lsk0522/microduck/cad/plates/DESIGN_BRIEF.md

# 판재(알루미늄) 부품 설계 브리프 — 트랙 A (다이나믹셀, 원본 크기)

> 설계 대화가 Fusion에서 판재 4종을 **제작 가능한 파라메트릭 부품**으로 다시 만들기 위한 기준.
> 원본 Pollen MJCF(`cad/reference/microduck/robot_allcollisions.xml`)에서 측정 (2026-10-29, 계획 대화).
> 좌표: 몸통 원점(trunk_base), X 앞 / Y 왼쪽 / Z 위, 단위 mm, 모든 관절각 0 자세.

## 0. 한 줄 요약

| 부품 | 수량 | 두께 | 외형 (mm) | 위치·방향 | 큰 구멍 Ø19가 지나는 관절 축 | 작은 구멍 |
|---|---|---|---|---|---|---|
| `upper_leg_rigidity_plate` | 2 | 1.0 | 58.1 × 45.0 | 허벅지 **바깥 옆면**, Y = ±43 (판 법선 Y) | `hip_pitch`, `knee` (축간 **42.0**) | Ø2.2 ×4 |
| `trunk_base` | 1 | 1.0 | 57.0 × 36.0 | 몸통 **바닥판**, Z ≈ −0.7 (판 법선 Z) | 좌·우 `hip_yaw` (축간 **35.0**) | Ø2.3 ×4 |
| `bearing_roll` | 2 | 1.0 | 40.0 × 23.0 | 고관절 **앞면 수직판**, X ≈ 18 (판 법선 X) | `hip_roll` | Ø2.2 ×4 |
| `neck` | 2 | 2.0 | 20.0 × 11.0 | 목 **양 옆판**, Y = ±12.5 (판 법선 Y) | 없음 | Ø2.3 ×4 (16 × 5 격자) |

- Ø19 구멍은 모두 **관절 회전축과 동심**이다 (오차 < 0.1 mm). 서보 혼·베어링 허브가 지나가는 여유 구멍으로 보인다 — XL330 혼 외경과 16×22 베어링 치수로 확인할 것.
- 원본 STL에서 `trunk_base`, `bearing_roll`은 두께 3 mm로 보이지만, 실제 판은 **1 mm + 높이 2 mm 위치결정 보스**다. 판재로는 보스를 만들 수 없으니 생략하거나 압입 핀·출력 부품 쪽 돌기로 옮긴다.
- 기존 추출 DXF: `cad/plates/dynamixel/*.dxf` (원본 메시 단면, ±0.2 mm 오차 가능). **그대로 주문하지 말고 이 브리프 기준으로 다시 그린다.**

## 1. 부품별 상세 (구멍 중심 좌표, 몸통 원점 기준)

### 1.1 `upper_leg_rigidity_plate` (허벅지 보강판) — 왼쪽 기준, 오른쪽은 Y 부호만 반대

| 구멍 | X | Z | 메모 |
|---|---|---|---|
| Ø19 | 4.0 | −17.5 | `left_hip_pitch` 축 |
| Ø19 | −31.8 | −39.5 | `left_knee` 축 → 두 축 거리 √(35.8² + 22.0²) = **42.0** = `L_thigh` |
| Ø2.2 | −39.8 | −17.0 | |
| Ø2.2 | −23.8 | −17.0 | |
| Ø2.2 | −18.5 | −25.5 | |
| Ø2.2 | −18.5 | −9.5 | |

- 판 평면 Y = +42.6 (왼쪽) / −43.4 (오른쪽). 좌우 같은 외형 → **같은 DXF 2장** (뒤집어 장착).
- 경량화 홈 3개(비원형) 있음. 최소 웹 1.99 mm (두께의 2배) — 유지 또는 키우기.

### 1.2 `trunk_base` (몸통 바닥판)

| 구멍 | X | Y | 메모 |
|---|---|---|---|
| Ø19 | 6.0 | +17.5 | `left_hip_yaw` 축 |
| Ø19 | 6.0 | −17.5 | `right_hip_yaw` 축 → 축간 35.0 = `hip_width` |
| Ø2.3 | −16.5 | ±9.5 | |
| Ø2.3 | −16.5 | ±25.5 | |
| 장공 | — | — | 가운데 세로 장공 1 (배선 통과로 추정) |

### 1.3 `bearing_roll` (고관절 롤 베어링판) — 왼쪽 기준

| 구멍 | Y | Z | 메모 |
|---|---|---|---|
| Ø19 | 17.5 | −17.5 | `left_hip_roll` 축 |
| Ø2.2 | 9.5 | −40.0 | |
| Ø2.2 | 25.5 | −40.0 | |
| Ø2.2 | 8.5 | −5.0 | |
| Ø2.2 | 26.5 | −5.0 | |

- 판 평면 X ≈ 18.2 (몸통 앞쪽). 오른쪽은 Y 부호 반대 → 구멍 배치가 좌우 비대칭이라 **좌우 미러 부품일 수 있음**. 같은 DXF를 뒤집어 맞는지 확인하고, 안 맞으면 L/R 두 종류로 만든다.
- 몸통 쪽 XL330(`trunk_base` 바디의 hip_yaw 서보)에 닿아 있다.

### 1.4 `neck` (목 옆판)

| 구멍 | X | Z |
|---|---|---|
| Ø2.3 | 18.0 | 54.9 |
| Ø2.3 | 34.0 | 54.9 |
| Ø2.3 | 18.0 | 59.9 |
| Ø2.3 | 34.0 | 59.9 |

- 판 평면 Y = ±12.5, 2 mm. `neck_pitch` 축(Z 32.4)과 `head_pitch` 축(Z 82.4) 사이(거리 50.0 = `L_neck`)에 있는 연결판.
- 최소 테두리 0.84 mm < 두께 2 mm → **가공 불량 위험. 외형을 키우거나 구멍을 안쪽으로.**

## 2. 제작 조건 (레이저·워터젯 판금)

| 항목 | 기준 |
|---|---|
| 재질 | 알루미늄 5052-H32 (가공·내식 무난) 또는 6061-T6 (강성 ↑). 1.0 mm ×5장, 2.0 mm ×2장 |
| 구멍 지름 | ≥ 두께 (1 mm 판 Ø1.0 이상, 2 mm 판 Ø2.0 이상) |
| 구멍~테두리 | **≥ 1.0 × 두께, 권장 1.5 × 두께** — 현재 neck 0.84, bearing_roll 0.89 mm로 부족 |
| 구멍~구멍 웹 | ≥ 1.0 × 두께 (현재 최소 1.99 mm, 문제 없음) |
| 안쪽 모서리 | R ≥ 0.5 mm |
| 공차 | 레이저 ±0.1 mm. M2 여유구멍 Ø2.2–2.4, 베어링·혼 통과 구멍은 상대 부품 + 0.3–0.5 mm 여유 |
| DXF | 단위 mm, 외곽 닫힌 폴리라인, 구멍은 CIRCLE, 레이어 OUTLINE / HOLES, 치수·문자 없음 |
| 대체 | 1 mm 3종은 FR4 1.0 mm PCB 외곽 가공으로 대체 가능 (저렴한 버전) |

현재 추출본 측정치 (원본 그대로일 때):

| 부품 | 최소 테두리 | 최소 웹 | 순면적 | 알루미늄 질량(1 mm 기준) |
|---|---|---|---|---|
| bearing_roll | 0.89 | 4.80 | 616 mm² | 1.6 g |
| neck | 0.84 | 2.70 | 200 mm² | 0.5 g (2 mm면 1.1 g) |
| trunk_base | 1.35 | 5.12 | 1396 mm² | 3.7 g |
| upper_leg_rigidity_plate | 1.48 | 1.99 | 747 mm² | 2.0 g |

## 3. 반드시 확인할 것 (원본 메시로는 알 수 없는 것)

1. **M2 구멍이 무엇에 체결되는지**: XL330 프레임 탭 구멍인지, 출력 부품의 인서트인지. ROBOTIS XL330 공식 도면·STEP의 구멍 패턴과 겹쳐 본다.
2. **Ø19 구멍을 지나는 것**: XL330 혼 외경, 16×22×4 베어링 위치. 여유가 부족하면 지름을 키운다.
3. **좌우 판이 같은 부품인지 미러인지** (bearing_roll).
4. 판과 맞닿는 출력 부품(`upper_leg_left/right`, `yaw2roll`, `hip_l`, `neck_pitch`)의 체결 위치가 판 구멍과 맞는지.

## 4. 산출물 (설계 대화)

```
cad/redesign/plates/
├── <part>.f3d 또는 Fusion 클라우드 링크 메모   ← 원본 설계
├── <part>.step                                ← 3D
├── <part>.dxf                                 ← 주문용 (Flat Pattern)
├── <part>.pdf                                 ← 치수 도면 (구멍 위치·지름·두께·재질·수량)
└── PLATES.md                                  ← 변경점, 재질·두께, 질량, 견적 메모
```
- 부품 이름은 위 4개 그대로 (MJCF 바디·메시 이름과 연결됨).
- 원본과 다른 점(테두리 확대, 보스 삭제 등)은 PLATES.md와 docs/build-log.md에 기록.
