lsk0522/microduck/cad/redesign/dynamixel/v1.0/PROGRESS.md

# 다이나믹셀 v1.0 진행 상황 (설계 대화)

갱신 2026-10-31. **방침 (사용자): 지금부터 다이나믹셀판만 작업. 원작과 똑같이 만들고, 추가·변경은 먼저 제안 → 승인 후 구현.**
일반 서보·MG996R판은 v1.0 그대로 둔다.

## 완료
- 어셈블리 `1_microduck_dynamixel_v1.0`, 판재 4종(파라메트릭 판금, 가공용 외곽·핀 생략만 원작과 다름), 출력 부품 26종(단면 추적 솔리드), 구매품, BOM, MJCF, 검증
- 2026-10-31: 오른쪽 leg·yaw2roll·hip_l 배치 오류 수정, 무릎 여유 홈 제거 (CHANGELOG)

## 진행 중: 출력 부품 26종을 피처 솔리드로 다시 모델링 (사용자 선택)
- 이유: 지금 솔리드는 0.1 mm 단면을 쌓은 것이라 면이 수천~2만 개 (줄무늬, 수정 불가)
- 방법: 원작 STL을 참고로 스케치·돌출·필렛·챔퍼·로프트로 새로 그림. 목표 원작 대비 ±0.2 mm, 부품마다 스크린샷 → 사용자 확인 → 다음
- 도구: `tools/feat/look.py` (원작 보기·단면 그림), `prof.py` (단면 → 선·호 맞춤, ring_segments2), `slabs.py` (평면 높이로 단 나눠 돌출), `check_csg.py` (원작 비교)
- 방법 (neck_pitch에서 확정): 원작 STL 단면 분석 → `cad/redesign/tools/feat/<부품>_csg.py`로 같은 형상을 먼저 만들어 원작과 비교(표면 거리 p95 ≤ 0.1 mm 목표) → `cad/fusion/scripts/feat_<부품>.py` (feat_lib.py)로 부품 문서를 피처로 다시 그림 → STL 다시 비교 → 저장, 어셈블리 참조 갱신(updateAllReferences), STEP·STL 내보내기
- 이미 깔끔해서 안 해도 되는 것: banana_pcb_locker, yaw_roll_motion, noenoeil
- 묶음 순서:
  1. 머리·목 브래킷: ~~neck_pitch~~ (완료 2026-10-31, 42면, p95 0.046 mm), ~~motor_support~~ (완료 2026-11-02, 106면, 원작 대비 p95 0.005 / 최대 0.01 mm, 부피 +0.02 %), ~~m12_lens_holder~~ (완료 2026-11-02, 45면, p95 0.006 / 최대 0.02 mm)
     - 방법 = **피처 사양(spec)**: `cad/fusion/scripts/specs/<부품>.py` 에 스케치 영역·돌출(구배)·회전·결합을 적고,
       VM 에서 `tools/feat/csg_vm.py <부품>` (manifold3d) 로 원작 STL 과 비교 → 맞으면 Fusion 에서 `feat_dsl.py` 가 같은 사양으로 피처 생성.
       치수는 원작 STL 을 Fusion 프리즘 변환해 얻은 면 목록(`faces_report.py` → `build/feat/<부품>_faces.json`, 측정용으로만 씀)에서 읽음
     - motor_support 구조: 플랜지(z 0.4–2.1, Ø2.7×4) / 다리·후드·-y 판 / 컵 바깥벽(윗면 z 19.2 기준 2° 구배, R9.7) / 축 터널 보스(R10.1)·링 /
       모터 포켓(48×30, 2° 구배 뒤 R8·R3 모깎기) / 오른쪽 블록 속·옆 개구부(구배) / y 아치 R11.1·R9.5·R12.7 / 터널 구멍 R8.4·R7.5 홈
     - 구배면은 2° 테이퍼 돌출, 구배 없는 면이 섞인 곳은 테이퍼 몸체 ∩ 직각 상자 (결합 교집합) 로 만듦
  2. 다리: ~~yaw2roll~~ (완료 2026-11-02, 68면, p95 0.005 / 최대 0.32 mm — 귀 앞면 곡면만 평면 근사), ~~hip_l~~ (79면, p95 0.008 mm), ~~upper_leg_left/right~~ (121면, p95 0.010 mm, 오른쪽 = 왼쪽 x 거울), ~~leg~~ (128면, p95 0.027 mm), ~~ankle_left/right~~ (75면, p95 0.012 / 최대 0.05 mm, 오른쪽 거울) — 다리 묶음 끝, 어셈블리 v12 참조 갱신
  3. 발: ~~foot_left/right~~ (완료 2026-11-02, 197면, 부피 −0.35 % · p95 0.13~0.18 mm, 최대 1.7 mm — 바닥 가장자리 곡면만 근사(R5 모깎기, sole 안쪽과 같음); 테두리·반원통 자리·갈비뼈 슬롯(0.5° 구배)·클립·나사 구멍은 피처, 오른쪽 거울) — 발 묶음 끝, 어셈블리 v13, ~~sole_left/right~~ (완료 2026-11-02, 고무, 43면, 부피 −0.02 % · p95 0.53 / 최대 1.47 mm — 바닥 기울기 평면 + 기울어진 옆벽 + 모깎기, 모서리 꼭짓점 블렌드만 다름, 오른쪽 거울)
  4. 몸통: ~~power_support~~ (완료 2026-11-02, 337면, p95 0.002 / 최대 0.2 mm, 구배 1°·클립 z 거울), ~~left_shell, right_shell~~ (완료 2026-11-02: 면 수천 개 단면 → 매끈한 피처, 원작 대비 p50 0.013 mm·p95 0.34/0.37 mm, 부피 −0.04 / +0.8 %)
     - 방법 (커버형 셸 공통으로 쓸 것): ① 바깥 = x 단면 로프트 1개(옆 커버 쪽은 단면 대신 기울어진 평면으로 자르고 R8.2 모깎기, 아래 모서리는 R6.2 원호 자르기)
       ② 안쪽 = 안쪽 단면 로프트 + 기울어진 평면, 자르개 둘레 R6 미리 모깎기 후 빼기 (Fusion '쉘'은 이 곡면에서 실패)
       ③ 보스·구멍은 피처 (뒤 위 나사 보스 z 방향 R4 + 카운터보어 R2.5 기울기, 고리 구멍 x 방향 기울어진 원뿔)
       ④ 팔·다리 끝 = '패치': 상자 안을 원작 단면 로프트로 교체 (env3.patch_spec2, 꼭짓점을 기준 단면에서 찾아 모든 단면 같은 수로 나눔)
       ⑤ 남은 판·클립·바닥판 = 잔여 돌출(residual.py: 이웃 단 같은 모양은 하나로 합침, 혼자 있는 얇고 긴 띠는 버림 → 층 안 생김)
     - right_shell = left_shell 거울 복사 + 고리 구멍만 오른쪽 치수(r0.8 → 기울어진 r1.5–2.2, 끝 카운터보어 r2.3) + 끝 탭 잔여
     - 스크립트: `cad/fusion/scripts/feat_left_shell.py`, `feat_right_shell.py`, `feat_env.py`; 사양 `tools/feat/ls_spec2.py` → `build/feat/left_shell_env2.json`
     - 남은 작은 차이(0.5 mm 안팎): 옆-앞-위 세 모서리 만나는 곳, 고리와 옆 커버 이음, 뒤 다리 끝 갈고리 x 22–28
  5. 머리: ~~face_part~~ (완료 2026-11-02, 97면, 부피 −0.04 % · p95 0.004 / 최대 0.31 mm — 판 윤곽 스플라인, 기둥 8·브래킷·구멍(입구 경사·드릴 끝 회전 자르기)), ~~jaw~~ (완료 2026-11-02, 48면, 부피 +0.36 % · p95 0.065 / 최대 1.0 mm — 팔 뒤 끝과 쟁반 바닥 이음 둥글림만 생략), ~~jaw_soft~~ (완료 2026-11-02, 고무, 35면, 부피 +0.10 % · p95 0.05 / 최대 0.09 mm), ~~soft_mouth_top~~ (완료 2026-11-02, 고무, 36면, p95 0.011 / 최대 0.06 mm), ~~bottom_head_shell~~ (완료 2026-11-03, 731면, 부피 −0.00 % · p95 0.028 / 최대 0.37 mm, 구멍 단면 54/54), ~~top_head_shell~~ (완료 2026-11-01: 21248면 → 104면, 원작 대비 p50 0.01 / p95 0.12 mm, 부피 −0.3 %)
     - 셸 방법: `tools/feat/shell_sections.py` 로 y 단면마다 바깥·안쪽 곡선(법선 방향으로 가름) → `feat_shell_loft.py run_loft_region` 으로 영역 로프트 (바깥 − 안쪽).
       한 번에 로프트하면 자체 교차 → 뒤/가운데/앞으로 나눔. 결과 주 곡면 원작 대비 중앙값 0.016 mm, 층 없음
     - 스크립트 `cad/fusion/scripts/feat_top_head_shell.py` (build + details). 남은 작은 차이: 보스–벽 이음 받침, 앞 가운데 받침, 바닥 턱(z 0–1.6) — p95 0.12 mm 안
     - 다음 커버: bottom_head_shell 분석 (2026-11-01): 바닥이 평면이 아니라 곡면(z −12.6 ~ −10.2) → 위가 열린 셸.
       ① y 단면 로프트(바깥 = 바닥 곡면 + 옆벽, 위로 닫음 / 안쪽 = 바닥 윗면 + 안벽) — shell_sections.py 에 '위가 열림' 옵션(v 뒤집기) 추가 필요
       ② 뒤쪽 y < −24 는 얇은 평판(z −1.5~0) → 돌출
       ③ 안쪽 세로 벽·보스(높이 −1, 0, 1.5, 3, 4.5, 7.5) → z 단면(원작 − 셸) 영역을 바닥에서 각 높이까지 돌출
     - 입 고무 2종 방법: 입 전체가 x 축으로 0.5054° 기울어짐 (윗면·바닥면 dz/dy 0.00882). 기울어진 평면은 x 돌출 단면으로,
       바닥 볼록 곡선은 국소 좌표에서 y 로 민 뒤 사양 op 'rot' 로 돌림. 뒤 홈은 수직 스플라인 (사양 Pth 'S' 구간 = Fusion 맞춤 스플라인).
       원작을 국소 좌표로 돌려 재기: `tools/feat/local_frame.py <부품> x -40,-6 0.5054`
     - jaw 방법: jaw_soft 아래 몸통 사양을 바깥으로 0.1 / 1.8 옮긴 두 몸체(옆 구배 3°, 바닥 R3.1 / R4.8)의 차 ∩ 옆모습 윤곽(x 돌출)
       − 홈 곡선을 뒤로 이은 스플라인 + 경첩 받침. 왼쪽·오른쪽 경첩이 다름 (오른쪽 구멍 5개, 왼쪽 축 R5 + 구멍 R1)
     - 머리 부품 모두 완료 (어셈블리 v19)
- 재질 (사용자 2026-11-01): 알루미늄은 가공품(판재 4종)만. 출력 부품 = ABS(흰색), 연질 = 고무. 새로 그린 부품은 feat_lib.set_plastic() 으로 맞춤. 렌즈도 알루미늄에서 뺌
  6. 마무리 (2026-11-02): ~~참고 메시 삭제~~ (69개 삭제, 11-03 마지막 ref_bottom_head_shell 삭제 → 메시 0), ~~원작 비교 검증~~ (`verify/feature_verify.md`, 구멍 위치·지름 포함), 어셈블리 v17 (26개 참조 모두 최신)
     - bottom_head_shell (2026-11-03 완료, 4차 = 직접 사양): `specs/bottom_head_shell.py` + 단면 자료 `tools/build/feat/bottom_head_shell_sec.json`
       (만드는 도구 `tools/feat/bhs/`, `python make_sec.py`). 1~3차(잔여 차이 자동 돌출)는 층·얇은 막 때문에 실패 → 형상별 직접 사양
       - 바깥 컵 = z 단면 로프트(앞 직선+모서리 호+스플라인, 3단면씩 나눠 로프트 후 합침) ∩ 앞벽 x 돌출 곡선 ∩ 바닥 볼록 곡면(jaw 와 같은 CR, x 축 0.5054°)
       - 안쪽 = 바깥 윤곽에서 안쪽 법선으로 재료를 지나 찾은 안쪽 면 단면 로프트 (수평 1.7 오프셋은 경사 벽에서 틀림), 바닥 바로 위 −10.2 는 4.5 까지 찾음
       - 턱 팔 지나가는 옆 턱(x > 27) = y 단면 로프트 상자, 앞 평판 = 기울어진 띠, 테두리 턱 3구간, 경첩 자리 R9.48, 클립
       - 안쪽 벽·보스·틀은 안쪽 몸체(cav)에서 빼고 마지막에 main −= cav (맞닿는 스플라인 면끼리 합치면 Fusion 결합 실패) → z 0 위 부분만 따로 붙임
       - 짓는 시간 약 21분 (부품 문서), 어셈블리 v19 에 반영, 참고 메시 삭제
       - 남은 작은 차이 (≤ 0.4 mm): 앞 평판 옆 끝 윗면(x ±44, z 0), 오른쪽 클립 옆 턱 모서리(39.5, 3.5, −1.3), 뒤 가운데 연결 갈비(0, 53.7, −8)
- ~~다 끝나면 참고 메시(ref_*, 숨김 70개) 삭제 → 어셈블리에 메시 0~~ (11-03 완료)

## 겉면 재모델링 (2026-11-03, 사용자 요청)
- 대상: left_shell, right_shell, bottom_head_shell, yaw_roll_motion (그다음 power_support, banana_pcb_locker)
- 방법: 외곽 단면 스플라인 → 로프트 1회 → 셸 → 평면 자르기·피처. 구멍·보스·홈 위치는 그대로. 기준: 겉면 원작 대비 0.3 mm, verify_all 구멍 단면 전부 일치, 면 수 크게 감소
- 한 부품씩: 만들기 → verify_all → 스크린샷 → 저장 → 커밋 (어셈블리 참조 갱신은 끝에 한 번)
- ~~left_shell~~ (11-03, 부품 v6): 1417면 → 118면, 부피 +0.08 %, p50 0.005 / p95 0.093 / 최대 0.93 mm, 구멍 44/44
  - 바깥 = 옆면과 평행한 기울어진 평면 위 닫힌 스플라인 7개 로프트 1번 (`specs/left_shell.py`, 단면 `build/feat/left_shell_env4.json` ← `tools/feat/ls/secgen.py`, `inner1.py`)
    → 셸 2.2 → 원작의 2° 기울어진 평면으로 자르기(위 날개·앞 턱·뒤 말림·바닥 열림 R1/R2 계단) → 고리 관(구배 2°)·보스(R4+띠)·U 클립·윗면 얕은 홈
    → 팔 판(구배 3°, 원판 R8.5 + 위 스플라인 + 앞 R5.14 오목) + 혼 원판·무늬 홈 → x<0 혀(안쪽 1.05 만 남김) → 구멍
  - 단면을 6개로 줄이면(u 18 뺌) Fusion 로프트가 가운데서 0.7 mm 부풀어 7개 유지
  - 최대 0.93 은 보스·고리 구멍이 둥근 바깥면을 비스듬히 뚫고 나가는 테두리 (원작 메시가 들쭉날쭉) — 나머지 겉면 0.3 mm 안
  - VM 확인: `tools/feat/ls/vm3.py <사양> <셸 STL>` (loft3 = 기울어진 평면 단면 로프트)
- ~~right_shell~~ (11-03, 부품 v5): 1504면 → 122면, 부피 +0.31 %, p50 0.005 / p95 0.093 / 최대 0.91 mm, 구멍 44/44. 피처 이력 끝의 기본 피처(clean_copy) 없앰 — 피처만
  - `specs/right_shell.py` = left_shell 사양을 x 거울 (op 마다 좌표 뒤집기) + 오른쪽만 다른 것: 고리 관 구배 1.5°(왼쪽 2°), 고리 구멍 r0.8 → 원뿔 r1.5(0.0261/mm),
    끝 x −2.1 ~ 0 은 바깥 1.0 껍질만 (왼쪽 혀 안쪽 1.05 와 0.15 틈), 관·관 모서리는 x −0.3 에서 끝
- ~~bottom_head_shell~~ (11-03, 부품 v6): 731면 → 622면, 부피 −0.11 %, p50 0.001 / p95 0.026 / 최대 0.62 mm, 구멍 54/54
  - 컵(뒤쪽 둥근 통): z 단면 로프트 18+15개(3개씩 나눠 이음 → 층 무늬) 대신 위 단면 1개를 3° 구배 프리즘 ∩ 앞벽 곡선 ∩ 바닥 곡면 → 바닥 둘레 R5 모깎기 (안쪽은 3° 프리즘 → R3.3)
  - 프리즘 앞면은 1 mm 내밀고 앞벽 곡선(x 돌출)으로 자름 — 구배가 앞면을 0.22 끌어들이던 것 고침
  - 최대 0.62 는 원작 메시의 두께 0 조각(x −39.5 안쪽 벽 아래 0.05 폭 쐐기) — 출력 안 되는 형상. 나머지 0.4 mm 안
  - ~~남은 것: 옆 턱 홈 y 단면 로프트~~ → 11-09 아래에서 피처로 바꿈
- ~~yaw_roll_motion~~ (11-08, 부품 v3): 272면 → 67면, 부피 +0.03 %, p95 0.005 / 최대 0.01 mm, 구멍 39/39
  - 22층 돌출 대신 판·띠·팔(y 돌출)·통 R9/R8·혼 원판 + 모따기 + 구멍 (`specs/yaw_roll_motion.py`)
  - 팔 아래 호는 통 R9 와 같은 원 — 접점을 계산해서 넣음 (반올림 좌표로 그렸을 때 y −13 에 두께 0 조각면이 생겨 STL 에 4.2 mm 가짜 면)
- ~~banana_pcb_locker~~ (11-08, 부품 v2): 98면 → 28면, 부피 −0.00 %, p95 0.001 / 최대 0.01 mm, 구멍 2/2 — 판 윤곽 1° 구배 + 걸쇠 2 + 구멍 2 (`specs/banana_pcb_locker.py`)
- power_support: 그대로 둠 — 이미 선·호 윤곽 피처 모델(337면은 갈비·레일·클립 수), p95 0.002 / 최대 0.07 mm, 메시 따라 그린 면 없음
- ~~top_head_shell 나사 기둥~~ (11-09, 부품 v3, 사용자 지적): 기둥 3개(앞 양 모서리·뒤 가운데) 끝이 둥근 가장자리 바깥면 밖으로 최대 3.3 mm 나와 있던 것
  → 기둥을 바깥 로프트 덩어리와 교집합한 뒤 붙임 (`feat_top_head_shell.py` bosses). p95 0.108 / 최대 2.07 mm (남은 최대는 아래 테두리 턱), 구멍 33/33
  - 예전 검증 메모의 '최대 3.29 = 세 면 만나는 모서리 이음'은 잘못 짚은 것 — 실제로는 이 기둥 끝
- ~~bottom_head_shell 옆 턱(jaw 팔 받침) 홈~~ (11-09, 부품 v8, 사용자 지적 '주황 커버 면이 나뉘어 보임'): y 단면 26개 로프트(3개씩 이음 → 줄무늬) 대신 피처
  - 홈 = 계단 곡선 S(원작 바닥 높이 지도의 −11.2 등고선) 바깥에서 컵 바닥이 2.1 mm 올라가고 모서리 R5 → R2.9. 바닥은 y > 0 에서 R18 로 벽 쪽으로 감아 오름(x 로 2.29° 기울기)
  - 몸체: (S 바깥 ∩ 상자) − c2(컵 프리즘 ∩ 앞벽 ∩ 홈 바닥 → R2.9) 를 빼고 계단 위 R1. 안쪽 공간: (S_i 바깥 ∩ 상자) − c2i(→ R1.25) 를 빼고 계단 위 R2.8
  - 622면 → 481면, p95 0.032 / 최대 0.61 mm(원작 두께 0 조각), 구멍 54/54. 홈 상자 안 p95 0.25. 설치 시간 15분 → 3분 (로프트 없어짐)
  - 남은 차이: 홈 뒤 끝(y 11~13)은 원작이 비스듬히 끝나 0.6~1.0 mm (안쪽 면). 안쪽 계단을 벽으로 돌리면 R2.8 모깎기가 계산 안 돼 상자를 y 12.9 에서 끊음
  - 도구: `tools/feat/bhs/groove_hmap.py`(바닥 높이 지도) → `groove_steps.py` → `groove_curves.py`, 시험 사양 `specs/bhs_grv_test.py`

## 구동 테스트 (2026-11-09, 사용자 요청) — `verify/drive_test_2026-11-09.md`
- 관절 14/14, 움직일 때 충돌·토크·서기 시뮬 모두 원본과 같음 (새 접촉 0건)
- 조립 맞물림에서 찾아 고침: top_head_shell 부리 서보 자리(0.64 mm), 아래 셸 립 자리(0.92 mm) → 부품 v11 / MJCF neck 판 메시 25 mm 밀림 (시뮬만)
- 같이 찾은 것: Fusion MCP 전역에 다른 대화가 남긴 `run`(dyn_50 관절 검사)이 남아 스크립트마다 실행돼 verify/joints.json 을 덮어씀 → 빈 run 으로 바꾸고 joints.json 다시 만듦

## 주의 (2026-11-02 발견)
- (2026-11-03) 원작 비교만으로는 '화면에 안 그려지는 몸체'를 못 잡음 → 설치 뒤 어셈블리에서 몸체마다 meshManager.displayMeshes.count > 0 확인. right_shell 이 0 이라 가슴이 비어 보였음 → 깨끗한 복사본으로 교체 (v3)
- 어셈블리가 연 부품 문서(참조로 열린 것)는 읽기 전용 → API save()가 True를 돌려줘도 클라우드에 안 올라감.
  10-31~11-01의 neck_pitch·top_head_shell 재모델링도 그래서 저장 안 돼 있었음 → 11-02 어셈블리를 닫고 부품 문서를 따로 열어 다시 만들고 저장 (neck_pitch v3, top_head_shell v2, left_shell v3, right_shell v2, 어셈블리 v11)
- 순서: 어셈블리 닫기 → `run_install.py` (PART) → `run_asm_update.py` (참조 최신화 + 저장). MCP 실행 사이에 전역 변수가 남으므로 스크립트 시작에서 초기화

## 사용자 확인 대기
- 위치결정 핀 생략 (판재) — 가공용으로 유지하기로 함
- 추가 제안 목록 (원작에 없는 것, 승인 전 구현 안 함): 무릎 접힘 여유 홈, yaw_roll_motion Ø4 공구 구멍, 원점 표시선, 버스 허브·IMU 자리
