lsk0522/microduck/cad/redesign/mg996r/v1.0/PROGRESS.md

# MG996R v1.0 진행 상황 (설계 대화)

갱신 2026-10-31. **v1.0 완료** — `README.md`, `CHANGELOG.md`.

## 사용자 확인 대기
- 무릎 STAND 유지 토크 정지 토크의 26 % (6 V) — 연속 권장 20 % 초과. 7.2 V 공급 또는 v1.1에서 경량화·자세 조정
- 머리 셸 고정 나사 3곳 (일반 서보판 4곳) — 부족하면 v1.1에서 셸에 보스 추가
- 몸통 셸 고정 방법 없음, 서보 치수 대표값 (일반 서보판과 같음)
