lsk0522/microduck/cad/redesign/hobby_servo/v1.0/PROGRESS.md

# 일반 서보 v1.0 진행 상황 (설계 대화)

갱신 2026-10-31. **v1.0 완료** — 결과·검증은 `README.md`, 바뀐 점은 `CHANGELOG.md`.

## 완료
- Fusion `개인/microduck_hobby_servo_v1.0/1_microduck_hobby_servo_v1.0` 저장 (몸체 15, 관절 14, 출력 18 + 셸 9 + 구매품 42 + 전장 10)
- 바탕화면 `마이크로덕_설계/2_일반서보_MG996R+MG90S_v1.0.f3d`
- 배치 간섭 0, 실제 메시 간섭 새 간섭 0 (33자세), 관절 14/14, 구매품 위치 42/42, check_model STAND 유지
- BOM, MJCF, 어셈블리 STEP(.zip)
- 관절 버그 수정: 점 기하 + 사용자 축(선)은 선을 무시하고 Z축으로 돌았음 → 선 기하 + Z축 (`hobby_10_build.py joints()`)

## 사용자 확인 대기
- 무릎 STAND 유지 토크 정지 토크의 24 % (6 V) / 21 % (7.2 V) — 연속 권장 20 % 약간 초과
- 몸통 셸 고정 방법 없음 (임시: 양면테이프/케이블타이)
- MG996R·MG90S 치수는 대표값 → 캘리퍼 실측 필요

## v1.1 후보
- 몸통 셸 나사 보스, 무릎 토크 여유(경량화·자세), 서보 실측 치수 반영
- Fusion 관절을 지우면 셸 이력 재계산으로 1시간 넘게 걸림 → 다시 만들 땐 새 문서에 처음부터
