lsk0522/microduck/plan-hobby-servo.md

# 일반 서보 버전 계획 (MG996R + MG90S)

> 다이나믹셀 버전([`plan.md`](plan.md))과 같은 오리 형태·관절 구성을, 일반 PWM 서보로 싸게 만드는 트랙.
> 전체 개요와 현재 상태는 [`README.md`](README.md). 작성일 2026-10-29.
> 예상 비용 약 **₩26만(예비 제외)–₩28만(예비 포함)** (다이나믹셀 저렴한 버전 약 ₩56만, 오리지널 약 ₩90만).

---

## 0. 결론 먼저

| | 다이나믹셀 버전 | 일반 서보 버전 |
|---|---|---|
| 서보 | XL330 ×14–15 | MG996R ×11 + MG90S ×4 |
| 크기·무게 | 25 cm, 약 0.74 kg | **약 37 cm (1.5배), 1.4–1.7 kg (추정)** |
| 위치 피드백 | 서보가 직접 보고 | **없음 → 서보 내부 가변저항 배선 개조 + ADC** |
| 제어기 | Radxa Zero 3W + UART 버스 | **Raspberry Pi Zero 2W + PCA9685 + ADS1115** |
| 원본 CAD | 그대로 참고 | 처음부터 다시 설계 (형상만 참고) |
| 원본 정책·런타임 | 사용 가능 | **사용 불가 → 새 액추에이터 모델로 재학습, 런타임 새로 작성** |
| 난이도 | 중 | **상** (sim2real이 훨씬 어려움) |
| 비용 | ₩56–90만 | 약 ₩26–28만 |

**핵심:** 서보값은 1/7로 줄지만, 다이나믹셀이 공짜로 주던 것(위치·속도·전압·온도 피드백, 정밀한
액추에이터 모델, Pollen이 검증한 정책)을 전부 직접 만들어야 한다. "싼 대신 학습·조정에 시간을 쓰는" 버전이다.

---

## 1. 왜 MG90S만으로는 안 되고, 왜 로봇이 커지나

`sim/check_model.py`로 원본 모델(0.737 kg)의 **정적** 자세 유지 토크를 서보별 정지토크와 비교:

| 서보 (전압) | 정지토크 | STAND 무릎 | SIT 고관절 롤 | 판정 |
|---|---|---|---|---|
| XL330-M288 (7.4 V) | 0.77 N·m | 7.9 % | 8 % | 여유 큼 (원본) |
| MG90S (6.0 V) | 0.22 N·m | **28 %** | **29 %** | 서 있기만 해도 연속 권장치 초과 |
| SG90 (5.0 V) | 0.18 N·m | **33 %** | — | 불가 |
| MG996R (6.0 V) | 1.08 N·m | — | — | 토크 충분, 단 55 g·40×20×43 mm |

```bash
uv run --with mujoco --with trimesh python sim/check_model.py --servo mg90s --vin 6.0
```

- 걷기·일어서기의 **동적 피크는 정적 값의 수 배**라서 MG90S 다리는 원본 크기에서도 버티지 못한다.
- MG996R은 토크는 충분하지만 XL330보다 3배 무겁고 높이가 1.65배라 원본 다리에 들어가지 않는다.
  → **전체를 약 1.5배로 키우는 설계**가 현실적이다.
- 1.5배 확대 추정: 무게 1.4–1.7 kg, 정적 무릎 토크 약 0.19 N·m → MG996R(6 V) 정지토크의 약 18 %.
  원본(7.9 %)보다 여유가 적지만 걷기는 가능한 수준. **일어서기·구르기는 실패할 수 있다.** (추정치, CAD 후 재확인)

---

## 2. 관절 배치

관절 이름·순서·가동 범위는 원본과 같게 유지한다 (`left_hip_yaw … right_ankle`, 14축 + 부리).
그래야 `microduck_rl`의 태스크·보상·관측 구조(61차원)를 그대로 재사용할 수 있다.

| 관절 | 서보 | 수량 | 이유 |
|---|---|---|---|
| hip_yaw, hip_roll, hip_pitch, knee, ankle (좌우) | MG996R | 10 | 몸무게 전체를 받는 축 |
| neck_pitch | MG996R | 1 | 머리+목 전체의 모멘트 (원본에서 머리가 전체 질량의 1/4) |
| head_pitch, head_yaw, head_roll | MG90S | 3 | 머리 자체만 움직임, 가벼움 |
| mouth (부리) | MG90S (또는 SG90) | 1 | 정책이 쓰지 않음. 생략 가능 |

- SG90은 플라스틱 기어라 넘어질 때 기어가 잘 나간다. RL 로봇은 학습·테스트 중 수백 번 넘어지므로 **금속 기어(MG90S)** 권장.
- 모든 관절에 **반대편 베어링 지지**(서보 축 반대쪽에 623ZZ 베어링 + 볼트 축)를 넣는다. 서보 축 하나로만 하중을 받으면 유격이 금방 커진다.
- MG996R 플라스틱 혼 대신 **25T 알루미늄 혼**을 쓴다.

---

## 3. 전장 구성

```
[2S LiPo 7.4V 2200mAh] ─ 퓨즈 15A ─ 스위치 ─┬─ 6V 10A UBEC ─┬─ MG996R ×11  (+2200µF 커패시터)
                                            │               └─ (5V 강압) ─ MG90S ×4
                                            └─ 5V 3A 강압 ─ Raspberry Pi Zero 2W
Pi ─ I²C ─┬─ PCA9685 (16ch PWM)  → 서보 15개 신호선
          ├─ ADS1115 ×4 (0x48–0x4B, 16ch) ← 서보 가변저항 배선 15개 (분압 저항 경유)
          └─ BNO085 (게임 회전 벡터 쿼터니언 + 자이로)
```

### 3.1 제어기: 라즈베리파이 vs 아두이노

| | Raspberry Pi Zero 2W | Arduino Uno/Nano | ESP32-S3 (PSRAM) |
|---|---|---|---|
| 정책(MLP 61→512→256→128→14, 약 20만 파라미터, float32 약 0.8 MB) | **가능** (onnxruntime, 50 Hz) | **불가** (RAM 2 KB) | 가능하나 직접 포팅 필요 |
| PWM 15채널 | PCA9685로 하드웨어 생성 | 가능 | 가능 |
| 로깅·Wi-Fi·개발 편의 | 리눅스, 파이썬 | 없음 | 제한적 |

→ **라즈베리파이 단독**(Pi + PCA9685 + ADS1115)이 가장 단순하다. 아두이노는 필요 없다.
PCA9685가 PWM을 하드웨어로 만들기 때문에 리눅스 지터 문제도 없다.
같은 구조의 선례: Open Duck Mini v2가 Pi Zero 2W에서 파이썬으로 정책을 돌린다
([Open_Duck_Mini_Runtime](https://github.com/apirrone/Open_Duck_Mini_Runtime)).

Pi Zero 2W가 품절이면 Pi 4 (1–2GB)를 쓴다. 1.5배 확대된 몸통에는 Pi 4도 들어간다.

### 3.2 위치 피드백 개조 (가장 중요)

RL 정책은 관절 각도·속도를 관측한다. 일반 서보는 이 값을 알려주지 않는다.

**방법 A — 가변저항 배선 개조 (권장):** 서보를 열어 내부 가변저항 와이퍼(가운데 단자)에 전선을 납땜해 밖으로 뺀다.
- ADS1115(16비트)로 읽는다. 4채널 × 4개 = 16채널, I²C 주소 0x48–0x4B.
- 와이퍼 전압은 서보 전원(최대 6 V)까지 올라갈 수 있으므로 **분압 저항(예: 10 kΩ/10 kΩ)**으로 ADC 입력 범위 안에 넣는다.
- 서보마다 2점 보정(두 각도에서 전압 측정)으로 전압→각도 변환표를 만든다.
- 속도는 위치 차분 + 저역통과 필터로 추정한다 (노이즈가 크므로 학습 때 관측 노이즈 DR을 넉넉히).

**방법 B — 피드백 없이:** 관측의 관절 위치 자리에 "직전 명령값"을 넣고 학습한다.
배선은 쉽지만 정책이 실제 관절 상태를 모르므로 넘어짐에 훨씬 약하다. 첫 시도로는 권장하지 않는다.

### 3.3 전원 주의

- MG996R 정지 전류 **2.5 A @6 V**. 11개가 동시에 힘을 쓰면 순간 20 A를 넘을 수 있다.
  6 V UBEC는 10 A 이상, 서보 레일에 2200 µF 이상 커패시터.
- Pi는 반드시 **별도 강압**으로 분리 (서보 전류 스파이크로 Pi가 리셋되는 것을 막음).
- MG996R은 4.8–7.2 V, MG90S는 4.8–6 V. 2S LiPo(최대 8.4 V)를 서보에 직결하지 않는다.
  대안: 2S LiFePO4(최대 7.2 V)는 MG996R에 직결 가능 (전용 충전기 필요).

---

## 4. 기구 설계

**결론: 기구는 전부 새로 설계해야 한다.** MG996R·MG90S로 만든 공개 오리(BDX 계열) 설계는 찾지 못했다(2026-10-29 조사).
대신 출발점으로 쓸 수 있는 공개 설계가 있다.

| 후보 | 서보 | 크기 | 공개 자료 | 활용법 |
|---|---|---|---|---|
| **Open Duck Mini v2** | Feetech STS3215 ×14 (45.2×24.7×35 mm, 55 g) | 약 42 cm | 편집 가능한 Onshape CAD, BOM, 출력·조립 가이드, 런타임, RL 학습 코드 | **1순위.** 서보 무게(55 g)가 MG996R과 같고 크기도 비슷해 다리 구조를 거의 그대로 쓸 수 있다. 서보 포켓만 MG996R로 바꾸고 반대편 베어링 지지 추가 |
| rubieluo BDX 클론 | Waveshare ST3215 | 미기재 | SolidWorks→URDF, MuJoCo XML | 다리 5자유도 배치 참고 |
| MG996R 알루미늄 브라켓 휴머노이드 키트 | MG996R | — | 상용 키트 | 다리 뼈대를 빨리 만들 때. 단 다리당 3자유도라 hip_yaw·hip_roll 추가 필요 |
| Pollen Microduck (`cad/reference/`) | XL330 | 25 cm | STL·MJCF | 오리 외형(머리·몸통 셸)을 1.5배로 키워 씌울 때 |

- Open Duck Mini v2: https://github.com/apirrone/Open_Duck_Mini (저장소 Apache-2.0, **CAD 파일 라이선스는 별도 명시가 없어 확인 필요**)
- rubieluo: https://github.com/rubieluo/bipedal_cad
- STS3215는 MG996R보다 토크가 약 1.5배(16.5 vs 11 kgf·cm @6 V)라, 같은 다리를 쓰면 토크 여유가 줄어든다.
  다리 링크를 10–15 % 짧게 하거나 몸통을 가볍게 해서 보정한다.

추천 조합: **Open Duck Mini v2의 다리 기구 + Microduck 외형 셸(1.5배) + MG996R/MG90S 포켓 재설계.**

### 4.1 직접 설계 순서 (Fusion + Claude)

자세한 절차와 판재 후보는 [`cad/FUSION_REDESIGN.md`](cad/FUSION_REDESIGN.md).

1. 1.5배 기준 치수는 이미 뽑아 두었다: [`cad/hobby_servo/reference_1.5x/`](cad/hobby_servo/reference_1.5x/)
   (허벅지·정강이 각 63 mm, 좌우 hip_yaw 축 간 52.5 mm, 발목 축→발바닥 29.2 mm).
2. 서보 포켓은 MG996R(40.7×19.7×42.9 mm)·MG90S(22.8×12.2×28.5 mm) 기준으로 새로 그린다.
   호환품마다 크기가 조금씩 다르므로 **실물을 사서 캘리퍼로 잰 뒤** 설계한다.
3. Open Duck Mini v2 Onshape CAD를 STEP으로 내보내 Fusion에 참고용으로 넣고 다리 구조를 따라간다.
4. HOME 자세에서 무게중심이 발목 축 위에 오게 배터리·Pi 위치를 잡는다.
5. 발바닥은 1.5배 면적의 TPU 패드.
6. 부품·조인트 이름을 원본 MJCF 바디·관절명과 같게 → Fusion 내보내기 스크립트로 MJCF 생성.
7. `sim/check_model.py --servo mg996r --vin 6.0`으로 토크 여유 확인.

라이선스: 원본 STL을 키우거나 수정해서 쓰면 그 메시는 CC BY-NC-SA 4.0. 처음부터 새로 그리면 자유.

---

## 5. 시뮬레이션·학습

### 5.1 다이나믹셀 버전과 다른 점

| 항목 | 다이나믹셀 버전 | 일반 서보 버전 |
|---|---|---|
| 로봇 모델 | Pollen MJCF 그대로 | 새 CAD → 새 MJCF |
| 액추에이터 모델 | BAM M6 XL330 (검증됨) | **직접 만든 일반 서보 모델** + 시스템 식별 |
| 공개 정책 | 사용 가능 | 사용 불가, 처음부터 학습 |
| 백래시 | ±1° | **±2–3°** (호환품은 더 클 수 있음) |
| 지연 | 3–6 tick 랜덤화 | PWM 주기(20 ms) + 서보 응답 → 넓게 |

### 5.2 일반 서보 액추에이터 모델

아날로그 서보는 "내부 P 제어 + 데드밴드 + 속도 한계 + 토크 한계"로 근사할 수 있다. `microduck_rl`을 포크해
`src/<robot>/actuator/hobby_servo.py`에 커스텀 액추에이터로 구현한다:

```
e      = q_cmd(지연 적용) − q_meas(백래시 적용)
e      = 0                       if |e| < 데드밴드     (MG996R 5 µs ≈ 0.5°)
τ_max  = τ_stall · (1 − |q̇| / ω_max)                  (직선 토크-속도 곡선)
τ      = clip(kp·e − kd·q̇, −τ_max, +τ_max)
```
- `τ_stall`: MG996R 1.08 N·m @6 V, MG90S 0.22 N·m @6 V (사양값 — 실측으로 교체)
- `ω_max`: MG996R 0.14 s/60° @6 V ≈ 7.5 rad/s, MG90S 0.08 s/60° @6 V ≈ 13 rad/s (사양값)
- `kp`, `kd`, 데드밴드, 지연은 시스템 식별로 추정
- mjlab에 이미 있는 `DelayedActuatorCfg`(지연)와 `microduck_rl`의 백래시 래퍼(`tasks/backlash.py`)를 조합하면 된다.

### 5.3 시스템 식별 (학습 전에 반드시)

1. 가변저항 개조한 MG996R 1개 + 길이·무게를 아는 팔(예: 10 cm, 100–300 g) 테스트벤치.
2. 계단·사인 명령을 주고 ADS1115로 200 Hz 이상 기록.
3. 위 모델의 파라미터를 최소제곱으로 피팅. **같은 모델이라도 개체마다 다르므로 3–4개 측정**해 편차를 DR 범위로 쓴다.
4. 가능하면 [BAM](https://github.com/Rhoban/bam)의 피팅 도구를 응용 (원래 다이나믹셀용이지만 기록·피팅 구조는 재사용 가능).

### 5.4 학습 순서

1. 새 MJCF + 일반 서보 액추에이터로 `Velocity-Flat` 태스크 복제 (`Mjlab-Velocity-Flat-HobbyDuck`).
2. DR을 다이나믹셀보다 넓게: 서보 토크 ±20 %, 영점 오차 ±3°, 백래시 ±2–3°, 지연 1–4 tick, 관측 노이즈(관절각·속도) 2배.
3. 평지 보행 → Rough → 넘어짐 복구(VelStand) 순서. 일어서기는 토크 여유를 보고 시도.
4. 명령 속도 범위를 원본보다 낮게 시작 (서보가 느림): 전진 0.15 m/s부터.
5. CPU 시뮬레이션(`scripts/infer_policy.py` 변형)으로 키보드 조종 확인 → 매단 상태 실물 → 바닥.

### 5.5 런타임 (새로 작성)

Pollen 런타임(Rust)은 다이나믹셀 버스 전용이라 쓸 수 없다. 파이썬으로 50 Hz 루프를 새로 만든다
(Open Duck Mini Runtime 구조 참고):

```
매 20 ms:
  1. ADS1115 ×4 → 관절각 15개 (보정표), 차분 → 관절 속도
  2. BNO085 → 쿼터니언, 자이로
  3. 관측 61차원 구성 (학습과 같은 순서·스케일), 명령(속도·머리 자세) 삽입
  4. onnxruntime 추론 → 목표 관절각 14개
  5. PCA9685 → 펄스폭 변환표로 출력
안전: 기울기 > 60° 또는 배터리 < 6.6 V면 토크 해제(PWM 0) 후 정지
```

---

## 6. 단계별 계획

| 단계 | 내용 | 완료 기준 | 예상 |
|---|---|---|---|
| B0 | 서보 몇 개 구매, 실측, 가변저항 개조 | ADS1115로 각도 읽힘 | 1주 |
| B1 | 시스템 식별 테스트벤치 | 모델 파라미터 확보, 개체 편차 확인 | 1–2주 |
| B2 | 1.5배 CAD 설계 | MJCF 생성, `check_model.py` 통과 | 3–4주 |
| B3 | 시뮬레이션 학습 | 시뮬레이션에서 평지 보행 | 1–2주 |
| B4 | 출력·조립·배선 | 15채널 PWM·피드백 동작 | 2주 |
| B5 | 파이썬 런타임 | 50 Hz 루프, 안전 정지 | 1–2주 |
| B6 | 실물 보행 | 매단 상태 → 바닥 보행 | 2주+ |

---

## 7. 위험 요소

| 위험 | 대응 |
|---|---|
| 호환 MG996R 품질 편차(지터, 영점 흔들림, 데드밴드) | 여러 개 사서 측정 후 좋은 것만 다리에 사용, 예비 2개 |
| sim2real 실패 (가장 큰 위험) | 시스템 식별을 먼저, DR 넓게, 속도 명령 낮게 시작 |
| 피드백 노이즈 | ADS1115 평균, 분압·RC 필터, 관측 노이즈 DR |
| 서보 과열 | 서 있을 때 무릎을 덜 굽힌 HOME 자세, 휴식 시 PWM 해제 |
| 전류 스파이크로 Pi 리셋 | 전원 분리, 커패시터, UBEC 여유 |
| 무게 증가로 토크 부족 | CAD 후 `check_model.py`로 재확인, 필요 시 다리 링크 짧게 |

### 중간 대안

다이나믹셀보다 싸고 위치 피드백이 있는 **Feetech STS3215** 같은 시리얼 버스 서보도 있다.
LeRobot SO-100 팔과 Open Duck Mini v2가 쓰는 서보로, 피드백 개조 없이 RL 파이프라인(BAM 식별 포함) 선례가 있다.
일반 서보로 sim2real이 막히면 이쪽이 다음 선택지다.
