lsk0522/microduck/cad/fusion/README.md

# Fusion 작업 폴더

- `scripts/` — Claude가 작성한 Fusion API 파이썬 스크립트 (Fusion: Utilities → Scripts and Add-Ins에서 실행)
- `params/` — Fusion 사용자 매개변수 CSV (`fusion_params_1x.csv` 트랙 A, `fusion_params_1.5x.csv` 트랙 B)

작업 방법은 [`../FUSION_REDESIGN.md`](../FUSION_REDESIGN.md).
