lsk0522/microduck/cad/redesign/tools/build/feat/ls_spec2.png

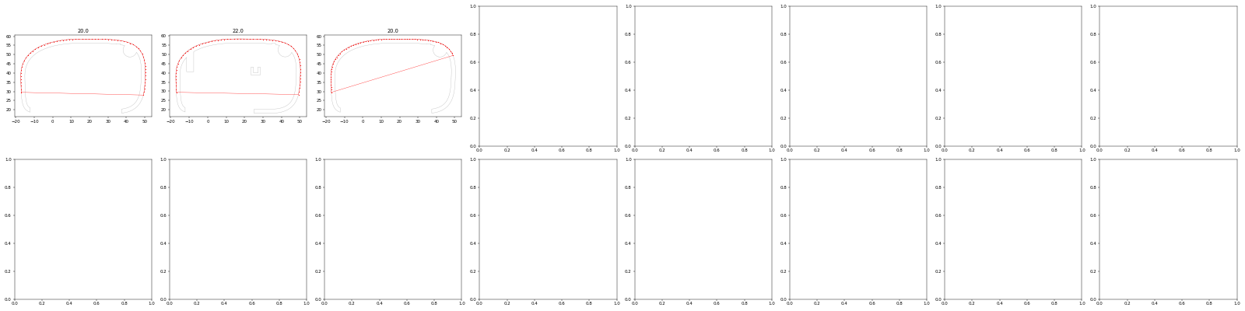
cad/redesign/tools/build/feat/ls_spec2.png
