lsk0522/microduck/docs/images/microduck_front.png

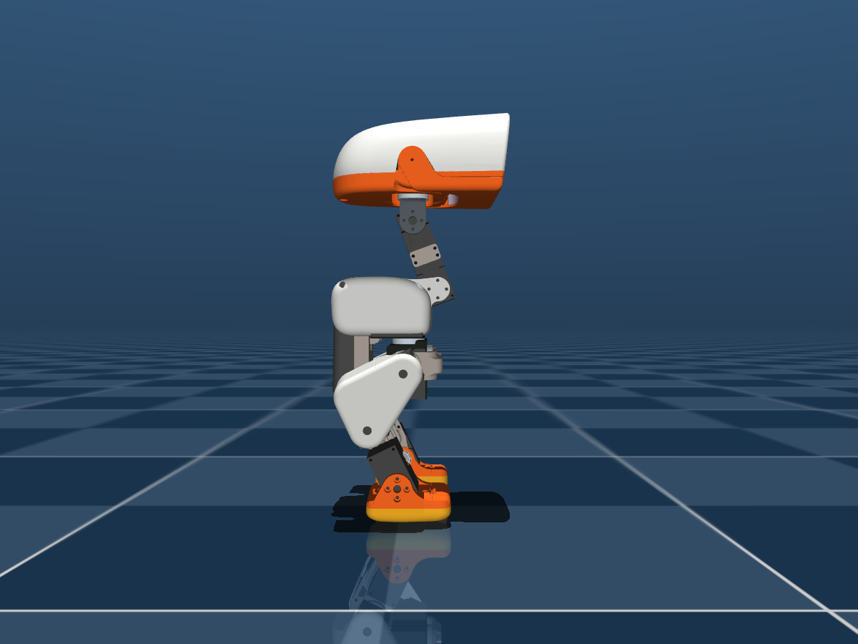
docs/images/microduck_front.png
