lsk0522/microduck/docs/images/microduck_side.png

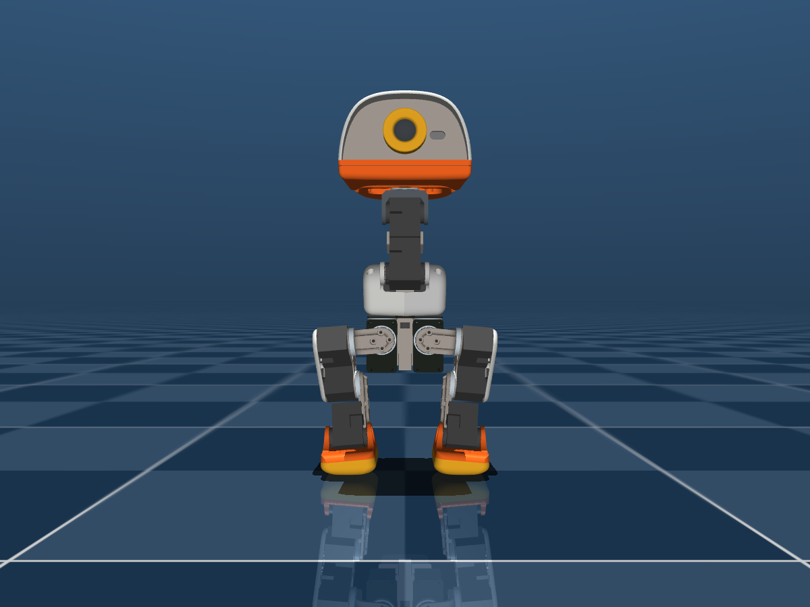
docs/images/microduck_side.png
