lsk0522/microduck/bom/BOM.csv

분류 | 품목 | 규격/모델 | 오리지널_수량 | 오리지널_예비 | 저렴_수량 | 단가 | 통화 | 가격근거 | 구매처 | 구매링크 | 링크유형 | 대안 | 메모
구동 | 다이나믹셀 서보 | ROBOTIS XL330-M288-T | 15 | 1 | 14 | 26400 | KRW | 확인 | 로보티즈 공식몰 | https://www.robotis.com/shop/item.php?it_id=902-0163-000 | 상품 | 로보몰(동일가, 품절): https://robomall.co.kr/product/%EB%8B%A4%EC%9D%B4%EB%82%98%EB%AF%B9%EC%85%80-xl330-m288-t/21150/ | 준비기간 40일(2026-11-09 배송지연 표시) → 가장 먼저 주문. 동봉: X3P 180 mm 1가닥, M2×6 탭볼트 6, M2×8 탭볼트 10. 5만원 이상 무료배송. 저렴한 버전은 부리(ID 34) 생략 → 14개
구동 | 서보 설정 인터페이스 | ROBOTIS U2D2 | 1 | 0 | 0 | 36300 | KRW | 확인 | 로보티즈 공식몰 | https://www.robotis.com/shop/item.php?it_id=902-0132-000 | 상품 |  | 정품 USB 인터페이스. 준비기간 10일 (2026-11-09 배송지연 표시)
구동 | U2D2 전원 허브 | U2D2 PHB Set | 1 | 0 | 0 | 21780 | KRW | 확인 | 로보티즈 공식몰 | https://www.robotis.com/shop/item.php?it_id=902-0145-001 | 상품 |  | 벤치에서 서보 전원 주입·분배 (3.5–24 V, 10 A, 입력은 한 곳만). U2D2 별도. 세트에 X3P·X4P 100 mm 케이블 동봉. 준비기간 1일
구동 | USB-TTL 변환기 (U2D2 대용) | CP2102 모듈 3.3V | 0 | 0 | 1 | 2500 | KRW | 추정 | 네이버쇼핑 최저가 | https://search.shopping.naver.com/search/all?query=CP2102+USB+TTL+%EB%AA%A8%EB%93%88&sort=price_asc | 검색 |  | SN74LVC2G241 반이중 회로와 함께 서보 ID 설정·벤치 테스트
구동 | 서보 케이블 추가 | 로봇 케이블-X3P 180mm 10개 | 1 | 0 | 0 | 18150 | KRW | 확인 | 로보티즈 공식몰 | https://www.robotis.com/shop/item.php?it_id=903-0249-000 | 상품 | 자작: https://search.shopping.naver.com/search/all?sort=price_asc | 필요 17가닥(머리·목 6, IMU 1, 다리 10) vs 서보 동봉 15가닥 → 2가닥 부족: 180 mm 1가닥(이 묶음) + 30→허브 250 mm 1가닥(아래). 나머지는 예비 (docs/assembly/OPERATION.md 3절)
구동 | 버스 케이블 250 mm | JST EH 2.5 mm 3핀 양끝 케이블 250 mm (1:1 결선) | 1 | 0 | 1 | 1500 | KRW | 추정 | 네이버쇼핑 최저가 | https://search.shopping.naver.com/search/all?sort=price_asc | 검색 | 알리: https://www.aliexpress.com/w/wholesale-JST-EH-2.5mm-3pin-cable-250mm-double-end.html?SortType=price_asc | 30(목 피치) → 몸통 허브 한 가닥. 목을 끝까지 숙이면 경로 156 mm라 180 mm는 여유 24 mm뿐. 로보티즈 X3P는 180 mm만 판매. 핀 1-1·2-2·3-3 같은 방향인지 확인
구동 | 버스 케이블 자작 | JST EH 3핀 케이블 180 mm 1가닥 | 0 | 0 | 1 | 1000 | KRW | 추정 | 네이버쇼핑 최저가 | https://search.shopping.naver.com/search/all?sort=price_asc | 검색 |  | 저렴한 버전: 필요 16가닥(부리 서보 없음) vs 동봉 14가닥 → 180 mm 1가닥 + 250 mm 1가닥(위)
컴퓨팅 | 메인 SBC | Radxa Zero 3W (1GB/8GB eMMC 또는 2GB/16GB) | 1 | 0 | 1 | 20.0 | USD | 확인 | ARACE (Radxa 공식 파트너) | https://arace.tech/products/radxa-zero-3w | 상품 | 알리: https://www.aliexpress.com/w/wholesale-Radxa-Zero-3W.html?SortType=price_asc / allnetchina: https://shop.allnetchina.cn/products/copy-of-radxa-zero-3w | ⚠ 2026-10-29 확인 시 ARACE·ameridroid·allnetchina 전 모델 품절, 2026-11-09 ARACE 다시 확인해도 전 모델 품절. 재입고 알림 신청. 대안: Orange Pi Zero 2W / Pi Zero 2W (같은 65×30, 런타임 포팅 필요)
컴퓨팅 | 방열판 | Radxa ZERO 3W/3E 전용 히트싱크 | 1 | 0 | 1 | 3000 | KRW | 추정 | 알리익스프레스 | https://www.aliexpress.us/item/3256806829446736.html | 상품 |  | 원본 문서에 95 °C 스로틀링 사례
컴퓨팅 | microSD | 32GB A1 (eMMC 없는 보드일 때만) | 0 | 0 | 1 | 6000 | KRW | 추정 | 네이버쇼핑 최저가 | https://search.shopping.naver.com/search/all?query=microSD+32GB+A1&sort=price_asc | 검색 |  | eMMC 없는 저가 보드 선택 시. 보유 중이면 0원
센서 | 몸통 IMU | SparkFun 6DoF LSM6DSV16X (Qwiic) SEN-21325 | 1 | 1 | 1 | 24.54 | USD | 확인 | SparkFun | https://www.sparkfun.com/sparkfun-6dof-imu-breakout-lsm6dsv16x-qwiic.html | 상품 | 알리 저가 모듈: https://www.aliexpress.com/w/wholesale-LSM6DSV16X-module.html?SortType=price_asc | 원본과 같은 칩. 알리 저가 모듈을 찾으면 저렴한 버전은 그쪽으로
센서 | IMU 브리지 MCU | ESP32-C3 SuperMini | 1 | 1 | 1 | 3000 | KRW | 추정 | 네이버쇼핑 최저가 | https://search.shopping.naver.com/search/all?query=ESP32-C3+SuperMini&sort=price_asc | 검색 | 알리: https://www.aliexpress.com/w/wholesale-ESP32-C3-SuperMini.html?SortType=price_asc | 버스 ID 200 슬레이브 펌웨어 (firmware/imu_to_dxl)
센서 | ToF 8×8 깊이센서 | Pololu VL53L8CX Carrier #3419 | 1 | 0 | 0 | 24.95 | USD | 확인 | DigiKey 코리아 | https://www.digikey.kr/en/products/detail/pololu/3419/22310072 | 상품 | Pololu 직구: https://www.pololu.com/product/3419 | 원본 머리 깊이센서 (VL53L8CX)
센서 | 카메라 | IMX219 모듈 + M12 광각렌즈 | 1 | 0 | 0 | 15000 | KRW | 추정 | 알리익스프레스 | https://www.aliexpress.com/w/wholesale-IMX219-M12-camera-module.html?SortType=price_asc | 검색 | 네이버: https://search.shopping.naver.com/search/all?sort=price_asc | Radxa Zero 3W는 22핀 CSI
센서 | CSI 케이블 | 22핀↔15핀 FPC 100 mm | 1 | 0 | 0 | 2000 | KRW | 추정 | 알리익스프레스 | https://www.aliexpress.com/w/wholesale-22pin-to-15pin-CSI-cable.html?SortType=price_asc | 검색 |  | 15핀 카메라 모듈일 때
오디오 | 오디오 코덱 | TLV320AIC3104IRHBR (HAT 실장) | 1 | 0 | 0 | 2.5 | USD | 추정 | LCSC | https://www.lcsc.com/search?q=TLV320AIC3104 | 검색 |  | 원본 런타임이 전제하는 코덱. HAT에 실장 (QFN 납땜 또는 JLCPCB 조립)
오디오 | 스피커 | 35×25×7 mm 8Ω 1W | 1 | 0 | 0 | 1500 | KRW | 추정 | 네이버쇼핑 최저가 | https://search.shopping.naver.com/search/all?sort=price_asc | 검색 |  | 원본 메시 치수
오디오 | 마이크 | MEMS 마이크 모듈 | 1 | 0 | 0 | 2000 | KRW | 추정 | 네이버쇼핑 최저가 | https://search.shopping.naver.com/search/all?sort=price_asc | 검색
전원 | 배터리+충전기 | NP-F550 호환 2S 7.2V 배터리 + USB 충전기 세트 | 1 | 1 | 1 | 25000 | KRW | 추정 | 네이버쇼핑 최저가 | https://search.shopping.naver.com/search/all?sort=price_asc | 검색 | NEEWER 4개+충전기 ₩163,000(확인): https://kr.neewer.com/products/neewer-4-packs-7-4v-2600mah-np-f550-replacement-batteries-66601510 | 서보에 직결(6.6–8.2 V). 약 1시간 동작. 오리지널 예비 = 배터리 세트 1개 추가
전원 | 배터리 플레이트 | NP-F 배터리 홀더 (리드선) | 1 | 0 | 1 | 4000 | KRW | 추정 | 알리익스프레스 | https://www.aliexpress.com/w/wholesale-NP-F-battery-plate-holder.html?SortType=price_asc | 검색 | 네이버: https://search.shopping.naver.com/search/all?sort=price_asc | 출력물 power_support에 고정
전원 | 5V 강압 모듈 | MP1584EN 3A | 1 | 1 | 1 | 1500 | KRW | 추정 | 네이버쇼핑 최저가 | https://search.shopping.naver.com/search/all?sort=price_asc | 검색 |  | SBC·센서용. 출력 5.1V로 조정 후 연결
전원 | 전원 스위치 | 슬라이드/로커 스위치 5 A 이상 | 1 | 0 | 1 | 1000 | KRW | 추정 | 네이버쇼핑 최저가 | https://search.shopping.naver.com/search/all?sort=price_asc | 검색
전원 | 퓨즈 | 미니 블레이드 퓨즈 5A + 홀더 | 1 | 0 | 1 | 1500 | KRW | 추정 | 네이버쇼핑 최저가 | https://search.shopping.naver.com/search/all?sort=price_asc | 검색 |  | 서보 버스 단락 보호
전원 | 버스 허브 (자작) | JST EH 3핀 기판 커넥터 ×4 + 만능기판 (목·다리 L/R·IMU 병렬, 전원은 XT30 입력) | 1 | 0 | 1 | 2000 | KRW | 추정 | 네이버쇼핑 최저가 | https://search.shopping.naver.com/search/all?sort=price_asc | 검색 |  | 몸통 전원부 위에 둔다 (권장 위치 X −24, Z +15 mm). 3핀 여분 1개를 달면 U2D2 점검용 (선택). docs/assembly/OPERATION.md 3절
전원 | 전원 배선 | 실리콘 전선 20AWG 빨강·검정 각 1 m + 수축튜브 | 1 | 0 | 1 | 3000 | KRW | 추정 | 네이버쇼핑 최저가 | https://search.shopping.naver.com/search/all?sort=price_asc | 검색 |  | 배터리 플레이트 → 퓨즈 → 스위치 → XT30 → 허브. 보유 시 0원
전원 | 커넥터 | XT30 수/암 세트 | 2 | 0 | 0 | 500 | KRW | 추정 | 알리익스프레스 | https://www.aliexpress.com/w/wholesale-XT30-connector.html?SortType=price_asc | 검색 |  | 저렴한 버전은 배터리 플레이트 리드선 직결
버스·PCB | 반이중 버퍼 IC | SN74LVC2G241DCUR | 1 | 2 | 1 | 0.15 | USD | 추정 | LCSC | https://www.lcsc.com/search?q=SN74LVC2G241 | 검색 |  | ROBOTIS 레퍼런스 반이중 회로. 1단계는 변환기판에 납땜
버스·PCB | 자작 HAT PCB | 65×30 mm 2층 PCB 5장 (배송 포함) | 1 | 0 | 1 | 10.0 | USD | 추정 | JLCPCB | https://jlcpcb.com/ | 사이트 |  | LCSC 부품과 함께 주문하면 배송 합산. 저렴한 버전은 만능기판으로 대체 가능
버스·PCB | 다이나믹셀 커넥터 | JST EH 3핀 헤더 (B3B-EH-A) | 6 | 0 | 6 | 100 | KRW | 추정 | 알리익스프레스 | https://www.aliexpress.com/w/wholesale-JST-EH-2.5mm-3pin-header.html?SortType=price_asc | 검색 |  | 허브 4 (+여분 1) + HAT 1. 보통 수십 개 묶음
기구 | 볼베어링 (대) | 16×22×4 mm (SMR2216ZZ) | 11 | 2 | 11 | 1200 | KRW | 추정 | 알리익스프레스 | https://www.aliexpress.com/w/wholesale-16x22x4-bearing.html?SortType=price_asc | 검색 | 네이버: https://search.shopping.naver.com/search/all?query=16x22x4+%EB%B2%A0%EC%96%B4%EB%A7%81&sort=price_asc | MJCF 실측. 10개 묶음 2개
기구 | 볼베어링 (소) | 10×15×3 mm | 3 | 1 | 3 | 1000 | KRW | 추정 | 알리익스프레스 | https://www.aliexpress.com/w/wholesale-10x15x3-bearing.html?SortType=price_asc | 검색 | 네이버: https://search.shopping.naver.com/search/all?query=10x15x3+%EB%B2%A0%EC%96%B4%EB%A7%81&sort=price_asc | MJCF 실측
기구 | 볼트 키트 | M2/M2.5/M3 볼트·너트 키트 | 1 | 0 | 1 | 6000 | KRW | 추정 | 알리익스프레스 | https://www.aliexpress.com/w/wholesale-M2-M2.5-M3-screw-kit.html?SortType=price_asc | 검색 |  | 보유 시 0원. 가이드 계산(126개) 중 별도 구매는 M2×4 ×4, M2.5×6 ×11 (+20 % 여유) — 나머지는 서보 동봉 탭볼트
기구 | 보드 스페이서 | M2.5 황동 스페이서 + 볼트 세트 | 1 | 0 | 1 | 3000 | KRW | 추정 | 네이버쇼핑 최저가 | https://search.shopping.naver.com/search/all?sort=price_asc | 검색 |  | SBC ↔ HAT 4곳 (HAT 구멍 Ø2.7). 높이는 헤더 높이에 맞춰 실물 확인
기구 | 인서트 너트 (선택) | M2/M2.5 열압착 인서트 | 0 | 0 | 0 | 4000 | KRW | 추정 | 알리익스프레스 | https://www.aliexpress.com/w/wholesale-M2-heat-set-insert.html?SortType=price_asc | 검색 |  | 원본 체결은 인서트 없이 서보 본체·출력물 탭 구멍 (조립 가이드 계산). 탭이 뭉개질 때만
기구 | 판재 4종 (알루미늄) | 레이저 가공: 1 mm ×5장(보강판2·몸통판1·롤판2) + 2 mm ×2장(목판) | 1 | 0 | 0 | 40000 | KRW | 추정 | 레이저 가공 업체 | https://search.shopping.naver.com/search/all?sort=price_asc | 검색 | JLCCNC 판금: https://jlccnc.com/ / PCBWay: https://www.pcbway.com/ | DXF: cad/plates/dynamixel. 소량 최소주문·배송비 때문에 견적 편차 큼 — 견적 받아 수정
기구 | 판재 3종 (FR4 대체) | PCB 업체 FR4 1.0 mm 외곽 가공 (보강판·몸통판·롤판), 목판은 출력 | 0 | 0 | 1 | 8.0 | USD | 추정 | JLCPCB | https://jlcpcb.com/ | 사이트 |  | HAT PCB와 같이 주문하면 배송비 합산. 알루미늄보다 강성 낮지만 출력물보다 훨씬 단단
출력소재 | 경질 필라멘트 | PETG 1 kg | 1 | 0 | 1 | 15000 | KRW | 추정 | 네이버쇼핑 최저가 | https://search.shopping.naver.com/search/all?sort=price_asc | 검색 |  | 보유 재고 있으면 0원. 실부피 약 207 cm³
출력소재 | 연질 필라멘트 | TPU 95A 0.5–1 kg | 1 | 0 | 1 | 18000 | KRW | 추정 | 네이버쇼핑 최저가 | https://search.shopping.naver.com/search/all?sort=price_asc | 검색 |  | 발바닥·부리 연질부 약 34 cm³
기타 | 게임패드 | Xbox 무선 컨트롤러 | 1 | 0 | 0 | 55000 | KRW | 추정 | 네이버쇼핑 최저가 | https://search.shopping.naver.com/search/all?sort=price_asc | 검색 |  | 원본 기본 조종기. 저렴한 버전은 노트북 UDP 패드(런타임 지원)
