lsk0522/microduck/bom/BOM.xlsx

Sheet: 비교
Microduck 클론 — 다이나믹셀(오리지널·저렴) vs 일반 서보
범례: 노란 칸·파란 글씨 = 입력값. 각 버전 시트의 수량·단가(파란 글씨)도 수정 가능.
환율 (원/USD) |  | 1400
예비 포함 (1=포함, 0=제외) |  | 1
분류 | 오리지널 | 저렴한 버전 | 일반 서보 버전
구동
컴퓨팅
센서
오디오
전원
버스·PCB
기구
출력소재
기타
제어·배선
합계
주력 서보 비용 (첫 행)
항목 | 오리지널 | 저렴한 버전 | 일반 서보 버전
서보 | XL330 15개 + 예비 1 | XL330 14개 (부리 고정) | MG996R 11 + MG90S 4 (+예비)
크기·무게 | 25 cm, 약 0.74 kg | 25 cm, 약 0.74 kg | 약 37 cm, 1.4–1.7 kg (추정)
위치 피드백 | 서보 내장 | 서보 내장 | 가변저항 배선 개조 + ADS1115
제어기 | Radxa Zero 3W + UART 버스 | Radxa Zero 3W + UART 버스 | Pi Zero 2W + PCA9685 (I²C)
센서 | IMU + ToF + 카메라 | IMU만 | BNO085 IMU만
오디오·조종 | 코덱·스피커·마이크, Xbox 패드 | 없음, UDP 패드 | 없음, UDP 패드
CAD | Pollen 형상 그대로 | Pollen 형상 그대로 | 1.5배 새로 설계
정책·런타임 | Pollen 것 그대로 | 부리 제외 패치 | 새 액추에이터 모델로 재학습, 파이썬 런타임 새로 작성
난이도 | 중 | 중 | 상 (sim2real 어려움)
⚠ 2026-10-29 기준 Radxa Zero 3W(다이나믹셀 버전)·Pi Zero 2W(일반 서보 버전) 모두 일부 판매처 품절.
가격근거 '확인' = 판매 페이지 정가 확인, '추정' = 시세 추정. 배송비 별도.

Sheet: 오리지널
Microduck 클론 BOM — 오리지널
다이나믹셀 · Pollen Microduck 하드웨어 그대로: 15축(부리 포함), ToF·카메라·오디오, U2D2, 게임패드, 예비 부품.
환율·예비 포함 여부는 '비교' 시트의 노란 칸에서 바꾼다. 쿠폰 할인·배송비 미반영.
분류 | 품목 | 규격/모델 | 수량 | 예비 | 총수량 | 단가 | 통화 | 단가(원) | 합계(원) | 가격근거 | 구매처 | 구매 링크 | 링크유형 | 대안 구매처 | 메모
구동 | 다이나믹셀 서보 | ROBOTIS XL330-M288-T | 15 | 1 |  | 26400 | KRW |  |  | 확인 | 로보티즈 공식몰 | https://www.robotis.com/shop/item.php?it_id=902-0163-000 | 상품 | 로보몰(동일가, 품절): https://robomall.co.kr/product/%EB%8B%A4%EC%9D%B4%EB%82%98%EB%AF%B9%EC%85%80-xl330-m288-t/21150/ | 준비기간 40일(2026-11-09 배송지연 표시) → 가장 먼저 주문. 동봉: X3P 180 mm 1가닥, M2×6 탭볼트 6, M2×8 탭볼트 10. 5만원 이상 무료배송. 저렴한 버전은 부리(ID 34) 생략 → 14개
구동 | 서보 설정 인터페이스 | ROBOTIS U2D2 | 1 | 0 |  | 36300 | KRW |  |  | 확인 | 로보티즈 공식몰 | https://www.robotis.com/shop/item.php?it_id=902-0132-000 | 상품 |  | 정품 USB 인터페이스. 준비기간 10일 (2026-11-09 배송지연 표시)
구동 | U2D2 전원 허브 | U2D2 PHB Set | 1 | 0 |  | 21780 | KRW |  |  | 확인 | 로보티즈 공식몰 | https://www.robotis.com/shop/item.php?it_id=902-0145-001 | 상품 |  | 벤치에서 서보 전원 주입·분배 (3.5–24 V, 10 A, 입력은 한 곳만). U2D2 별도. 세트에 X3P·X4P 100 mm 케이블 동봉. 준비기간 1일
구동 | 서보 케이블 추가 | 로봇 케이블-X3P 180mm 10개 | 1 | 0 |  | 18150 | KRW |  |  | 확인 | 로보티즈 공식몰 | https://www.robotis.com/shop/item.php?it_id=903-0249-000 | 상품 | 자작: https://search.shopping.naver.com/search/all?sort=price_asc | 필요 17가닥(머리·목 6, IMU 1, 다리 10) vs 서보 동봉 15가닥 → 2가닥 부족: 180 mm 1가닥(이 묶음) + 30→허브 250 mm 1가닥(아래). 나머지는 예비 (docs/assembly/OPERATION.md 3절)
구동 | 버스 케이블 250 mm | JST EH 2.5 mm 3핀 양끝 케이블 250 mm (1:1 결선) | 1 | 0 |  | 1500 | KRW |  |  | 추정 | 네이버쇼핑 최저가 | https://search.shopping.naver.com/search/all?sort=price_asc | 검색 | 알리: https://www.aliexpress.com/w/wholesale-JST-EH-2.5mm-3pin-cable-250mm-double-end.html?SortType=price_asc | 30(목 피치) → 몸통 허브 한 가닥. 목을 끝까지 숙이면 경로 156 mm라 180 mm는 여유 24 mm뿐. 로보티즈 X3P는 180 mm만 판매. 핀 1-1·2-2·3-3 같은 방향인지 확인
컴퓨팅 | 메인 SBC | Radxa Zero 3W (1GB/8GB eMMC 또는 2GB/16GB) | 1 | 0 |  | 20.00 | USD |  |  | 확인 | ARACE (Radxa 공식 파트너) | https://arace.tech/products/radxa-zero-3w | 상품 | 알리: https://www.aliexpress.com/w/wholesale-Radxa-Zero-3W.html?SortType=price_asc / allnetchina: https://shop.allnetchina.cn/products/copy-of-radxa-zero-3w | ⚠ 2026-10-29 확인 시 ARACE·ameridroid·allnetchina 전 모델 품절, 2026-11-09 ARACE 다시 확인해도 전 모델 품절. 재입고 알림 신청. 대안: Orange Pi Zero 2W / Pi Zero 2W (같은 65×30, 런타임 포팅 필요)
컴퓨팅 | 방열판 | Radxa ZERO 3W/3E 전용 히트싱크 | 1 | 0 |  | 3000 | KRW |  |  | 추정 | 알리익스프레스 | https://www.aliexpress.us/item/3256806829446736.html | 상품 |  | 원본 문서에 95 °C 스로틀링 사례
센서 | 몸통 IMU | SparkFun 6DoF LSM6DSV16X (Qwiic) SEN-21325 | 1 | 1 |  | 24.54 | USD |  |  | 확인 | SparkFun | https://www.sparkfun.com/sparkfun-6dof-imu-breakout-lsm6dsv16x-qwiic.html | 상품 | 알리 저가 모듈: https://www.aliexpress.com/w/wholesale-LSM6DSV16X-module.html?SortType=price_asc | 원본과 같은 칩. 알리 저가 모듈을 찾으면 저렴한 버전은 그쪽으로
센서 | IMU 브리지 MCU | ESP32-C3 SuperMini | 1 | 1 |  | 3000 | KRW |  |  | 추정 | 네이버쇼핑 최저가 | https://search.shopping.naver.com/search/all?query=ESP32-C3+SuperMini&sort=price_asc | 검색 | 알리: https://www.aliexpress.com/w/wholesale-ESP32-C3-SuperMini.html?SortType=price_asc | 버스 ID 200 슬레이브 펌웨어 (firmware/imu_to_dxl)
센서 | ToF 8×8 깊이센서 | Pololu VL53L8CX Carrier #3419 | 1 | 0 |  | 24.95 | USD |  |  | 확인 | DigiKey 코리아 | https://www.digikey.kr/en/products/detail/pololu/3419/22310072 | 상품 | Pololu 직구: https://www.pololu.com/product/3419 | 원본 머리 깊이센서 (VL53L8CX)
센서 | 카메라 | IMX219 모듈 + M12 광각렌즈 | 1 | 0 |  | 15000 | KRW |  |  | 추정 | 알리익스프레스 | https://www.aliexpress.com/w/wholesale-IMX219-M12-camera-module.html?SortType=price_asc | 검색 | 네이버: https://search.shopping.naver.com/search/all?sort=price_asc | Radxa Zero 3W는 22핀 CSI
센서 | CSI 케이블 | 22핀↔15핀 FPC 100 mm | 1 | 0 |  | 2000 | KRW |  |  | 추정 | 알리익스프레스 | https://www.aliexpress.com/w/wholesale-22pin-to-15pin-CSI-cable.html?SortType=price_asc | 검색 |  | 15핀 카메라 모듈일 때
오디오 | 오디오 코덱 | TLV320AIC3104IRHBR (HAT 실장) | 1 | 0 |  | 2.50 | USD |  |  | 추정 | LCSC | https://www.lcsc.com/search?q=TLV320AIC3104 | 검색 |  | 원본 런타임이 전제하는 코덱. HAT에 실장 (QFN 납땜 또는 JLCPCB 조립)
오디오 | 스피커 | 35×25×7 mm 8Ω 1W | 1 | 0 |  | 1500 | KRW |  |  | 추정 | 네이버쇼핑 최저가 | https://search.shopping.naver.com/search/all?sort=price_asc | 검색 |  | 원본 메시 치수
오디오 | 마이크 | MEMS 마이크 모듈 | 1 | 0 |  | 2000 | KRW |  |  | 추정 | 네이버쇼핑 최저가 | https://search.shopping.naver.com/search/all?sort=price_asc | 검색
전원 | 배터리+충전기 | NP-F550 호환 2S 7.2V 배터리 + USB 충전기 세트 | 1 | 1 |  | 25000 | KRW |  |  | 추정 | 네이버쇼핑 최저가 | https://search.shopping.naver.com/search/all?sort=price_asc | 검색 | NEEWER 4개+충전기 ₩163,000(확인): https://kr.neewer.com/products/neewer-4-packs-7-4v-2600mah-np-f550-replacement-batteries-66601510 | 서보에 직결(6.6–8.2 V). 약 1시간 동작. 오리지널 예비 = 배터리 세트 1개 추가
전원 | 배터리 플레이트 | NP-F 배터리 홀더 (리드선) | 1 | 0 |  | 4000 | KRW |  |  | 추정 | 알리익스프레스 | https://www.aliexpress.com/w/wholesale-NP-F-battery-plate-holder.html?SortType=price_asc | 검색 | 네이버: https://search.shopping.naver.com/search/all?sort=price_asc | 출력물 power_support에 고정
전원 | 5V 강압 모듈 | MP1584EN 3A | 1 | 1 |  | 1500 | KRW |  |  | 추정 | 네이버쇼핑 최저가 | https://search.shopping.naver.com/search/all?sort=price_asc | 검색 |  | SBC·센서용. 출력 5.1V로 조정 후 연결
전원 | 전원 스위치 | 슬라이드/로커 스위치 5 A 이상 | 1 | 0 |  | 1000 | KRW |  |  | 추정 | 네이버쇼핑 최저가 | https://search.shopping.naver.com/search/all?sort=price_asc | 검색
전원 | 퓨즈 | 미니 블레이드 퓨즈 5A + 홀더 | 1 | 0 |  | 1500 | KRW |  |  | 추정 | 네이버쇼핑 최저가 | https://search.shopping.naver.com/search/all?sort=price_asc | 검색 |  | 서보 버스 단락 보호
전원 | 버스 허브 (자작) | JST EH 3핀 기판 커넥터 ×4 + 만능기판 (목·다리 L/R·IMU 병렬, 전원은 XT30 입력) | 1 | 0 |  | 2000 | KRW |  |  | 추정 | 네이버쇼핑 최저가 | https://search.shopping.naver.com/search/all?sort=price_asc | 검색 |  | 몸통 전원부 위에 둔다 (권장 위치 X −24, Z +15 mm). 3핀 여분 1개를 달면 U2D2 점검용 (선택). docs/assembly/OPERATION.md 3절
전원 | 전원 배선 | 실리콘 전선 20AWG 빨강·검정 각 1 m + 수축튜브 | 1 | 0 |  | 3000 | KRW |  |  | 추정 | 네이버쇼핑 최저가 | https://search.shopping.naver.com/search/all?sort=price_asc | 검색 |  | 배터리 플레이트 → 퓨즈 → 스위치 → XT30 → 허브. 보유 시 0원
전원 | 커넥터 | XT30 수/암 세트 | 2 | 0 |  | 500 | KRW |  |  | 추정 | 알리익스프레스 | https://www.aliexpress.com/w/wholesale-XT30-connector.html?SortType=price_asc | 검색 |  | 저렴한 버전은 배터리 플레이트 리드선 직결
버스·PCB | 반이중 버퍼 IC | SN74LVC2G241DCUR | 1 | 2 |  | 0.15 | USD |  |  | 추정 | LCSC | https://www.lcsc.com/search?q=SN74LVC2G241 | 검색 |  | ROBOTIS 레퍼런스 반이중 회로. 1단계는 변환기판에 납땜
버스·PCB | 자작 HAT PCB | 65×30 mm 2층 PCB 5장 (배송 포함) | 1 | 0 |  | 10.00 | USD |  |  | 추정 | JLCPCB | https://jlcpcb.com/ | 사이트 |  | LCSC 부품과 함께 주문하면 배송 합산. 저렴한 버전은 만능기판으로 대체 가능
버스·PCB | 다이나믹셀 커넥터 | JST EH 3핀 헤더 (B3B-EH-A) | 6 | 0 |  | 100 | KRW |  |  | 추정 | 알리익스프레스 | https://www.aliexpress.com/w/wholesale-JST-EH-2.5mm-3pin-header.html?SortType=price_asc | 검색 |  | 허브 4 (+여분 1) + HAT 1. 보통 수십 개 묶음
기구 | 볼베어링 (대) | 16×22×4 mm (SMR2216ZZ) | 11 | 2 |  | 1200 | KRW |  |  | 추정 | 알리익스프레스 | https://www.aliexpress.com/w/wholesale-16x22x4-bearing.html?SortType=price_asc | 검색 | 네이버: https://search.shopping.naver.com/search/all?query=16x22x4+%EB%B2%A0%EC%96%B4%EB%A7%81&sort=price_asc | MJCF 실측. 10개 묶음 2개
기구 | 볼베어링 (소) | 10×15×3 mm | 3 | 1 |  | 1000 | KRW |  |  | 추정 | 알리익스프레스 | https://www.aliexpress.com/w/wholesale-10x15x3-bearing.html?SortType=price_asc | 검색 | 네이버: https://search.shopping.naver.com/search/all?query=10x15x3+%EB%B2%A0%EC%96%B4%EB%A7%81&sort=price_asc | MJCF 실측
기구 | 볼트 키트 | M2/M2.5/M3 볼트·너트 키트 | 1 | 0 |  | 6000 | KRW |  |  | 추정 | 알리익스프레스 | https://www.aliexpress.com/w/wholesale-M2-M2.5-M3-screw-kit.html?SortType=price_asc | 검색 |  | 보유 시 0원. 가이드 계산(126개) 중 별도 구매는 M2×4 ×4, M2.5×6 ×11 (+20 % 여유) — 나머지는 서보 동봉 탭볼트
기구 | 보드 스페이서 | M2.5 황동 스페이서 + 볼트 세트 | 1 | 0 |  | 3000 | KRW |  |  | 추정 | 네이버쇼핑 최저가 | https://search.shopping.naver.com/search/all?sort=price_asc | 검색 |  | SBC ↔ HAT 4곳 (HAT 구멍 Ø2.7). 높이는 헤더 높이에 맞춰 실물 확인
기구 | 판재 4종 (알루미늄) | 레이저 가공: 1 mm ×5장(보강판2·몸통판1·롤판2) + 2 mm ×2장(목판) | 1 | 0 |  | 40000 | KRW |  |  | 추정 | 레이저 가공 업체 | https://search.shopping.naver.com/search/all?sort=price_asc | 검색 | JLCCNC 판금: https://jlccnc.com/ / PCBWay: https://www.pcbway.com/ | DXF: cad/plates/dynamixel. 소량 최소주문·배송비 때문에 견적 편차 큼 — 견적 받아 수정
출력소재 | 경질 필라멘트 | PETG 1 kg | 1 | 0 |  | 15000 | KRW |  |  | 추정 | 네이버쇼핑 최저가 | https://search.shopping.naver.com/search/all?sort=price_asc | 검색 |  | 보유 재고 있으면 0원. 실부피 약 207 cm³
출력소재 | 연질 필라멘트 | TPU 95A 0.5–1 kg | 1 | 0 |  | 18000 | KRW |  |  | 추정 | 네이버쇼핑 최저가 | https://search.shopping.naver.com/search/all?sort=price_asc | 검색 |  | 발바닥·부리 연질부 약 34 cm³
기타 | 게임패드 | Xbox 무선 컨트롤러 | 1 | 0 |  | 55000 | KRW |  |  | 추정 | 네이버쇼핑 최저가 | https://search.shopping.naver.com/search/all?sort=price_asc | 검색 |  | 원본 기본 조종기. 저렴한 버전은 노트북 UDP 패드(런타임 지원)
 |  |  |  |  |  |  |  | 합계
 |  |  |  |  |  |  |  | 서보 비중

Sheet: 저렴한 버전
Microduck 클론 BOM — 저렴한 버전
다이나믹셀 · 걷기에 필요한 것만: 14축(부리 고정), 센서·오디오·게임패드 제외, CP2102로 U2D2 대체, 예비 없음.
환율·예비 포함 여부는 '비교' 시트의 노란 칸에서 바꾼다. 쿠폰 할인·배송비 미반영.
분류 | 품목 | 규격/모델 | 수량 | 예비 | 총수량 | 단가 | 통화 | 단가(원) | 합계(원) | 가격근거 | 구매처 | 구매 링크 | 링크유형 | 대안 구매처 | 메모
구동 | 다이나믹셀 서보 | ROBOTIS XL330-M288-T | 14 | 0 |  | 26400 | KRW |  |  | 확인 | 로보티즈 공식몰 | https://www.robotis.com/shop/item.php?it_id=902-0163-000 | 상품 | 로보몰(동일가, 품절): https://robomall.co.kr/product/%EB%8B%A4%EC%9D%B4%EB%82%98%EB%AF%B9%EC%85%80-xl330-m288-t/21150/ | 준비기간 40일(2026-11-09 배송지연 표시) → 가장 먼저 주문. 동봉: X3P 180 mm 1가닥, M2×6 탭볼트 6, M2×8 탭볼트 10. 5만원 이상 무료배송. 저렴한 버전은 부리(ID 34) 생략 → 14개
구동 | USB-TTL 변환기 (U2D2 대용) | CP2102 모듈 3.3V | 1 | 0 |  | 2500 | KRW |  |  | 추정 | 네이버쇼핑 최저가 | https://search.shopping.naver.com/search/all?query=CP2102+USB+TTL+%EB%AA%A8%EB%93%88&sort=price_asc | 검색 |  | SN74LVC2G241 반이중 회로와 함께 서보 ID 설정·벤치 테스트
구동 | 버스 케이블 250 mm | JST EH 2.5 mm 3핀 양끝 케이블 250 mm (1:1 결선) | 1 | 0 |  | 1500 | KRW |  |  | 추정 | 네이버쇼핑 최저가 | https://search.shopping.naver.com/search/all?sort=price_asc | 검색 | 알리: https://www.aliexpress.com/w/wholesale-JST-EH-2.5mm-3pin-cable-250mm-double-end.html?SortType=price_asc | 30(목 피치) → 몸통 허브 한 가닥. 목을 끝까지 숙이면 경로 156 mm라 180 mm는 여유 24 mm뿐. 로보티즈 X3P는 180 mm만 판매. 핀 1-1·2-2·3-3 같은 방향인지 확인
구동 | 버스 케이블 자작 | JST EH 3핀 케이블 180 mm 1가닥 | 1 | 0 |  | 1000 | KRW |  |  | 추정 | 네이버쇼핑 최저가 | https://search.shopping.naver.com/search/all?sort=price_asc | 검색 |  | 저렴한 버전: 필요 16가닥(부리 서보 없음) vs 동봉 14가닥 → 180 mm 1가닥 + 250 mm 1가닥(위)
컴퓨팅 | 메인 SBC | Radxa Zero 3W (1GB/8GB eMMC 또는 2GB/16GB) | 1 | 0 |  | 20.00 | USD |  |  | 확인 | ARACE (Radxa 공식 파트너) | https://arace.tech/products/radxa-zero-3w | 상품 | 알리: https://www.aliexpress.com/w/wholesale-Radxa-Zero-3W.html?SortType=price_asc / allnetchina: https://shop.allnetchina.cn/products/copy-of-radxa-zero-3w | ⚠ 2026-10-29 확인 시 ARACE·ameridroid·allnetchina 전 모델 품절, 2026-11-09 ARACE 다시 확인해도 전 모델 품절. 재입고 알림 신청. 대안: Orange Pi Zero 2W / Pi Zero 2W (같은 65×30, 런타임 포팅 필요)
컴퓨팅 | 방열판 | Radxa ZERO 3W/3E 전용 히트싱크 | 1 | 0 |  | 3000 | KRW |  |  | 추정 | 알리익스프레스 | https://www.aliexpress.us/item/3256806829446736.html | 상품 |  | 원본 문서에 95 °C 스로틀링 사례
컴퓨팅 | microSD | 32GB A1 (eMMC 없는 보드일 때만) | 1 | 0 |  | 6000 | KRW |  |  | 추정 | 네이버쇼핑 최저가 | https://search.shopping.naver.com/search/all?query=microSD+32GB+A1&sort=price_asc | 검색 |  | eMMC 없는 저가 보드 선택 시. 보유 중이면 0원
센서 | 몸통 IMU | SparkFun 6DoF LSM6DSV16X (Qwiic) SEN-21325 | 1 | 0 |  | 24.54 | USD |  |  | 확인 | SparkFun | https://www.sparkfun.com/sparkfun-6dof-imu-breakout-lsm6dsv16x-qwiic.html | 상품 | 알리 저가 모듈: https://www.aliexpress.com/w/wholesale-LSM6DSV16X-module.html?SortType=price_asc | 원본과 같은 칩. 알리 저가 모듈을 찾으면 저렴한 버전은 그쪽으로
센서 | IMU 브리지 MCU | ESP32-C3 SuperMini | 1 | 0 |  | 3000 | KRW |  |  | 추정 | 네이버쇼핑 최저가 | https://search.shopping.naver.com/search/all?query=ESP32-C3+SuperMini&sort=price_asc | 검색 | 알리: https://www.aliexpress.com/w/wholesale-ESP32-C3-SuperMini.html?SortType=price_asc | 버스 ID 200 슬레이브 펌웨어 (firmware/imu_to_dxl)
전원 | 배터리+충전기 | NP-F550 호환 2S 7.2V 배터리 + USB 충전기 세트 | 1 | 0 |  | 25000 | KRW |  |  | 추정 | 네이버쇼핑 최저가 | https://search.shopping.naver.com/search/all?sort=price_asc | 검색 | NEEWER 4개+충전기 ₩163,000(확인): https://kr.neewer.com/products/neewer-4-packs-7-4v-2600mah-np-f550-replacement-batteries-66601510 | 서보에 직결(6.6–8.2 V). 약 1시간 동작. 오리지널 예비 = 배터리 세트 1개 추가
전원 | 배터리 플레이트 | NP-F 배터리 홀더 (리드선) | 1 | 0 |  | 4000 | KRW |  |  | 추정 | 알리익스프레스 | https://www.aliexpress.com/w/wholesale-NP-F-battery-plate-holder.html?SortType=price_asc | 검색 | 네이버: https://search.shopping.naver.com/search/all?sort=price_asc | 출력물 power_support에 고정
전원 | 5V 강압 모듈 | MP1584EN 3A | 1 | 0 |  | 1500 | KRW |  |  | 추정 | 네이버쇼핑 최저가 | https://search.shopping.naver.com/search/all?sort=price_asc | 검색 |  | SBC·센서용. 출력 5.1V로 조정 후 연결
전원 | 전원 스위치 | 슬라이드/로커 스위치 5 A 이상 | 1 | 0 |  | 1000 | KRW |  |  | 추정 | 네이버쇼핑 최저가 | https://search.shopping.naver.com/search/all?sort=price_asc | 검색
전원 | 퓨즈 | 미니 블레이드 퓨즈 5A + 홀더 | 1 | 0 |  | 1500 | KRW |  |  | 추정 | 네이버쇼핑 최저가 | https://search.shopping.naver.com/search/all?sort=price_asc | 검색 |  | 서보 버스 단락 보호
전원 | 버스 허브 (자작) | JST EH 3핀 기판 커넥터 ×4 + 만능기판 (목·다리 L/R·IMU 병렬, 전원은 XT30 입력) | 1 | 0 |  | 2000 | KRW |  |  | 추정 | 네이버쇼핑 최저가 | https://search.shopping.naver.com/search/all?sort=price_asc | 검색 |  | 몸통 전원부 위에 둔다 (권장 위치 X −24, Z +15 mm). 3핀 여분 1개를 달면 U2D2 점검용 (선택). docs/assembly/OPERATION.md 3절
전원 | 전원 배선 | 실리콘 전선 20AWG 빨강·검정 각 1 m + 수축튜브 | 1 | 0 |  | 3000 | KRW |  |  | 추정 | 네이버쇼핑 최저가 | https://search.shopping.naver.com/search/all?sort=price_asc | 검색 |  | 배터리 플레이트 → 퓨즈 → 스위치 → XT30 → 허브. 보유 시 0원
버스·PCB | 반이중 버퍼 IC | SN74LVC2G241DCUR | 1 | 0 |  | 0.15 | USD |  |  | 추정 | LCSC | https://www.lcsc.com/search?q=SN74LVC2G241 | 검색 |  | ROBOTIS 레퍼런스 반이중 회로. 1단계는 변환기판에 납땜
버스·PCB | 자작 HAT PCB | 65×30 mm 2층 PCB 5장 (배송 포함) | 1 | 0 |  | 10.00 | USD |  |  | 추정 | JLCPCB | https://jlcpcb.com/ | 사이트 |  | LCSC 부품과 함께 주문하면 배송 합산. 저렴한 버전은 만능기판으로 대체 가능
버스·PCB | 다이나믹셀 커넥터 | JST EH 3핀 헤더 (B3B-EH-A) | 6 | 0 |  | 100 | KRW |  |  | 추정 | 알리익스프레스 | https://www.aliexpress.com/w/wholesale-JST-EH-2.5mm-3pin-header.html?SortType=price_asc | 검색 |  | 허브 4 (+여분 1) + HAT 1. 보통 수십 개 묶음
기구 | 볼베어링 (대) | 16×22×4 mm (SMR2216ZZ) | 11 | 0 |  | 1200 | KRW |  |  | 추정 | 알리익스프레스 | https://www.aliexpress.com/w/wholesale-16x22x4-bearing.html?SortType=price_asc | 검색 | 네이버: https://search.shopping.naver.com/search/all?query=16x22x4+%EB%B2%A0%EC%96%B4%EB%A7%81&sort=price_asc | MJCF 실측. 10개 묶음 2개
기구 | 볼베어링 (소) | 10×15×3 mm | 3 | 0 |  | 1000 | KRW |  |  | 추정 | 알리익스프레스 | https://www.aliexpress.com/w/wholesale-10x15x3-bearing.html?SortType=price_asc | 검색 | 네이버: https://search.shopping.naver.com/search/all?query=10x15x3+%EB%B2%A0%EC%96%B4%EB%A7%81&sort=price_asc | MJCF 실측
기구 | 볼트 키트 | M2/M2.5/M3 볼트·너트 키트 | 1 | 0 |  | 6000 | KRW |  |  | 추정 | 알리익스프레스 | https://www.aliexpress.com/w/wholesale-M2-M2.5-M3-screw-kit.html?SortType=price_asc | 검색 |  | 보유 시 0원. 가이드 계산(126개) 중 별도 구매는 M2×4 ×4, M2.5×6 ×11 (+20 % 여유) — 나머지는 서보 동봉 탭볼트
기구 | 보드 스페이서 | M2.5 황동 스페이서 + 볼트 세트 | 1 | 0 |  | 3000 | KRW |  |  | 추정 | 네이버쇼핑 최저가 | https://search.shopping.naver.com/search/all?sort=price_asc | 검색 |  | SBC ↔ HAT 4곳 (HAT 구멍 Ø2.7). 높이는 헤더 높이에 맞춰 실물 확인
기구 | 판재 3종 (FR4 대체) | PCB 업체 FR4 1.0 mm 외곽 가공 (보강판·몸통판·롤판), 목판은 출력 | 1 | 0 |  | 8.00 | USD |  |  | 추정 | JLCPCB | https://jlcpcb.com/ | 사이트 |  | HAT PCB와 같이 주문하면 배송비 합산. 알루미늄보다 강성 낮지만 출력물보다 훨씬 단단
출력소재 | 경질 필라멘트 | PETG 1 kg | 1 | 0 |  | 15000 | KRW |  |  | 추정 | 네이버쇼핑 최저가 | https://search.shopping.naver.com/search/all?sort=price_asc | 검색 |  | 보유 재고 있으면 0원. 실부피 약 207 cm³
출력소재 | 연질 필라멘트 | TPU 95A 0.5–1 kg | 1 | 0 |  | 18000 | KRW |  |  | 추정 | 네이버쇼핑 최저가 | https://search.shopping.naver.com/search/all?sort=price_asc | 검색 |  | 발바닥·부리 연질부 약 34 cm³
 |  |  |  |  |  |  |  | 합계
 |  |  |  |  |  |  |  | 서보 비중

Sheet: 일반 서보 버전
Microduck 클론 BOM — 일반 서보 버전
MG996R ×11 + MG90S ×4, 1.5배 확대, Raspberry Pi + PCA9685 + ADS1115 위치 피드백 개조. plan-hobby-servo.md 참고.
환율·예비 포함 여부는 '비교' 시트의 노란 칸에서 바꾼다. 쿠폰 할인·배송비 미반영.
분류 | 품목 | 규격/모델 | 수량 | 예비 | 총수량 | 단가 | 통화 | 단가(원) | 합계(원) | 가격근거 | 구매처 | 구매 링크 | 링크유형 | 대안 구매처 | 메모
구동 | 다리·목 서보 | MG996R 메탈기어 (TowerPro 호환) | 11 | 2 |  | 5000 | KRW |  |  | 추정 | 디바이스마트 | https://www.devicemart.co.kr/goods/view?no=1313388 | 상품 | 네이버: https://search.shopping.naver.com/search/all?query=MG996R+%EC%84%9C%EB%B3%B4%EB%AA%A8%ED%84%B0&sort=price_asc / 알리: https://www.aliexpress.com/w/wholesale-MG996R-servo.html?SortType=price_asc | 다리 10 + neck_pitch 1. 9.4 kgf·cm@4.8V, 11 kgf·cm@6V, 55 g. 호환품 편차 커서 예비 2개
구동 | 머리·부리 서보 | MG90S 메탈기어 | 4 | 1 |  | 3000 | KRW |  |  | 추정 | 네이버쇼핑 최저가 | https://search.shopping.naver.com/search/all?query=MG90S+%EC%84%9C%EB%B3%B4%EB%AA%A8%ED%84%B0&sort=price_asc | 검색 | 알리: https://www.aliexpress.com/w/wholesale-MG90S-servo.html?SortType=price_asc | head_pitch·yaw·roll + 부리. 2.2 kgf·cm@6V, 13.4 g. SG90(플라스틱 기어)은 낙하에 약함
구동 | 알루미늄 서보 혼 | 25T 알루미늄 원형 혼 (MG996R용) | 11 | 0 |  | 1500 | KRW |  |  | 추정 | 알리익스프레스 | https://www.aliexpress.com/w/wholesale-25T-aluminum-servo-horn.html?SortType=price_asc | 검색 |  | 동봉 플라스틱 혼은 하중에 약함
구동 | 서보 연장선 | 서보 연장 케이블 15–30 cm | 15 | 0 |  | 300 | KRW |  |  | 추정 | 알리익스프레스 | https://www.aliexpress.com/w/wholesale-servo-extension-cable-30cm.html?SortType=price_asc | 검색 |  | 다리 끝 서보용
컴퓨팅 | 메인 컴퓨터 | Raspberry Pi Zero 2 W (헤더 포함) | 1 | 0 |  | 30300 | KRW |  |  | 확인 | 에듀이노 | https://eduino.kr/product/라즈베리파이-제로-2-w-raspberry-pi-zero-2-w/2949/{$url} | 상품 | 네이버: https://search.shopping.naver.com/search/all?sort=price_asc | ⚠ 2026-10-29 에듀이노 품절. 대안 Pi 4 1–2GB (1.5배 몸통에 들어감)
컴퓨팅 | microSD | 32GB A1 | 1 | 0 |  | 6000 | KRW |  |  | 추정 | 네이버쇼핑 최저가 | https://search.shopping.naver.com/search/all?query=microSD+32GB+A1&sort=price_asc | 검색
센서 | IMU | BNO085 모듈 (게임 회전 벡터) | 1 | 0 |  | 12000 | KRW |  |  | 추정 | 알리익스프레스 | https://www.aliexpress.com/w/wholesale-BNO085-module.html?SortType=price_asc | 검색 | BNO055(Open Duck 사용): https://www.aliexpress.com/w/wholesale-BNO055-module.html?SortType=price_asc | 쿼터니언+자이로를 칩이 계산
센서 | 위치 피드백 ADC | ADS1115 16비트 4채널 모듈 | 4 | 1 |  | 3000 | KRW |  |  | 추정 | 네이버쇼핑 최저가 | https://search.shopping.naver.com/search/all?query=ADS1115+%EB%AA%A8%EB%93%88&sort=price_asc | 검색 | 알리: https://www.aliexpress.com/w/wholesale-ADS1115-module.html?SortType=price_asc | 4개 × 4ch = 16ch, 주소 0x48–0x4B
센서 | 피드백 배선 | AWG30 랩핑 와이어 + 분압 저항 10kΩ 키트 | 1 | 0 |  | 5000 | KRW |  |  | 추정 | 네이버쇼핑 최저가 | https://search.shopping.naver.com/search/all?sort=price_asc | 검색 |  | 서보 가변저항 와이퍼 배선 개조용
제어·배선 | PWM 드라이버 | PCA9685 16채널 서보 드라이버 | 1 | 0 |  | 4000 | KRW |  |  | 추정 | 네이버쇼핑 최저가 | https://search.shopping.naver.com/search/all?sort=price_asc | 검색 | 알리: https://www.aliexpress.com/w/wholesale-PCA9685-servo-driver.html?SortType=price_asc | I²C, 하드웨어 PWM
제어·배선 | 만능기판·헤더 | 만능기판 + 핀헤더 + 전선 | 1 | 0 |  | 5000 | KRW |  |  | 추정 | 네이버쇼핑 최저가 | https://search.shopping.naver.com/search/all?sort=price_asc | 검색 |  | 전원 분배·ADC 배선판
전원 | 배터리 | 2S LiPo 7.4V 2200mAh (XT60) | 1 | 0 |  | 20000 | KRW |  |  | 추정 | 네이버쇼핑 최저가 | https://search.shopping.naver.com/search/all?query=2S+%EB%A6%AC%ED%8F%AC+2200mAh&sort=price_asc | 검색 |  | 대안: 2S LiFePO4(최대 7.2V)는 MG996R 직결 가능
전원 | 충전기 | 2S/3S 밸런스 충전기 | 1 | 0 |  | 10000 | KRW |  |  | 추정 | 네이버쇼핑 최저가 | https://search.shopping.naver.com/search/all?sort=price_asc | 검색 |  | 보유 시 0원
전원 | 서보 전원 | 6V 10A 이상 UBEC | 1 | 0 |  | 12000 | KRW |  |  | 추정 | 네이버쇼핑 최저가 | https://search.shopping.naver.com/search/all?query=UBEC+6V+10A&sort=price_asc | 검색 |  | MG996R 정지전류 2.5A@6V × 11 → 여유 필요
전원 | 머리 서보·Pi 전원 | MP1584EN 3A 강압 모듈 | 2 | 0 |  | 1500 | KRW |  |  | 추정 | 네이버쇼핑 최저가 | https://search.shopping.naver.com/search/all?sort=price_asc | 검색 |  | Pi 5.1V 1개, MG90S 5–6V 1개 (서보 레일과 분리)
전원 | 전해 커패시터 | 2200µF 16V | 2 | 0 |  | 500 | KRW |  |  | 추정 | 네이버쇼핑 최저가 | https://search.shopping.naver.com/search/all?query=2200uF+16V+%EC%BD%98%EB%8D%B4%EC%84%9C&sort=price_asc | 검색 |  | 서보 레일 전압 강하 완화
전원 | 스위치·퓨즈·커넥터 | 로커스위치 10A, 블레이드 퓨즈 15A+홀더, XT60 | 1 | 0 |  | 4000 | KRW |  |  | 추정 | 네이버쇼핑 최저가 | https://search.shopping.naver.com/search/all?sort=price_asc | 검색
기구 | 관절 지지 베어링 | 623ZZ 3×10×4 mm | 16 | 4 |  | 300 | KRW |  |  | 추정 | 알리익스프레스 | https://www.aliexpress.com/w/wholesale-623ZZ-bearing.html?SortType=price_asc | 검색 | 네이버: https://search.shopping.naver.com/search/all?query=623ZZ+%EB%B2%A0%EC%96%B4%EB%A7%81&sort=price_asc | 서보 반대편 축 지지
기구 | 볼트 키트 | M2/M3 볼트·너트·인서트 키트 | 1 | 0 |  | 8000 | KRW |  |  | 추정 | 알리익스프레스 | https://www.aliexpress.com/w/wholesale-M3-screw-kit-heat-insert.html?SortType=price_asc | 검색 |  | 보유 시 0원
출력소재 | 경질 필라멘트 | PETG 1 kg | 1 | 0 |  | 15000 | KRW |  |  | 추정 | 네이버쇼핑 최저가 | https://search.shopping.naver.com/search/all?sort=price_asc | 검색 |  | 1.5배 확대로 부피 약 3배 → 1 kg 거의 다 사용
출력소재 | 연질 필라멘트 | TPU 95A 0.5 kg | 1 | 0 |  | 18000 | KRW |  |  | 추정 | 네이버쇼핑 최저가 | https://search.shopping.naver.com/search/all?sort=price_asc | 검색 |  | 발바닥
 |  |  |  |  |  |  |  | 합계
 |  |  |  |  |  |  |  | 서보 비중

Sheet: 출력·부품 치수
part | 분류 | 수량 | X_mm | Y_mm | Z_mm | 부피_cm3 | 권장재질/품목 | 메모 | 파일
ankle_l_v1 | 출력(경질) | 1 | 39.5 | 46.5 | 25.4 | 6.69 | PETG 또는 PLA+ | 롤러 장착용 발목 변형 롤러 옵션 | assets/ankle_l_v1.stl
ankle_left | 출력(경질) | 1 | 39.5 | 36.5 | 25.5 | 7.88 | PETG 또는 PLA+ |  | assets/ankle_left.stl
ankle_r_v1 | 출력(경질) | 1 | 39.5 | 46.5 | 25.4 | 6.69 | PETG 또는 PLA+ | 롤러 장착용 발목 변형 롤러 옵션 | assets/ankle_r_v1.stl
ankle_right | 출력(경질) | 1 | 39.5 | 36.5 | 25.5 | 7.88 | PETG 또는 PLA+ |  | assets/ankle_right.stl
banana_pcb_locker | 출력(경질) | 1 | 54.1 | 3.8 | 6.7 | 0.46 | PETG 또는 PLA+ |  | assets/banana_pcb_locker.stl
bearing_roll | 판재 | 2 | 23 | 3 | 40 | 0.63 | 알루미늄 1 mm | 고관절 롤 베어링판 (+보스 2개 생략) — DXF: cad/plates/dynamixel | assets/bearing_roll.stl
bottom_head_shell | 출력(경질) | 1 | 91.8 | 116.7 | 20.1 | 23.8 | PETG 또는 PLA+ |  | assets/bottom_head_shell.stl
elec_rpi_robot_hat_pcb | 자작 PCB | 1 | 65 | 30 | 0.8 | 1.57 | 65×30 HAT | 반이중 버스·전원·오디오 등 (직접 설계) | assets/elec_rpi_robot_hat_pcb.stl
face_part | 출력(경질) | 1 | 87.7 | 12.5 | 44.6 | 5.82 | PETG 또는 PLA+ |  | assets/face_part.stl
foot_left | 출력(경질) | 1 | 40.1 | 54 | 16.9 | 12.18 | PETG 또는 PLA+ |  | assets/foot_left.stl
foot_right | 출력(경질) | 1 | 40.1 | 54 | 16.9 | 12.18 | PETG 또는 PLA+ |  | assets/foot_right.stl
hip_l | 출력(경질) | 2 | 32.5 | 34.5 | 19 | 4.52 | PETG 또는 PLA+ |  | assets/hip_l.stl
jaw | 출력(경질) | 1 | 91.4 | 68.7 | 29.4 | 9.36 | PETG 또는 PLA+ |  | assets/jaw.stl
jaw_soft | 출력(연질) | 1 | 87.7 | 32.2 | 8.4 | 18.6 | TPU 95A | 부리 아래 연질부 | assets/jaw_soft.stl
left_shell | 출력(경질) | 1 | 33.7 | 80.9 | 41.7 | 11.39 | PETG 또는 PLA+ |  | assets/left_shell.stl
leg | 출력(경질) | 2 | 8 | 20 | 58 | 3.41 | PETG 또는 PLA+ |  | assets/leg.stl
lens | 구매품 | 1 | 16.9 | 18.9 | 16.9 | 2.8 | M12 광각 렌즈 | IMX219 카메라용 | assets/lens.stl
m12_lens_holder | 출력(경질) | 1 | 24 | 14.8 | 16 | 1.1 | PETG 또는 PLA+ |  | assets/m12_lens_holder.stl
motor_support | 출력(경질) | 1 | 73.5 | 54.2 | 18.8 | 7.52 | PETG 또는 PLA+ |  | assets/motor_support.stl
neck | 판재 | 2 | 2 | 20 | 11 | 0.4 | 알루미늄 2 mm | 목 연결판 — DXF: cad/plates/dynamixel | assets/neck.stl
neck_pitch | 출력(경질) | 1 | 35 | 18 | 27.7 | 4.11 | PETG 또는 PLA+ |  | assets/neck_pitch.stl
noenoeil | 출력(경질) | 1 | 30 | 9.5 | 30 | 4.25 | PETG 또는 PLA+ |  | assets/noenoeil.stl
np_f970 | 구매품 | 1 | 38.6 | 20.6 | 70.8 | 51.56 | Sony NP-F 계열 배터리 외형 | 모델은 NP-F970 크기, 실물은 NP-F550 | assets/np_f970.stl
pcb__raspberry_pi_zero_2_w | 구매품 | 1 | 65 | 1.6 | 30 | 3.02 | Radxa Zero 3W (동일 65×30 폼팩터) | 모델은 Pi Zero 2W 자리표시자 | assets/pcb__raspberry_pi_zero_2_w.stl
power_support | 출력(경질) | 1 | 54.5 | 17 | 83.5 | 10.49 | PETG 또는 PLA+ |  | assets/power_support.stl
right_shell | 출력(경질) | 1 | 31.8 | 80.9 | 41.7 | 11.22 | PETG 또는 PLA+ |  | assets/right_shell.stl
rim | 출력(경질) | 4 | 7.6 | 20.2 | 20.2 | 1.03 | PETG 또는 PLA+ | 롤러 옵션 | assets/rim.stl
roller_blade | 출력(경질) | 2 | 40.5 | 73 | 30.4 | 11.81 | PETG 또는 PLA+ | 롤러 옵션 | assets/roller_blade.stl
seeed_bearing__configuration__22x16x4 | 구매품 | 11 | 22 | 22 | 4 | 0.49 | 볼베어링 16×22×4 | 관절 지지 베어링 | assets/seeed_bearing__configuration__22x16x4.stl
seeed_bearing__configuration_default | 구매품 | 3 | 15 | 15 | 3 | 0.19 | 볼베어링 10×15×3 | 소형 베어링 | assets/seeed_bearing__configuration_default.stl
soft_mouth_top | 출력(연질) | 1 | 87.8 | 32.6 | 3.3 | 2.7 | TPU 95A | 부리 위 연질부 | assets/soft_mouth_top.stl
sole_left | 출력(연질) | 1 | 41.1 | 54 | 12.9 | 6.25 | TPU 95A | 발바닥 | assets/sole_left.stl
sole_right | 출력(연질) | 1 | 41.1 | 54 | 12.9 | 6.25 | TPU 95A | 발바닥 | assets/sole_right.stl
speaker | 구매품 | 1 | 35 | 25 | 7 | 6.13 | 35×25×7 mm 소형 스피커 |  | assets/speaker.stl
tire | 출력(연질) | 4 | 7.6 | 30 | 30 | 2.81 | TPU 95A | 롤러 타이어 (선택) 롤러 옵션 | assets/tire.stl
top_head_shell | 출력(경질) | 1 | 91.8 | 122.7 | 46.3 | 29.87 | PETG 또는 PLA+ |  | assets/top_head_shell.stl
trunk_base | 판재 | 1 | 57 | 36 | 3 | 1.42 | 알루미늄 1 mm | 몸통 바닥판 (+높이 2 mm 보스 4개는 생략) — DXF: cad/plates/dynamixel | assets/trunk_base.stl
upper_leg_left | 출력(경질) | 1 | 28 | 47.7 | 61 | 4.15 | PETG 또는 PLA+ |  | assets/upper_leg_left.stl
upper_leg_right | 출력(경질) | 1 | 28 | 47.7 | 61 | 4.15 | PETG 또는 PLA+ |  | assets/upper_leg_right.stl
upper_leg_rigidity_plate | 판재 | 2 | 1 | 45 | 58.1 | 0.75 | 알루미늄 1 mm | 허벅지 보강판 — DXF: cad/plates/dynamixel | assets/upper_leg_rigidity_plate.stl
xl330 | 구매품 | 15 | 29 | 20 | 34 | 15.68 | ROBOTIS XL330-M288-T | 서보 외형 (20×34×26 mm) | assets/xl330.stl
yaw2roll | 출력(경질) | 2 | 23 | 25.8 | 20.5 | 2.82 | PETG 또는 PLA+ |  | assets/yaw2roll.stl
yaw_roll_motion | 출력(경질) | 1 | 34 | 35.9 | 22.5 | 4.56 | PETG 또는 PLA+ |  | assets/yaw_roll_motion.stl
출처: Pollen Robotics microduck_rl MJCF/STL 실측 (CC BY-NC-SA 4.0). 재질·분류는 추정값. 저렴한 버전은 부리 서보 자리를 고정 부품으로 대체.
