lsk0522/microduck/cad/plates/dynamixel/plates.csv

part | qty | thickness_mm | size_mm | holes | memo
upper_leg_rigidity_plate | 2 | 1.0 | 58.1 × 45.0 | Ø2.2, Ø19.0, 비원형, 비원형, Ø2.2, Ø2.2, Ø2.2, 비원형, Ø19.0 | 허벅지 보강판
trunk_base | 1 | 1.0 | 57.0 × 36.0 | Ø2.3, Ø19.0, Ø2.3, 비원형, Ø2.3, Ø19.0, Ø2.3 | 몸통 바닥판 (원본에 높이 2 mm 보스 4개 — 판재에선 생략, 위치는 구멍으로 표시 안 됨)
bearing_roll | 2 | 1.0 | 40.0 × 23.0 | Ø2.2, Ø2.2, Ø19.0, Ø2.2, Ø2.2 | 고관절 롤 베어링판 (원본에 높이 2 mm 보스 2개)
neck | 2 | 2.0 | 11.0 × 20.0 | Ø2.3, Ø2.3, Ø2.3, Ø2.3 | 목 연결판
