lsk0522/microduck/cad/plates/dynamixel/trunk_base.dxf

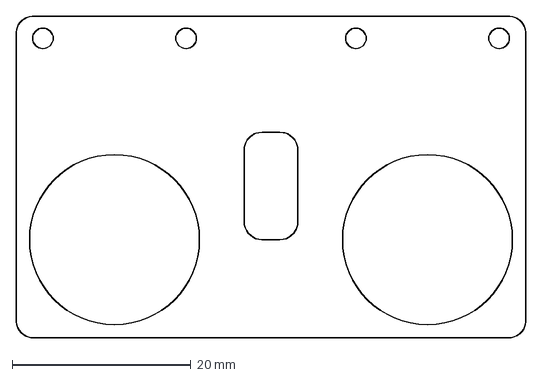
[picture p9: CAD file, 2026-10-29]
cad/plates/dynamixel/trunk_base.dxf
57.0 x 36.0 mm
