lsk0522/microduck/cad/redesign/dynamixel/v1.0/mjcf/assets/neck.stl

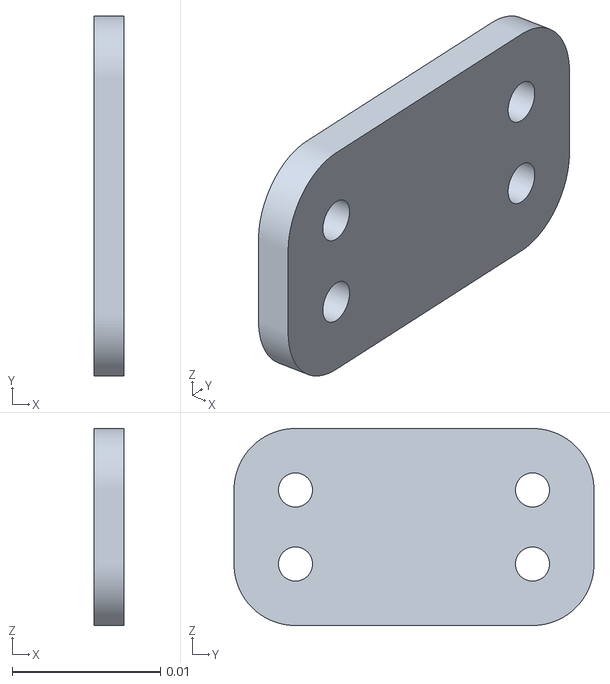
[picture p10: CAD file, 2026-11-09]
cad/redesign/dynamixel/v1.0/mjcf/assets/neck.stl
0.002 x 0.0243 x 0.0133
