lsk0522/microduck/cad/redesign/dynamixel/v1.0/parts/ankle_left/ankle_left.step

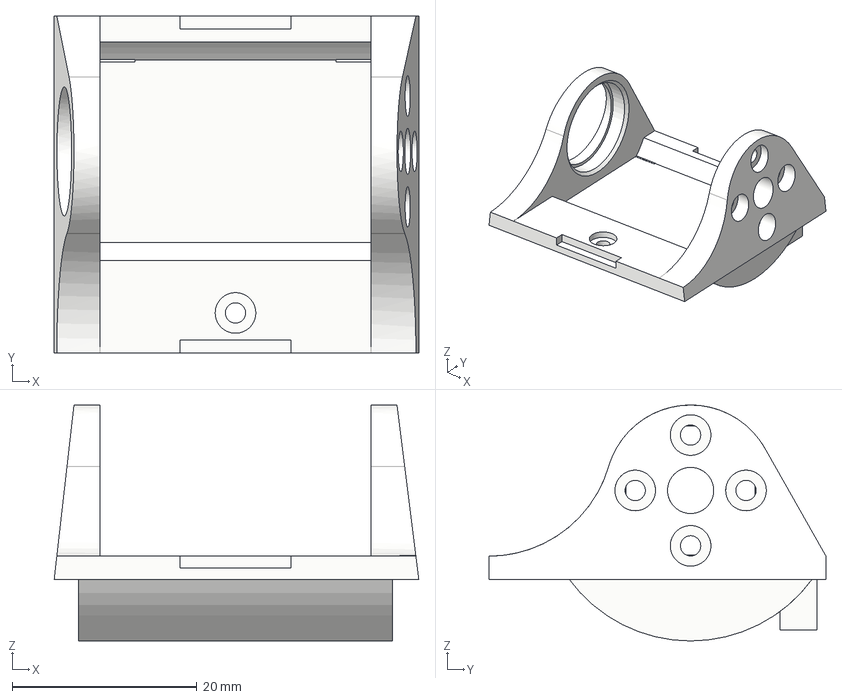
[picture p11: CAD file, 2026-11-02]
cad/redesign/dynamixel/v1.0/parts/ankle_left/ankle_left.step
39.5 x 36.5 x 25.6 mm
