lsk0522/microduck/cad/redesign/dynamixel/v1.0/parts/banana_pcb_locker/banana_pcb_locker.step

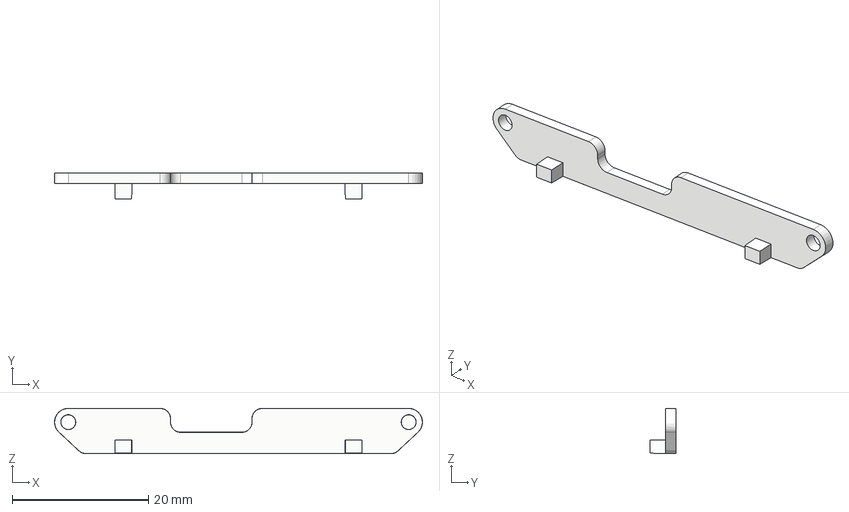
[picture p12: CAD file, 2026-11-08]
cad/redesign/dynamixel/v1.0/parts/banana_pcb_locker/banana_pcb_locker.step
54.1 x 3.80 x 6.65 mm
