lsk0522/microduck/cad/redesign/dynamixel/v1.0/parts/bearing_10x15x3/bearing_10x15x3.step

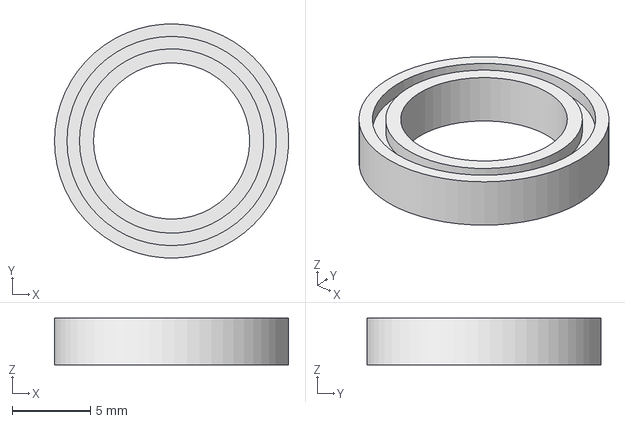
[picture p13: CAD file, 2026-10-30]
cad/redesign/dynamixel/v1.0/parts/bearing_10x15x3/bearing_10x15x3.step
15.0 x 15.0 x 3.00 mm
