lsk0522/microduck/cad/redesign/dynamixel/v1.0/parts/bearing_16x22x4/bearing_16x22x4.step

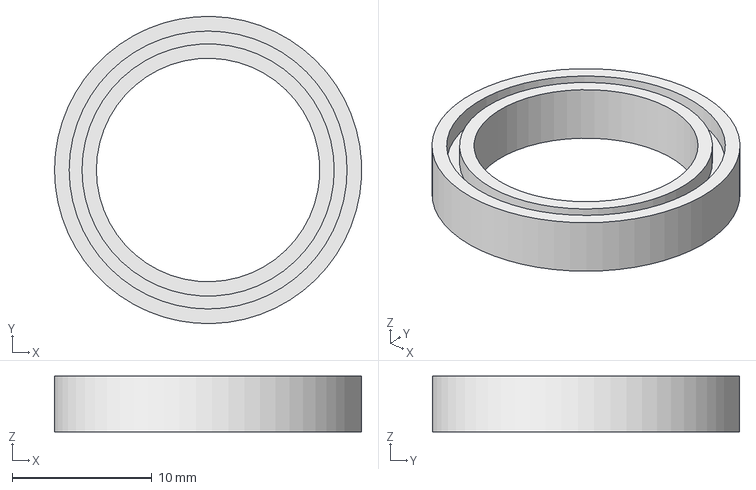
[picture p14: CAD file, 2026-10-30]
cad/redesign/dynamixel/v1.0/parts/bearing_16x22x4/bearing_16x22x4.step
22.0 x 22.0 x 4.00 mm
