lsk0522/microduck/cad/redesign/dynamixel/v1.0/parts/bearing_roll/bearing_roll.step

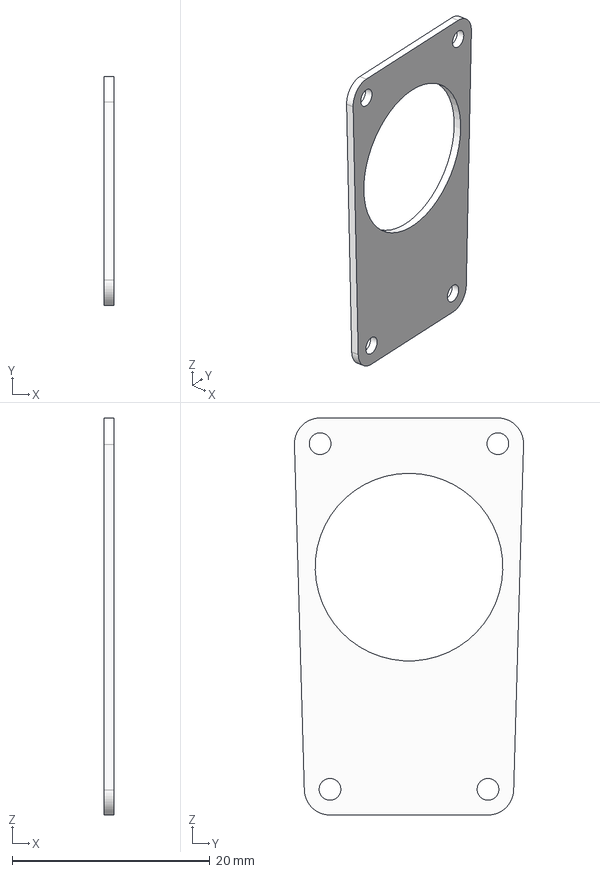
[picture p15: CAD file, 2026-10-30]
cad/redesign/dynamixel/v1.0/parts/bearing_roll/bearing_roll.step
1.00 x 23.2 x 40.2 mm
