lsk0522/microduck/cad/redesign/dynamixel/v1.0/parts/bottom_head_shell/bottom_head_shell.step

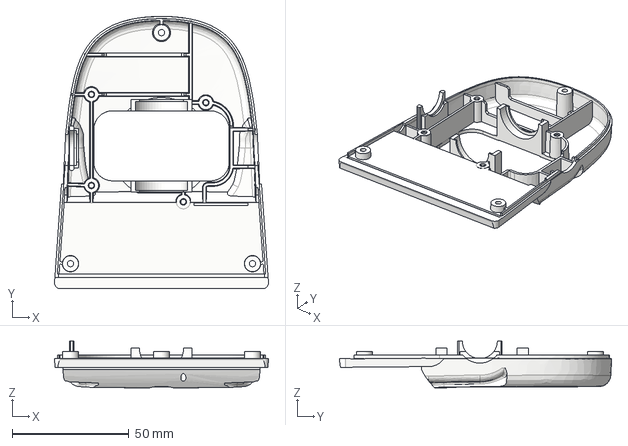
[picture p16: CAD file, 2026-11-09]
cad/redesign/dynamixel/v1.0/parts/bottom_head_shell/bottom_head_shell.step
91.7 x 116.7 x 20.1 mm
