lsk0522/microduck/cad/redesign/dynamixel/v1.0/parts/elec_rpi_robot_hat_pcb/elec_rpi_robot_hat_pcb.step

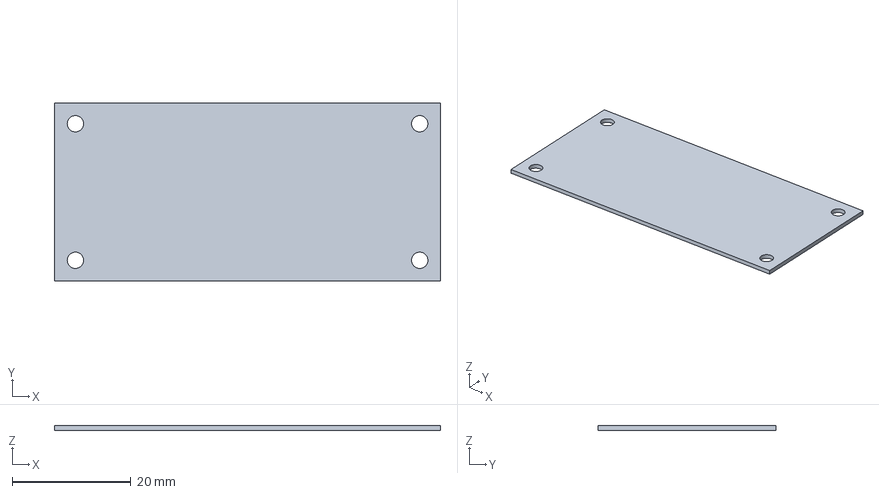
[picture p17: CAD file, 2026-10-30]
cad/redesign/dynamixel/v1.0/parts/elec_rpi_robot_hat_pcb/elec_rpi_robot_hat_pcb.step
65.0 x 30.0 x 0.84 mm
