lsk0522/microduck/cad/redesign/dynamixel/v1.0/parts/face_part/face_part.step

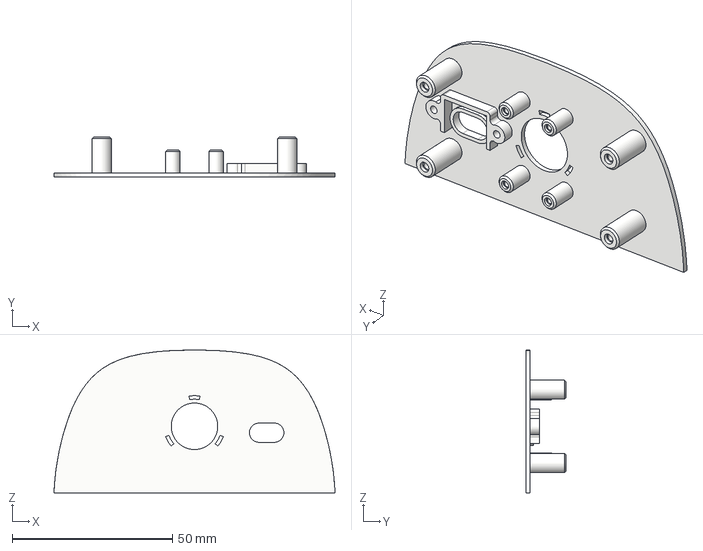
[picture p18: CAD file, 2026-11-02]
cad/redesign/dynamixel/v1.0/parts/face_part/face_part.step
87.6 x 12.5 x 44.6 mm
