lsk0522/microduck/cad/redesign/dynamixel/v1.0/parts/foot_left/foot_left.step

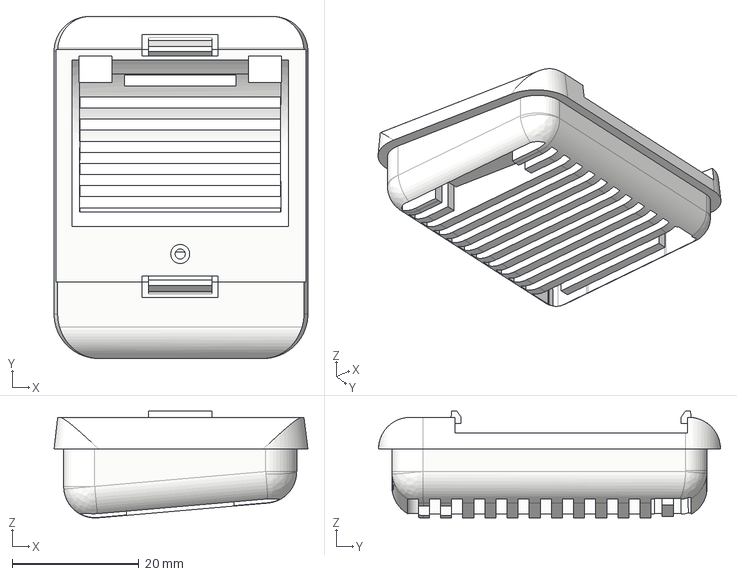
[picture p19: CAD file, 2026-11-02]
cad/redesign/dynamixel/v1.0/parts/foot_left/foot_left.step
40.1 x 54.0 x 16.9 mm
