lsk0522/microduck/cad/redesign/dynamixel/v1.0/parts/hip_l/hip_l.step

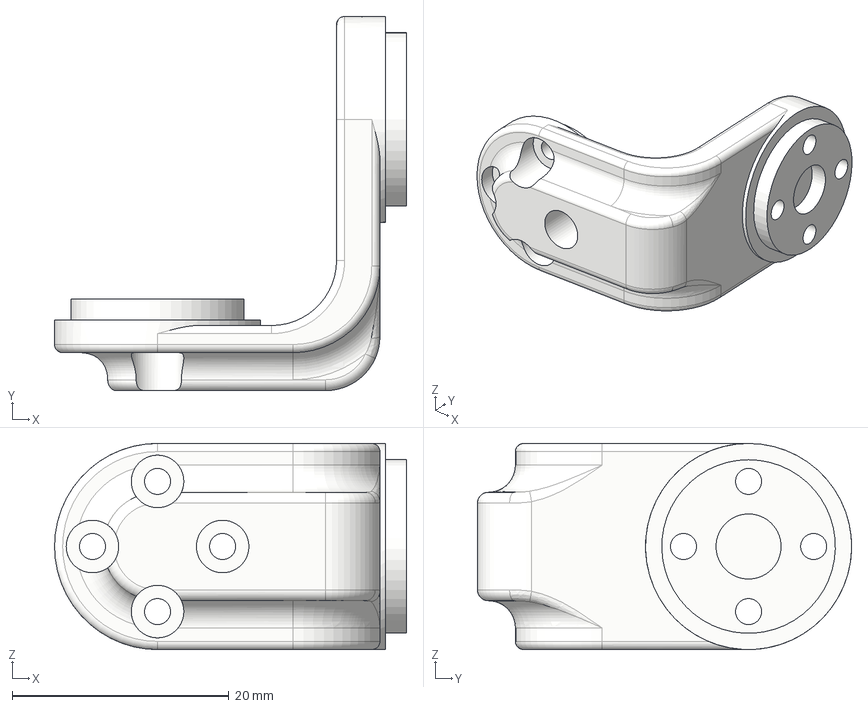
[picture p20: CAD file, 2026-11-02]
cad/redesign/dynamixel/v1.0/parts/hip_l/hip_l.step
32.5 x 34.5 x 19.0 mm
