lsk0522/microduck/cad/redesign/dynamixel/v1.0/parts/jaw/jaw.step

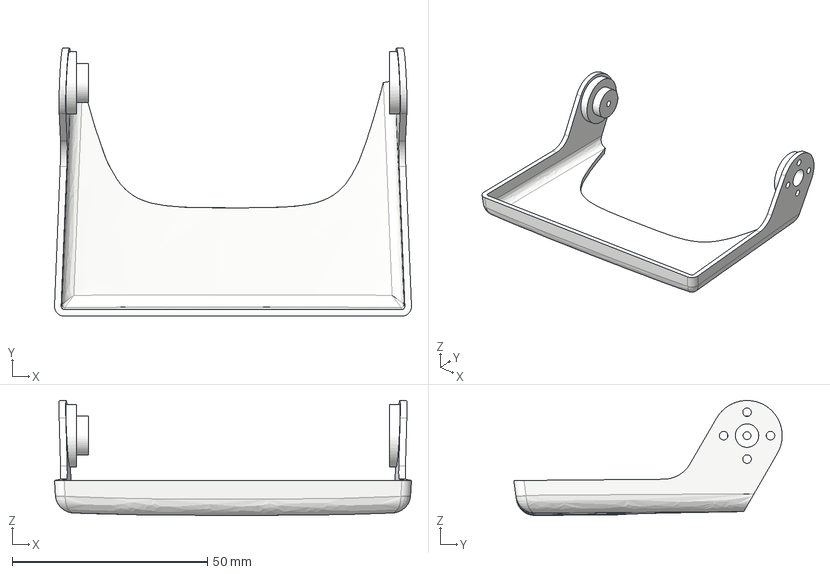
[picture p21: CAD file, 2026-11-02]
cad/redesign/dynamixel/v1.0/parts/jaw/jaw.step
91.4 x 68.7 x 29.4 mm
