lsk0522/microduck/cad/redesign/dynamixel/v1.0/parts/jaw_soft/jaw_soft.step

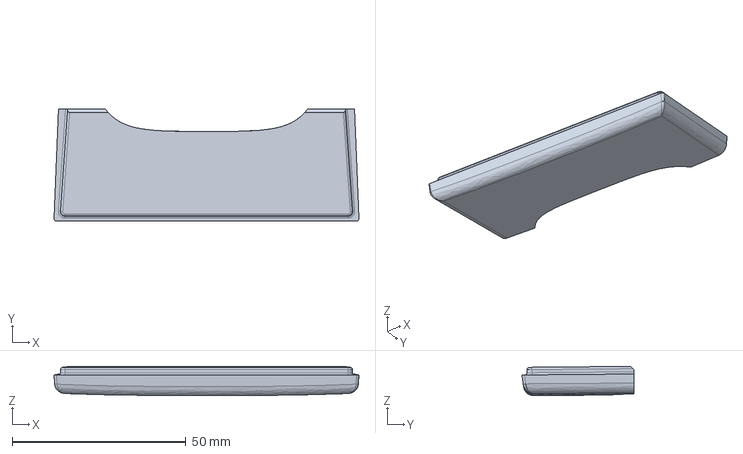
[picture p22: CAD file, 2026-11-02]
cad/redesign/dynamixel/v1.0/parts/jaw_soft/jaw_soft.step
87.7 x 32.2 x 8.40 mm
