lsk0522/microduck/cad/redesign/dynamixel/v1.0/parts/left_shell/left_shell.step

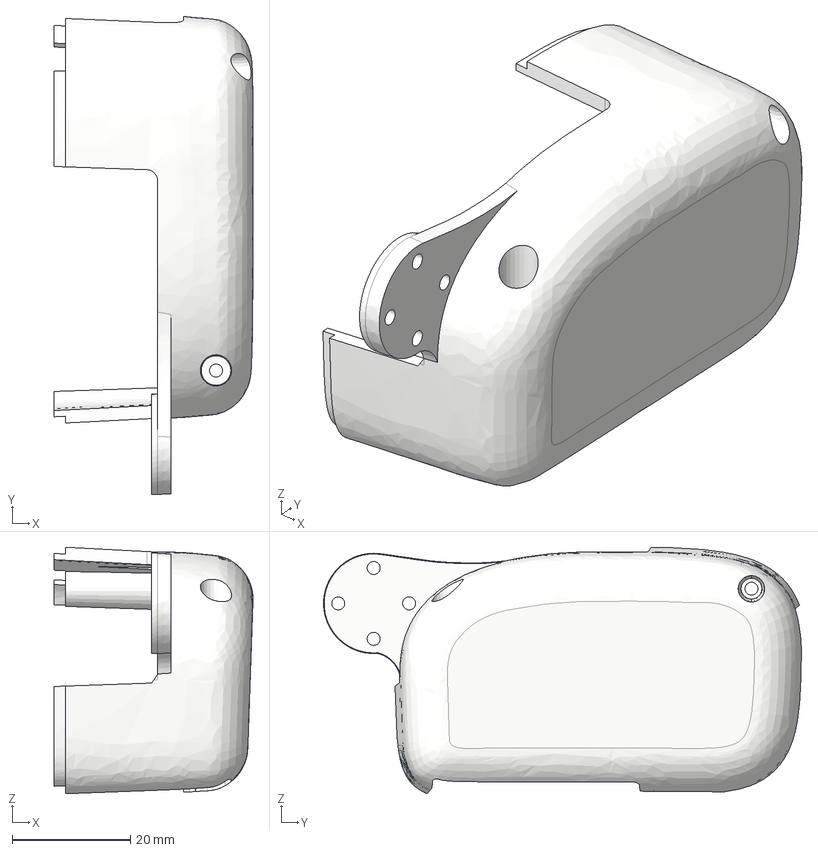
[picture p23: CAD file, 2026-11-03]
cad/redesign/dynamixel/v1.0/parts/left_shell/left_shell.step
33.7 x 81.0 x 41.8 mm
