lsk0522/microduck/cad/redesign/dynamixel/v1.0/parts/leg/leg.step

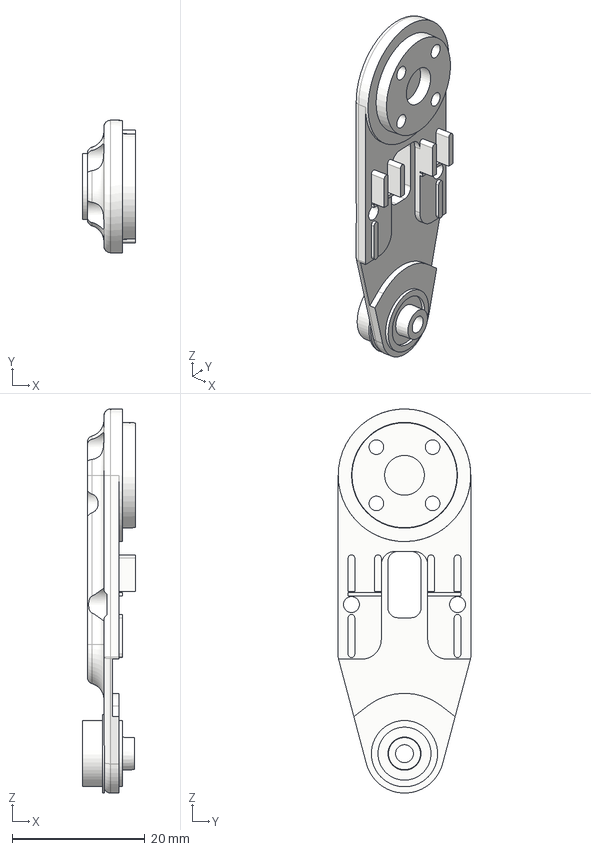
[picture p24: CAD file, 2026-11-02]
cad/redesign/dynamixel/v1.0/parts/leg/leg.step
7.95 x 20.0 x 57.9 mm
