lsk0522/microduck/cad/redesign/dynamixel/v1.0/parts/lens/lens.step

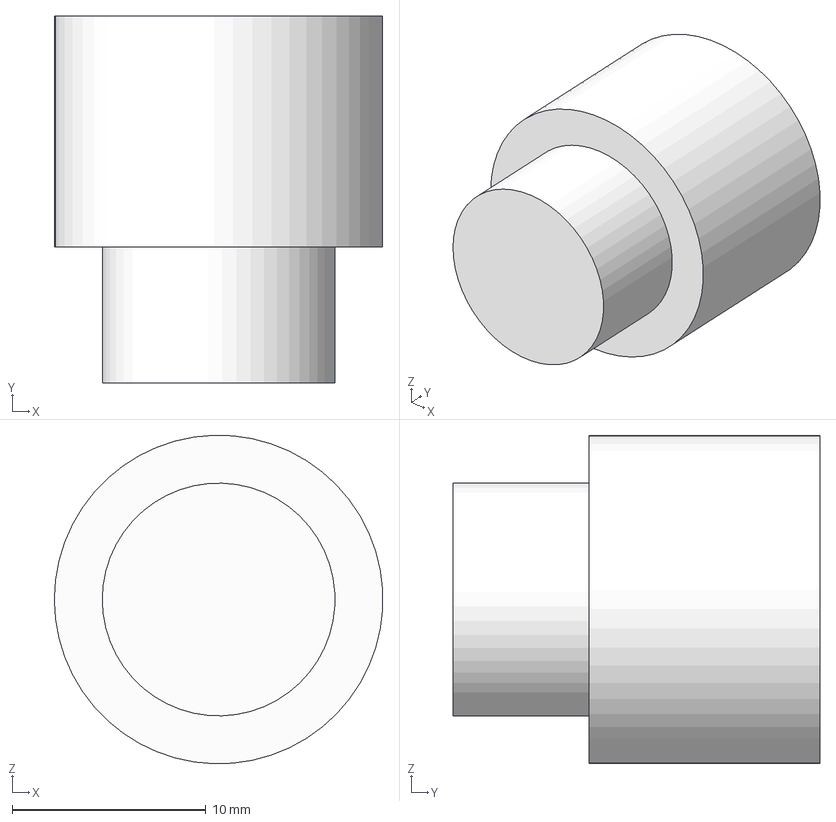
[picture p25: CAD file, 2026-10-30]
cad/redesign/dynamixel/v1.0/parts/lens/lens.step
16.9 x 18.9 x 16.9 mm
