lsk0522/microduck/cad/redesign/dynamixel/v1.0/parts/m12_lens_holder/m12_lens_holder.step

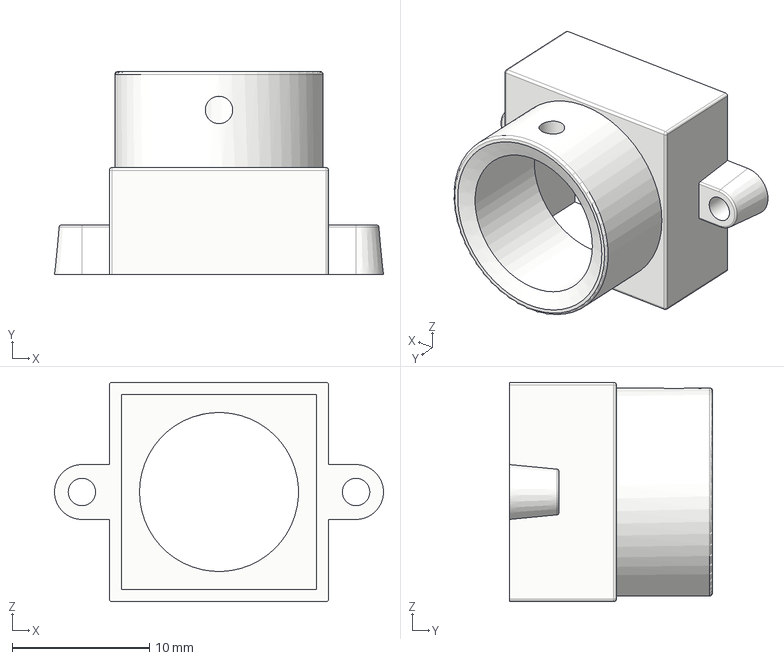
[picture p26: CAD file, 2026-11-02]
cad/redesign/dynamixel/v1.0/parts/m12_lens_holder/m12_lens_holder.step
24.0 x 14.8 x 16.0 mm
