lsk0522/microduck/cad/redesign/dynamixel/v1.0/parts/motor_support/motor_support.step

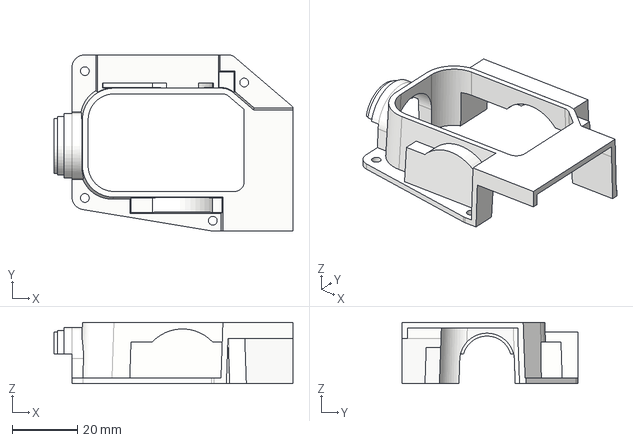
[picture p27: CAD file, 2026-11-02]
cad/redesign/dynamixel/v1.0/parts/motor_support/motor_support.step
73.5 x 54.2 x 18.8 mm
