lsk0522/microduck/cad/redesign/dynamixel/v1.0/parts/neck/neck.step

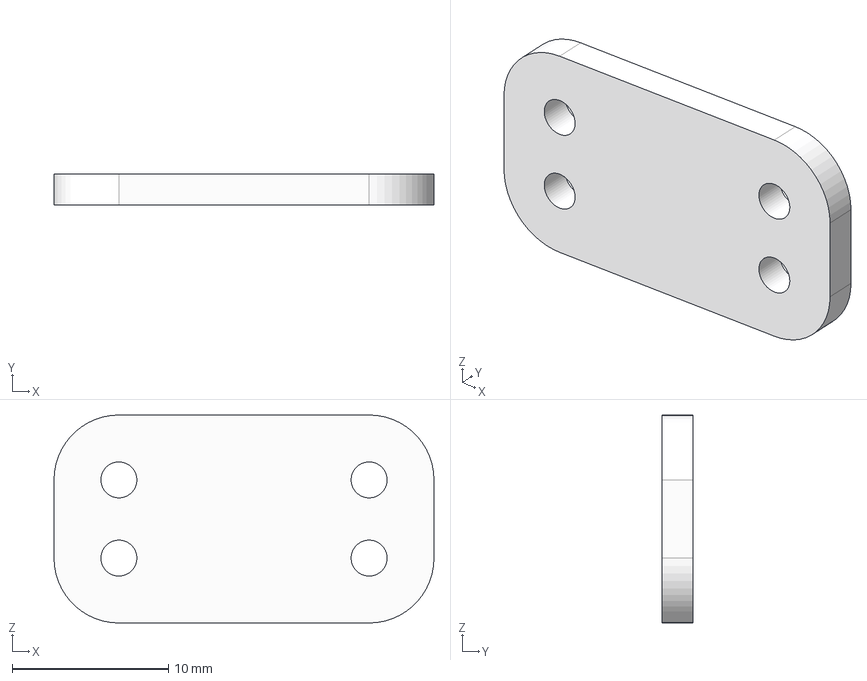
[picture p28: CAD file, 2026-10-30]
cad/redesign/dynamixel/v1.0/parts/neck/neck.step
24.3 x 2.00 x 13.3 mm
