lsk0522/microduck/cad/redesign/dynamixel/v1.0/parts/neck_pitch/neck_pitch.step

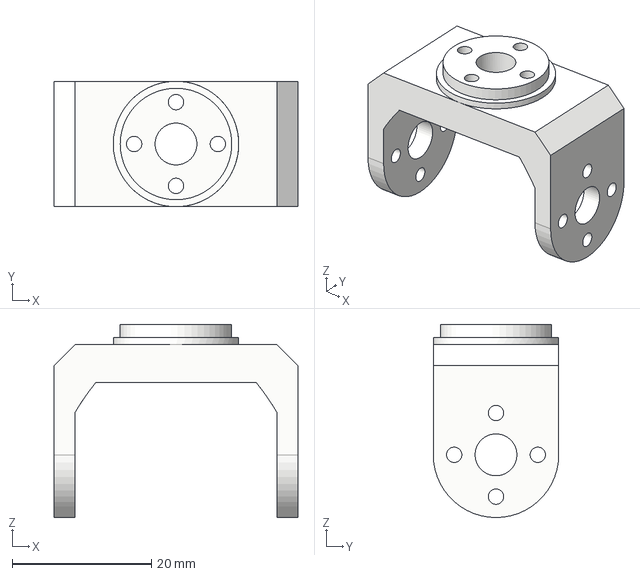
[picture p29: CAD file, 2026-11-01]
cad/redesign/dynamixel/v1.0/parts/neck_pitch/neck_pitch.step
35.0 x 18.0 x 27.7 mm
