lsk0522/microduck/cad/redesign/dynamixel/v1.0/parts/noenoeil/noenoeil.step

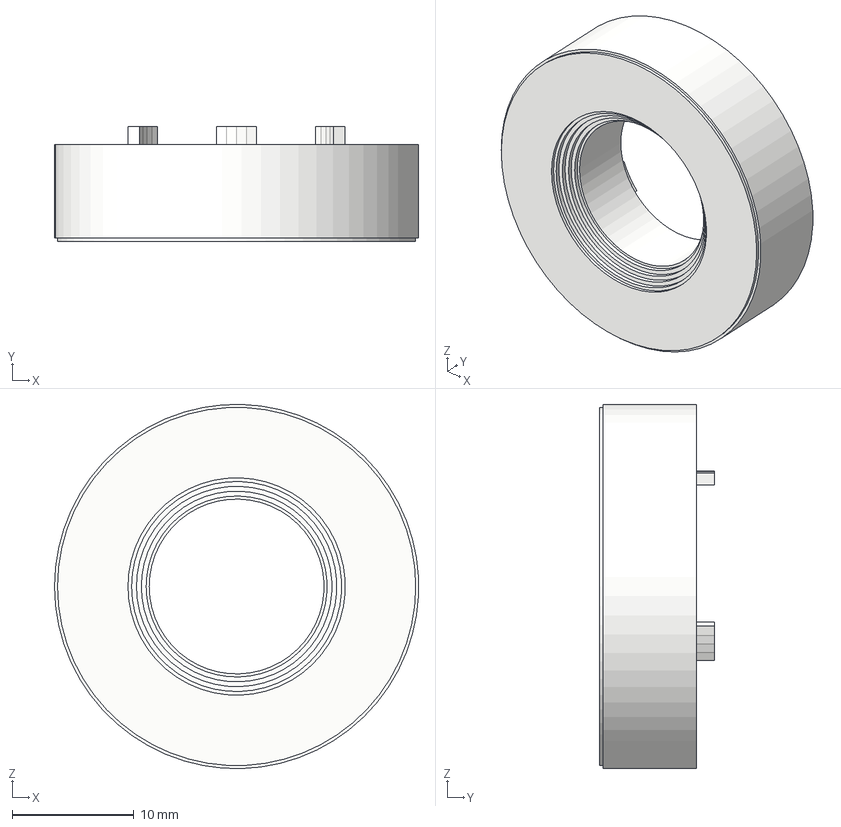
[picture p30: CAD file, 2026-10-30]
cad/redesign/dynamixel/v1.0/parts/noenoeil/noenoeil.step
30.0 x 9.50 x 30.0 mm
