lsk0522/microduck/cad/redesign/dynamixel/v1.0/parts/np_f970/np_f970.step

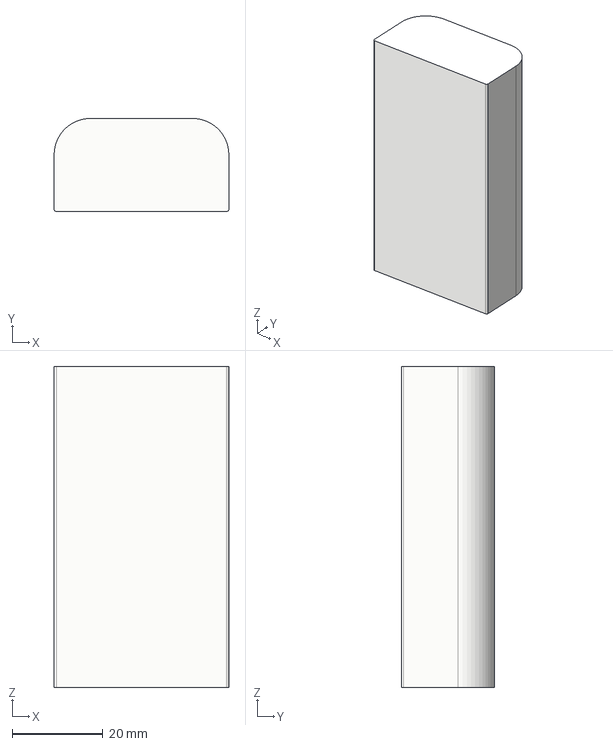
[picture p31: CAD file, 2026-10-30]
cad/redesign/dynamixel/v1.0/parts/np_f970/np_f970.step
38.5 x 20.5 x 70.7 mm
