lsk0522/microduck/cad/redesign/dynamixel/v1.0/parts/pcb__raspberry_pi_zero_2_w/pcb__raspberry_pi_zero_2_w.step

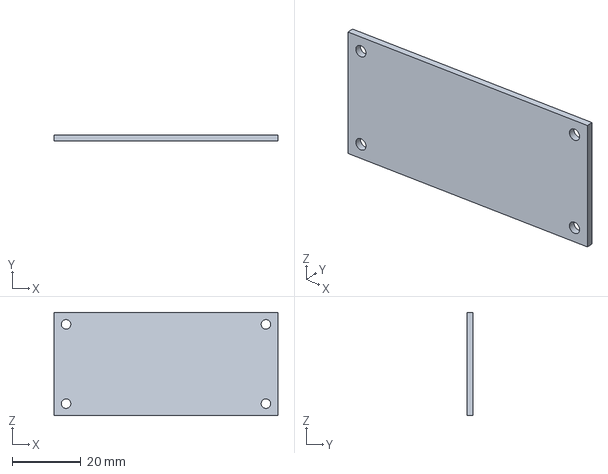
[picture p32: CAD file, 2026-10-30]
cad/redesign/dynamixel/v1.0/parts/pcb__raspberry_pi_zero_2_w/pcb__raspberry_pi_zero_2_w.step
65.0 x 1.60 x 30.0 mm
