lsk0522/microduck/cad/redesign/dynamixel/v1.0/parts/power_support/power_support.step

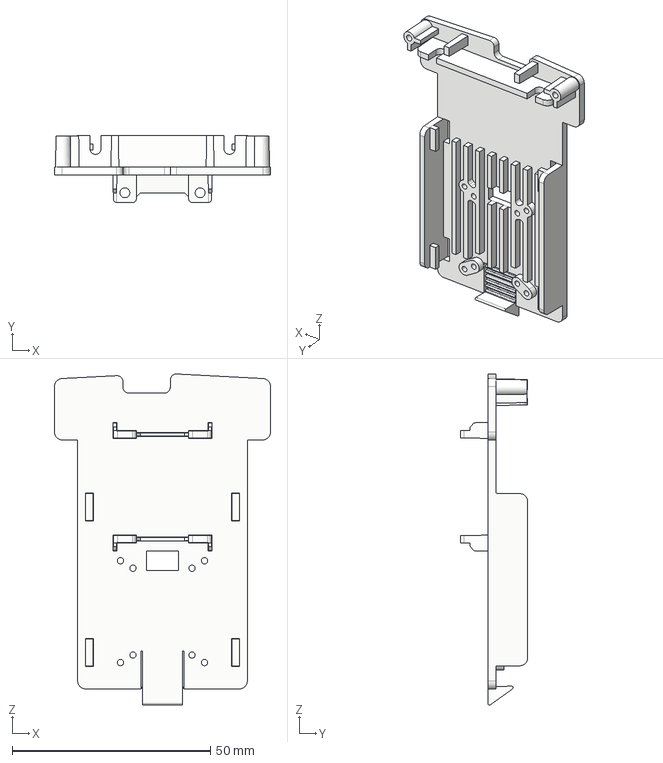
[picture p33: CAD file, 2026-11-02]
cad/redesign/dynamixel/v1.0/parts/power_support/power_support.step
54.5 x 17.0 x 83.5 mm
