lsk0522/microduck/cad/redesign/dynamixel/v1.0/parts/right_shell/right_shell.step

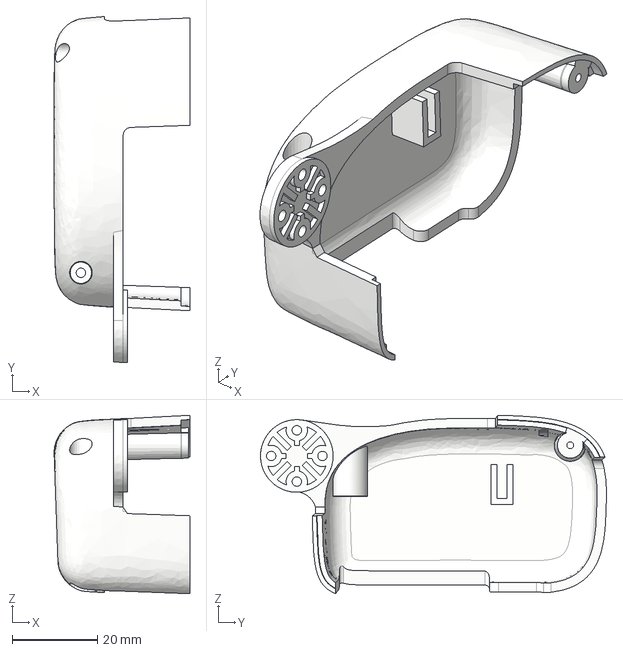
[picture p34: CAD file, 2026-11-03]
cad/redesign/dynamixel/v1.0/parts/right_shell/right_shell.step
31.8 x 81.0 x 41.8 mm
