lsk0522/microduck/cad/redesign/dynamixel/v1.0/parts/soft_mouth_top/soft_mouth_top.step

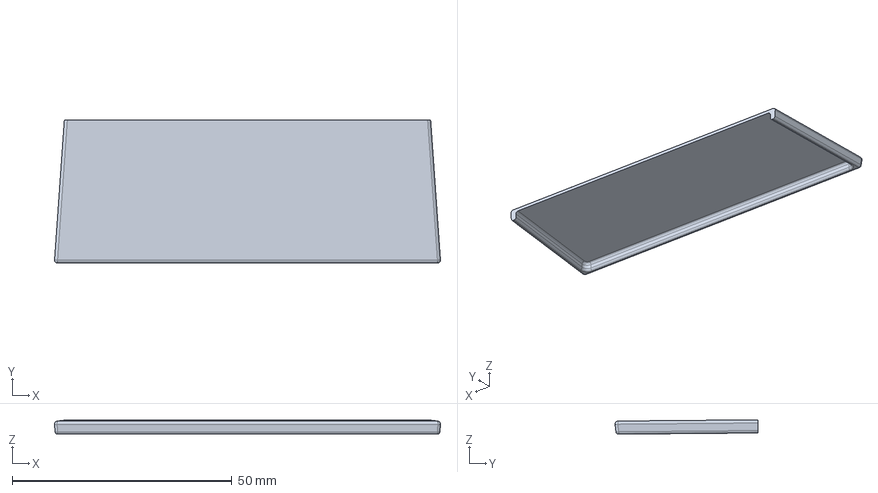
[picture p35: CAD file, 2026-11-02]
cad/redesign/dynamixel/v1.0/parts/soft_mouth_top/soft_mouth_top.step
87.8 x 32.6 x 3.28 mm
