lsk0522/microduck/cad/redesign/dynamixel/v1.0/parts/sole_left/sole_left.step

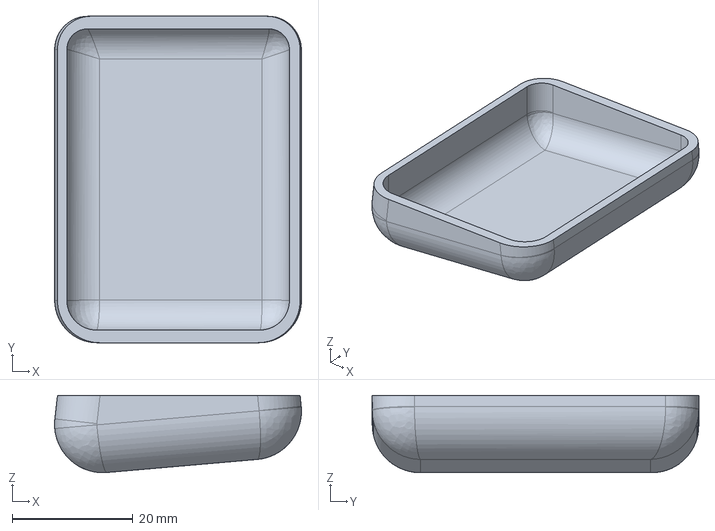
[picture p36: CAD file, 2026-11-02]
cad/redesign/dynamixel/v1.0/parts/sole_left/sole_left.step
40.8 x 54.0 x 12.8 mm
