lsk0522/microduck/cad/redesign/dynamixel/v1.0/parts/speaker/speaker.step

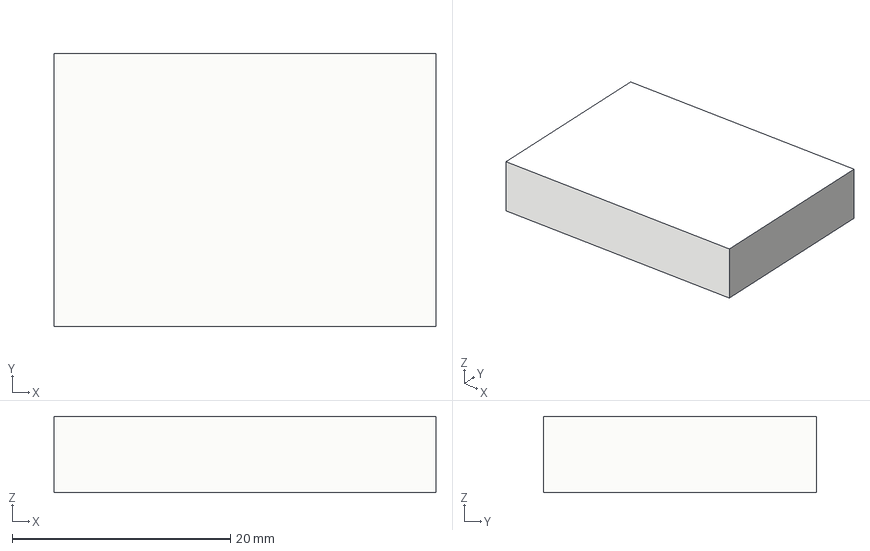
[picture p37: CAD file, 2026-10-30]
cad/redesign/dynamixel/v1.0/parts/speaker/speaker.step
35.0 x 25.0 x 7.00 mm
