lsk0522/microduck/cad/redesign/dynamixel/v1.0/parts/top_head_shell/top_head_shell.step

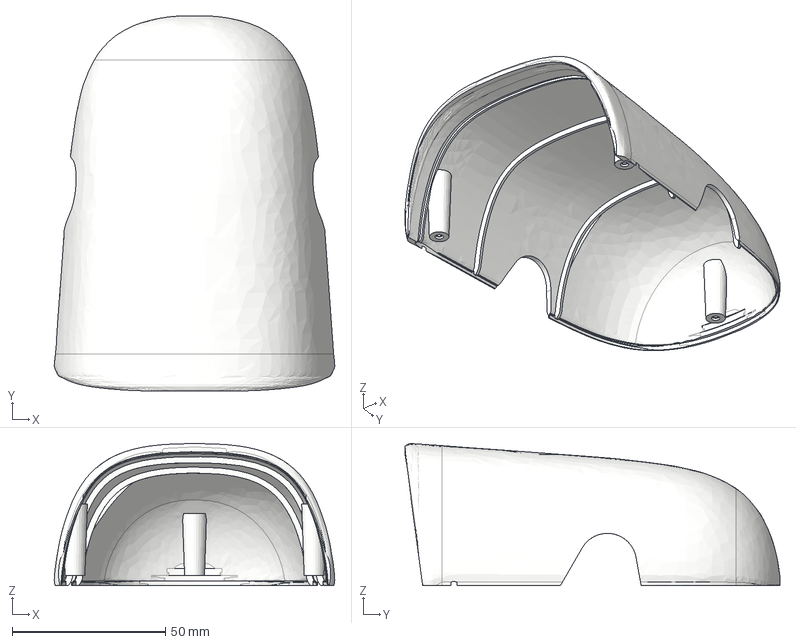
[picture p38: CAD file, 2026-11-09]
cad/redesign/dynamixel/v1.0/parts/top_head_shell/top_head_shell.step
91.5 x 122.3 x 46.3 mm
