lsk0522/microduck/cad/redesign/dynamixel/v1.0/parts/trunk_base/trunk_base.step

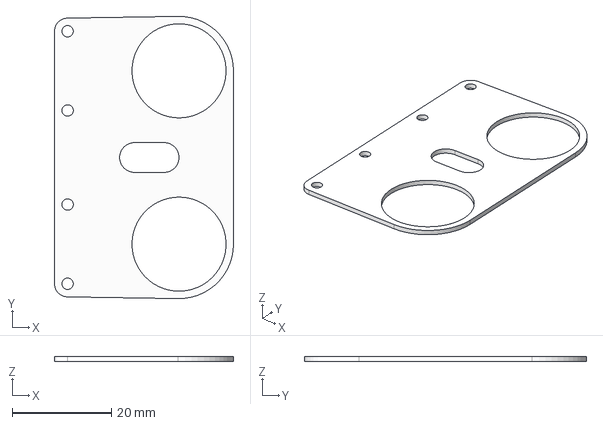
[picture p39: CAD file, 2026-10-30]
cad/redesign/dynamixel/v1.0/parts/trunk_base/trunk_base.step
36.1 x 57.0 x 1.00 mm
