lsk0522/microduck/cad/redesign/dynamixel/v1.0/parts/upper_leg_left/upper_leg_left.step

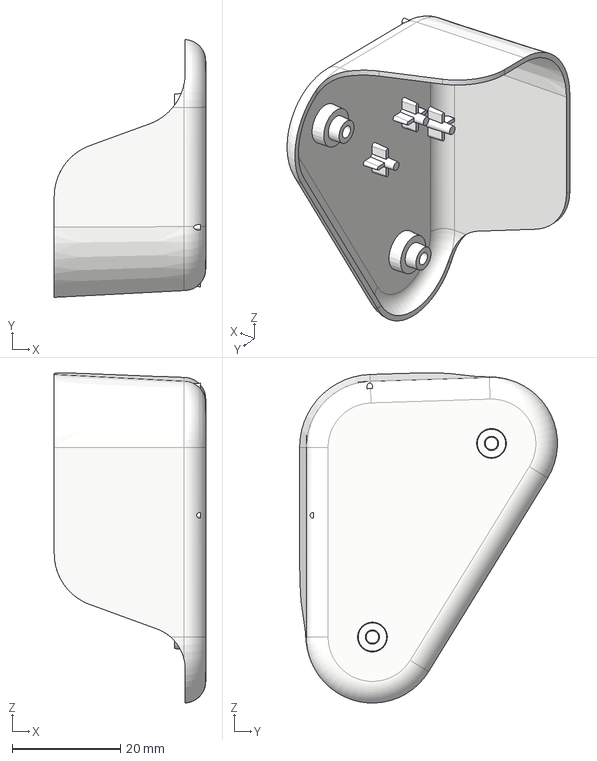
[picture p40: CAD file, 2026-11-02]
cad/redesign/dynamixel/v1.0/parts/upper_leg_left/upper_leg_left.step
28.0 x 47.6 x 61.0 mm
