lsk0522/microduck/cad/redesign/dynamixel/v1.0/parts/upper_leg_rigidity_plate/upper_leg_rigidity_plate.step

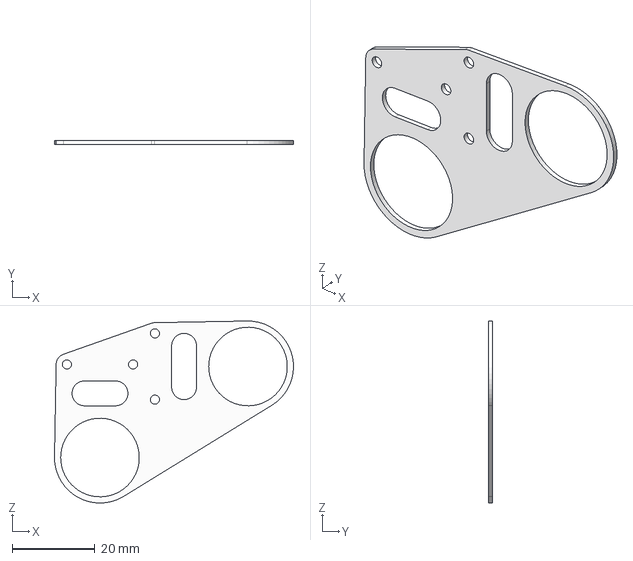
[picture p41: CAD file, 2026-10-31]
cad/redesign/dynamixel/v1.0/parts/upper_leg_rigidity_plate/upper_leg_rigidity_plate.step
57.8 x 1.00 x 44.0 mm
