lsk0522/microduck/cad/redesign/dynamixel/v1.0/parts/xl330/xl330.step

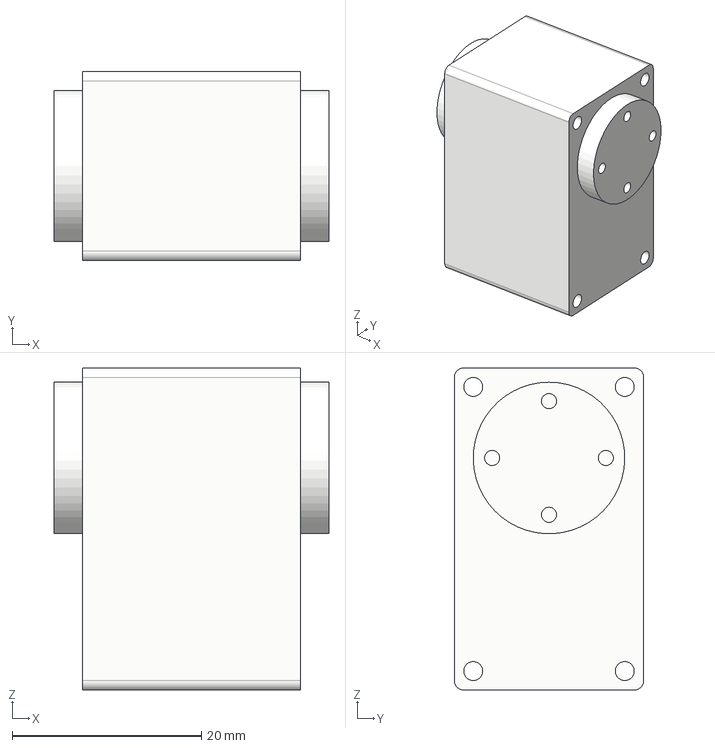
[picture p42: CAD file, 2026-10-30]
cad/redesign/dynamixel/v1.0/parts/xl330/xl330.step
29.0 x 20.0 x 34.0 mm
