lsk0522/microduck/cad/redesign/dynamixel/v1.0/parts/yaw2roll/yaw2roll.step

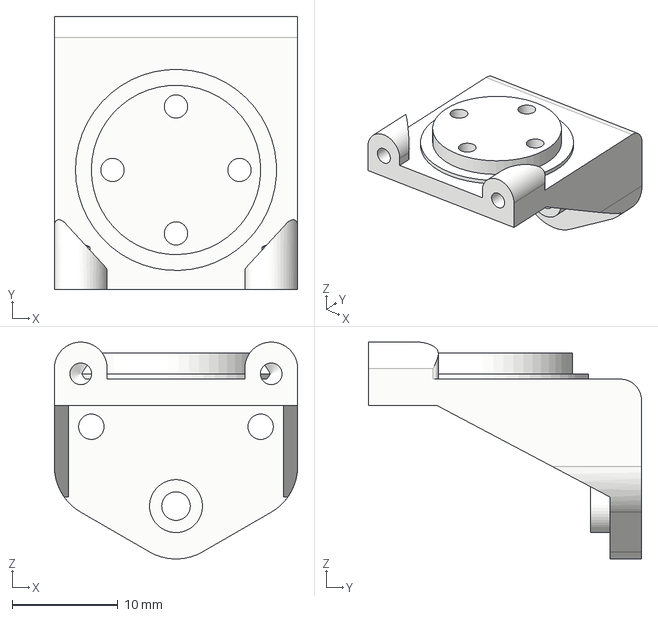
[picture p43: CAD file, 2026-11-02]
cad/redesign/dynamixel/v1.0/parts/yaw2roll/yaw2roll.step
23.0 x 25.8 x 20.5 mm
