lsk0522/microduck/cad/redesign/dynamixel/v1.0/parts/yaw_roll_motion/yaw_roll_motion.step

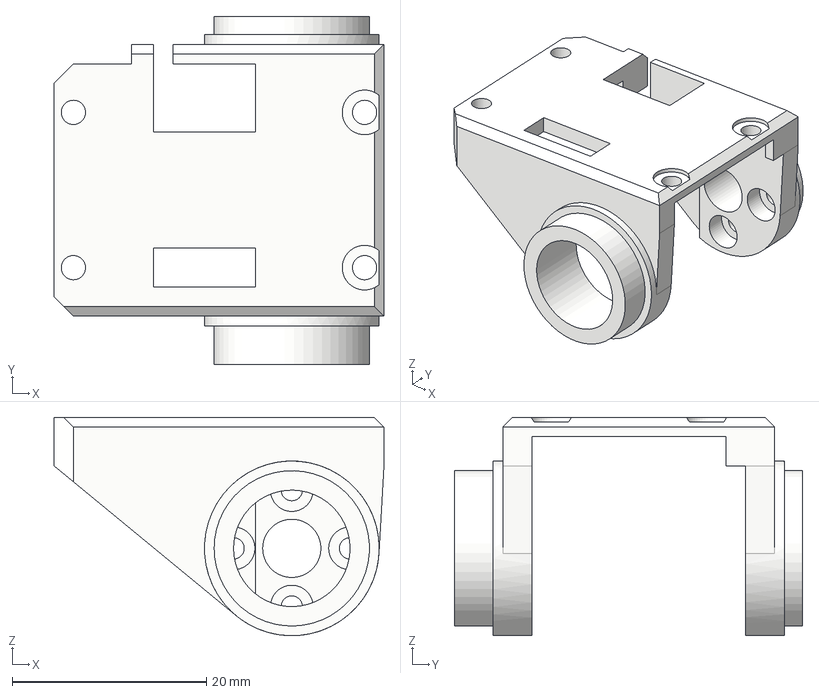
[picture p44: CAD file, 2026-11-08]
cad/redesign/dynamixel/v1.0/parts/yaw_roll_motion/yaw_roll_motion.step
34.0 x 35.9 x 22.5 mm
