lsk0522/microduck/cad/redesign/hobby_servo/v1.0/mjcf/assets/bearing_6704_head_yaw.stl

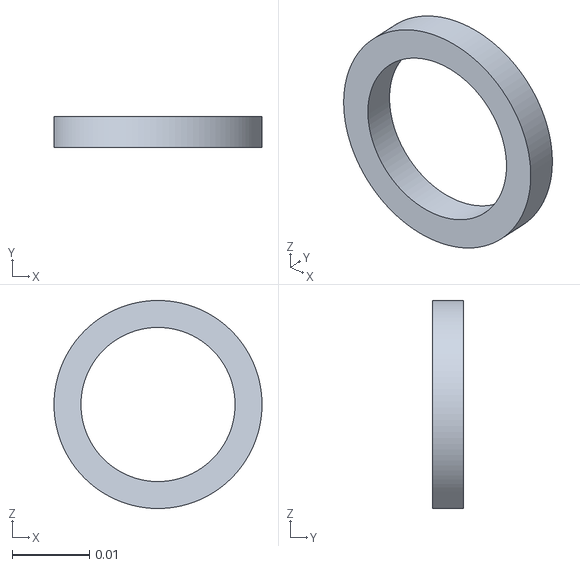
[picture p45: CAD file, 2026-10-31]
cad/redesign/hobby_servo/v1.0/mjcf/assets/bearing_6704_head_yaw.stl
0.027 x 0.004 x 0.027
