lsk0522/microduck/cad/redesign/hobby_servo/v1.0/parts/6704ZZ/6704ZZ.step

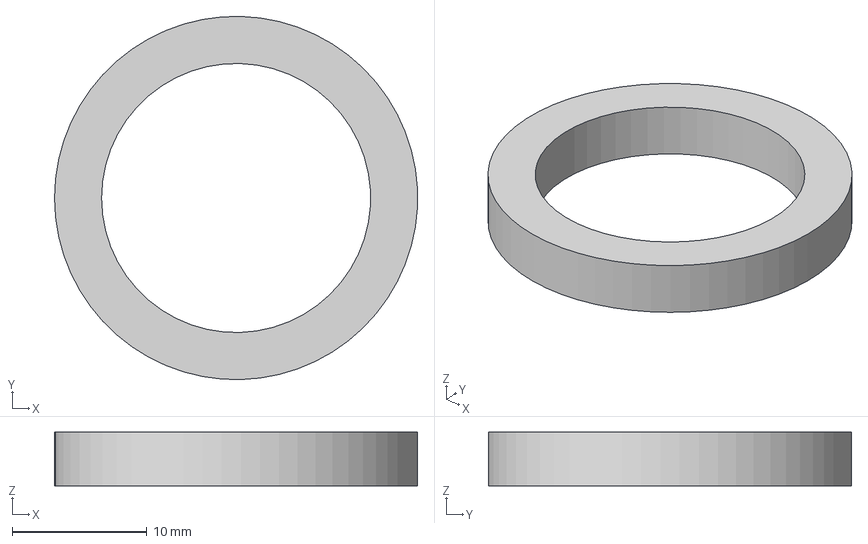
[picture p46: CAD file, 2026-10-31]
cad/redesign/hobby_servo/v1.0/parts/6704ZZ/6704ZZ.step
27.0 x 27.0 x 4.00 mm
