lsk0522/microduck/cad/redesign/hobby_servo/v1.0/parts/ankle_left/ankle_left.step

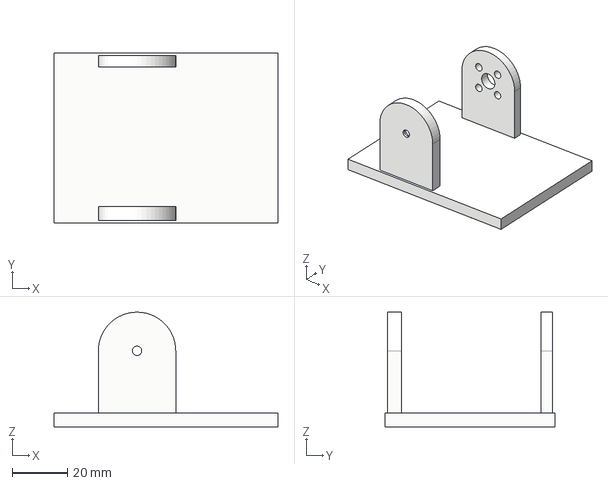
[picture p47: CAD file, 2026-10-31]
cad/redesign/hobby_servo/v1.0/parts/ankle_left/ankle_left.step
81.0 x 61.6 x 41.5 mm
