lsk0522/microduck/cad/redesign/hobby_servo/v1.0/parts/battery_tray/battery_tray.step

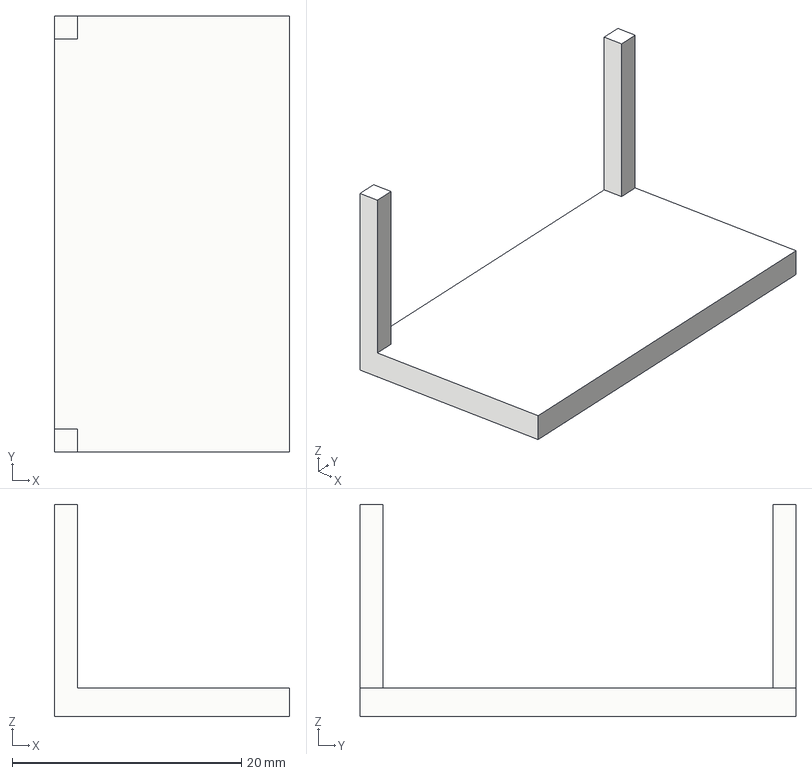
[picture p48: CAD file, 2026-10-31]
cad/redesign/hobby_servo/v1.0/parts/battery_tray/battery_tray.step
20.5 x 38.0 x 18.5 mm
