lsk0522/microduck/cad/redesign/hobby_servo/v1.0/parts/horn_20T_metal/horn_20T_metal.step

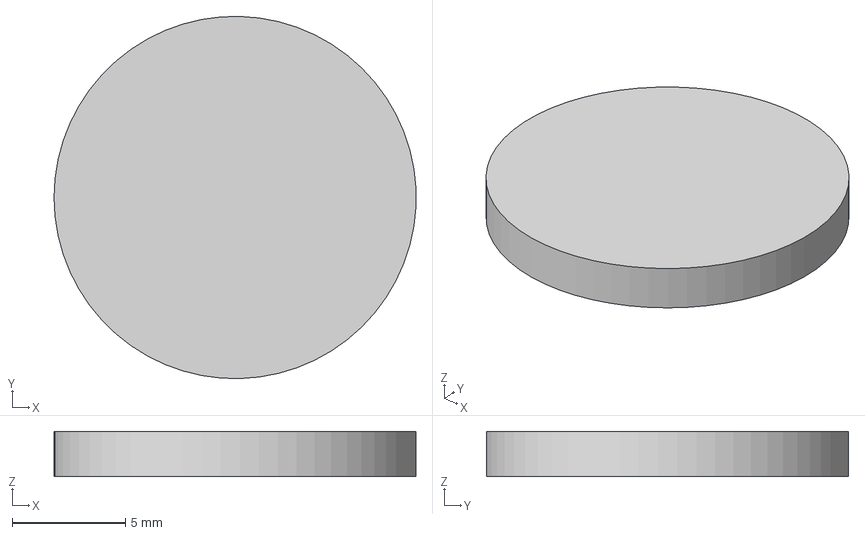
[picture p49: CAD file, 2026-10-31]
cad/redesign/hobby_servo/v1.0/parts/horn_20T_metal/horn_20T_metal.step
16.0 x 16.0 x 2.00 mm
