lsk0522/microduck/cad/redesign/hobby_servo/v1.0/parts/leg_left/leg_left.step

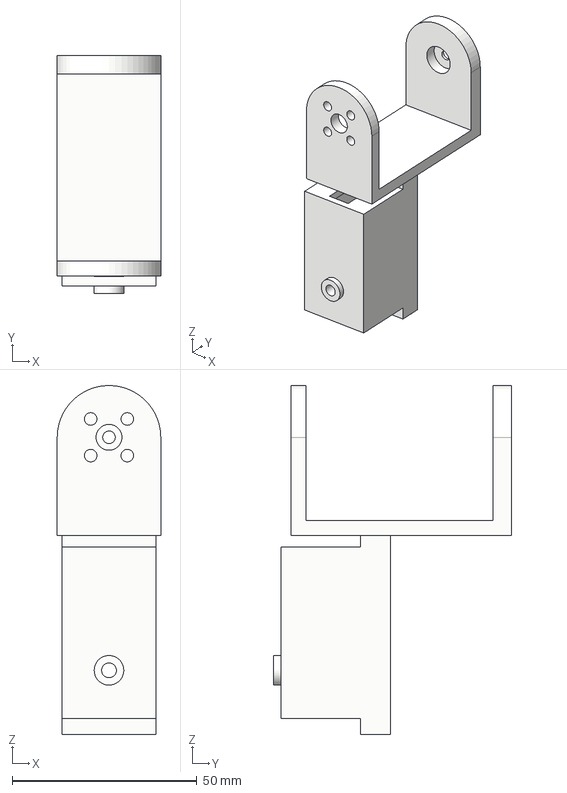
[picture p50: CAD file, 2026-10-31]
cad/redesign/hobby_servo/v1.0/parts/leg_left/leg_left.step
28.0 x 64.2 x 94.4 mm
