lsk0522/microduck/cad/redesign/hobby_servo/v1.0/parts/MG90S/MG90S.step

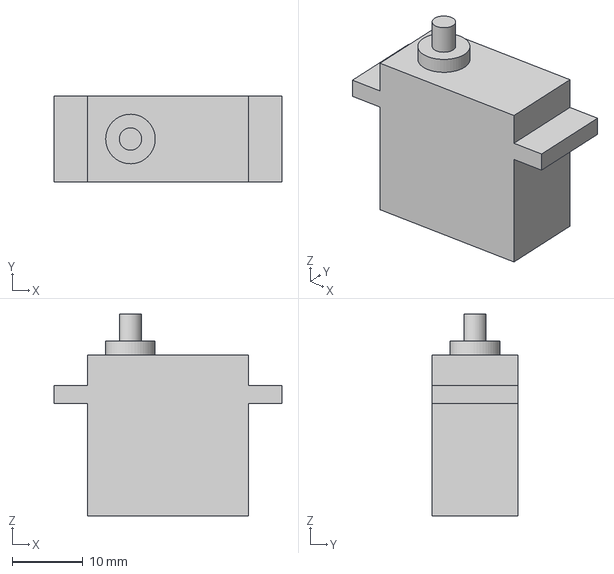
[picture p51: CAD file, 2026-10-31]
cad/redesign/hobby_servo/v1.0/parts/MG90S/MG90S.step
32.2 x 12.2 x 28.5 mm
