lsk0522/microduck/cad/redesign/hobby_servo/v1.0/parts/sole_right/sole_right.step

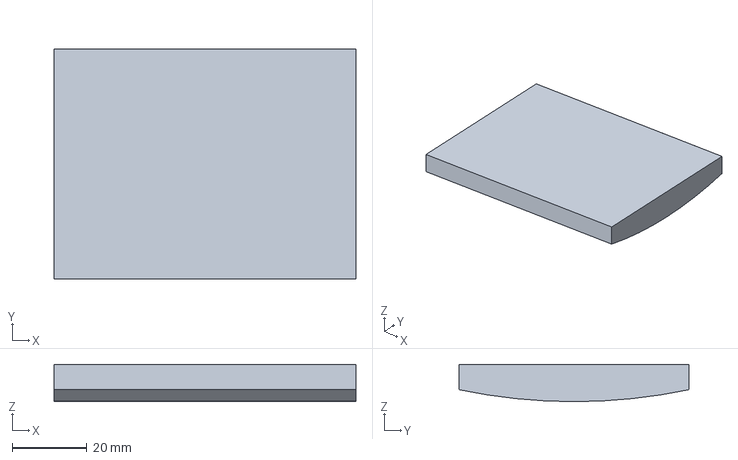
[picture p52: CAD file, 2026-10-31]
cad/redesign/hobby_servo/v1.0/parts/sole_right/sole_right.step
81.0 x 61.6 x 10.0 mm
