lsk0522/microduck/cad/redesign/hobby_servo/v1.0/parts/upper_leg_left/upper_leg_left.step

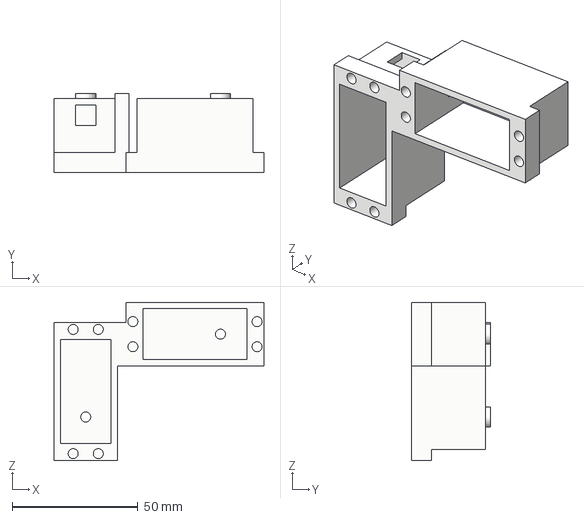
[picture p53: CAD file, 2026-10-31]
cad/redesign/hobby_servo/v1.0/parts/upper_leg_left/upper_leg_left.step
83.7 x 31.5 x 63.0 mm
