lsk0522/microduck/cad/redesign/mg996r/v1.0/mjcf/assets/mg996r_head_yaw.stl

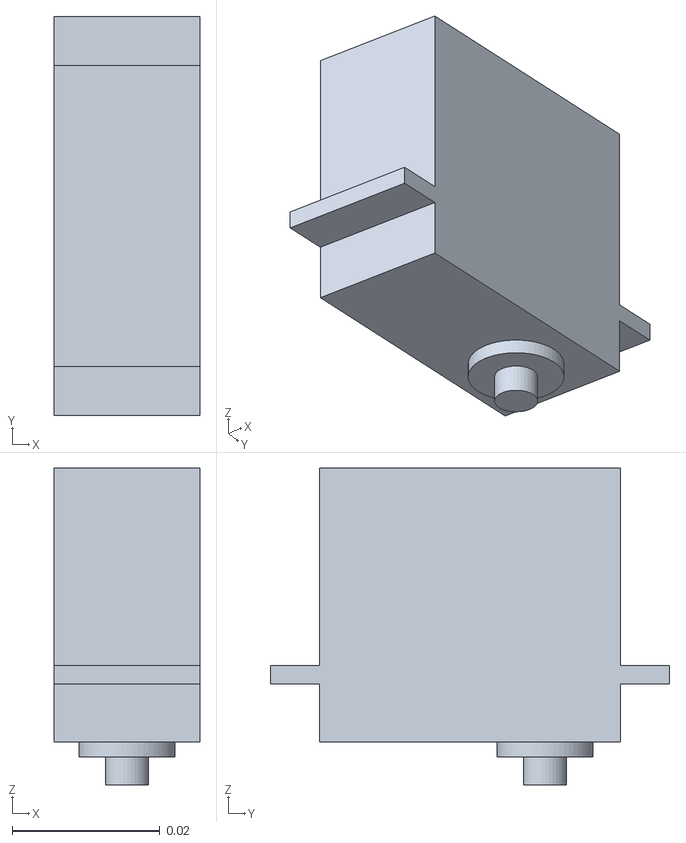
[picture p54: CAD file, 2026-10-31]
cad/redesign/mg996r/v1.0/mjcf/assets/mg996r_head_yaw.stl
0.0197 x 0.054 x 0.0429
