lsk0522/microduck/cad/redesign/mg996r/v1.0/parts/623ZZ/623ZZ.step

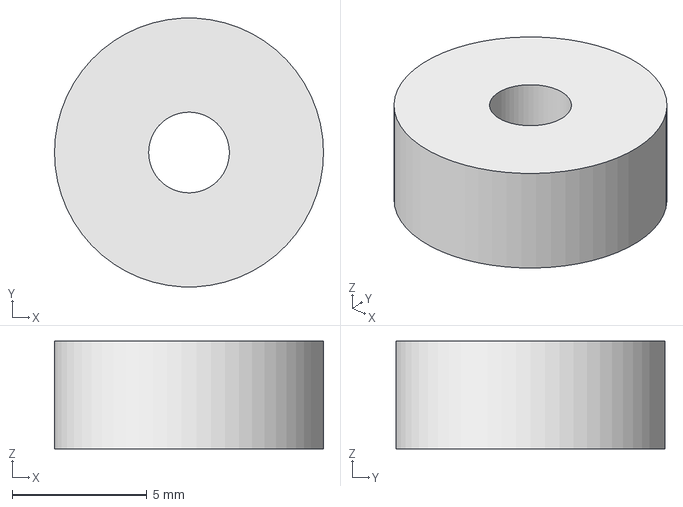
[picture p55: CAD file, 2026-10-31]
cad/redesign/mg996r/v1.0/parts/623ZZ/623ZZ.step
10.0 x 9.99 x 4.00 mm
