lsk0522/microduck/cad/redesign/mg996r/v1.0/parts/6706ZZ/6706ZZ.step

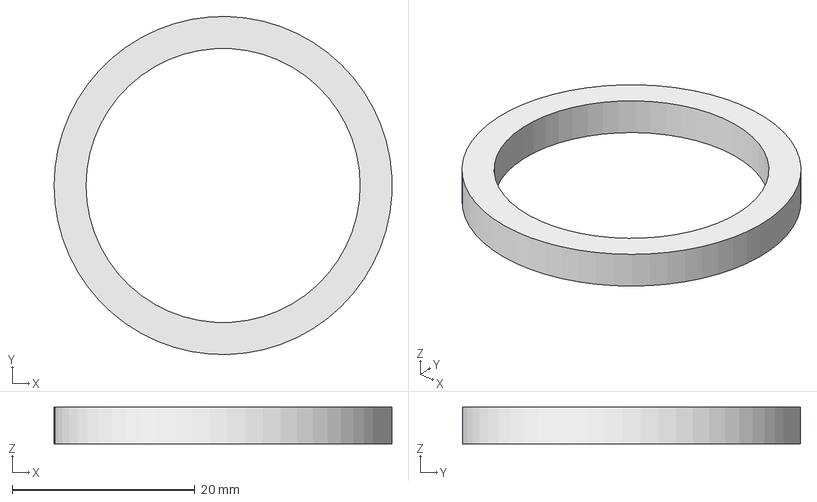
[picture p56: CAD file, 2026-10-31]
cad/redesign/mg996r/v1.0/parts/6706ZZ/6706ZZ.step
37.0 x 37.0 x 4.00 mm
