lsk0522/microduck/cad/redesign/mg996r/v1.0/parts/bottom_head_shell/bottom_head_shell.step

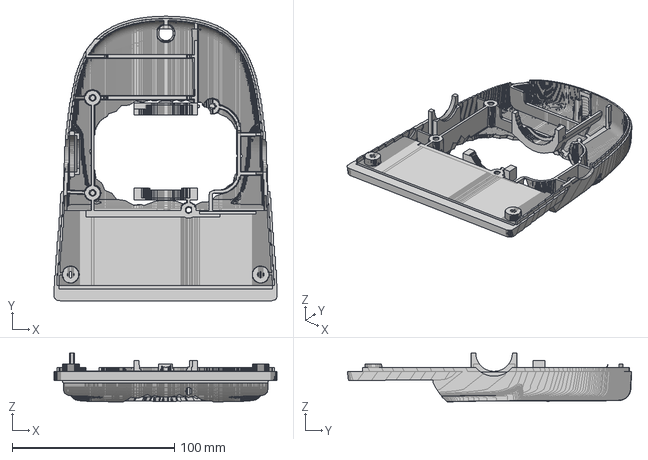
[picture p57: CAD file, 2026-10-31]
cad/redesign/mg996r/v1.0/parts/bottom_head_shell/bottom_head_shell.step
137.2 x 175.1 x 30.1 mm
