lsk0522/microduck/cad/redesign/mg996r/v1.0/parts/face_part/face_part.step

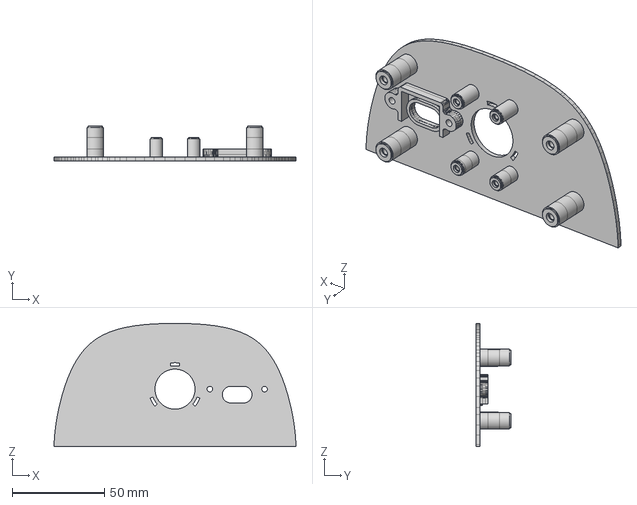
[picture p58: CAD file, 2026-10-31]
cad/redesign/mg996r/v1.0/parts/face_part/face_part.step
131.3 x 18.8 x 66.9 mm
