lsk0522/microduck/cad/redesign/mg996r/v1.0/parts/head_frame/head_frame.step

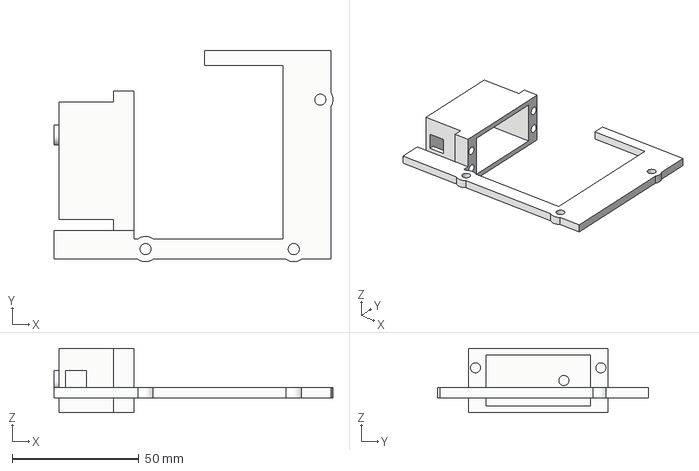
[picture p59: CAD file, 2026-10-31]
cad/redesign/mg996r/v1.0/parts/head_frame/head_frame.step
110.1 x 83.5 x 25.3 mm
