lsk0522/microduck/cad/redesign/mg996r/v1.0/parts/hip_l_left/hip_l_left.step

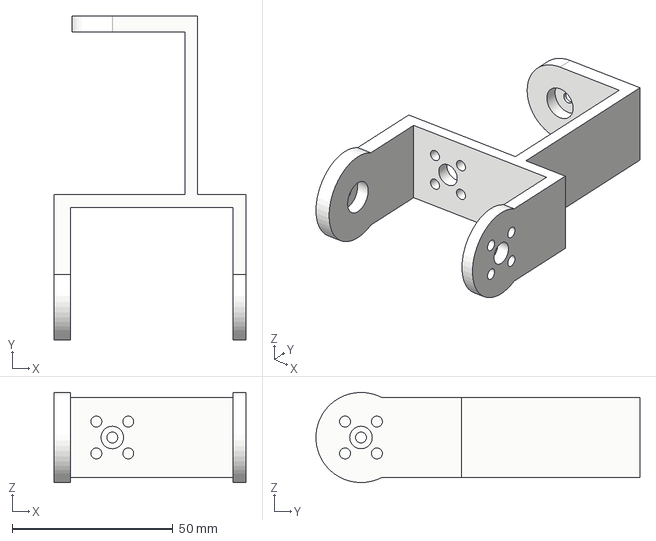
[picture p60: CAD file, 2026-10-31]
cad/redesign/mg996r/v1.0/parts/hip_l_left/hip_l_left.step
59.5 x 100.6 x 28.0 mm
