lsk0522/microduck/cad/redesign/mg996r/v1.0/parts/horn_25T_alu/horn_25T_alu.step

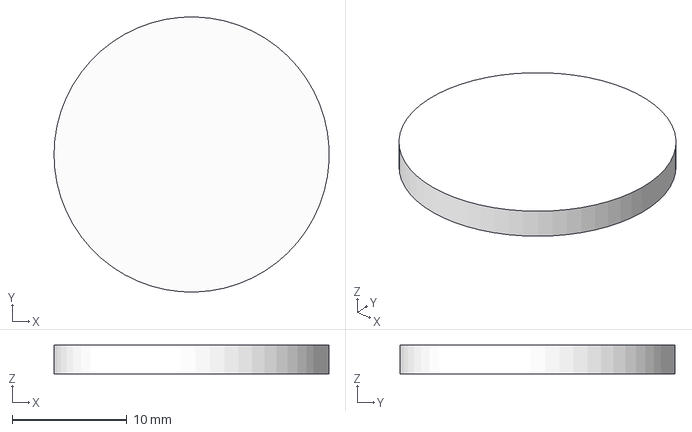
[picture p61: CAD file, 2026-10-31]
cad/redesign/mg996r/v1.0/parts/horn_25T_alu/horn_25T_alu.step
24.0 x 24.0 x 2.50 mm
