lsk0522/microduck/cad/redesign/mg996r/v1.0/parts/jaw/jaw.step

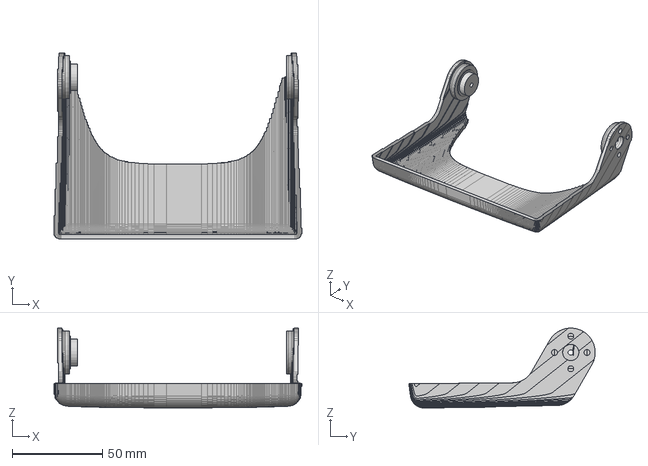
[picture p62: CAD file, 2026-10-31]
cad/redesign/mg996r/v1.0/parts/jaw/jaw.step
137.1 x 103.1 x 44.2 mm
