lsk0522/microduck/cad/redesign/mg996r/v1.0/parts/jaw_soft/jaw_soft.step

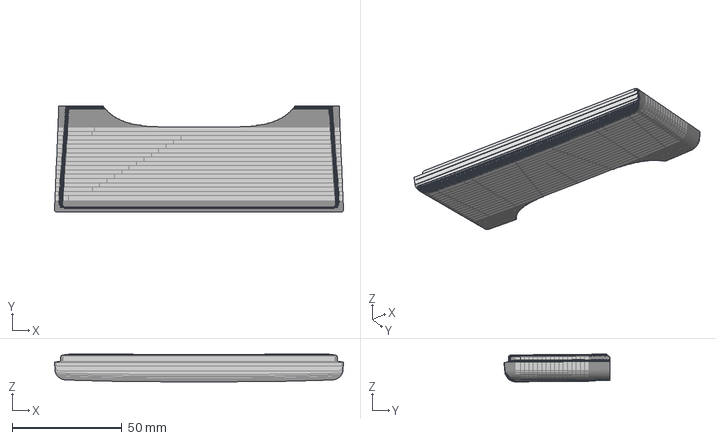
[picture p63: CAD file, 2026-10-31]
cad/redesign/mg996r/v1.0/parts/jaw_soft/jaw_soft.step
131.5 x 48.4 x 12.6 mm
