lsk0522/microduck/cad/redesign/mg996r/v1.0/parts/left_shell/left_shell.step

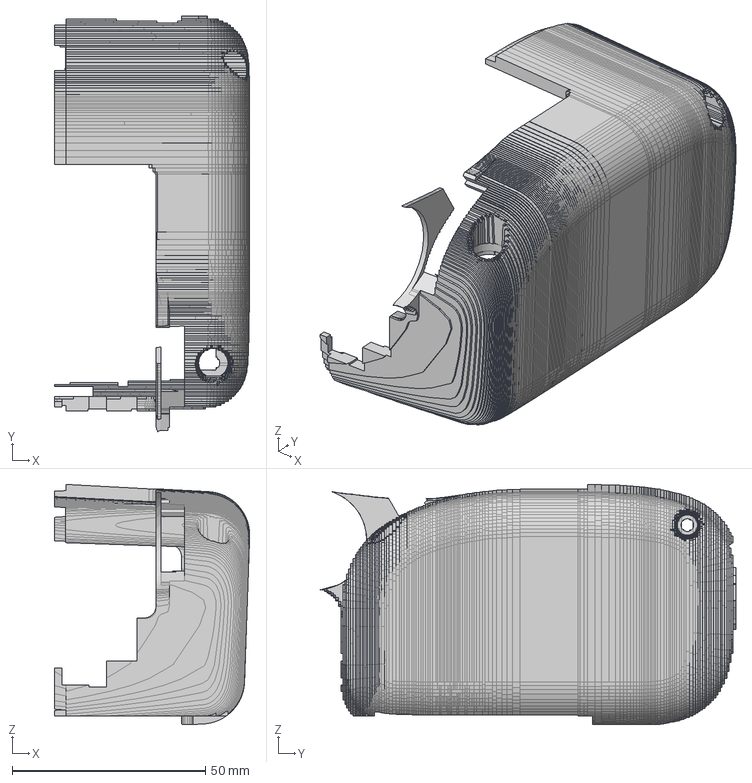
[picture p64: CAD file, 2026-10-31]
cad/redesign/mg996r/v1.0/parts/left_shell/left_shell.step
50.6 x 107.7 x 62.2 mm
