lsk0522/microduck/cad/redesign/mg996r/v1.0/parts/MG996R/MG996R.step

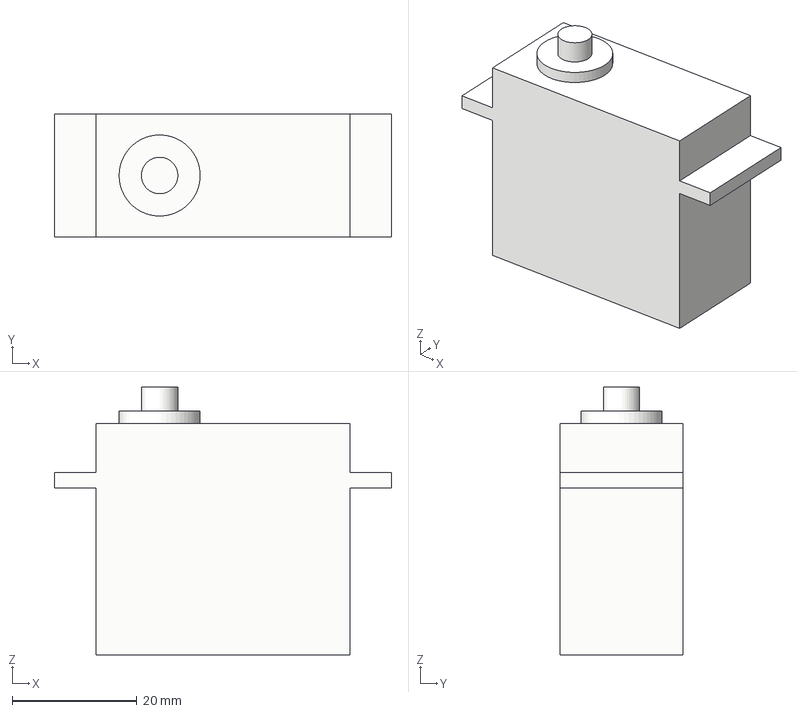
[picture p65: CAD file, 2026-10-31]
cad/redesign/mg996r/v1.0/parts/MG996R/MG996R.step
54.0 x 19.7 x 42.9 mm
