lsk0522/microduck/cad/redesign/mg996r/v1.0/parts/neck_frame/neck_frame.step

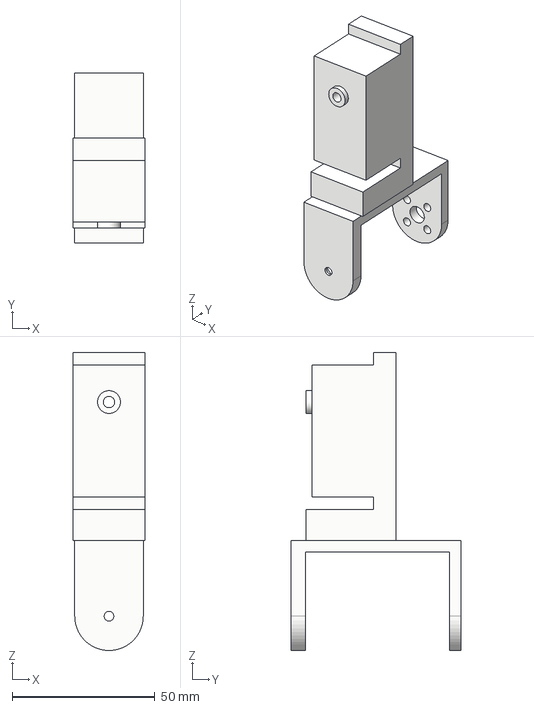
[picture p66: CAD file, 2026-10-31]
cad/redesign/mg996r/v1.0/parts/neck_frame/neck_frame.step
25.3 x 59.5 x 104.4 mm
