lsk0522/microduck/cad/redesign/mg996r/v1.0/parts/neck_pitch_frame/neck_pitch_frame.step

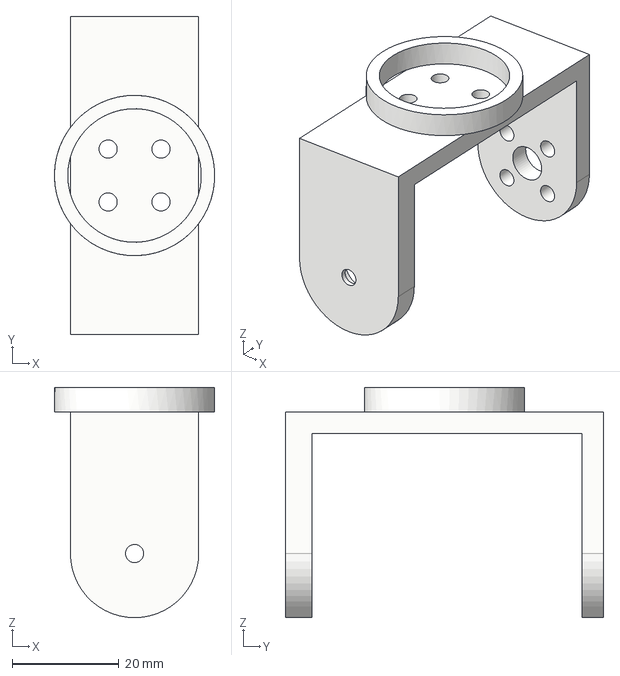
[picture p67: CAD file, 2026-10-31]
cad/redesign/mg996r/v1.0/parts/neck_pitch_frame/neck_pitch_frame.step
30.0 x 59.5 x 43.1 mm
