lsk0522/microduck/cad/redesign/mg996r/v1.0/parts/noenoeil/noenoeil.step

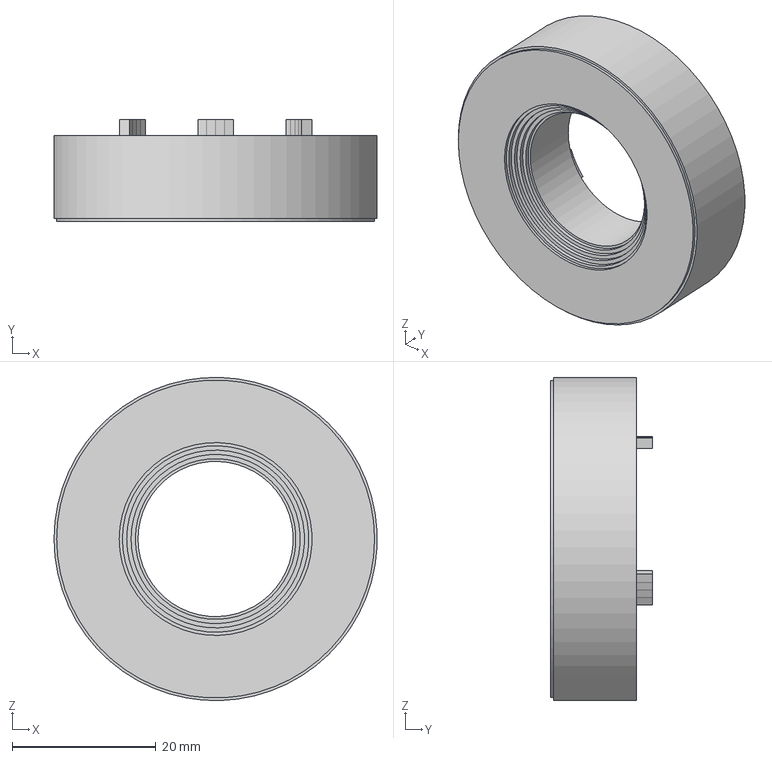
[picture p68: CAD file, 2026-10-31]
cad/redesign/mg996r/v1.0/parts/noenoeil/noenoeil.step
44.9 x 14.2 x 45.0 mm
