lsk0522/microduck/cad/redesign/mg996r/v1.0/parts/right_shell/right_shell.step

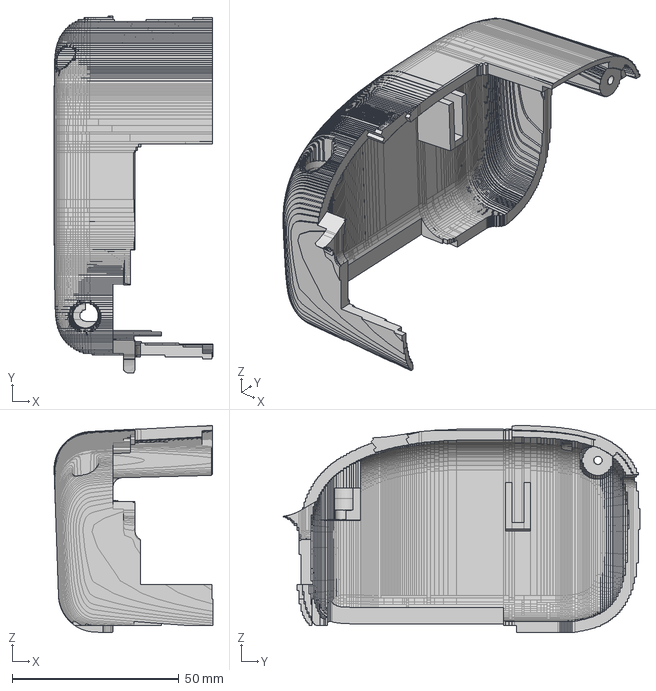
[picture p69: CAD file, 2026-10-31]
cad/redesign/mg996r/v1.0/parts/right_shell/right_shell.step
47.6 x 107.1 x 62.2 mm
