lsk0522/microduck/cad/redesign/mg996r/v1.0/parts/soft_mouth_top/soft_mouth_top.step

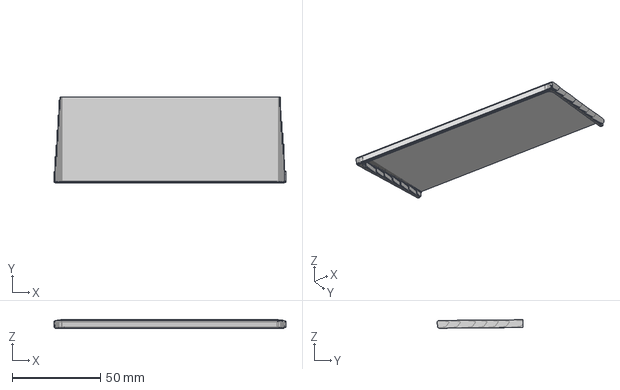
[picture p70: CAD file, 2026-10-31]
cad/redesign/mg996r/v1.0/parts/soft_mouth_top/soft_mouth_top.step
131.7 x 48.8 x 4.91 mm
