lsk0522/microduck/cad/redesign/mg996r/v1.0/parts/top_head_shell/top_head_shell.step

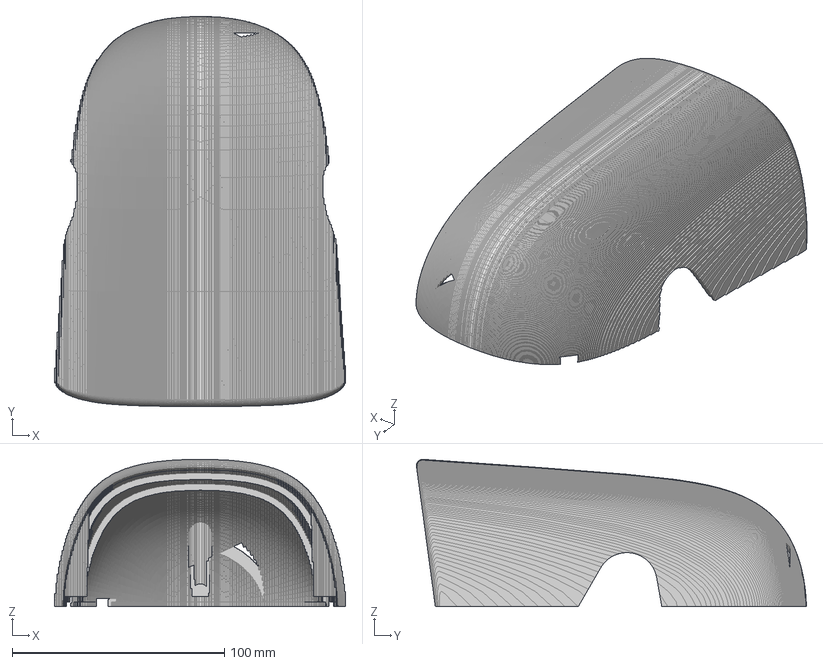
[picture p71: CAD file, 2026-10-31]
cad/redesign/mg996r/v1.0/parts/top_head_shell/top_head_shell.step
137.2 x 184.0 x 69.5 mm
