lsk0522/microduck/cad/redesign/mg996r/v1.0/parts/trunk_frame/trunk_frame.step

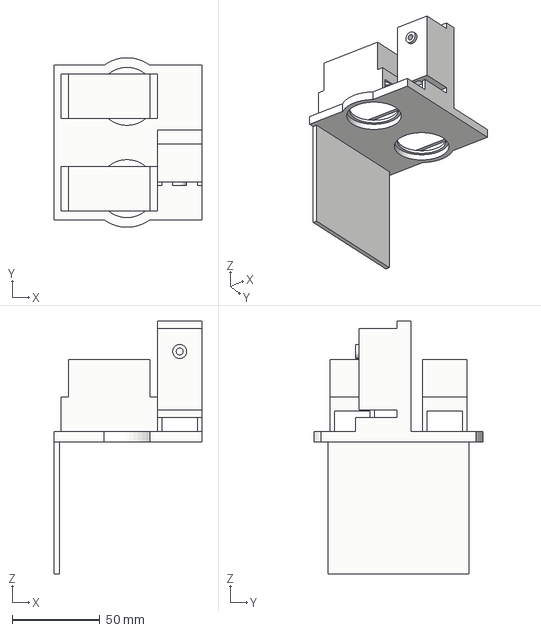
[picture p72: CAD file, 2026-10-31]
cad/redesign/mg996r/v1.0/parts/trunk_frame/trunk_frame.step
84.2 x 96.4 x 144.0 mm
