lsk0522/microduck/cad/redesign/mg996r/v1.0/parts/yaw2roll_left/yaw2roll_left.step

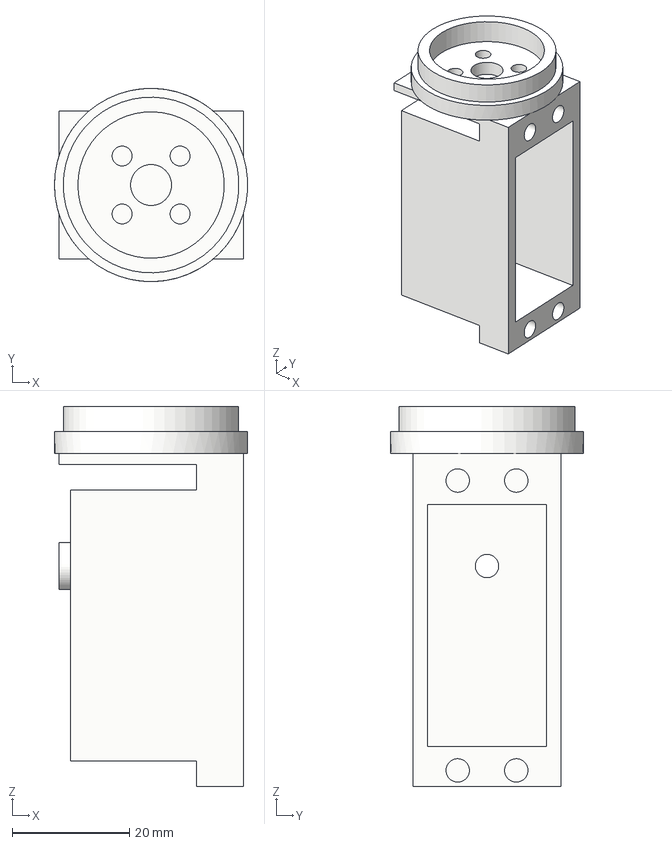
[picture p73: CAD file, 2026-10-31]
cad/redesign/mg996r/v1.0/parts/yaw2roll_left/yaw2roll_left.step
33.0 x 33.0 x 64.9 mm
