lsk0522/microduck/cad/redesign/mg996r/v1.0/parts/yaw_roll_frame/yaw_roll_frame.step

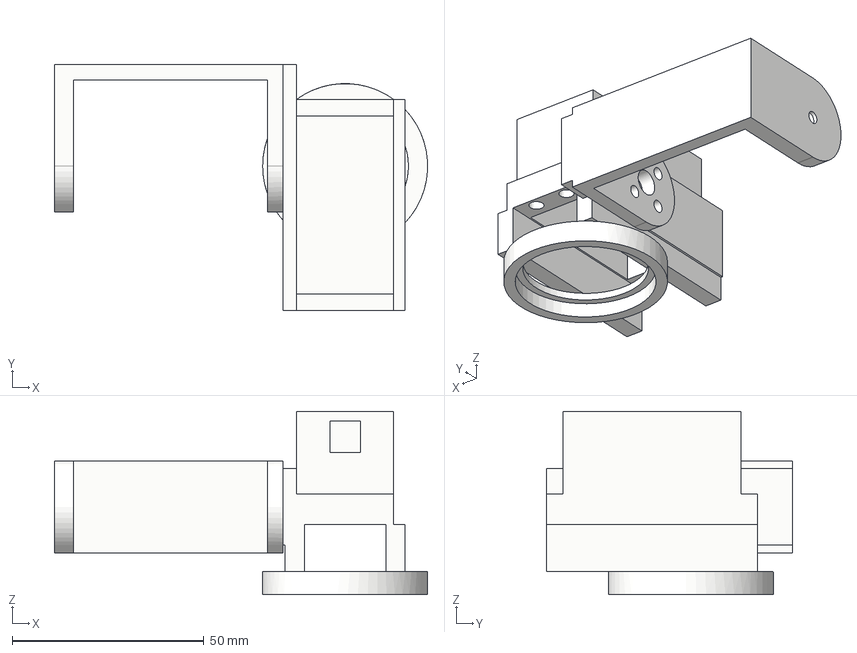
[picture p74: CAD file, 2026-10-31]
cad/redesign/mg996r/v1.0/parts/yaw_roll_frame/yaw_roll_frame.step
97.2 x 64.2 x 47.8 mm
