lsk0522/microduck/cad/redesign/tools/feat/ths_loft_test.stl

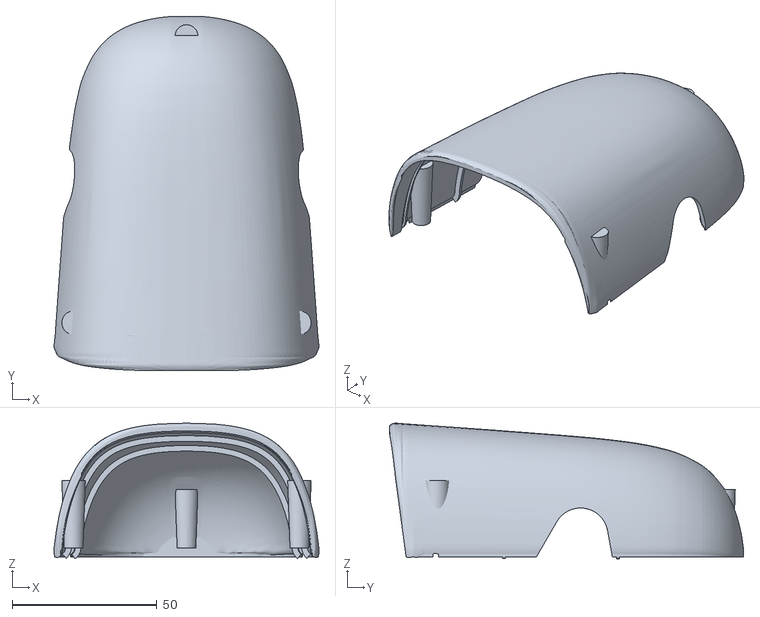
[picture p75: CAD file, 2026-11-01]
cad/redesign/tools/feat/ths_loft_test.stl
91.5 x 122.3 x 46.9
