lsk0522/microduck/cad/reference/microduck/assets/m12_lens_holder.stl

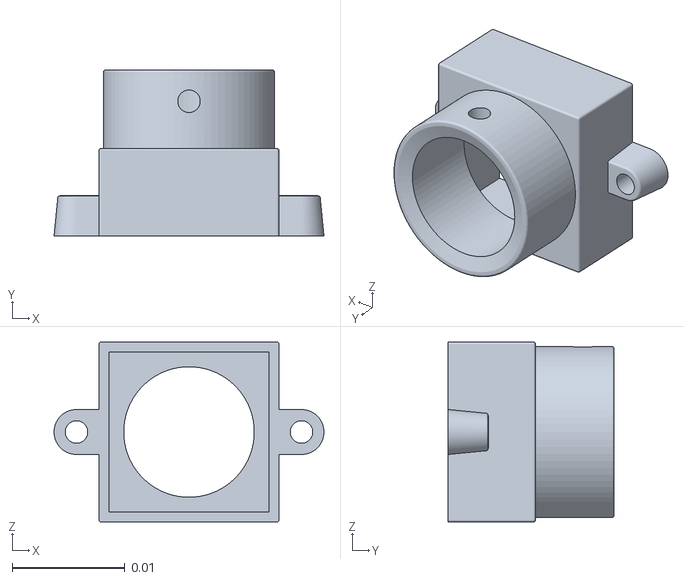
[picture p76: CAD file, 2026-10-29]
cad/reference/microduck/assets/m12_lens_holder.stl
0.024 x 0.0148 x 0.016
