lsk0522/microduck/cad/reference/xl330_test_bench/assets/xl330.stl

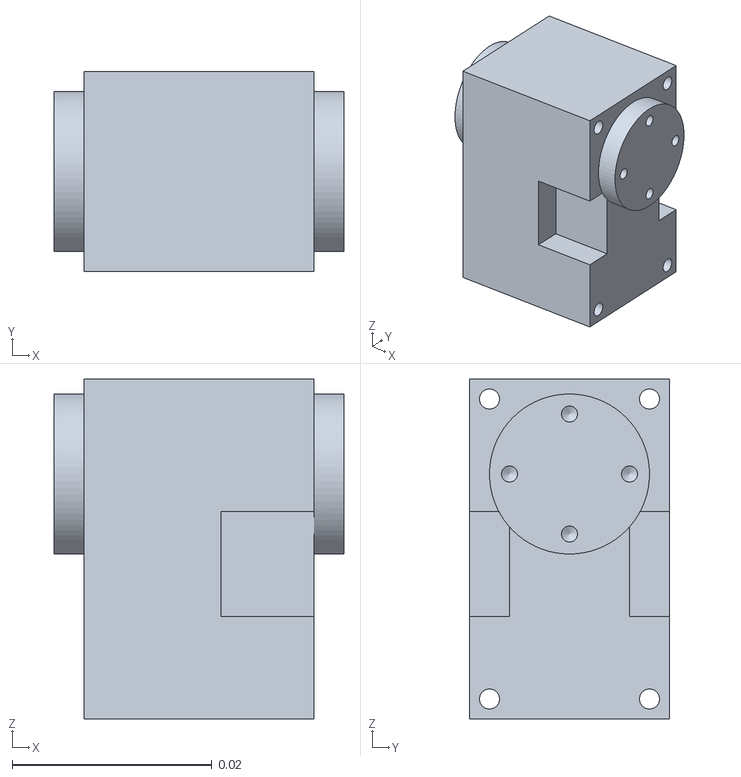
[picture p77: CAD file, 2026-10-29]
cad/reference/xl330_test_bench/assets/xl330.stl
0.029 x 0.02 x 0.034
