lsk0522/microduck/cad/plates/dynamixel/neck.dxf

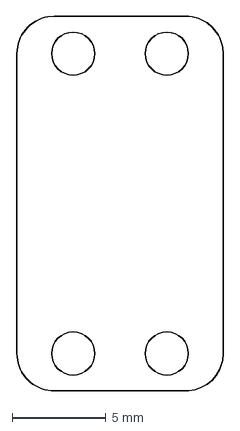
[picture p78: CAD file, 2026-10-29]
cad/plates/dynamixel/neck.dxf
11.0 x 20.0 mm
