lsk0522/microduck/cad/redesign/dynamixel/v1.0/mjcf/assets/left_shell.stl

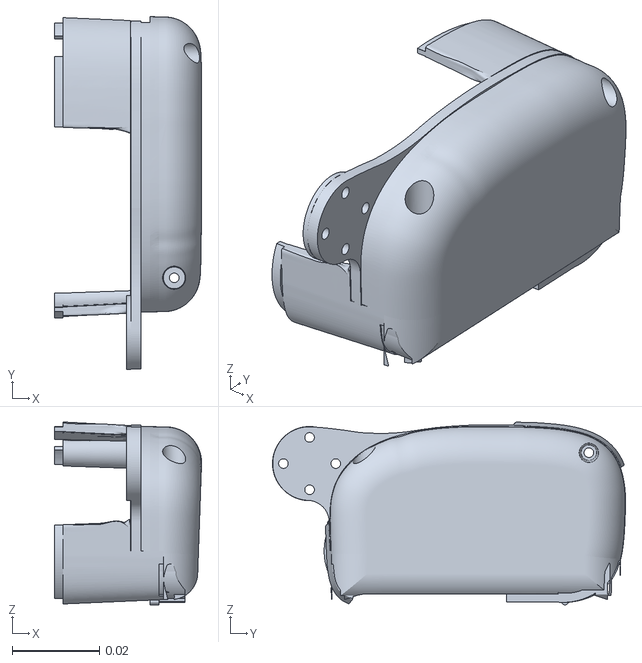
[picture p79: CAD file, 2026-11-03]
cad/redesign/dynamixel/v1.0/mjcf/assets/left_shell.stl
0.0337 x 0.0809 x 0.0419
