lsk0522/microduck/cad/redesign/hobby_servo/v1.0/mjcf/assets/horn_mg90s_head_yaw.stl

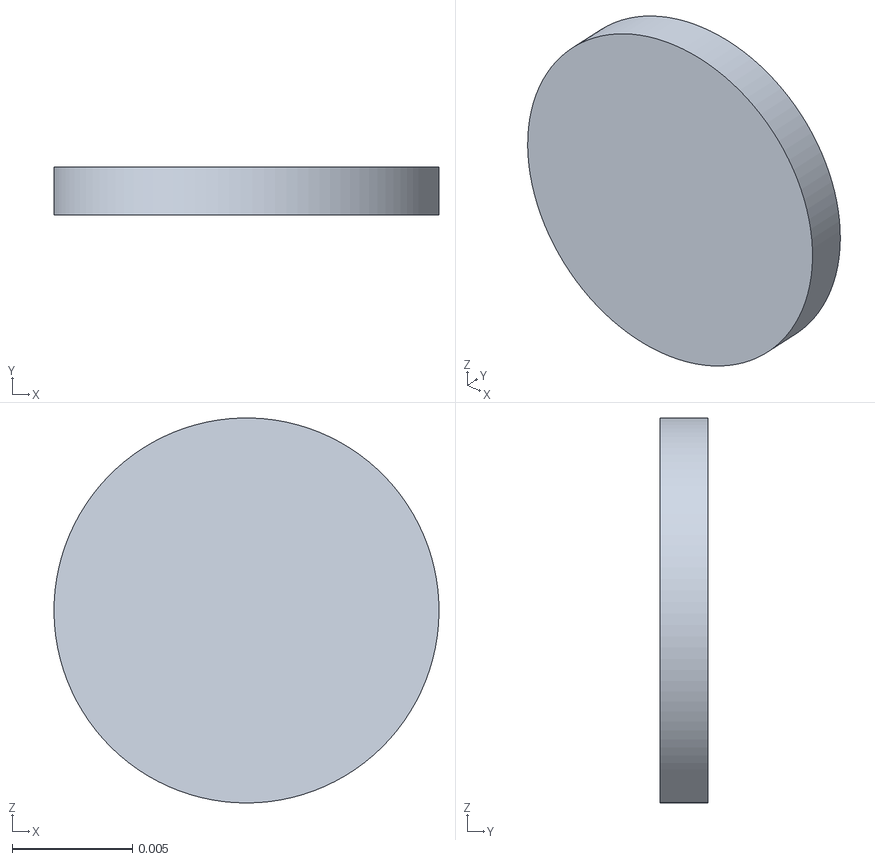
[picture p80: CAD file, 2026-10-31]
cad/redesign/hobby_servo/v1.0/mjcf/assets/horn_mg90s_head_yaw.stl
0.016 x 0.002 x 0.016
