lsk0522/microduck/cad/reference/microduck/assets/np_f970.stl

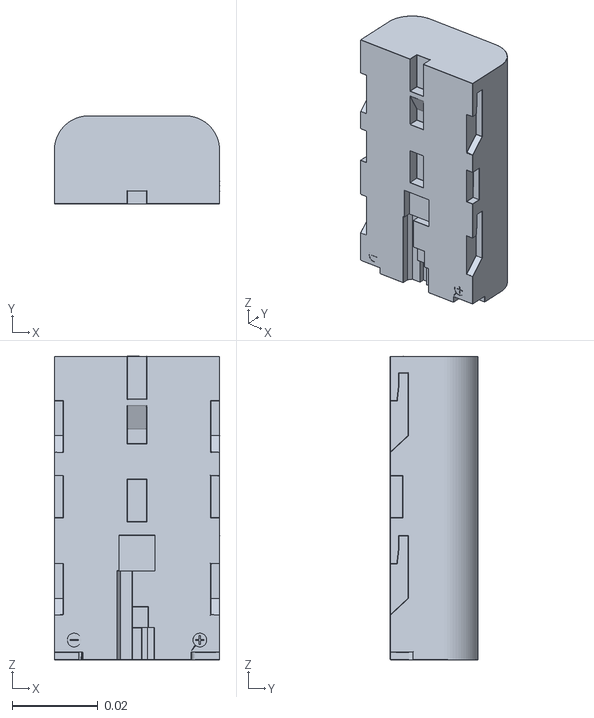
[picture p81: CAD file, 2026-10-29]
cad/reference/microduck/assets/np_f970.stl
0.0386 x 0.0206 x 0.0708
