lsk0522/microduck/cad/reference/xl330_test_bench/assets/part_3.stl

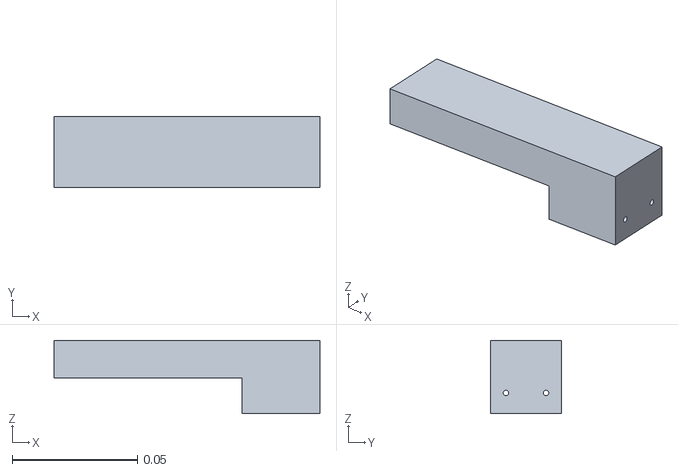
[picture p82: CAD file, 2026-10-29]
cad/reference/xl330_test_bench/assets/part_3.stl
0.106 x 0.0282 x 0.0292
