lsk0522/microduck/cad/plates/dynamixel/upper_leg_rigidity_plate.dxf

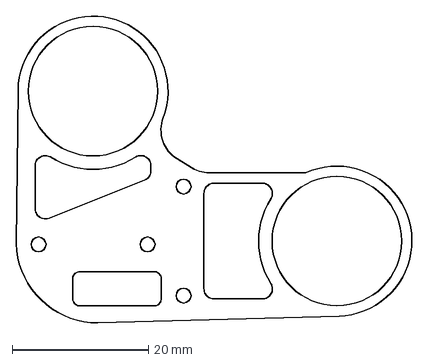
[picture p83: CAD file, 2026-10-29]
cad/plates/dynamixel/upper_leg_rigidity_plate.dxf
58.1 x 45.0 mm
