lsk0522/microduck/cad/redesign/hobby_servo/v1.0/mjcf/assets/mg90s_head_roll.stl

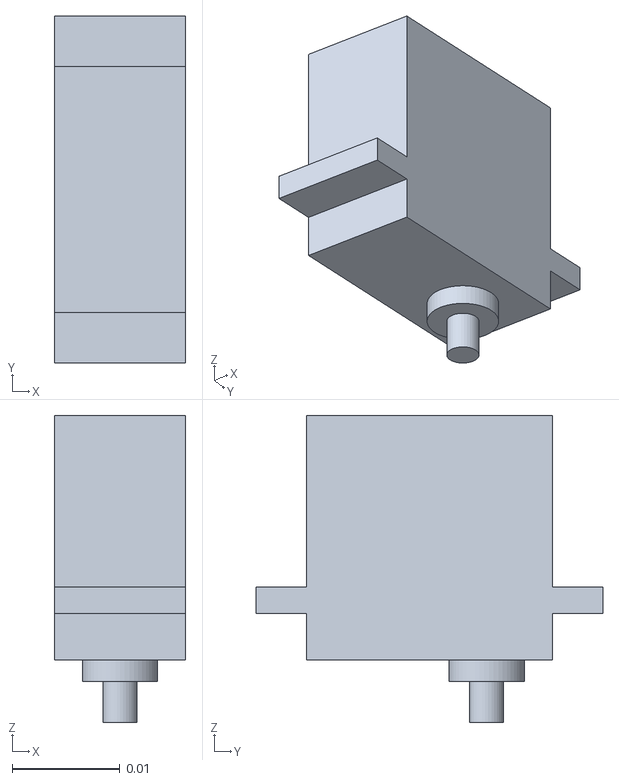
[picture p84: CAD file, 2026-10-31]
cad/redesign/hobby_servo/v1.0/mjcf/assets/mg90s_head_roll.stl
0.0122 x 0.0322 x 0.0285
