lsk0522/microduck/cad/redesign/mg996r/v1.0/mjcf/assets/horn_mg996r_head_roll.stl

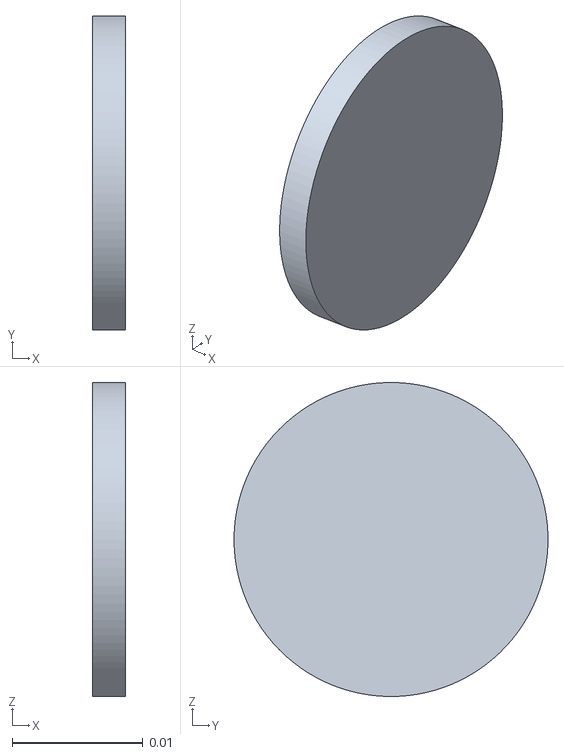
[picture p85: CAD file, 2026-10-31]
cad/redesign/mg996r/v1.0/mjcf/assets/horn_mg996r_head_roll.stl
0.0025 x 0.024 x 0.024
