lsk0522/microduck/cad/reference/microduck/assets/face_part.stl

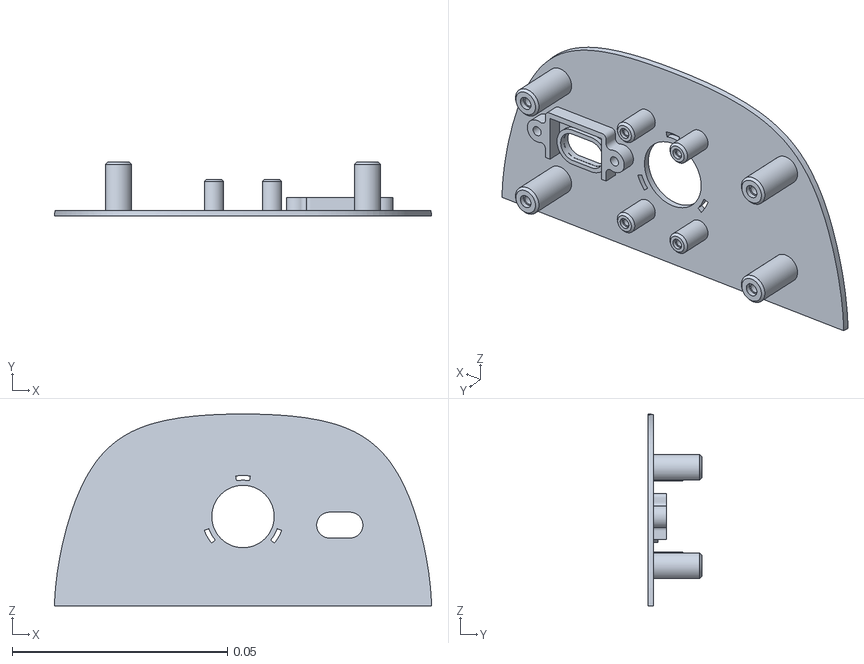
[picture p86: CAD file, 2026-10-29]
cad/reference/microduck/assets/face_part.stl
0.0877 x 0.0125 x 0.0446
