lsk0522/microduck/cad/reference/xl330_test_bench/assets/spacer.stl

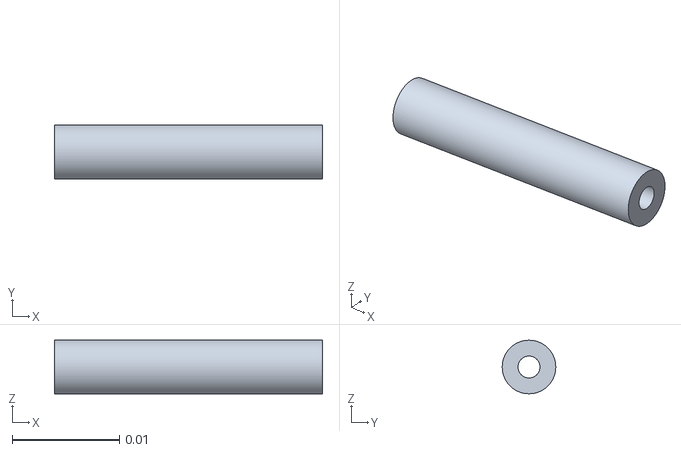
[picture p87: CAD file, 2026-10-29]
cad/reference/xl330_test_bench/assets/spacer.stl
0.025 x 0.005 x 0.005
