lsk0522/microduck/cad/plates/dynamixel/bearing_roll.dxf

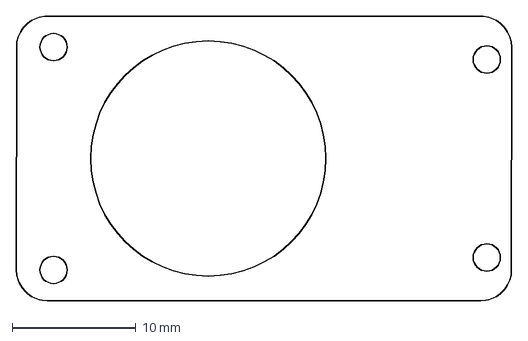
[picture p88: CAD file, 2026-10-29]
cad/plates/dynamixel/bearing_roll.dxf
40.0 x 23.0 mm
