lsk0522/microduck/cad/redesign/dynamixel/v1.0/mjcf/assets/power_support.stl

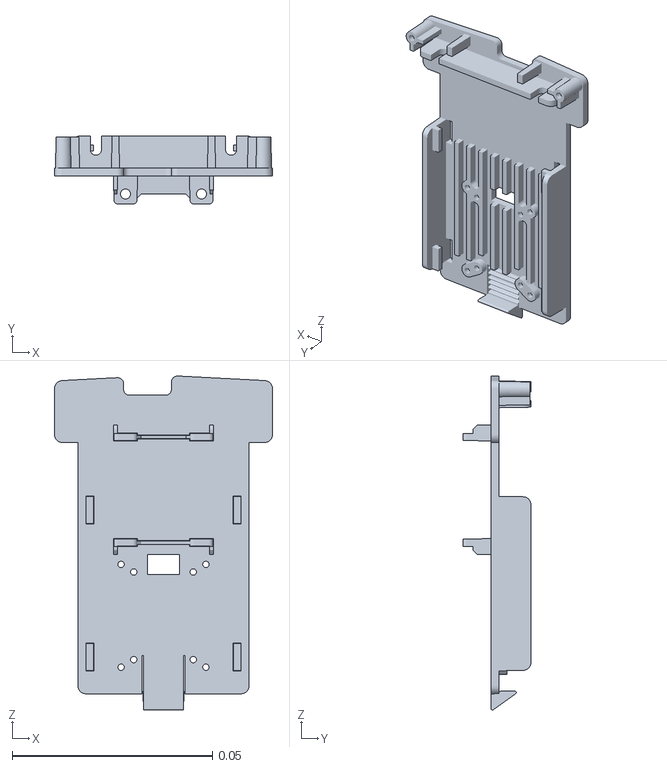
[picture p89: CAD file, 2026-11-03]
cad/redesign/dynamixel/v1.0/mjcf/assets/power_support.stl
0.0545 x 0.017 x 0.0835
