lsk0522/microduck/cad/redesign/mg996r/v1.0/mjcf/assets/bearing_623_head_roll.stl

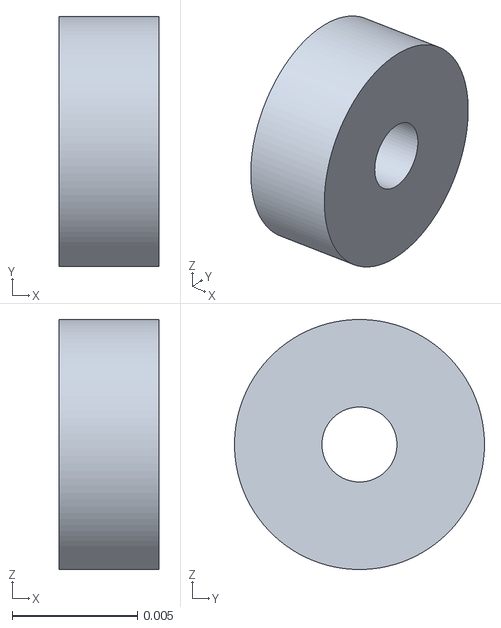
[picture p90: CAD file, 2026-10-31]
cad/redesign/mg996r/v1.0/mjcf/assets/bearing_623_head_roll.stl
0.004 x 0.01 x 0.01
