lsk0522/microduck/cad/reference/microduck/assets/right_shell.stl

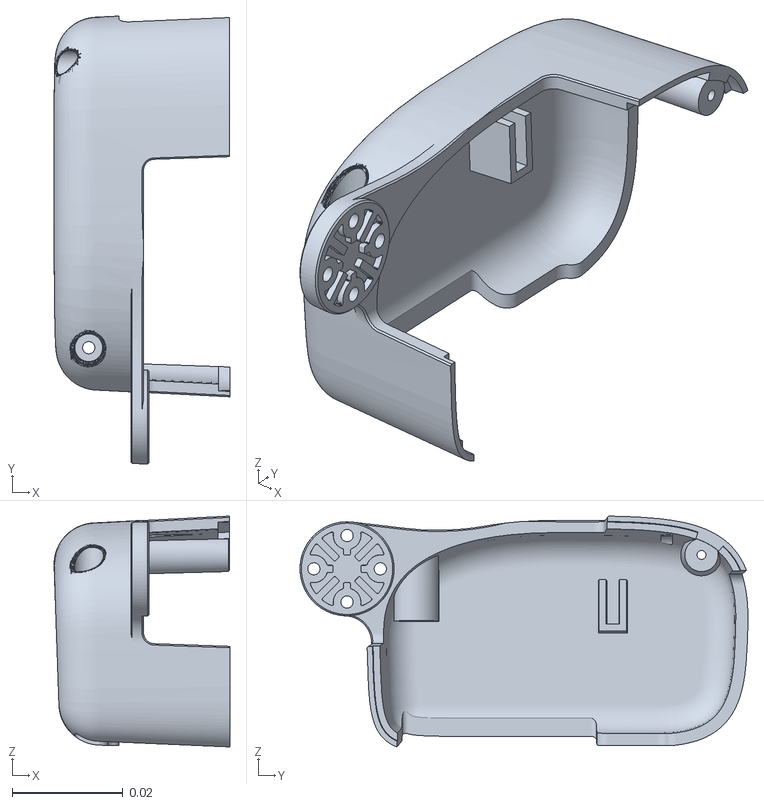
[picture p91: CAD file, 2026-10-29]
cad/reference/microduck/assets/right_shell.stl
0.0318 x 0.0809 x 0.0417
