lsk0522/microduck/cad/reference/xl330_test_bench/assets/part_4.stl

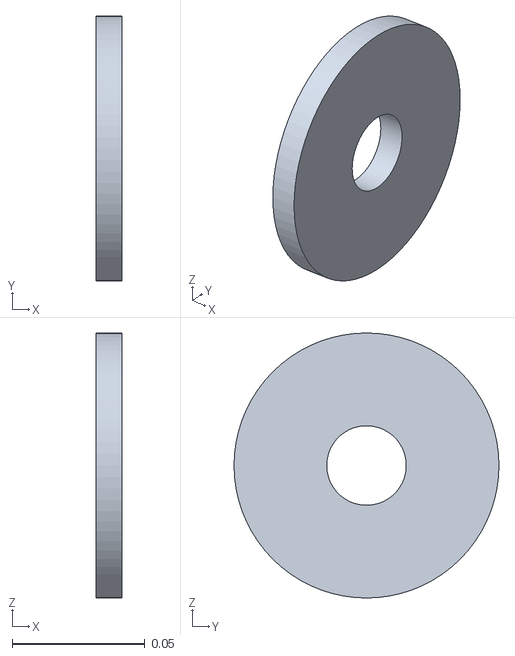
[picture p92: CAD file, 2026-10-29]
cad/reference/xl330_test_bench/assets/part_4.stl
0.01 x 0.1 x 0.1
