lsk0522/microduck/cad/redesign/dynamixel/v1.0/mjcf/assets/upper_leg_left.stl

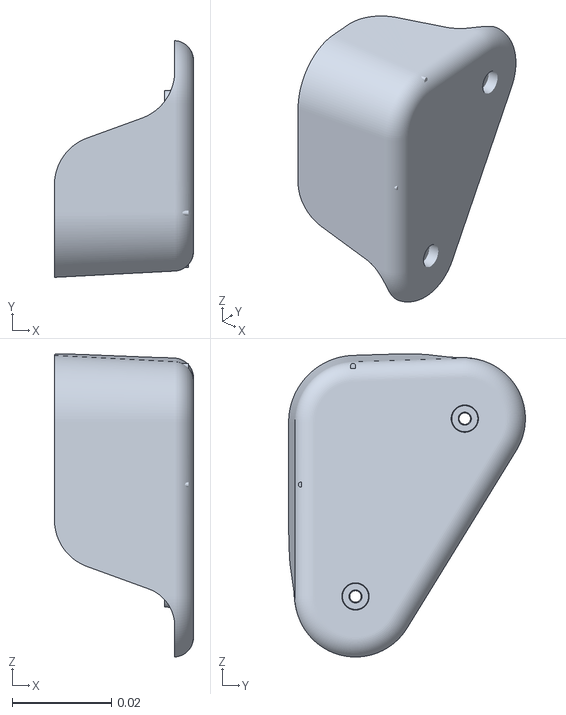
[picture p93: CAD file, 2026-11-03]
cad/redesign/dynamixel/v1.0/mjcf/assets/upper_leg_left.stl
0.028 x 0.0477 x 0.061
