lsk0522/microduck/cad/redesign/mg996r/v1.0/mjcf/assets/face_part.stl

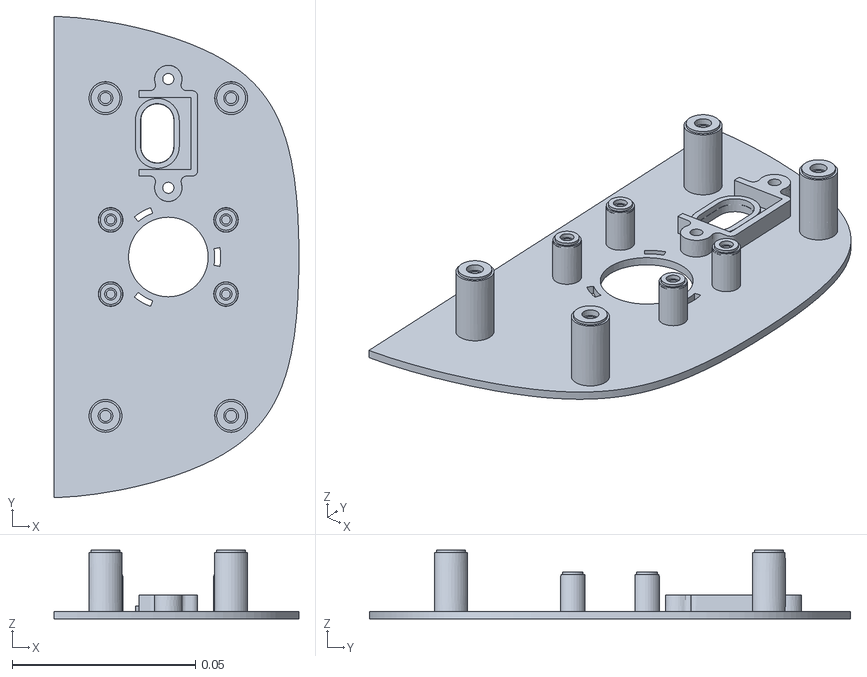
[picture p94: CAD file, 2026-10-31]
cad/redesign/mg996r/v1.0/mjcf/assets/face_part.stl
0.0669 x 0.131 x 0.0187
