lsk0522/microduck/cad/reference/microduck/assets/ankle_right.stl

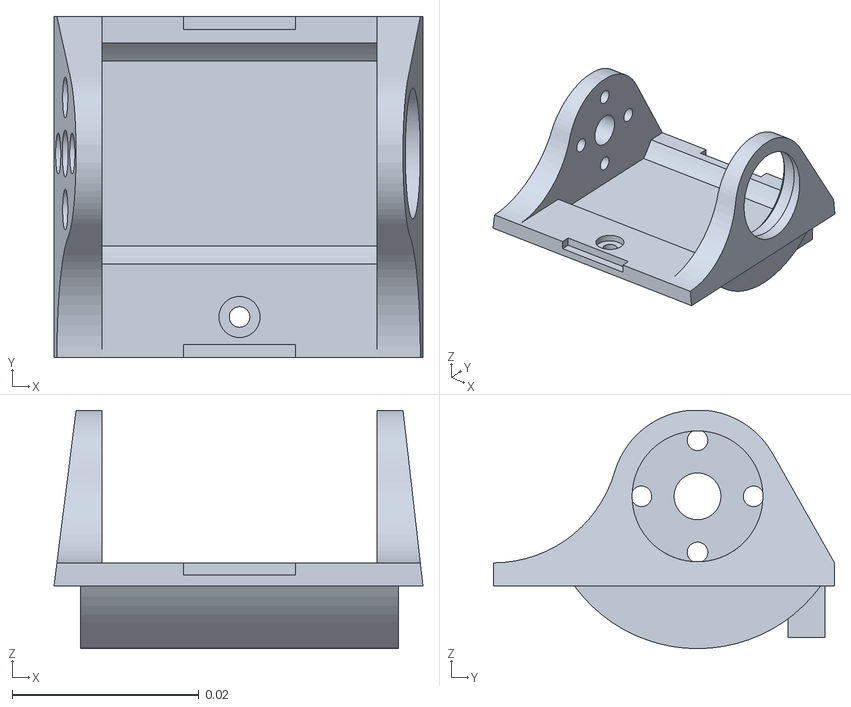
[picture p95: CAD file, 2026-10-29]
cad/reference/microduck/assets/ankle_right.stl
0.0395 x 0.0365 x 0.0255
