lsk0522/microduck/cad/redesign/dynamixel/v1.0/mjcf/assets/sole_left.stl

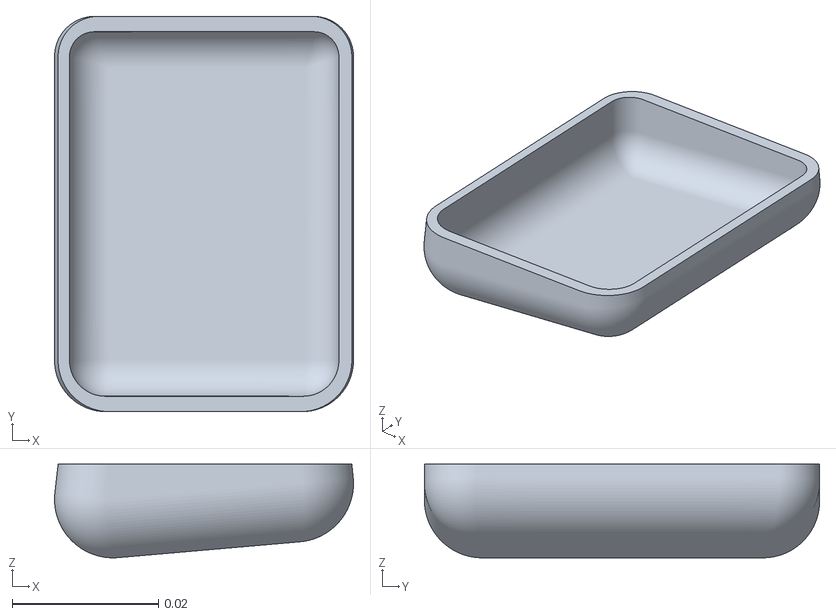
[picture p96: CAD file, 2026-11-03]
cad/redesign/dynamixel/v1.0/mjcf/assets/sole_left.stl
0.0408 x 0.054 x 0.0128
