lsk0522/microduck/cad/reference/microduck/assets/yaw_roll_motion.stl

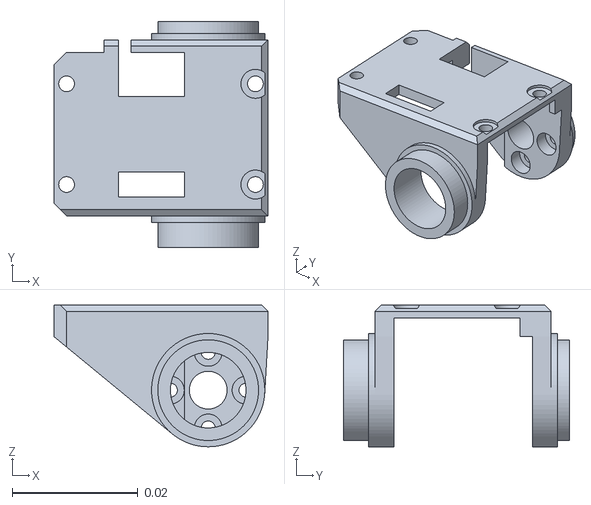
[picture p97: CAD file, 2026-10-29]
cad/reference/microduck/assets/yaw_roll_motion.stl
0.034 x 0.0359 x 0.0225
