lsk0522/microduck/cad/redesign/dynamixel/v1.0/mjcf/assets/foot_right.stl

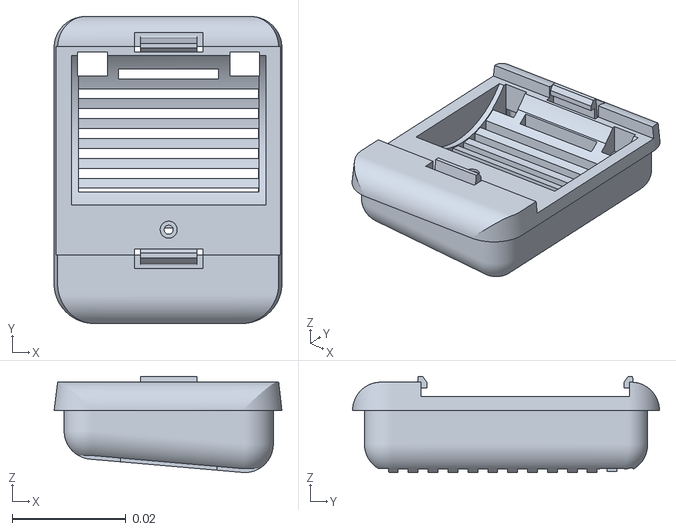
[picture p98: CAD file, 2026-11-03]
cad/redesign/dynamixel/v1.0/mjcf/assets/foot_right.stl
0.0401 x 0.054 x 0.0169
