lsk0522/microduck/cad/redesign/mg996r/v1.0/mjcf/assets/bearing_6706_head_yaw.stl

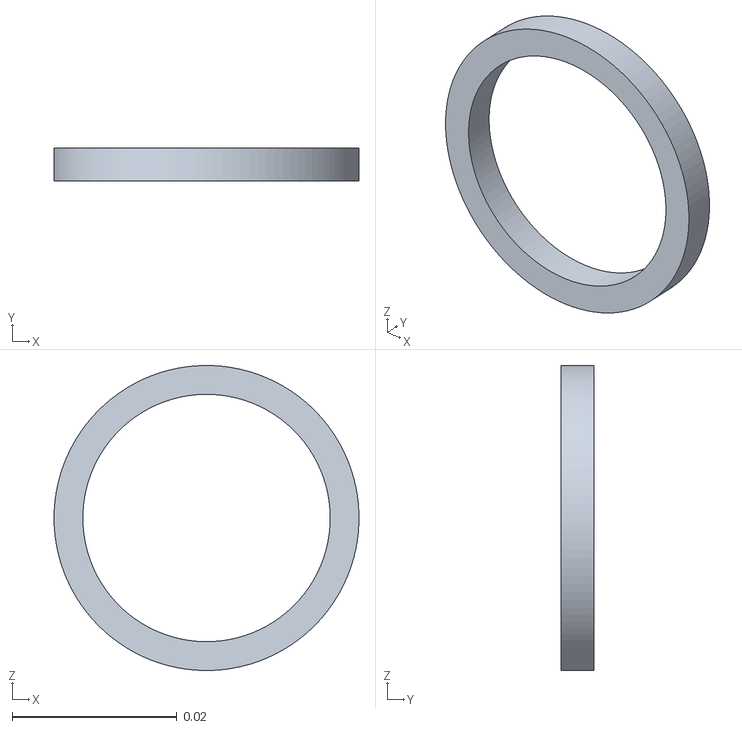
[picture p99: CAD file, 2026-10-31]
cad/redesign/mg996r/v1.0/mjcf/assets/bearing_6706_head_yaw.stl
0.037 x 0.004 x 0.037
