lsk0522/microduck/cad/reference/xl330_test_bench/assets/part_5.stl

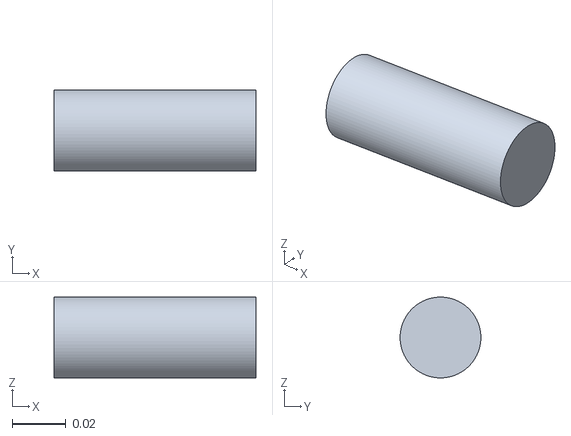
[picture p100: CAD file, 2026-10-29]
cad/reference/xl330_test_bench/assets/part_5.stl
0.075 x 0.03 x 0.03
