lsk0522/microduck/cad/redesign/dynamixel/v1.0/mjcf/assets/jaw.stl

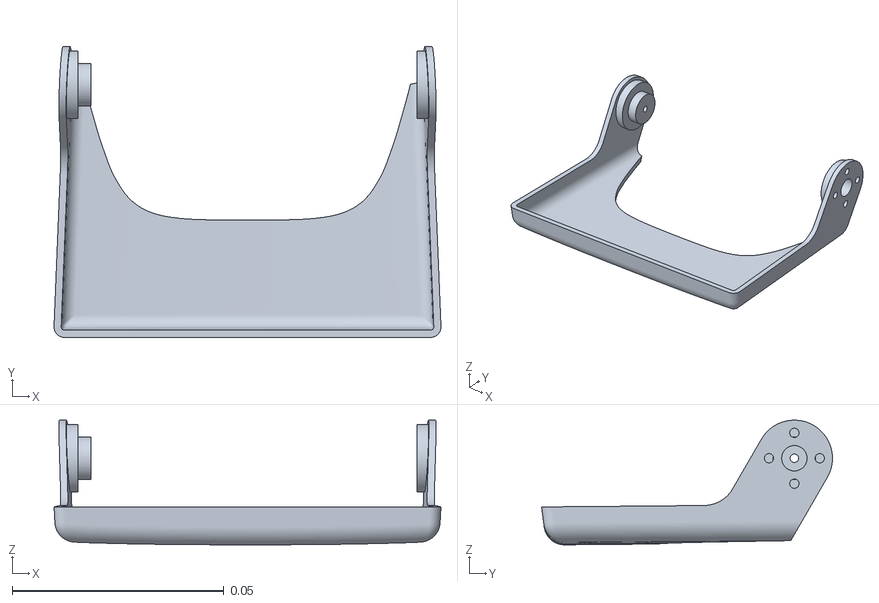
[picture p101: CAD file, 2026-11-03]
cad/redesign/dynamixel/v1.0/mjcf/assets/jaw.stl
0.0914 x 0.0687 x 0.0294
