lsk0522/microduck/cad/redesign/mg996r/v1.0/mjcf/assets/jaw.stl

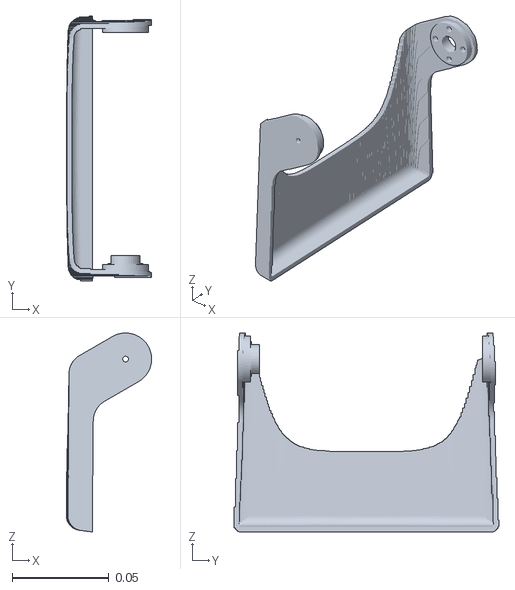
[picture p102: CAD file, 2026-10-31]
cad/redesign/mg996r/v1.0/mjcf/assets/jaw.stl
0.0442 x 0.137 x 0.103
