lsk0522/microduck/cad/redesign/dynamixel/v1.0/mjcf/assets/hip_l.stl

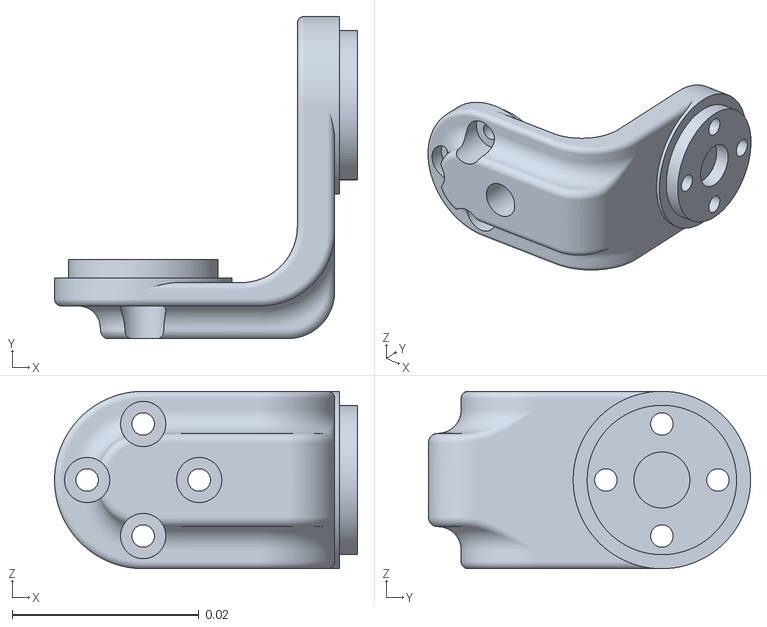
[picture p103: CAD file, 2026-11-03]
cad/redesign/dynamixel/v1.0/mjcf/assets/hip_l.stl
0.0324 x 0.0345 x 0.019
