lsk0522/microduck/cad/redesign/mg996r/v1.0/mjcf/assets/yaw_roll_frame.stl

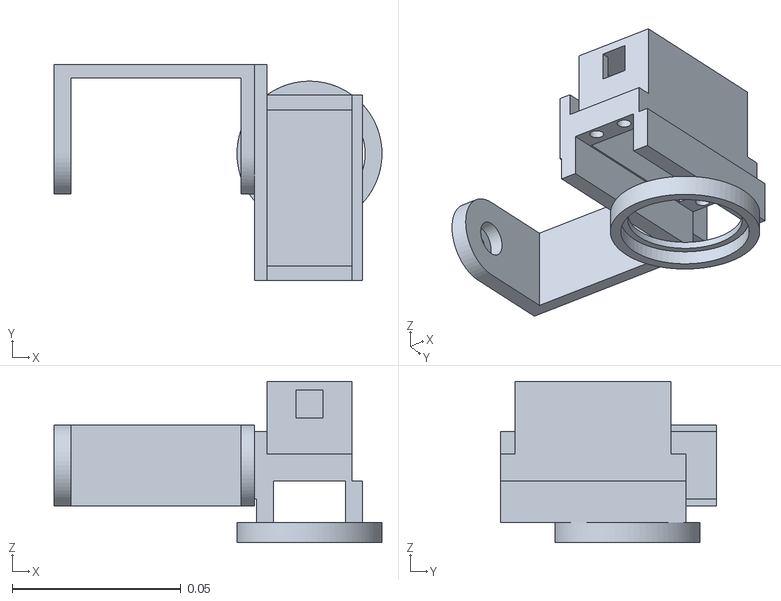
[picture p104: CAD file, 2026-10-31]
cad/redesign/mg996r/v1.0/mjcf/assets/yaw_roll_frame.stl
0.0973 x 0.0641 x 0.0478
