lsk0522/microduck/cad/reference/microduck/assets/top_head_shell.stl

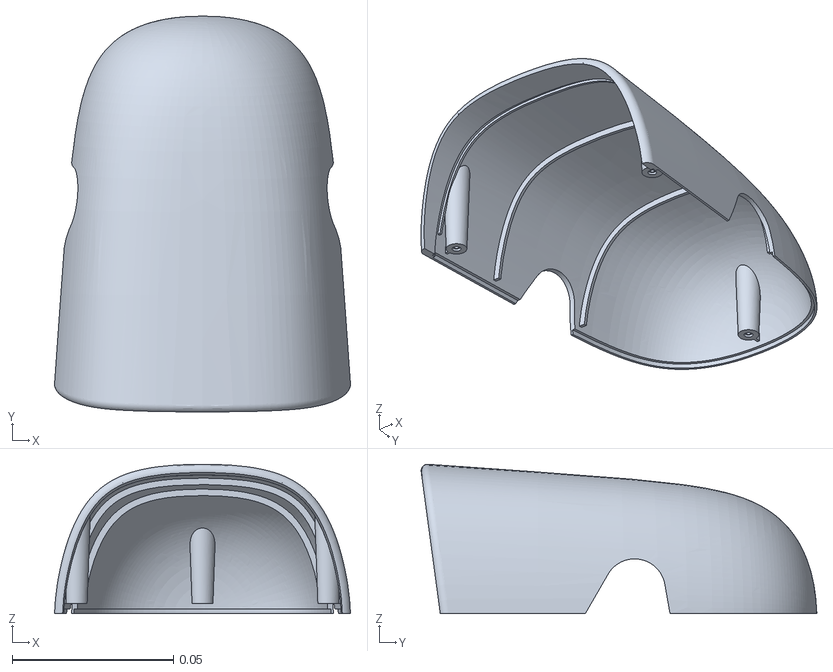
[picture p105: CAD file, 2026-10-29]
cad/reference/microduck/assets/top_head_shell.stl
0.0918 x 0.123 x 0.0463
