lsk0522/microduck/cad/redesign/dynamixel/v1.0/mjcf/assets/bottom_head_shell.stl

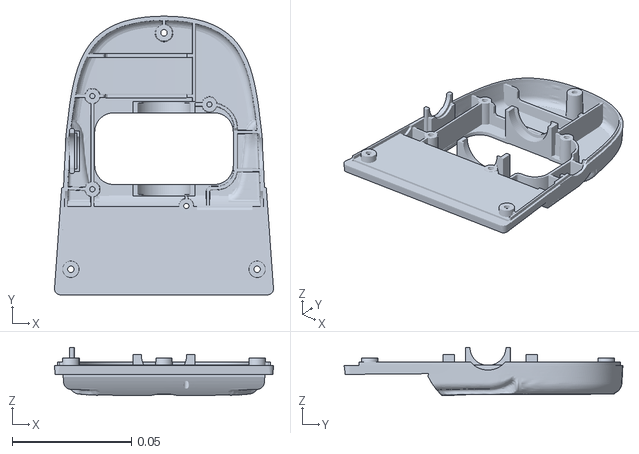
[picture p106: CAD file, 2026-11-03]
cad/redesign/dynamixel/v1.0/mjcf/assets/bottom_head_shell.stl
0.0917 x 0.117 x 0.0201
