lsk0522/microduck/cad/redesign/mg996r/v1.0/mjcf/assets/neck_pitch_frame.stl

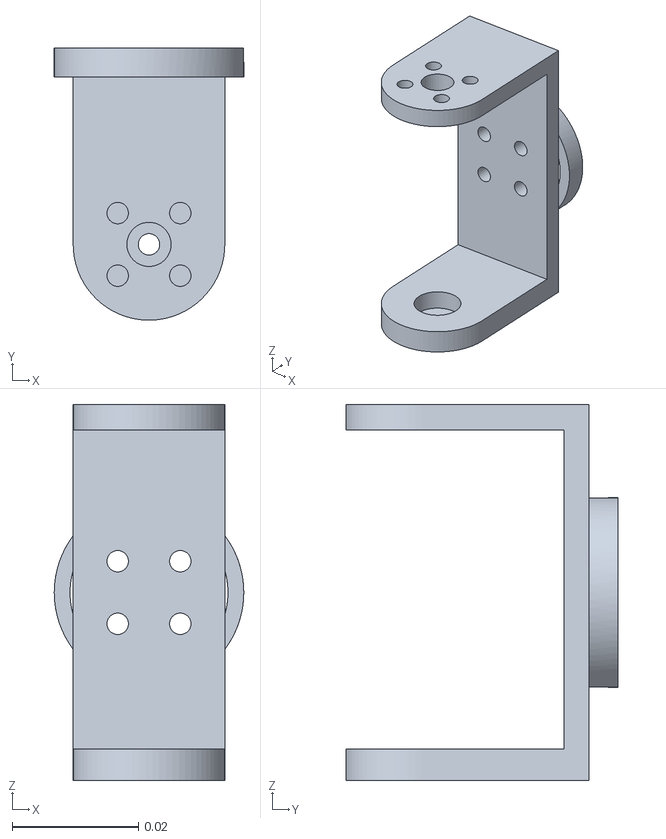
[picture p107: CAD file, 2026-10-31]
cad/redesign/mg996r/v1.0/mjcf/assets/neck_pitch_frame.stl
0.03 x 0.0431 x 0.0595
