lsk0522/microduck/cad/reference/xl330_test_bench/assets/arm.stl

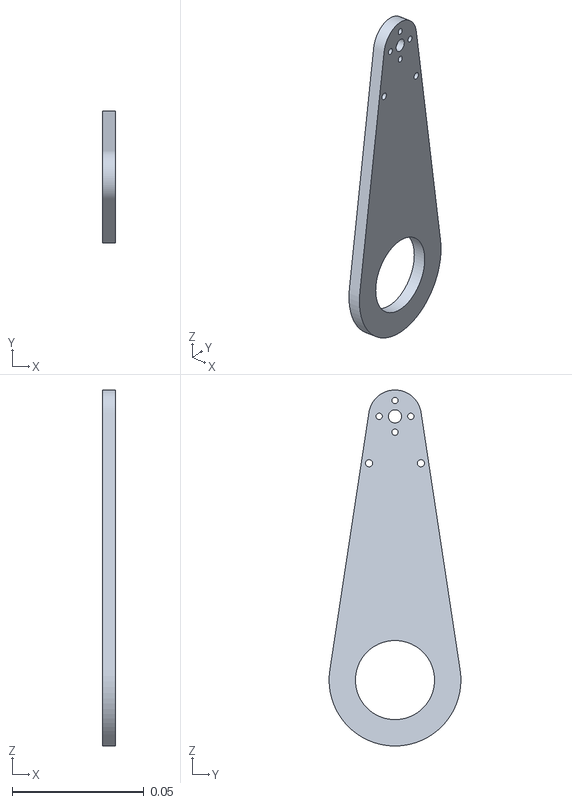
[picture p108: CAD file, 2026-10-29]
cad/reference/xl330_test_bench/assets/arm.stl
0.005 x 0.05 x 0.135
