lsk0522/microduck/cad/redesign/dynamixel/v1.0/mjcf/assets/yaw2roll.stl

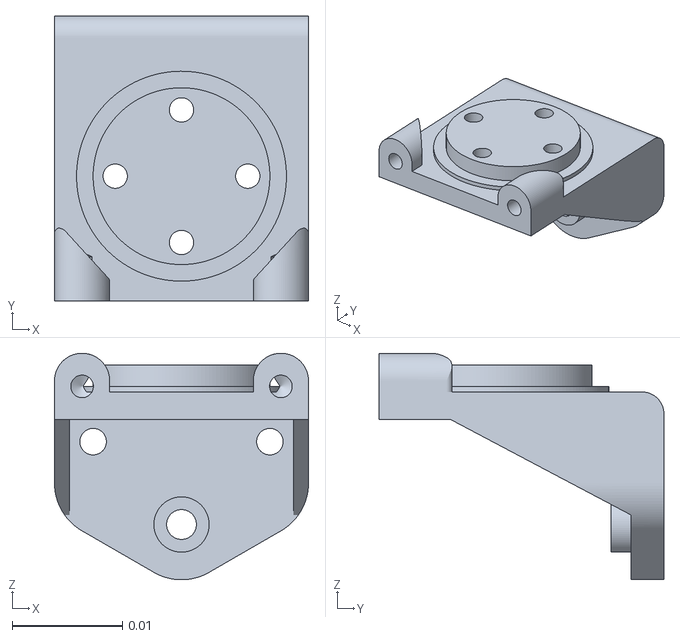
[picture p109: CAD file, 2026-11-03]
cad/redesign/dynamixel/v1.0/mjcf/assets/yaw2roll.stl
0.023 x 0.0258 x 0.0205
