lsk0522/microduck/cad/redesign/mg996r/v1.0/mjcf/assets/head_frame.stl

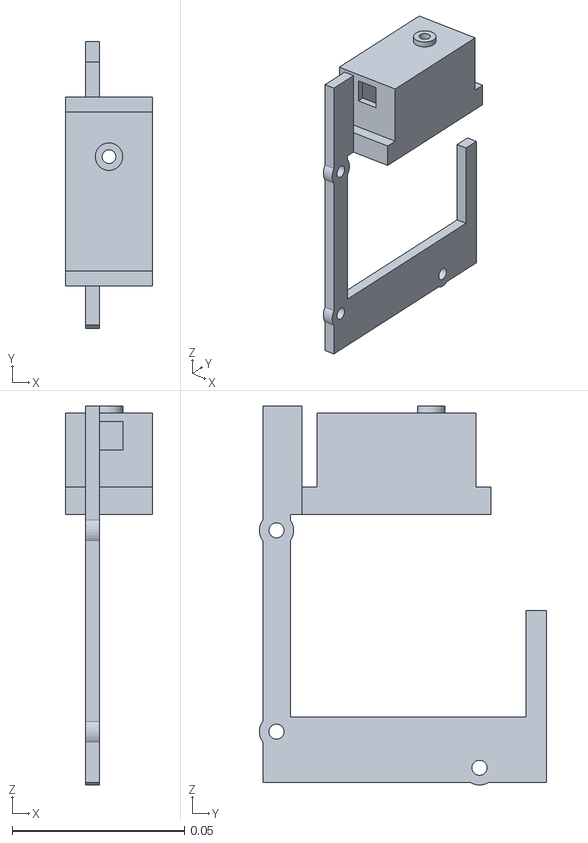
[picture p110: CAD file, 2026-10-31]
cad/redesign/mg996r/v1.0/mjcf/assets/head_frame.stl
0.0253 x 0.0835 x 0.11
