lsk0522/microduck/cad/reference/microduck/assets/seeed_bearing__configuration_default.stl

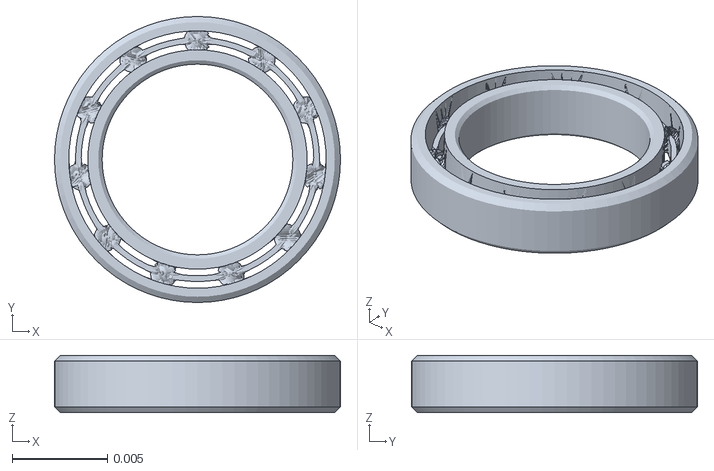
[picture p111: CAD file, 2026-10-29]
cad/reference/microduck/assets/seeed_bearing__configuration_default.stl
0.015 x 0.015 x 0.003
