lsk0522/microduck/cad/redesign/dynamixel/v1.0/mjcf/assets/jaw_soft.stl

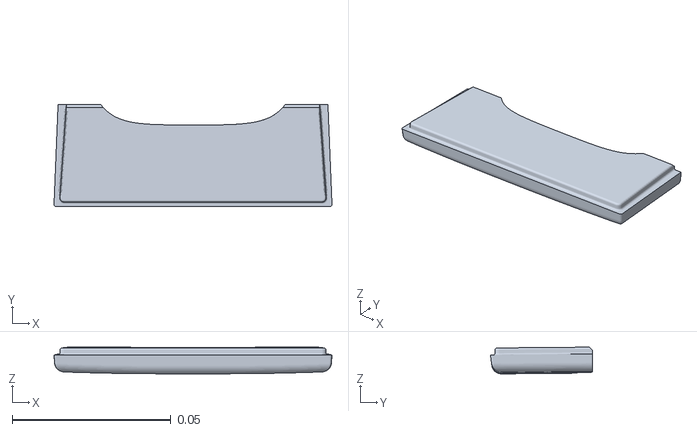
[picture p112: CAD file, 2026-11-03]
cad/redesign/dynamixel/v1.0/mjcf/assets/jaw_soft.stl
0.0877 x 0.0322 x 0.00844
