lsk0522/microduck/cad/redesign/mg996r/v1.0/mjcf/assets/right_shell.stl

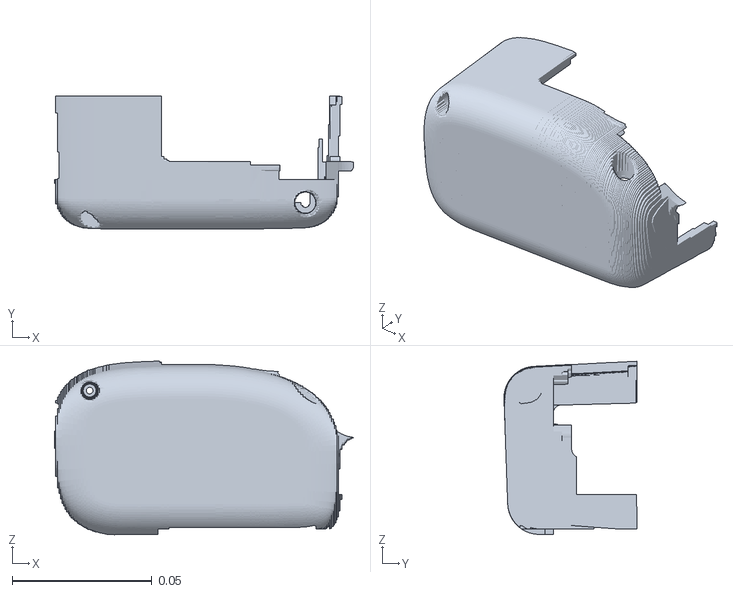
[picture p113: CAD file, 2026-10-31]
cad/redesign/mg996r/v1.0/mjcf/assets/right_shell.stl
0.107 x 0.0476 x 0.0622
