lsk0522/microduck/cad/reference/microduck/assets/soft_mouth_top.stl

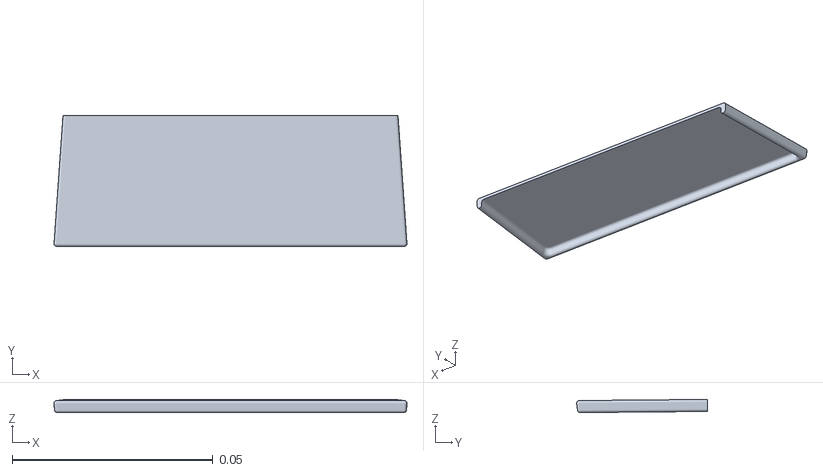
[picture p114: CAD file, 2026-10-29]
cad/reference/microduck/assets/soft_mouth_top.stl
0.0878 x 0.0326 x 0.00328
