lsk0522/microduck/(list of files, cad)

Other CAD files:
cad/redesign/dynamixel/v1.0/parts/ankle_right/ankle_right.step
cad/redesign/dynamixel/v1.0/parts/foot_right/foot_right.step
cad/redesign/dynamixel/v1.0/parts/sole_right/sole_right.step
cad/redesign/dynamixel/v1.0/parts/upper_leg_right/upper_leg_right.step
cad/redesign/hobby_servo/v1.0/parts/ankle_right/ankle_right.step
cad/redesign/hobby_servo/v1.0/parts/leg_right/leg_right.step
cad/redesign/hobby_servo/v1.0/parts/upper_leg_right/upper_leg_right.step
cad/redesign/mg996r/v1.0/parts/ankle_left/ankle_left.step
cad/redesign/mg996r/v1.0/parts/ankle_right/ankle_right.step
cad/redesign/mg996r/v1.0/parts/battery_tray/battery_tray.step
cad/redesign/mg996r/v1.0/parts/hip_l_right/hip_l_right.step
cad/redesign/mg996r/v1.0/parts/leg_left/leg_left.step
cad/redesign/mg996r/v1.0/parts/leg_right/leg_right.step
cad/redesign/mg996r/v1.0/parts/sole_left/sole_left.step
cad/redesign/mg996r/v1.0/parts/sole_right/sole_right.step
cad/redesign/mg996r/v1.0/parts/upper_leg_left/upper_leg_left.step
cad/redesign/mg996r/v1.0/parts/upper_leg_right/upper_leg_right.step
cad/redesign/mg996r/v1.0/parts/yaw2roll_right/yaw2roll_right.step
cad/redesign/tools/build/verify/top_head_shell.stl
cad/redesign/mg996r/v1.0/mjcf/assets/mg996r_head_roll.stl
cad/redesign/tools/build/verify/bottom_head_shell.stl
cad/redesign/tools/feat/neck_pitch_new.stl
cad/redesign/dynamixel/v1.0/mjcf/assets/right_shell.stl
cad/redesign/tools/build/verify/banana_pcb_locker.stl
cad/redesign/hobby_servo/v1.0/mjcf/assets/mg90s_head_yaw.stl
cad/redesign/tools/build/verify/yaw_roll_motion.stl
cad/redesign/hobby_servo/v1.0/mjcf/assets/horn_mg90s_head_roll.stl
cad/redesign/tools/build/verify/right_shell.stl
cad/redesign/mg996r/v1.0/mjcf/assets/horn_mg996r_head_yaw.stl
cad/redesign/tools/build/verify/left_shell.stl
cad/redesign/tools/build/verify/face_part.stl
cad/reference/microduck/assets/foot_left.stl
cad/redesign/tools/build/verify/jaw.stl
cad/reference/microduck/assets/left_shell.stl
cad/redesign/tools/build/verify/jaw_soft.stl
cad/redesign/tools/build/verify/soft_mouth_top.stl
cad/reference/microduck/assets/jaw.stl
cad/redesign/tools/build/verify/foot_left.stl
cad/redesign/tools/build/verify/foot_right.stl
cad/redesign/dynamixel/v1.0/mjcf/assets/ankle_l_v1.stl
cad/redesign/dynamixel/v1.0/mjcf/assets/ankle_left.stl
cad/redesign/dynamixel/v1.0/mjcf/assets/ankle_r_v1.stl
cad/redesign/dynamixel/v1.0/mjcf/assets/ankle_right.stl
cad/redesign/dynamixel/v1.0/mjcf/assets/banana_pcb_locker.stl
cad/redesign/dynamixel/v1.0/mjcf/assets/bearing_roll.stl
cad/redesign/dynamixel/v1.0/mjcf/assets/elec_rpi_robot_hat_pcb.stl
cad/redesign/dynamixel/v1.0/mjcf/assets/face_part.stl
cad/redesign/dynamixel/v1.0/mjcf/assets/foot_left.stl
cad/redesign/dynamixel/v1.0/mjcf/assets/leg.stl
cad/redesign/dynamixel/v1.0/mjcf/assets/lens.stl
cad/redesign/dynamixel/v1.0/mjcf/assets/m12_lens_holder.stl
cad/redesign/dynamixel/v1.0/mjcf/assets/motor_support.stl
cad/redesign/dynamixel/v1.0/mjcf/assets/neck_1.stl
cad/redesign/dynamixel/v1.0/mjcf/assets/neck_pitch.stl
cad/redesign/dynamixel/v1.0/mjcf/assets/noenoeil.stl
cad/redesign/dynamixel/v1.0/mjcf/assets/np_f970.stl
cad/redesign/dynamixel/v1.0/mjcf/assets/pcb__raspberry_pi_zero_2_w.stl
cad/redesign/dynamixel/v1.0/mjcf/assets/rim.stl
cad/redesign/dynamixel/v1.0/mjcf/assets/roller_blade.stl
cad/redesign/dynamixel/v1.0/mjcf/assets/seeed_bearing__configuration__22x16x4.stl
cad/redesign/dynamixel/v1.0/mjcf/assets/seeed_bearing__configuration_default.stl
cad/redesign/dynamixel/v1.0/mjcf/assets/soft_mouth_top.stl
cad/redesign/dynamixel/v1.0/mjcf/assets/sole_right.stl
cad/redesign/dynamixel/v1.0/mjcf/assets/speaker.stl
cad/redesign/dynamixel/v1.0/mjcf/assets/tire.stl
cad/redesign/dynamixel/v1.0/mjcf/assets/top_head_shell.stl
cad/redesign/dynamixel/v1.0/mjcf/assets/trunk_base.stl
cad/redesign/dynamixel/v1.0/mjcf/assets/upper_leg_right.stl
cad/redesign/dynamixel/v1.0/mjcf/assets/upper_leg_rigidity_plate.stl
cad/redesign/dynamixel/v1.0/mjcf/assets/xl330.stl
cad/redesign/dynamixel/v1.0/mjcf/assets/yaw_roll_motion.stl
cad/redesign/dynamixel/v1.0/parts/ankle_left/ankle_left.stl
cad/redesign/dynamixel/v1.0/parts/ankle_right/ankle_right.stl
cad/redesign/dynamixel/v1.0/parts/banana_pcb_locker/banana_pcb_locker.stl
cad/redesign/dynamixel/v1.0/parts/bearing_10x15x3/bearing_10x15x3.stl
cad/redesign/dynamixel/v1.0/parts/bearing_16x22x4/bearing_16x22x4.stl
cad/redesign/dynamixel/v1.0/parts/bearing_roll/bearing_roll.dxf
cad/redesign/dynamixel/v1.0/parts/bearing_roll/bearing_roll.stl
cad/redesign/dynamixel/v1.0/parts/bottom_head_shell/bottom_head_shell.stl
cad/redesign/dynamixel/v1.0/parts/elec_rpi_robot_hat_pcb/elec_rpi_robot_hat_pcb.stl
cad/redesign/dynamixel/v1.0/parts/face_part/face_part.stl
cad/redesign/dynamixel/v1.0/parts/foot_left/foot_left.stl
cad/redesign/dynamixel/v1.0/parts/foot_right/foot_right.stl
cad/redesign/dynamixel/v1.0/parts/hip_l/hip_l.stl
cad/redesign/dynamixel/v1.0/parts/jaw/jaw.stl
cad/redesign/dynamixel/v1.0/parts/jaw_soft/jaw_soft.stl
cad/redesign/dynamixel/v1.0/parts/left_shell/left_shell.stl
cad/redesign/dynamixel/v1.0/parts/leg/leg.stl
cad/redesign/dynamixel/v1.0/parts/lens/lens.stl
cad/redesign/dynamixel/v1.0/parts/m12_lens_holder/m12_lens_holder.stl
cad/redesign/dynamixel/v1.0/parts/motor_support/motor_support.stl
cad/redesign/dynamixel/v1.0/parts/neck/neck.dxf
cad/redesign/dynamixel/v1.0/parts/neck/neck.stl
cad/redesign/dynamixel/v1.0/parts/neck_pitch/neck_pitch.stl
cad/redesign/dynamixel/v1.0/parts/noenoeil/noenoeil.stl
cad/redesign/dynamixel/v1.0/parts/np_f970/np_f970.stl
cad/redesign/dynamixel/v1.0/parts/pcb__raspberry_pi_zero_2_w/pcb__raspberry_pi_zero_2_w.stl
cad/redesign/dynamixel/v1.0/parts/power_support/power_support.stl
cad/redesign/dynamixel/v1.0/parts/right_shell/right_shell.stl
cad/redesign/dynamixel/v1.0/parts/soft_mouth_top/soft_mouth_top.stl
cad/redesign/dynamixel/v1.0/parts/sole_left/sole_left.stl
cad/redesign/dynamixel/v1.0/parts/sole_right/sole_right.stl
cad/redesign/dynamixel/v1.0/parts/speaker/speaker.stl
cad/redesign/dynamixel/v1.0/parts/top_head_shell/top_head_shell.stl
cad/redesign/dynamixel/v1.0/parts/trunk_base/trunk_base.dxf
cad/redesign/dynamixel/v1.0/parts/trunk_base/trunk_base.stl
cad/redesign/dynamixel/v1.0/parts/upper_leg_left/upper_leg_left.stl
cad/redesign/dynamixel/v1.0/parts/upper_leg_right/upper_leg_right.stl
cad/redesign/dynamixel/v1.0/parts/upper_leg_rigidity_plate/upper_leg_rigidity_plate.dxf
cad/redesign/dynamixel/v1.0/parts/upper_leg_rigidity_plate/upper_leg_rigidity_plate.stl
cad/redesign/dynamixel/v1.0/parts/xl330/xl330.stl
cad/redesign/dynamixel/v1.0/parts/yaw2roll/yaw2roll.stl
cad/redesign/dynamixel/v1.0/parts/yaw_roll_motion/yaw_roll_motion.stl
cad/redesign/hobby_servo/v1.0/parts/623ZZ/623ZZ.step
cad/redesign/hobby_servo/v1.0/parts/623ZZ/623ZZ.stl
cad/redesign/hobby_servo/v1.0/parts/6704ZZ/6704ZZ.stl
cad/redesign/hobby_servo/v1.0/parts/6706ZZ/6706ZZ.step
cad/redesign/hobby_servo/v1.0/parts/6706ZZ/6706ZZ.stl
cad/redesign/hobby_servo/v1.0/parts/MG90S/MG90S.stl
cad/redesign/hobby_servo/v1.0/parts/MG996R/MG996R.step
cad/redesign/hobby_servo/v1.0/parts/MG996R/MG996R.stl
cad/redesign/hobby_servo/v1.0/parts/bottom_head_shell/bottom_head_shell.step
cad/redesign/hobby_servo/v1.0/parts/bottom_head_shell/bottom_head_shell.stl
cad/redesign/hobby_servo/v1.0/parts/face_part/face_part.step
cad/redesign/hobby_servo/v1.0/parts/face_part/face_part.stl
cad/redesign/hobby_servo/v1.0/parts/head_frame/head_frame.step
cad/redesign/hobby_servo/v1.0/parts/head_frame/head_frame.stl
cad/redesign/hobby_servo/v1.0/parts/hip_l_left/hip_l_left.step
cad/redesign/hobby_servo/v1.0/parts/hip_l_left/hip_l_left.stl
cad/redesign/hobby_servo/v1.0/parts/hip_l_right/hip_l_right.step
cad/redesign/hobby_servo/v1.0/parts/hip_l_right/hip_l_right.stl
cad/redesign/hobby_servo/v1.0/parts/horn_20T_metal/horn_20T_metal.stl
cad/redesign/hobby_servo/v1.0/parts/horn_25T_alu/horn_25T_alu.step
cad/redesign/hobby_servo/v1.0/parts/horn_25T_alu/horn_25T_alu.stl
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
