lsk0522/microduck/cad/redesign/tools/build/bearing_roll_preview.png

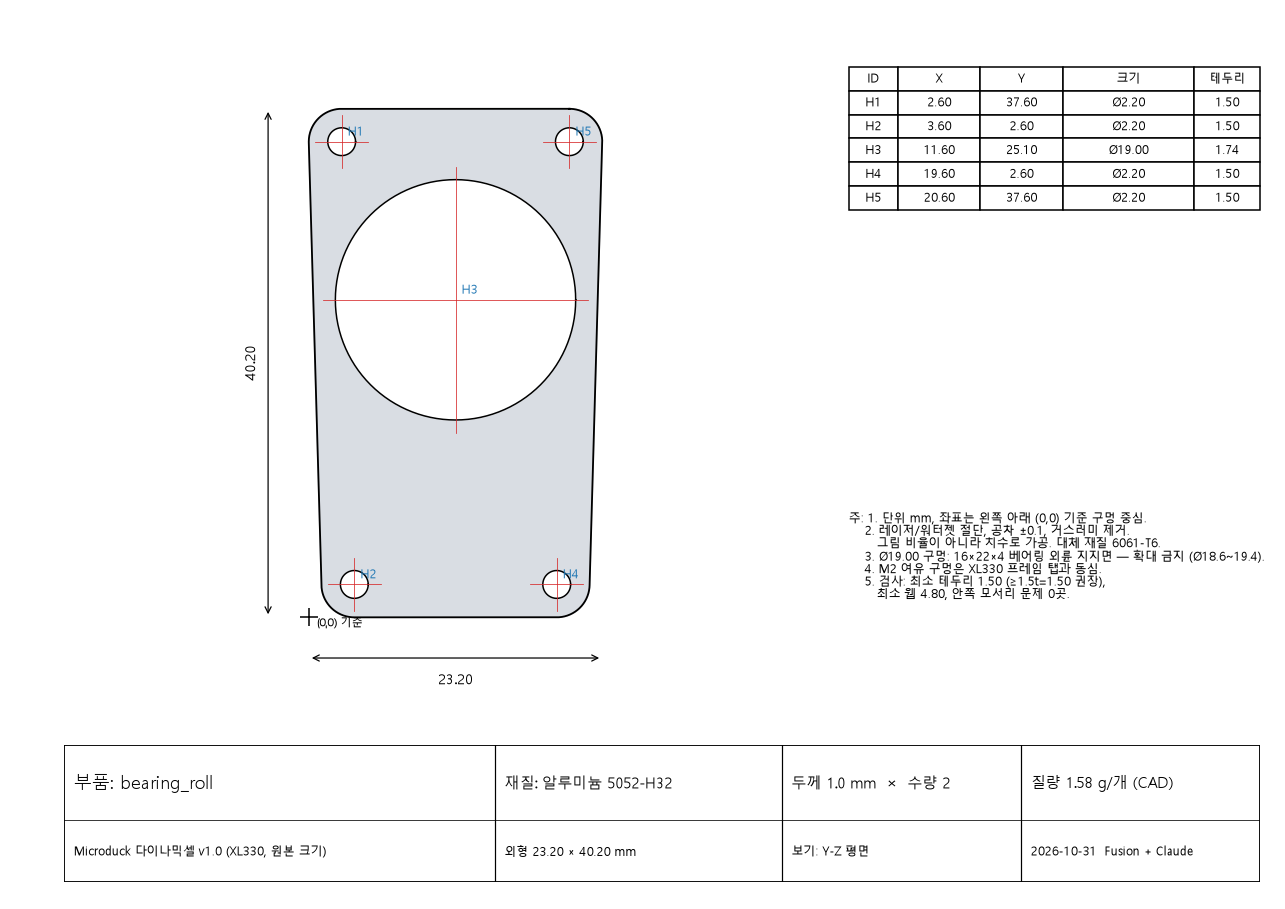
cad/redesign/tools/build/bearing_roll_preview.png
