lsk0522/microduck/cad/redesign/tools/build/feat/asm_compare.png

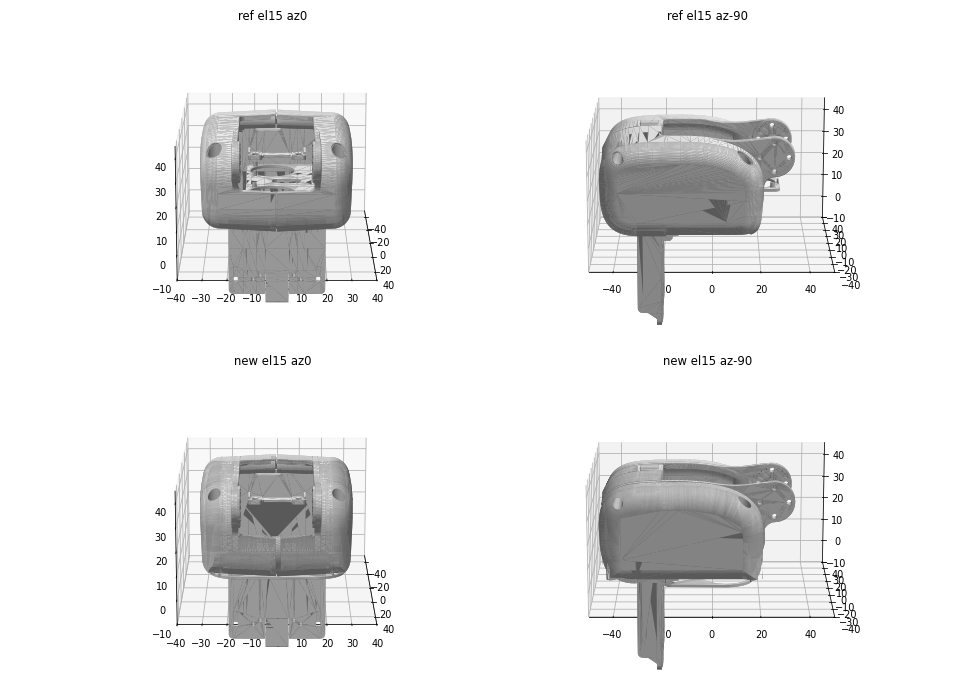
cad/redesign/tools/build/feat/asm_compare.png
