lsk0522/microduck/cad/redesign/tools/build/feat/bottom_head_shell_sec.png

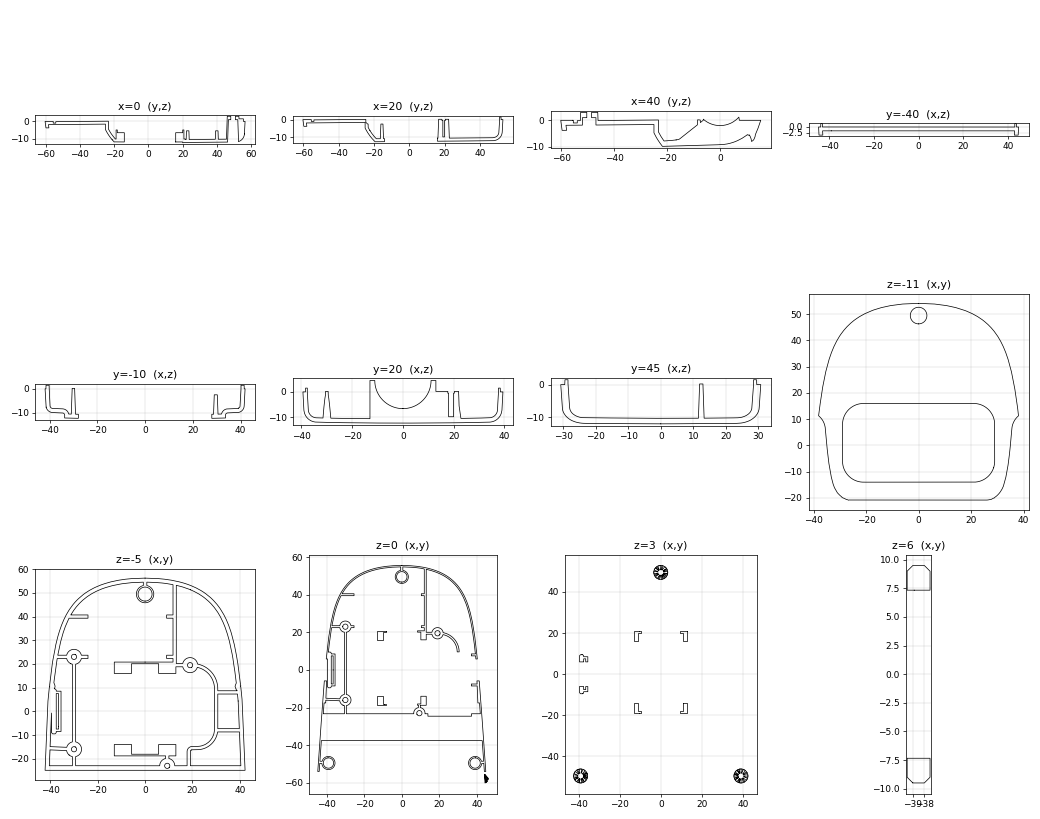
cad/redesign/tools/build/feat/bottom_head_shell_sec.png
