lsk0522/microduck/cad/redesign/tools/build/feat/face_part_sec.png

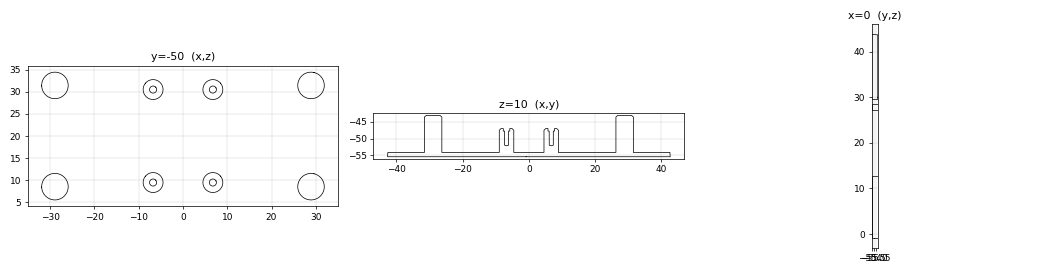
cad/redesign/tools/build/feat/face_part_sec.png
