lsk0522/microduck/cad/redesign/tools/build/feat/face_part_views.png

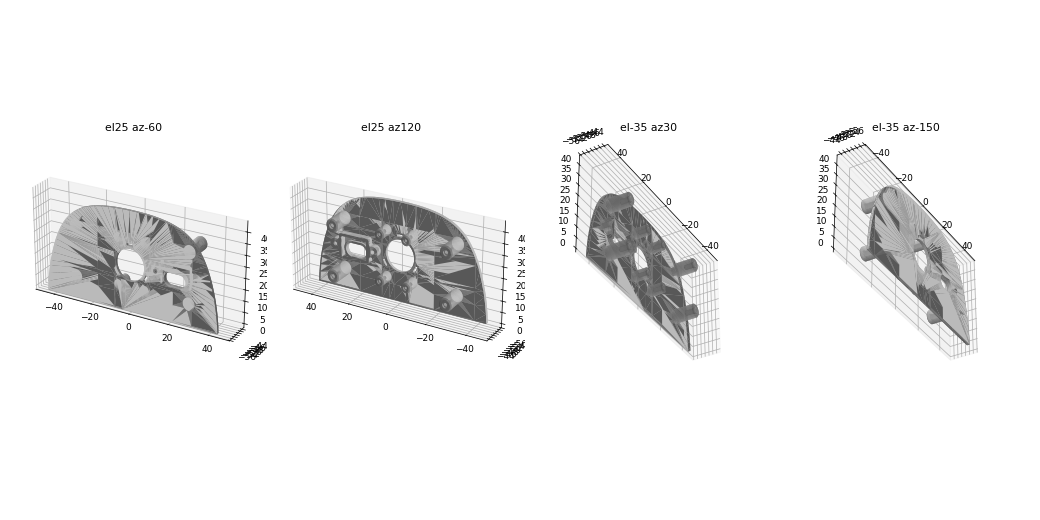
cad/redesign/tools/build/feat/face_part_views.png
