lsk0522/microduck/cad/redesign/tools/build/feat/foot_left_ovl.png

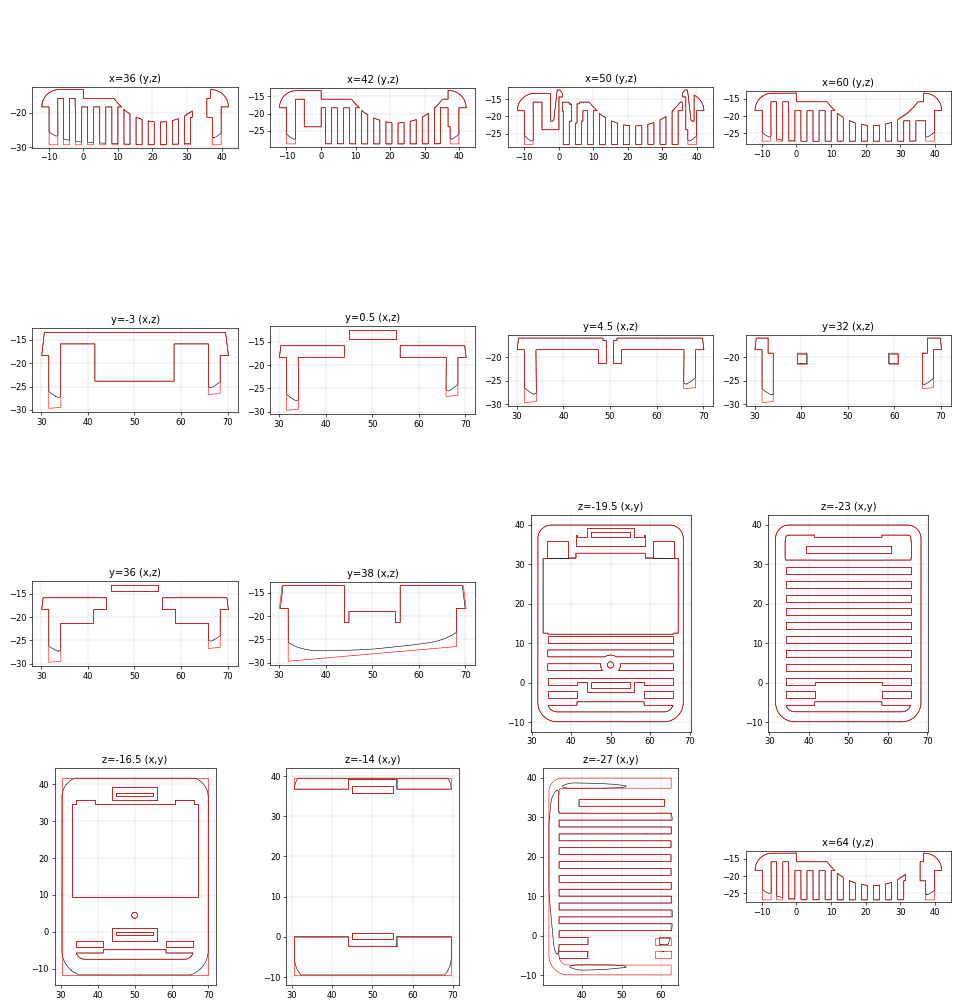
cad/redesign/tools/build/feat/foot_left_ovl.png
