lsk0522/microduck/cad/redesign/tools/build/feat/foot_x.png

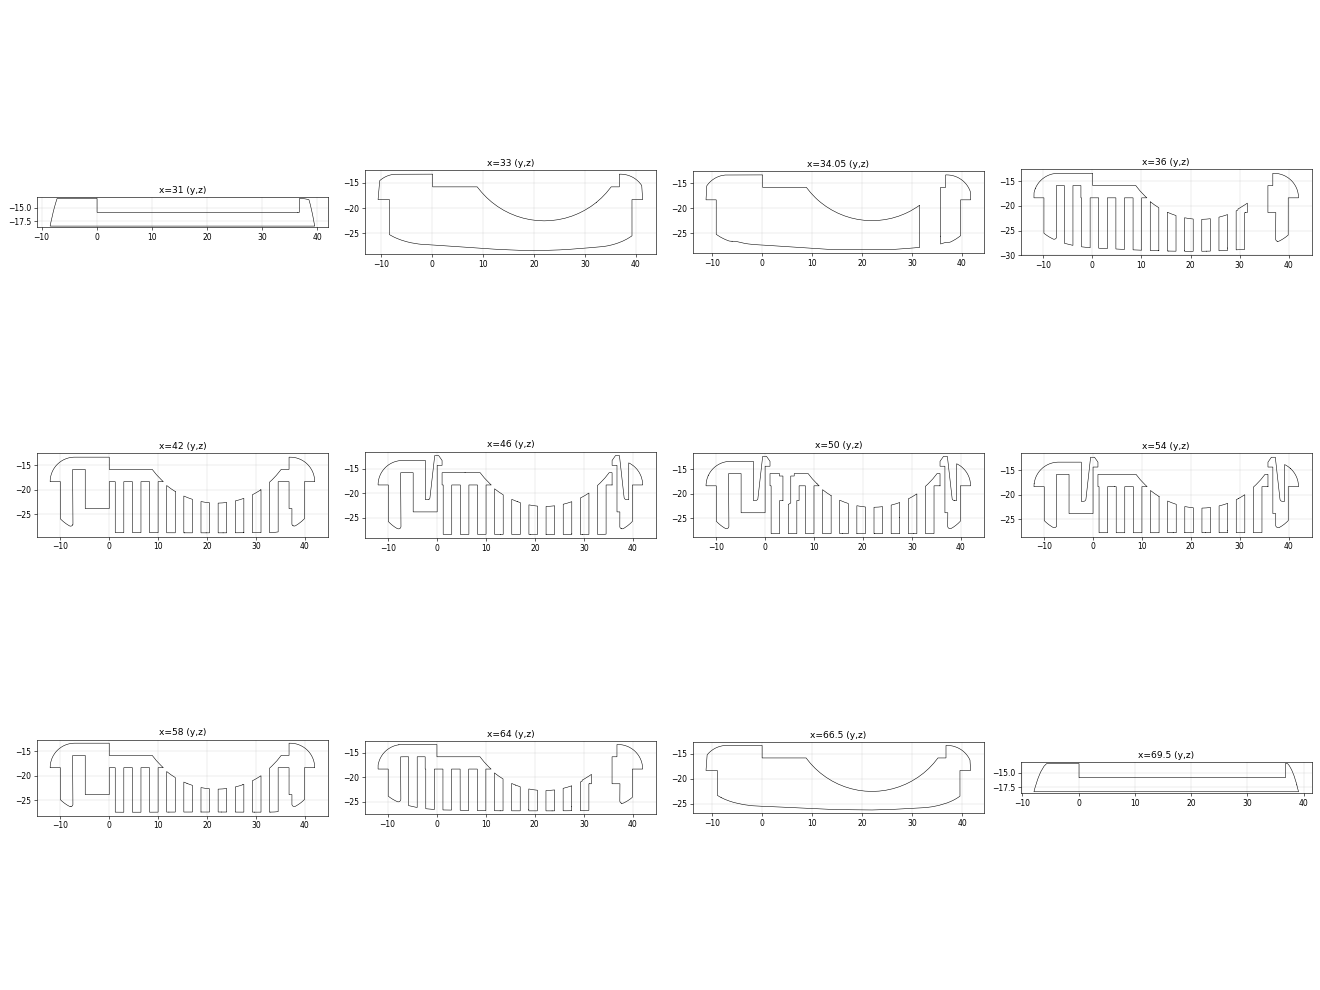
cad/redesign/tools/build/feat/foot_x.png
