lsk0522/microduck/cad/redesign/tools/build/feat/foot_y.png

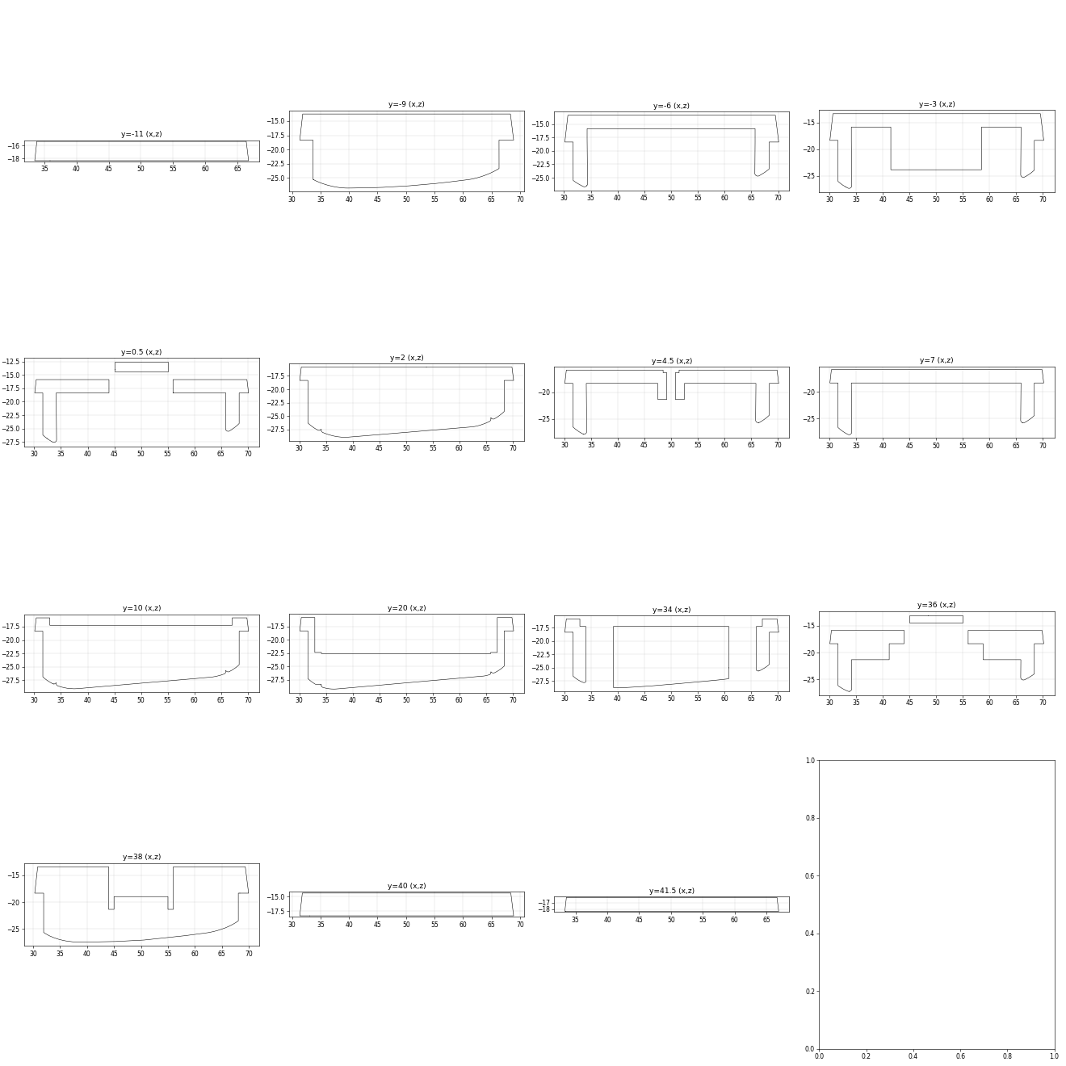
cad/redesign/tools/build/feat/foot_y.png
