lsk0522/microduck/cad/redesign/tools/build/feat/foot_z.png

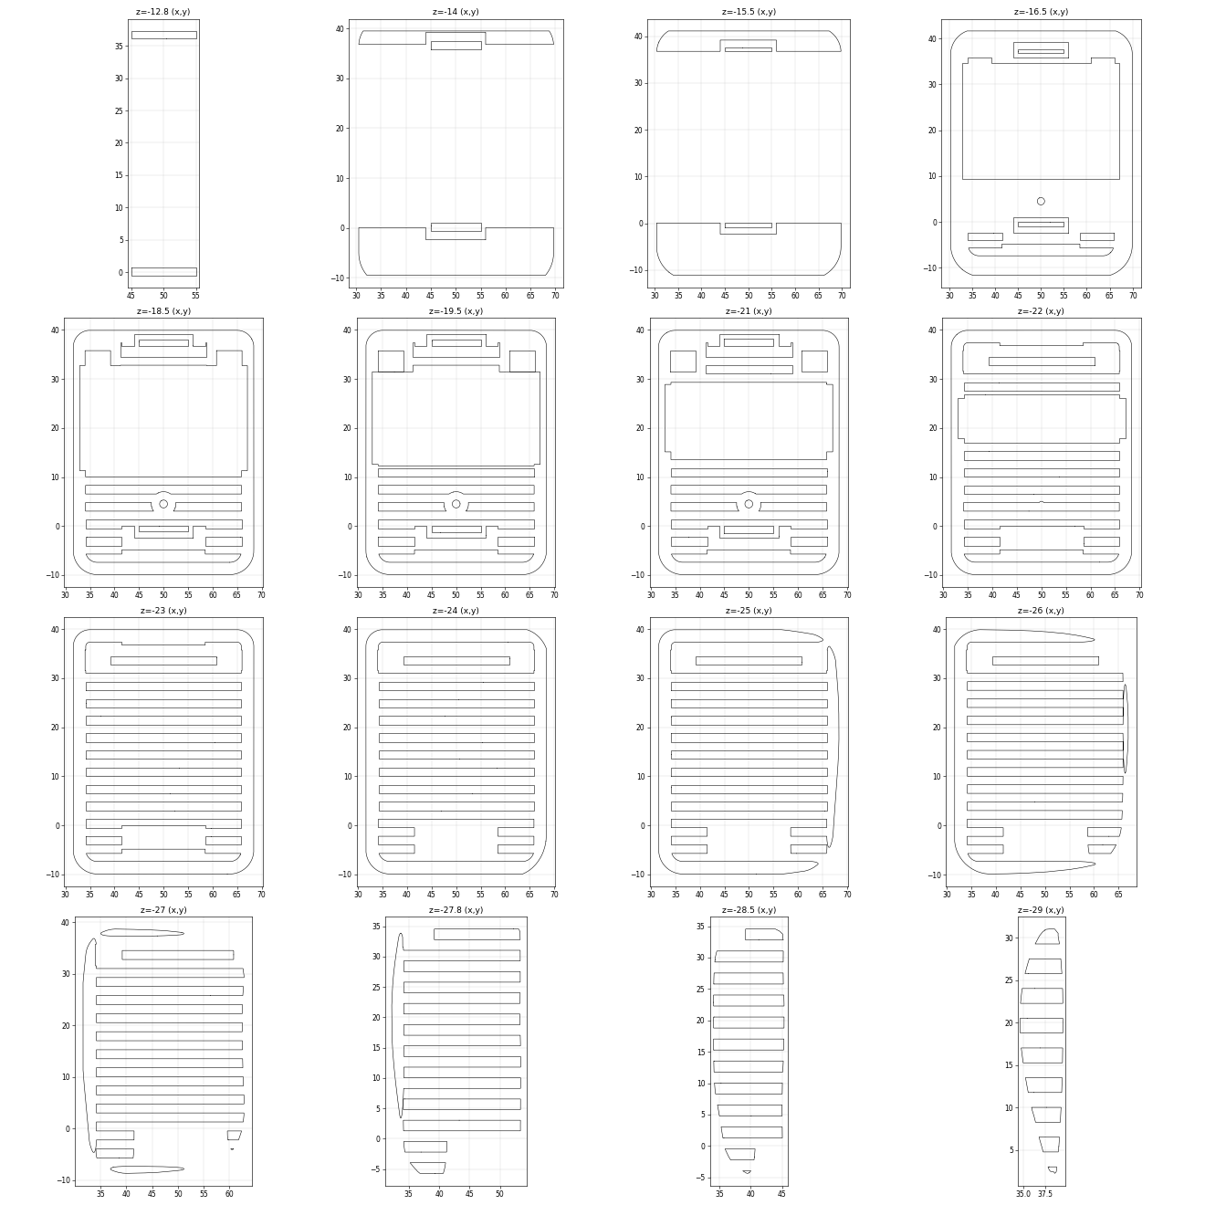
cad/redesign/tools/build/feat/foot_z.png
