lsk0522/microduck/cad/redesign/tools/build/feat/fp.png

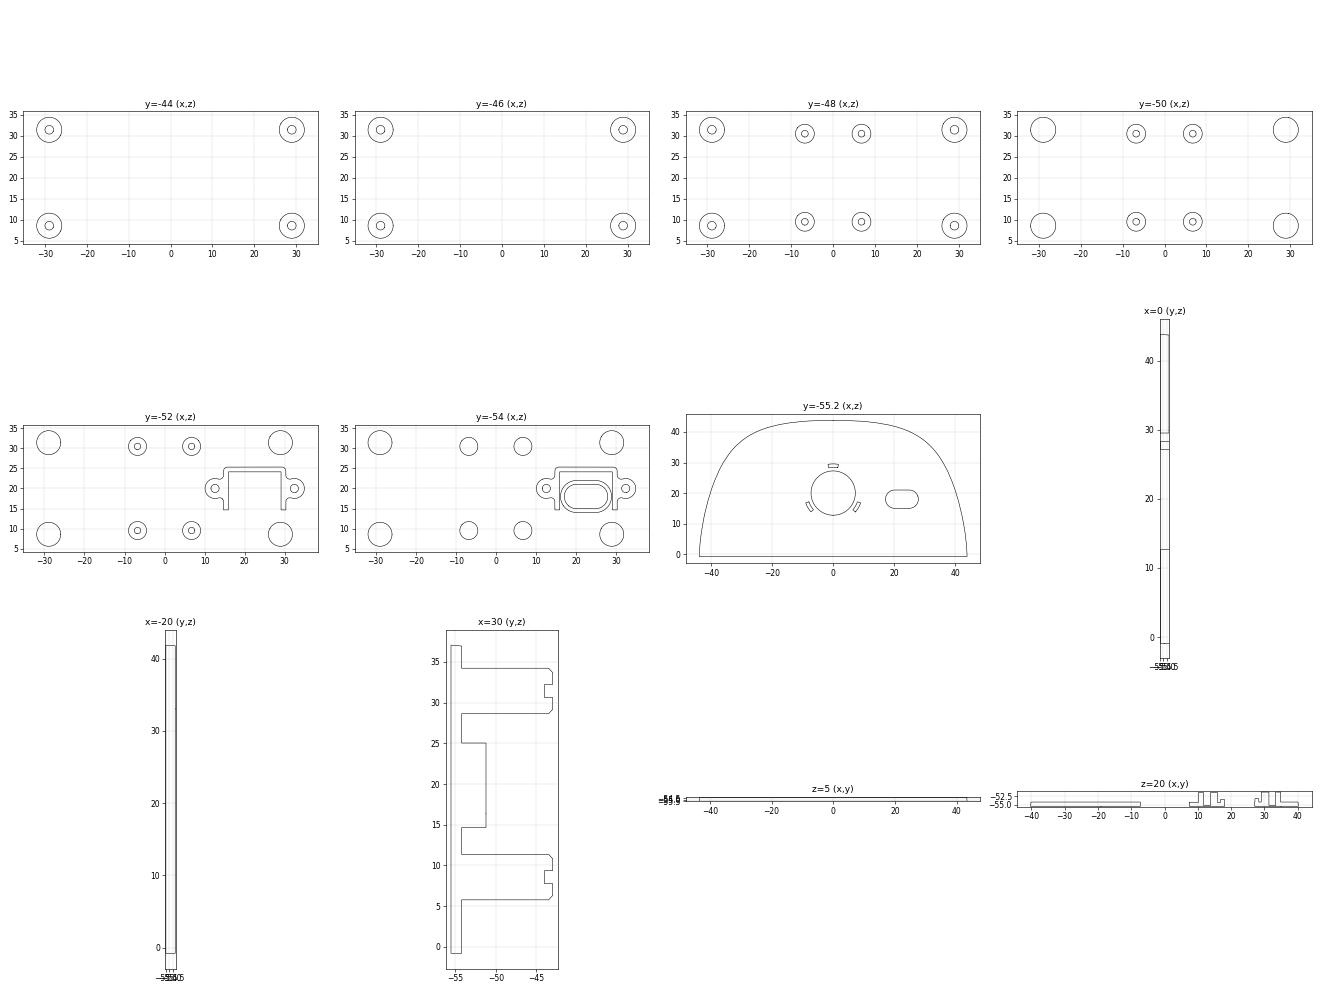
cad/redesign/tools/build/feat/fp.png
