lsk0522/microduck/cad/redesign/tools/build/feat/hip_a.png

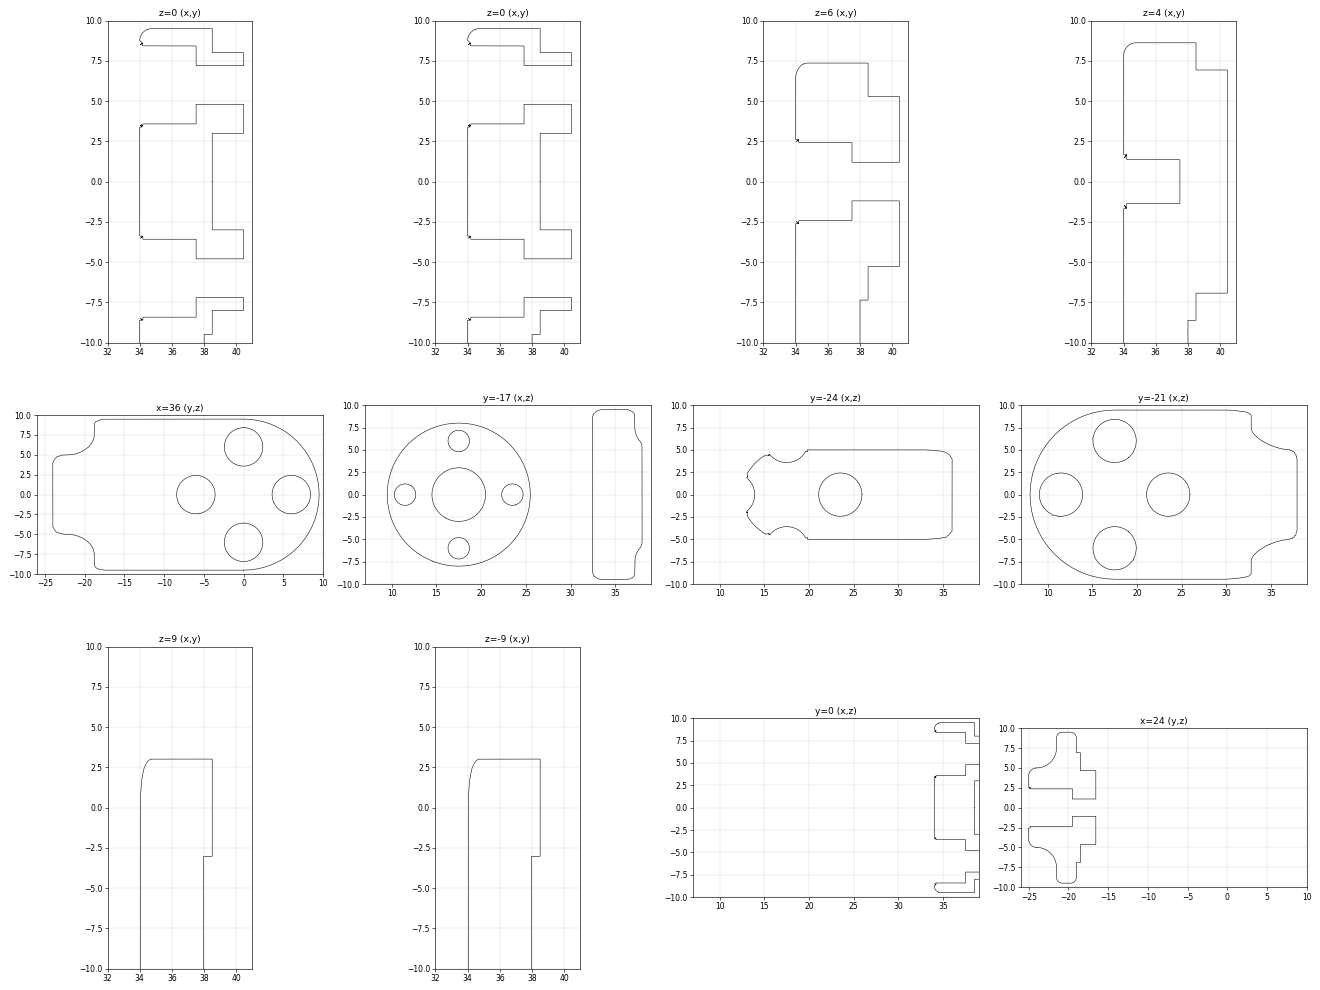
cad/redesign/tools/build/feat/hip_a.png
