lsk0522/microduck/cad/redesign/tools/build/feat/hip_l_sec.png

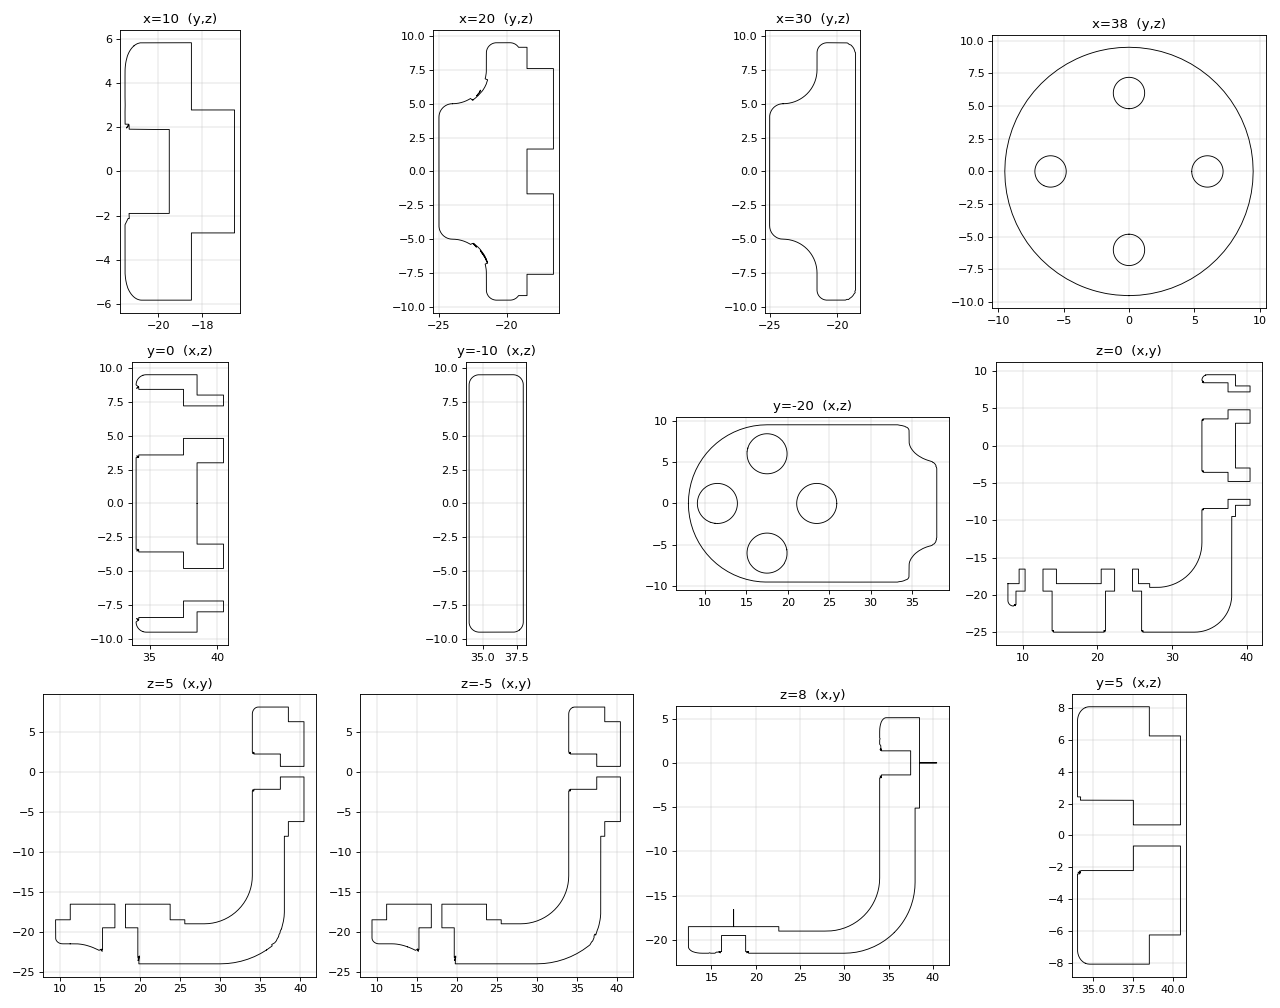
cad/redesign/tools/build/feat/hip_l_sec.png
