lsk0522/microduck/cad/redesign/tools/build/feat/jaw_arm.png

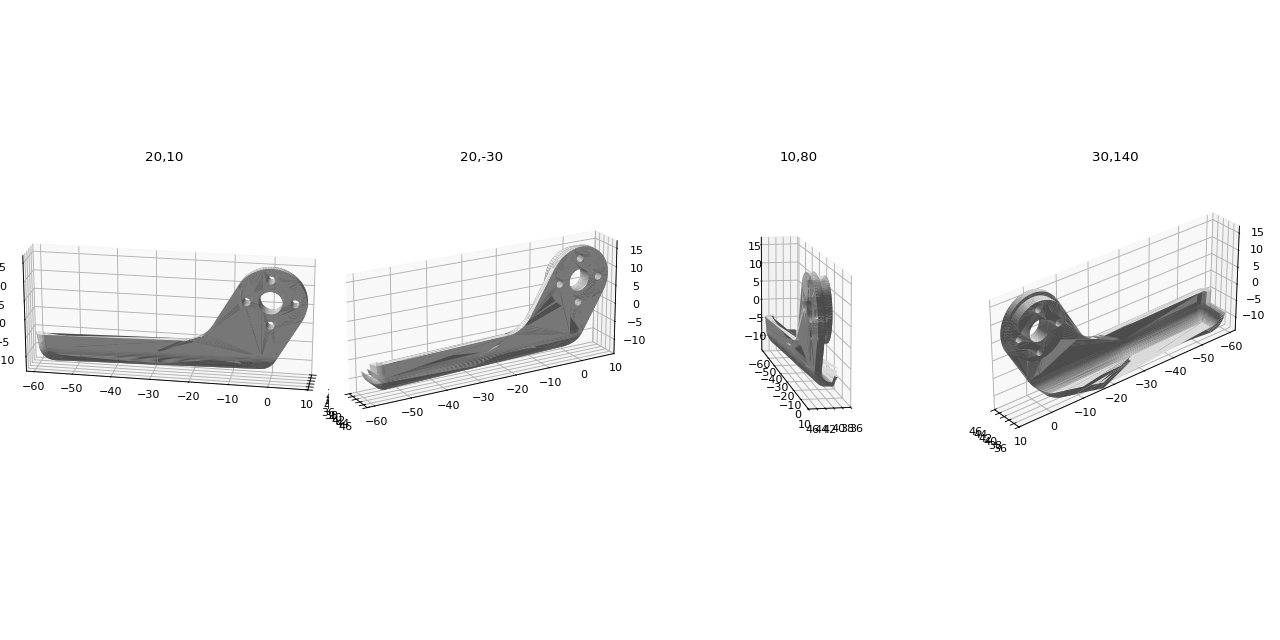
cad/redesign/tools/build/feat/jaw_arm.png
