lsk0522/microduck/cad/redesign/tools/build/feat/jaw_sec.png

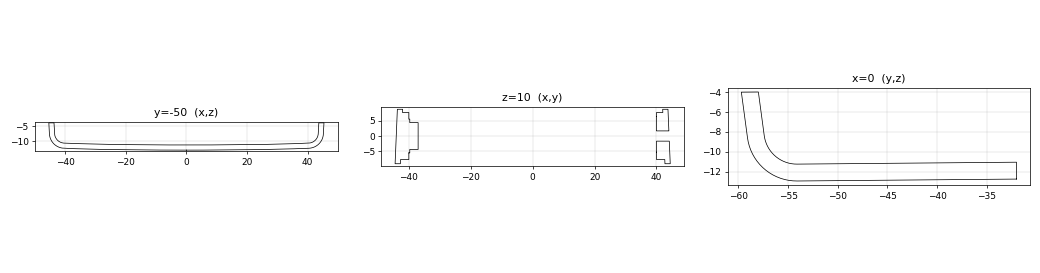
cad/redesign/tools/build/feat/jaw_sec.png
