lsk0522/microduck/cad/redesign/tools/build/feat/jaw_soft_sec.png

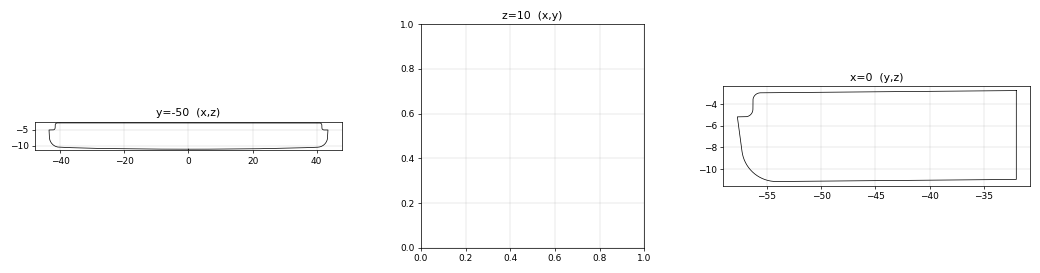
cad/redesign/tools/build/feat/jaw_soft_sec.png
