lsk0522/microduck/cad/redesign/tools/build/feat/jaw_soft_views.png

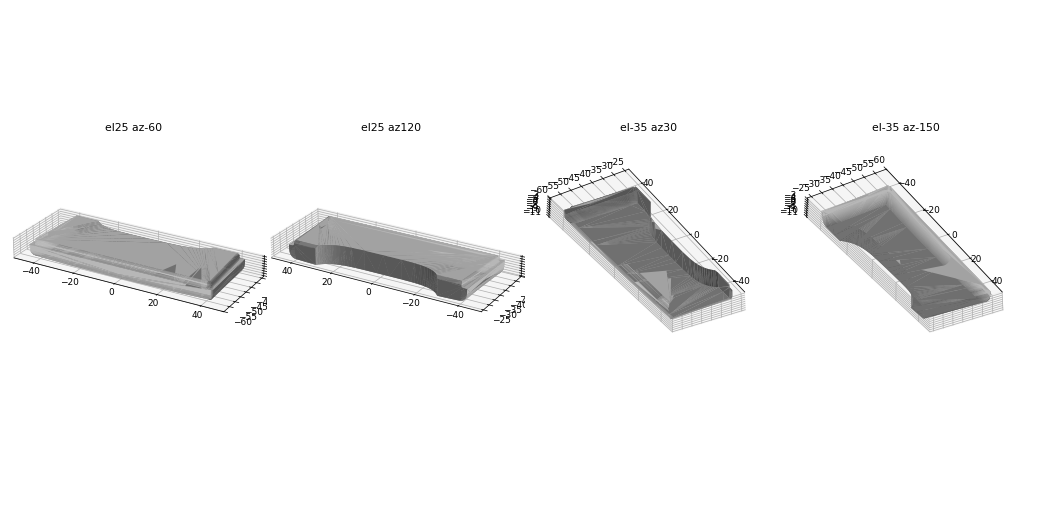
cad/redesign/tools/build/feat/jaw_soft_views.png
