lsk0522/microduck/cad/redesign/tools/build/feat/js.png

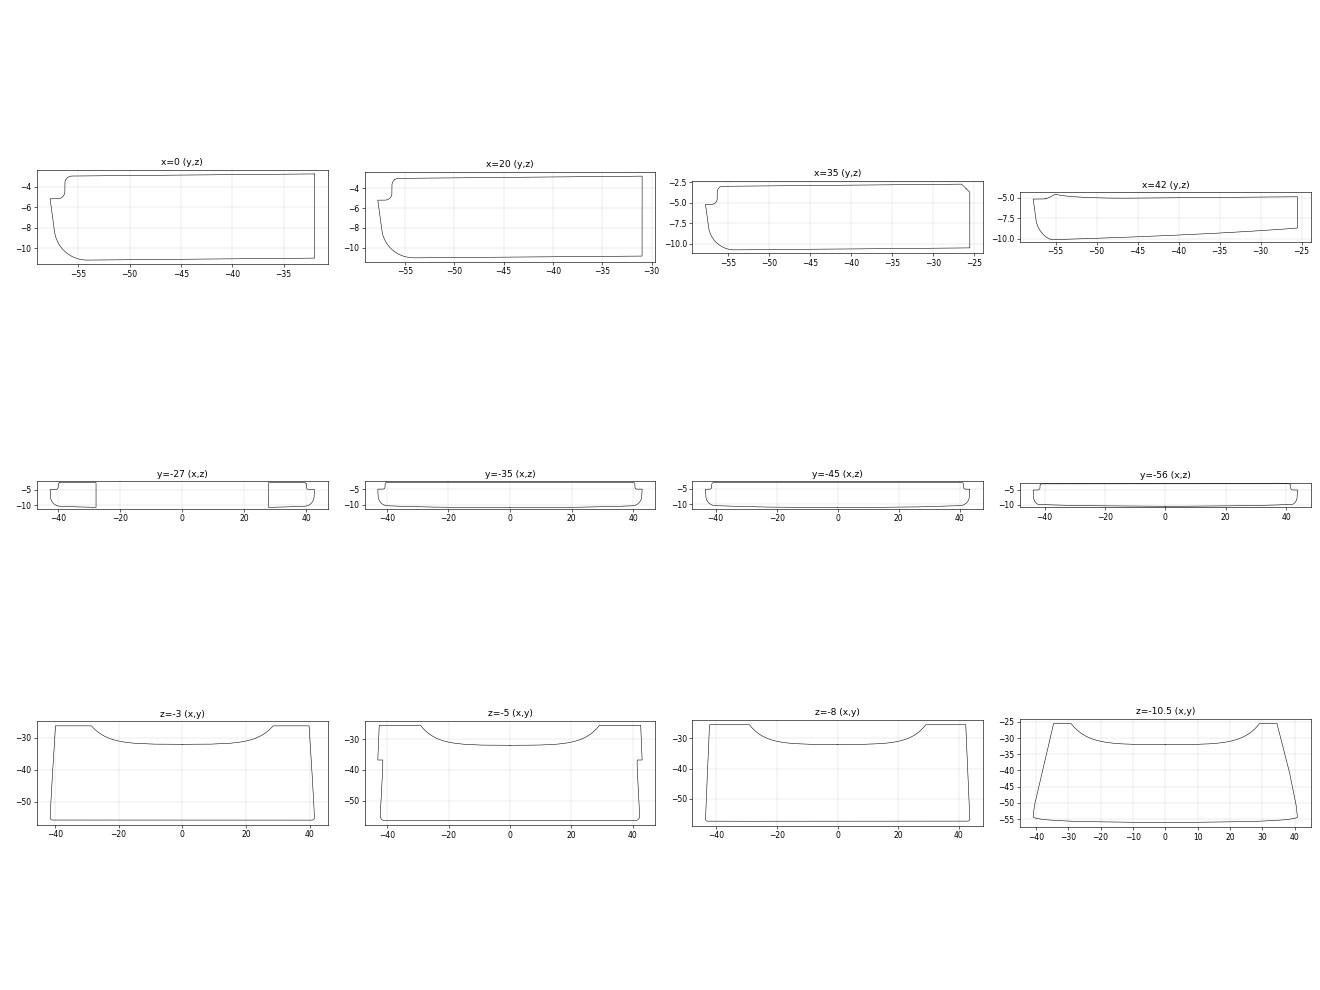
cad/redesign/tools/build/feat/js.png
