lsk0522/microduck/cad/redesign/tools/build/feat/jw2.png

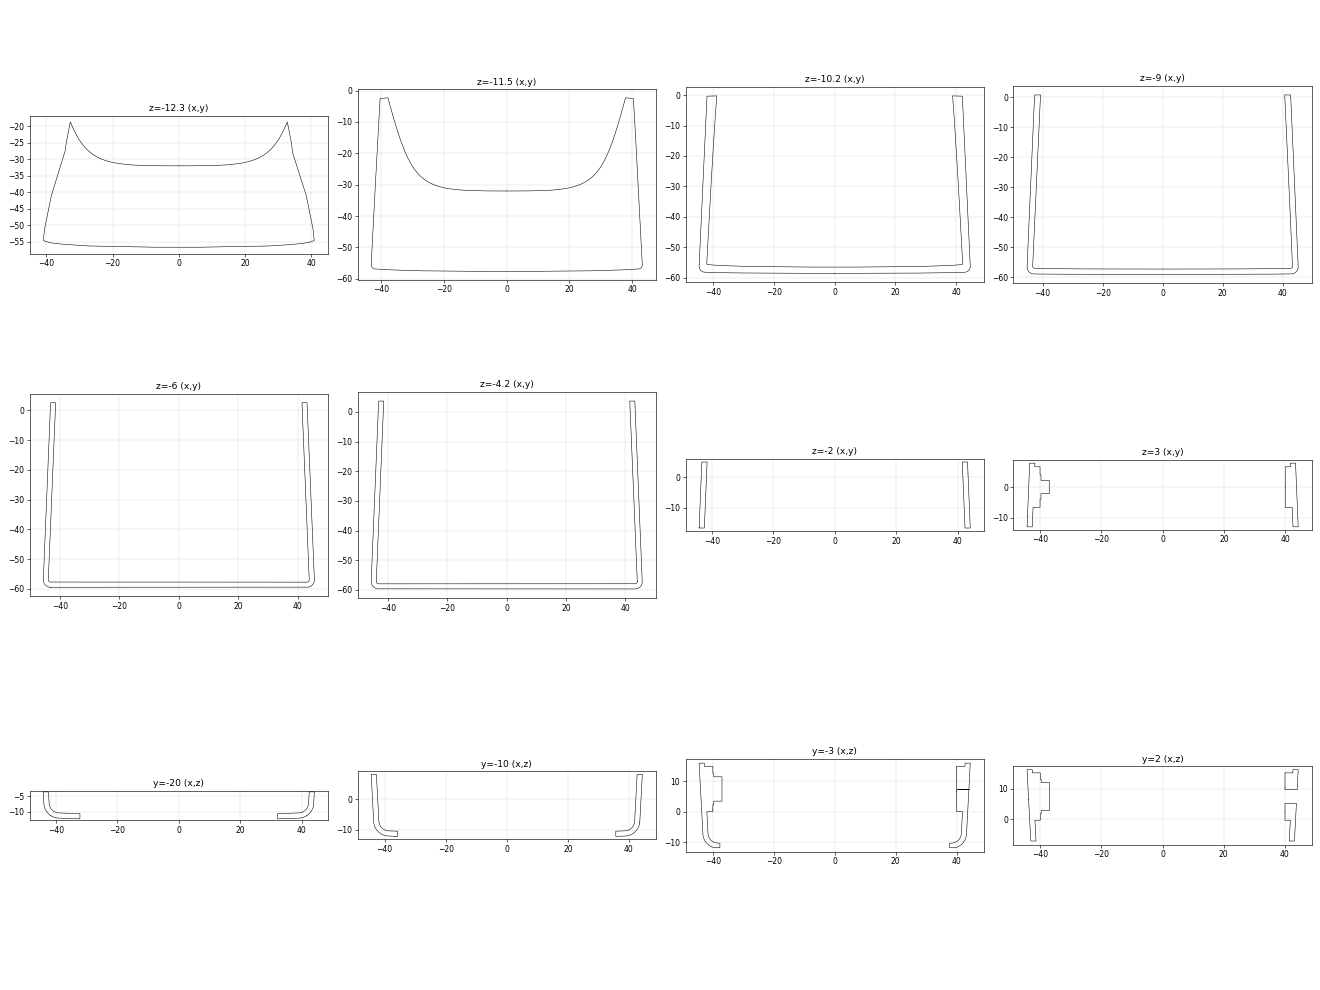
cad/redesign/tools/build/feat/jw2.png
