lsk0522/microduck/cad/redesign/tools/build/feat/jw.png

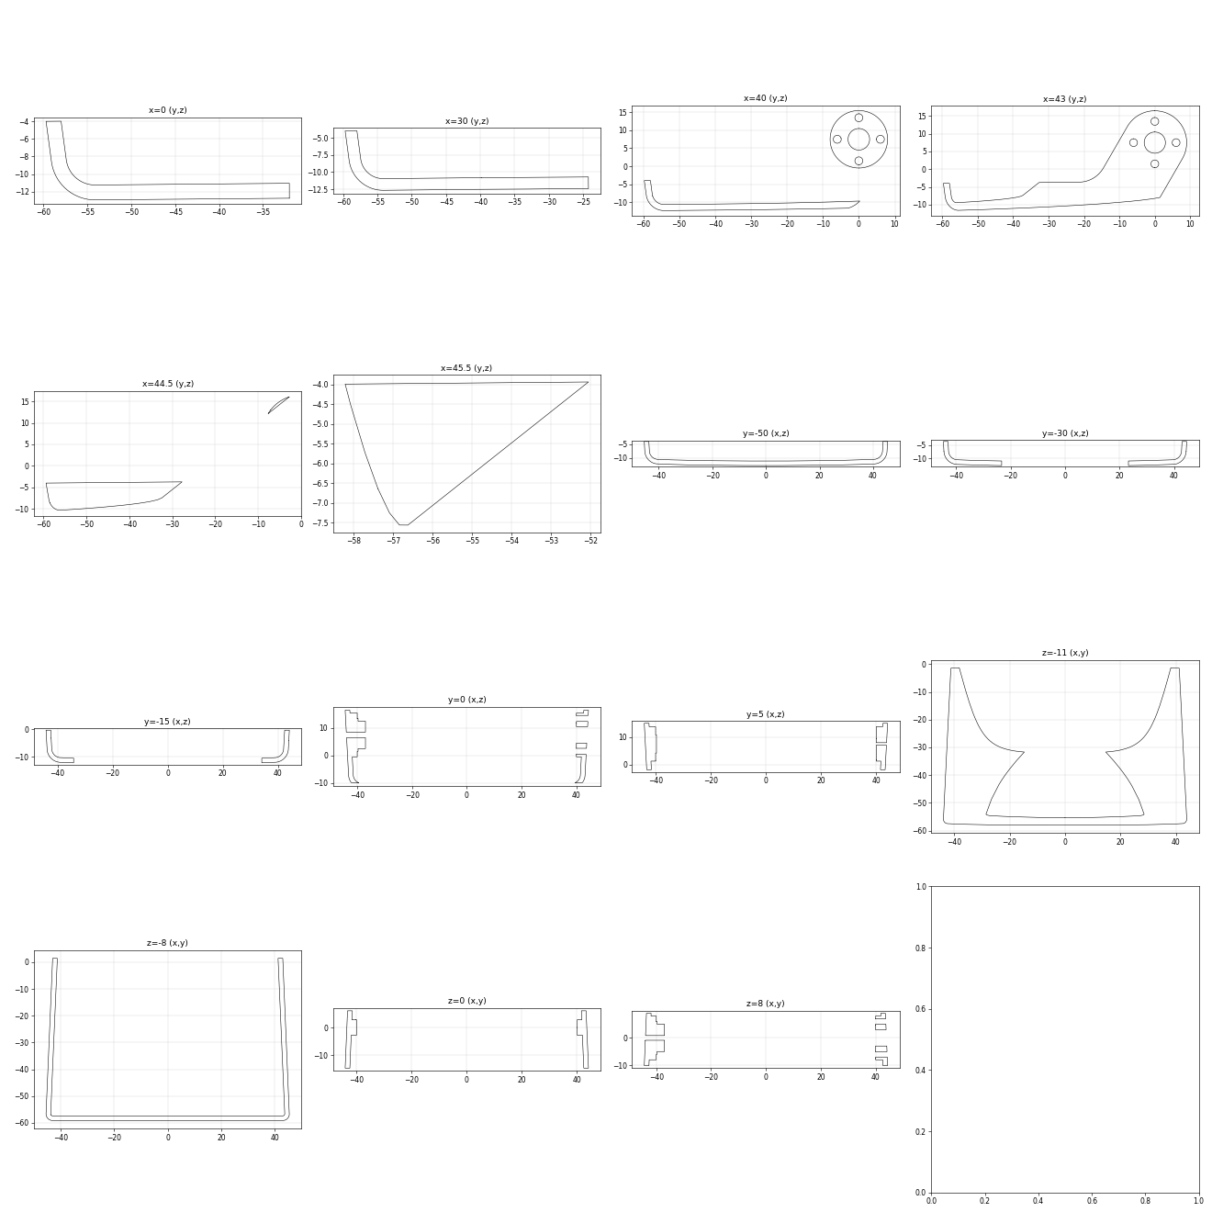
cad/redesign/tools/build/feat/jw.png
