lsk0522/microduck/cad/redesign/tools/build/feat/left_shell_dmap.png

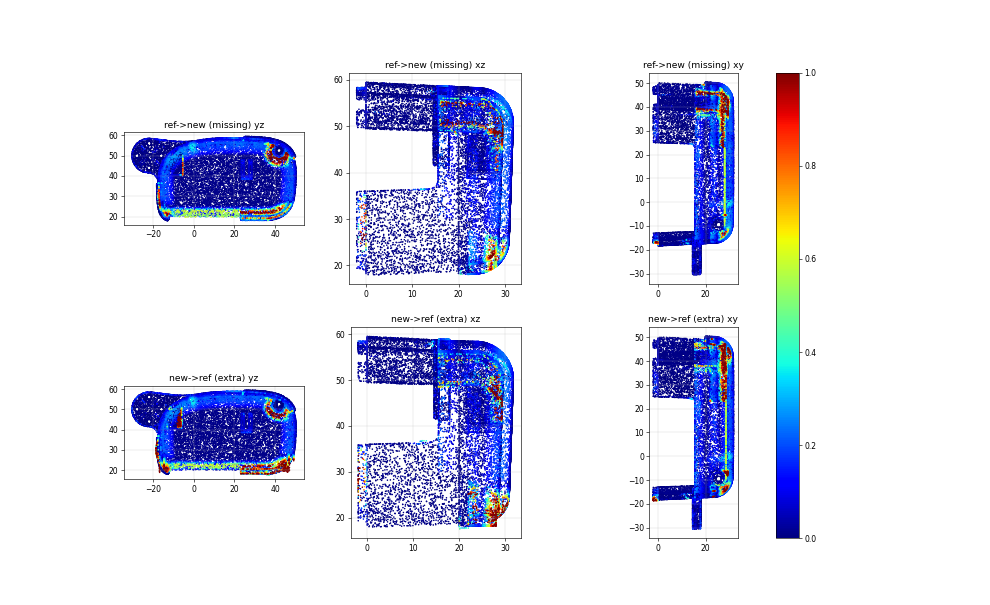
cad/redesign/tools/build/feat/left_shell_dmap.png
