lsk0522/microduck/cad/redesign/tools/build/feat/left_shell_sec.png

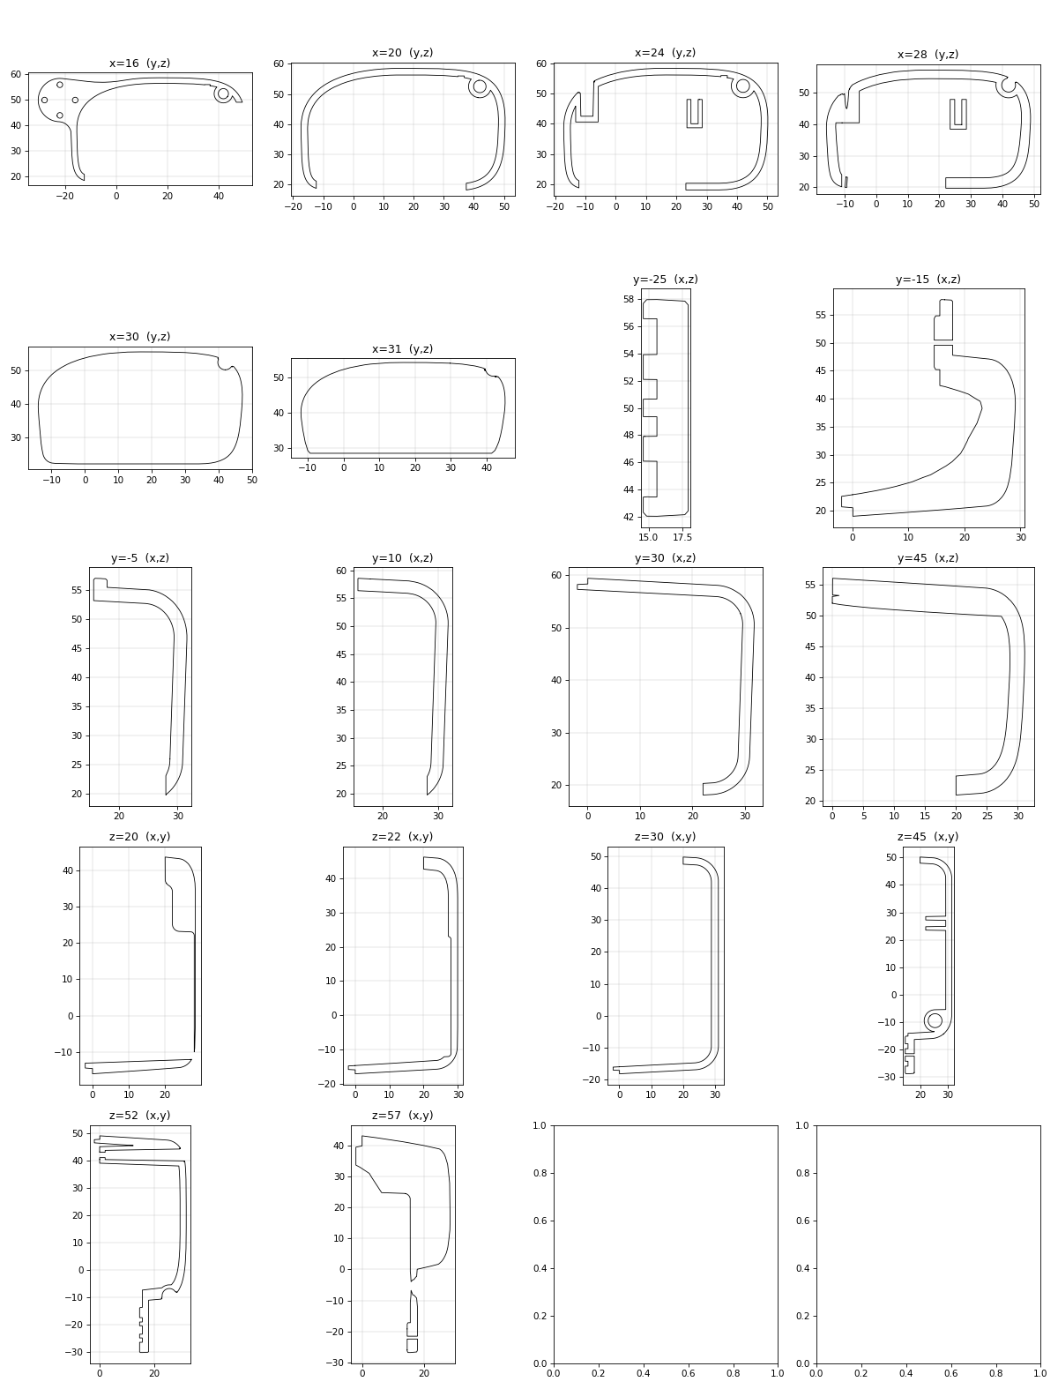
cad/redesign/tools/build/feat/left_shell_sec.png
