lsk0522/microduck/cad/redesign/tools/build/feat/ls_c2.png

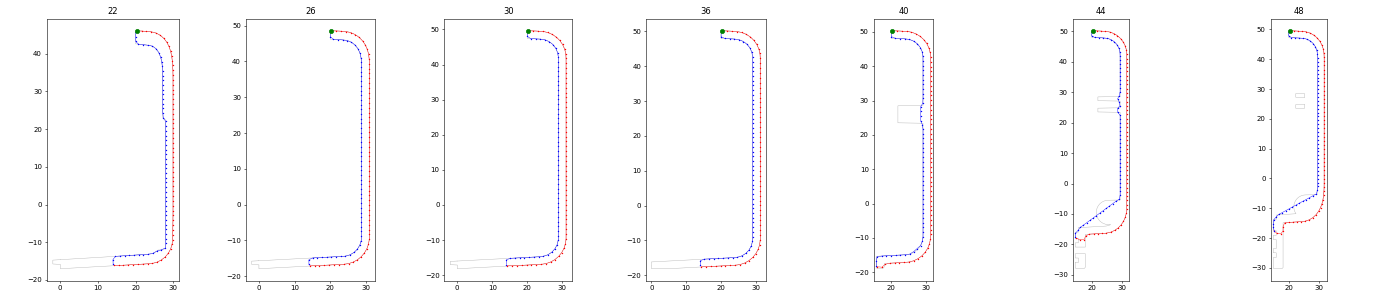
cad/redesign/tools/build/feat/ls_c2.png
