lsk0522/microduck/cad/redesign/tools/build/feat/ls_c3.png

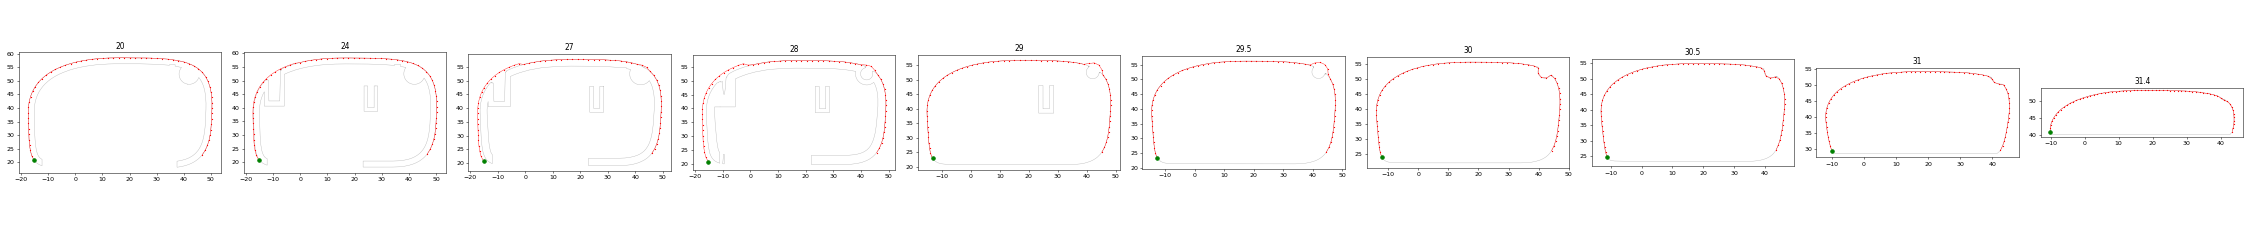
cad/redesign/tools/build/feat/ls_c3.png
