lsk0522/microduck/cad/redesign/tools/build/feat/ls_curves.png

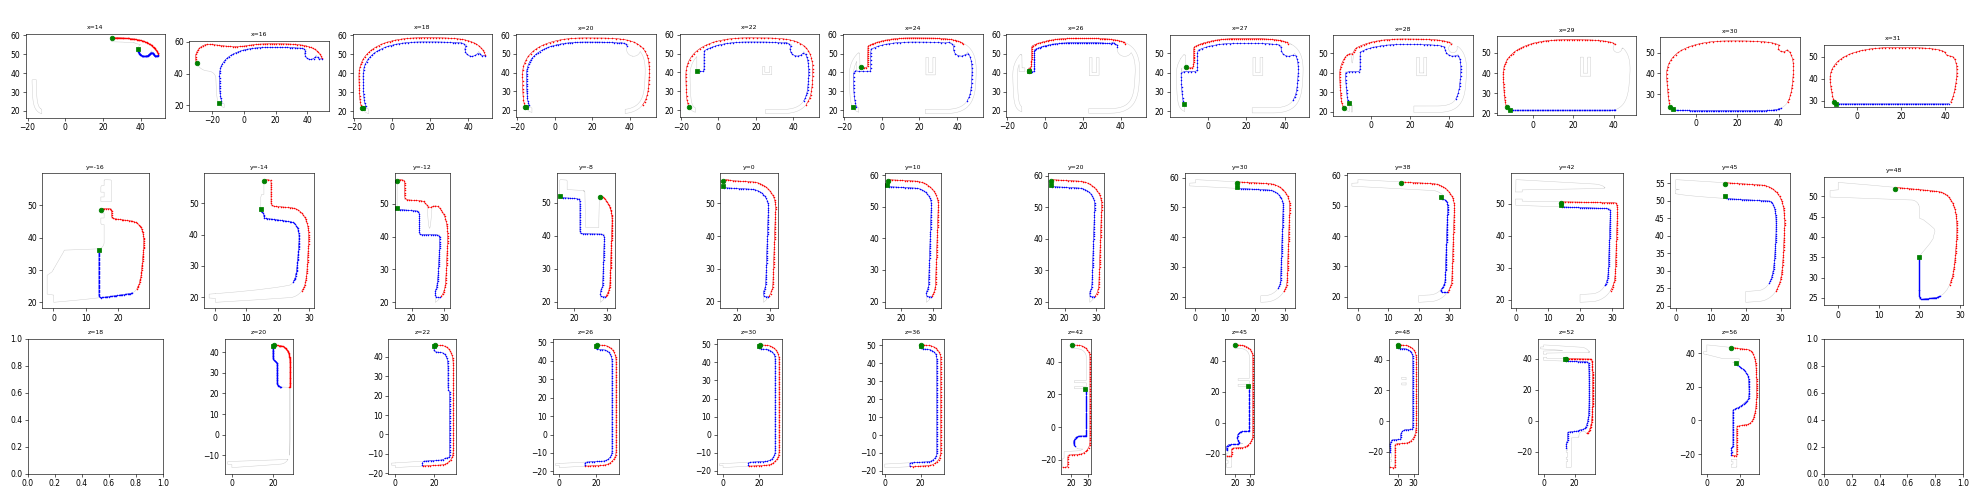
cad/redesign/tools/build/feat/ls_curves.png
