lsk0522/microduck/cad/redesign/tools/build/feat/ls_dbg.png

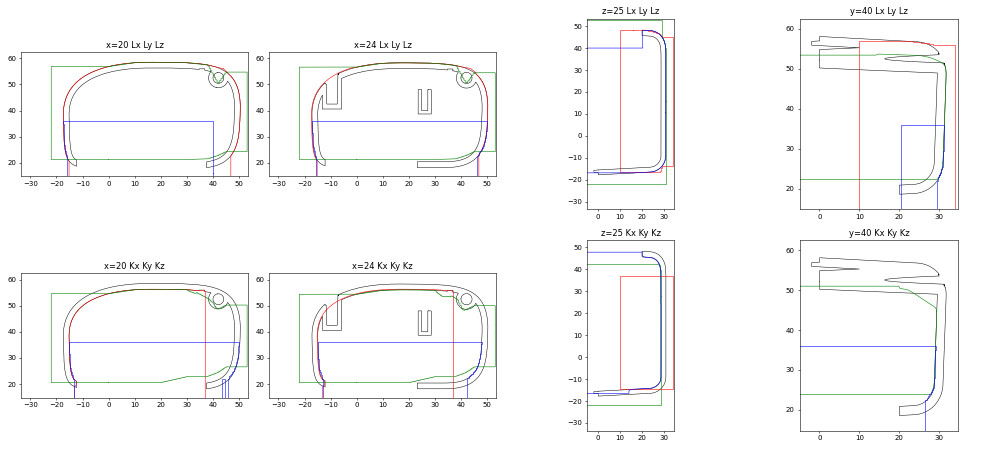
cad/redesign/tools/build/feat/ls_dbg.png
