lsk0522/microduck/cad/redesign/tools/build/feat/ls_inner.png

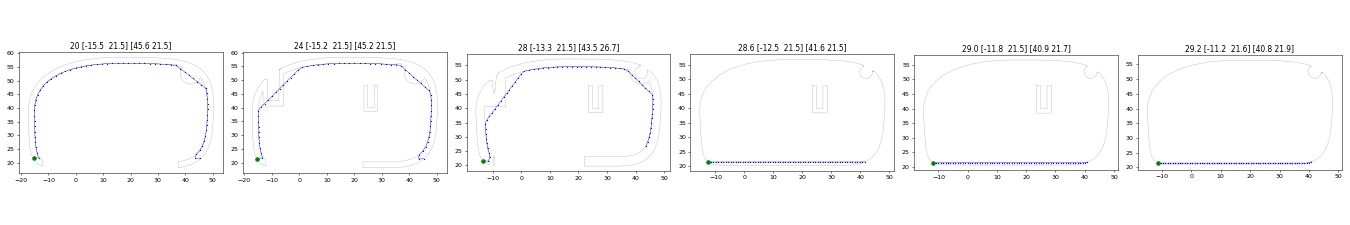
cad/redesign/tools/build/feat/ls_inner.png
