lsk0522/microduck/cad/redesign/tools/build/feat/m12_lens_holder_sec.png

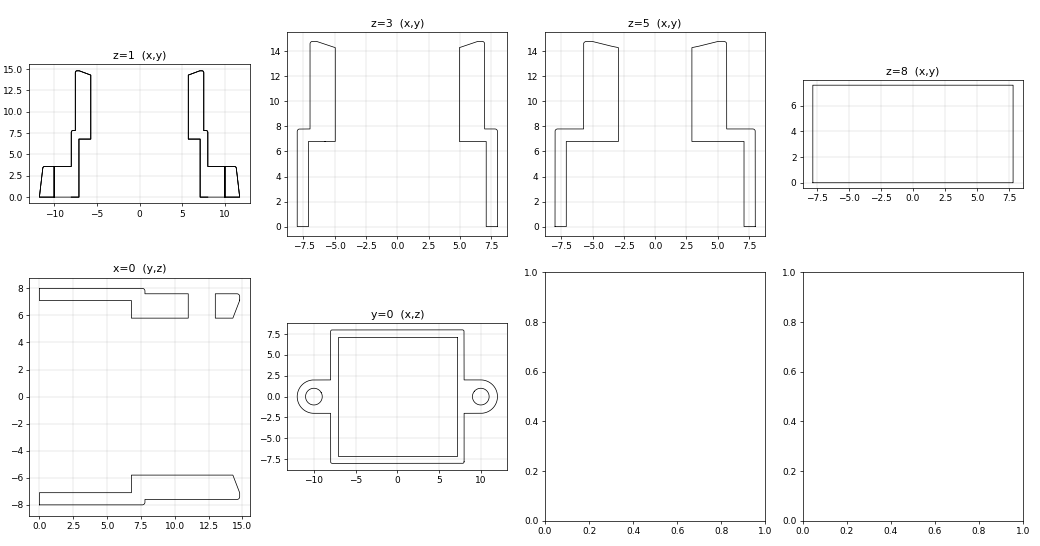
cad/redesign/tools/build/feat/m12_lens_holder_sec.png
