lsk0522/microduck/cad/redesign/tools/build/feat/motor_support_ovlz.png

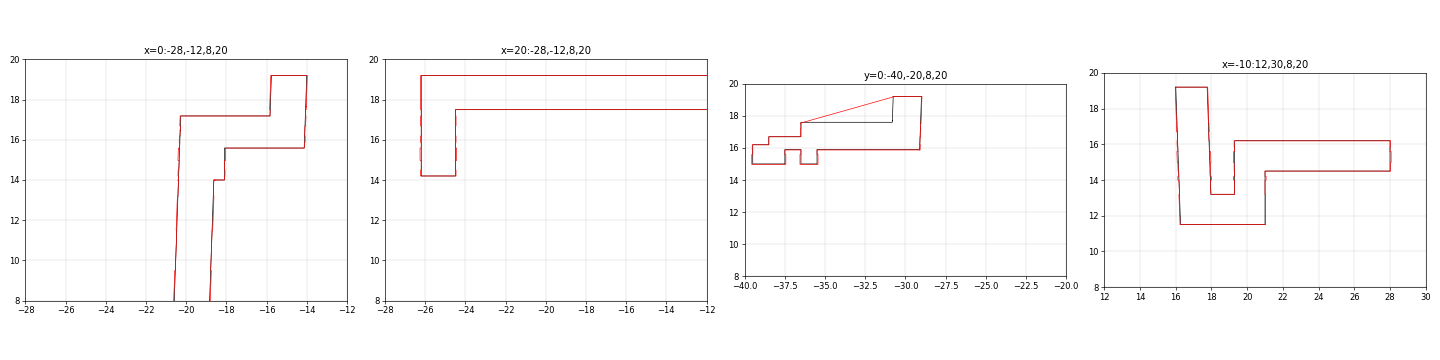
cad/redesign/tools/build/feat/motor_support_ovlz.png
