lsk0522/microduck/cad/redesign/tools/build/feat/motor_support_sec.png

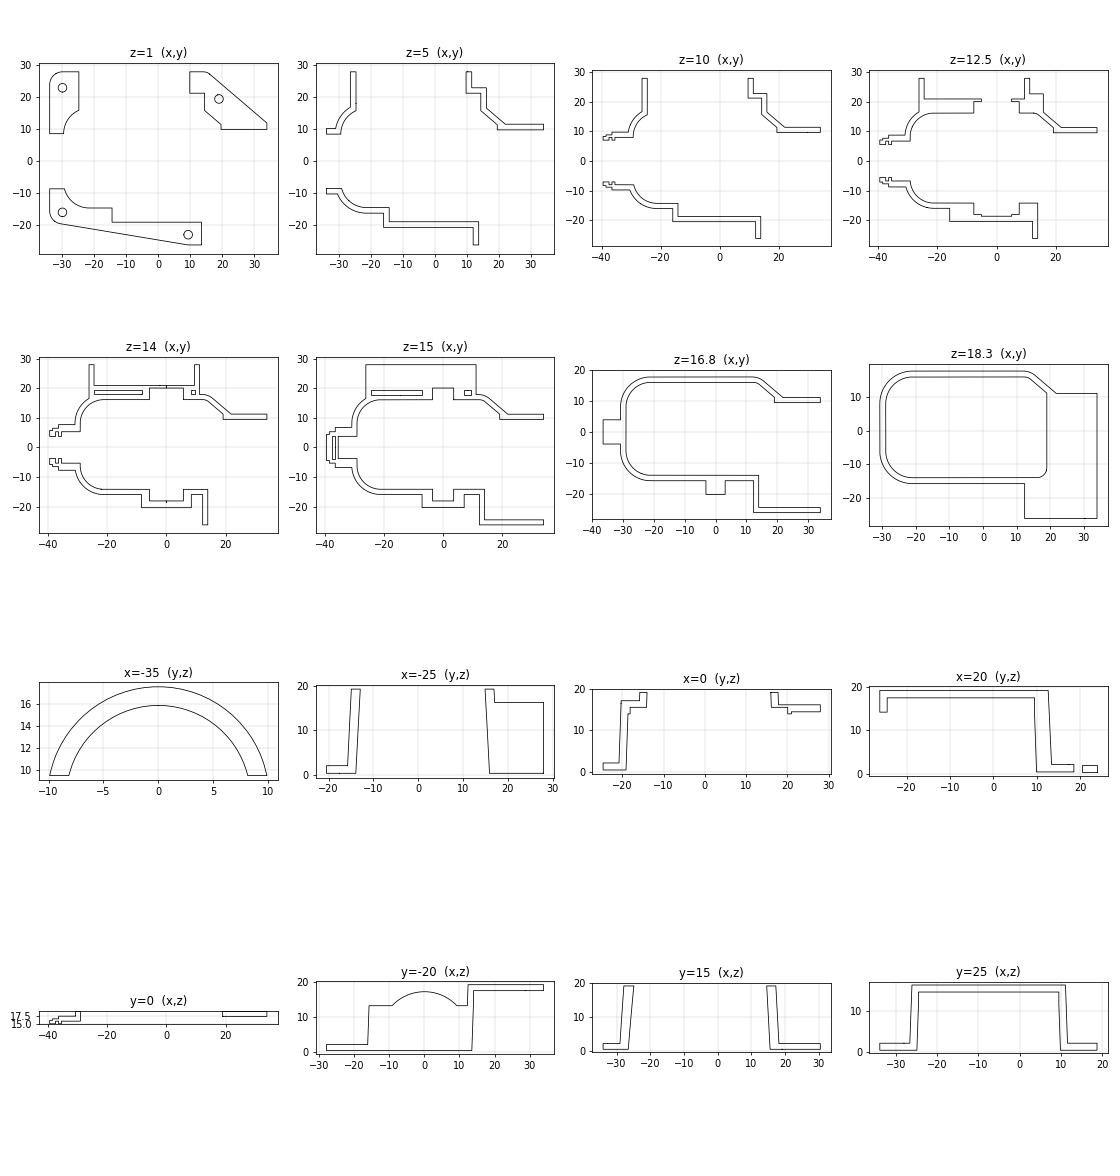
cad/redesign/tools/build/feat/motor_support_sec.png
