lsk0522/microduck/cad/redesign/tools/build/feat/np_sec.png

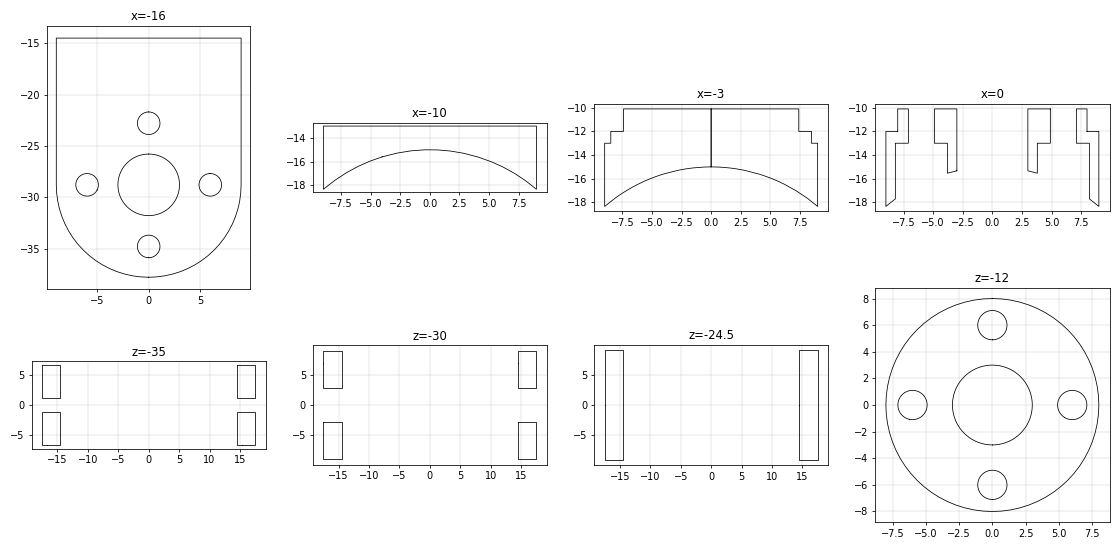
cad/redesign/tools/build/feat/np_sec.png
