lsk0522/microduck/cad/redesign/tools/build/feat/power_support_sec.png

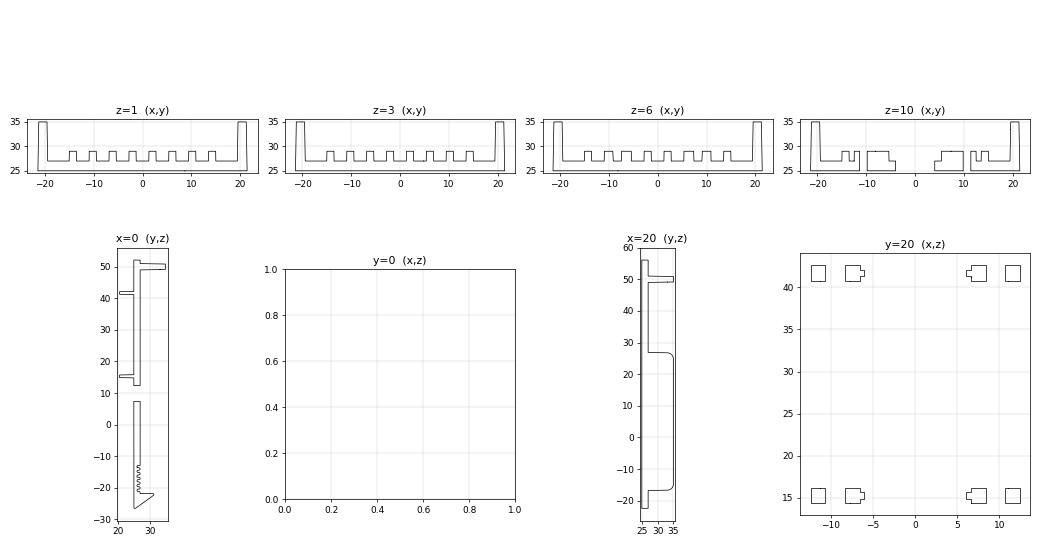
cad/redesign/tools/build/feat/power_support_sec.png
