lsk0522/microduck/cad/redesign/tools/build/feat/ps_a.png

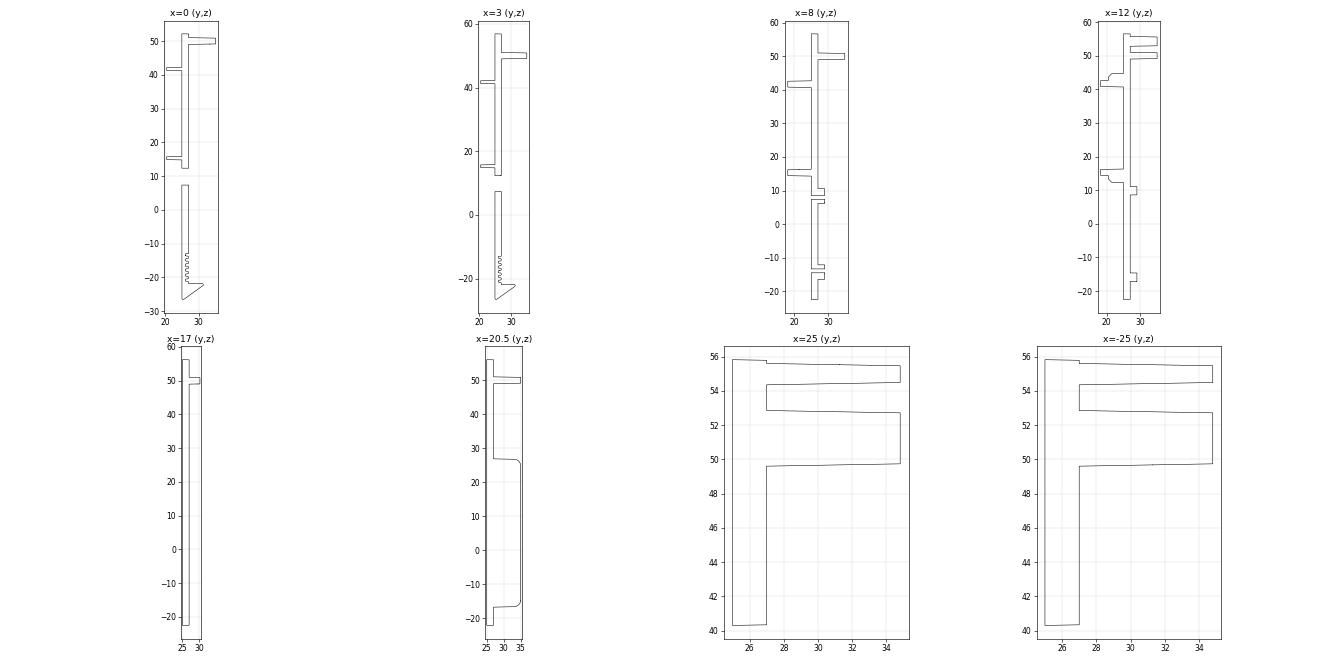
cad/redesign/tools/build/feat/ps_a.png
