lsk0522/microduck/cad/redesign/tools/build/feat/ps_b.png

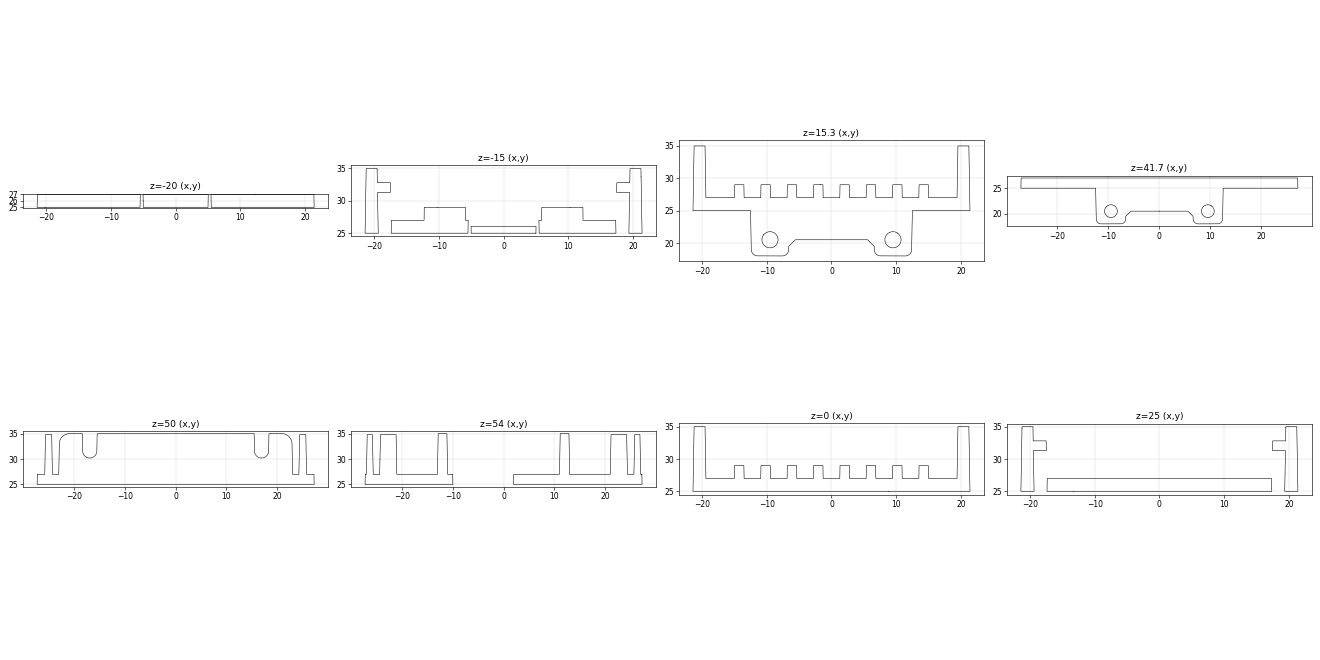
cad/redesign/tools/build/feat/ps_b.png
