lsk0522/microduck/cad/redesign/tools/build/feat/ps_c.png

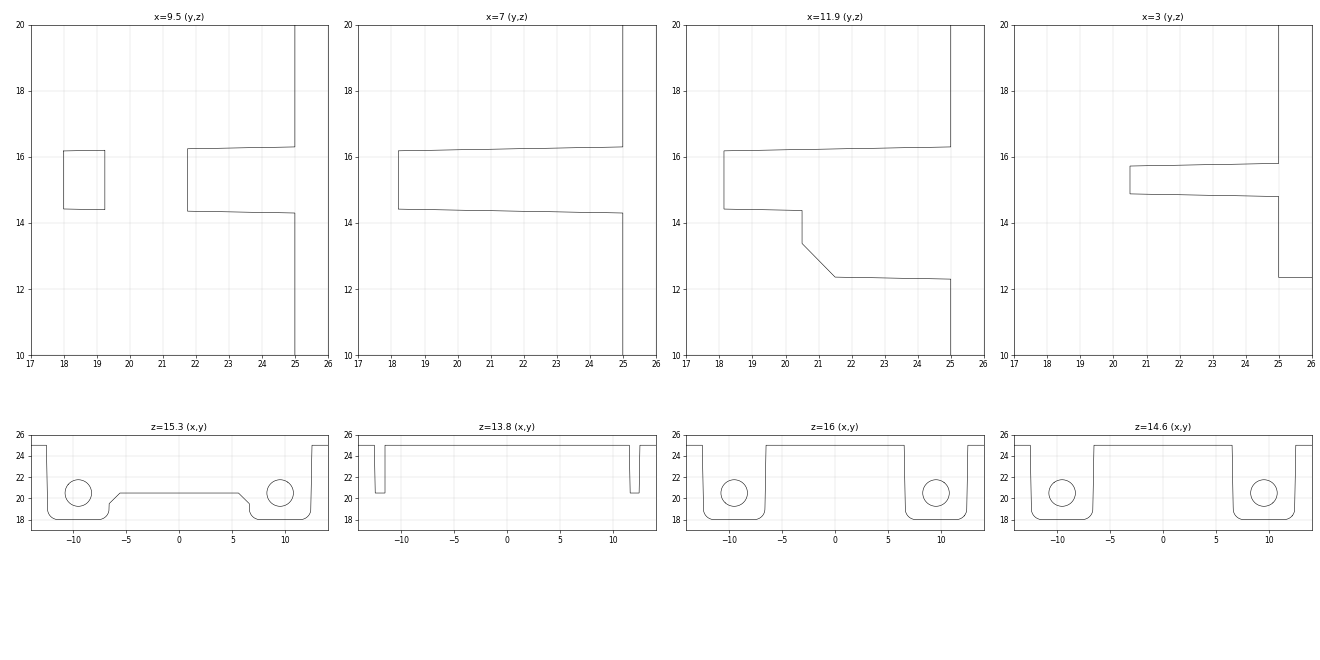
cad/redesign/tools/build/feat/ps_c.png
