lsk0522/microduck/cad/redesign/tools/build/feat/ps_ysec.png

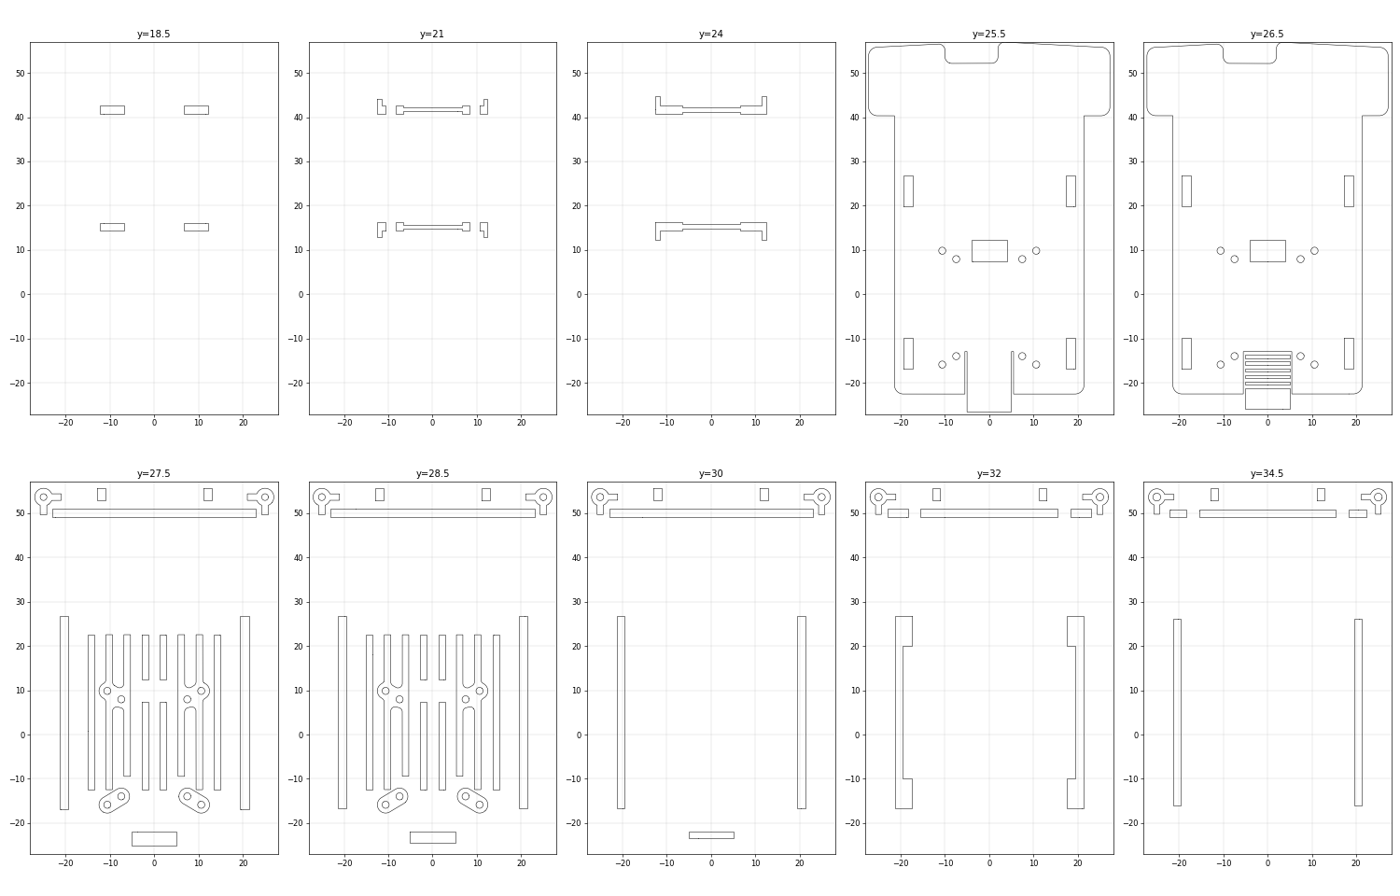
cad/redesign/tools/build/feat/ps_ysec.png
