lsk0522/microduck/cad/redesign/tools/build/feat/smt.png

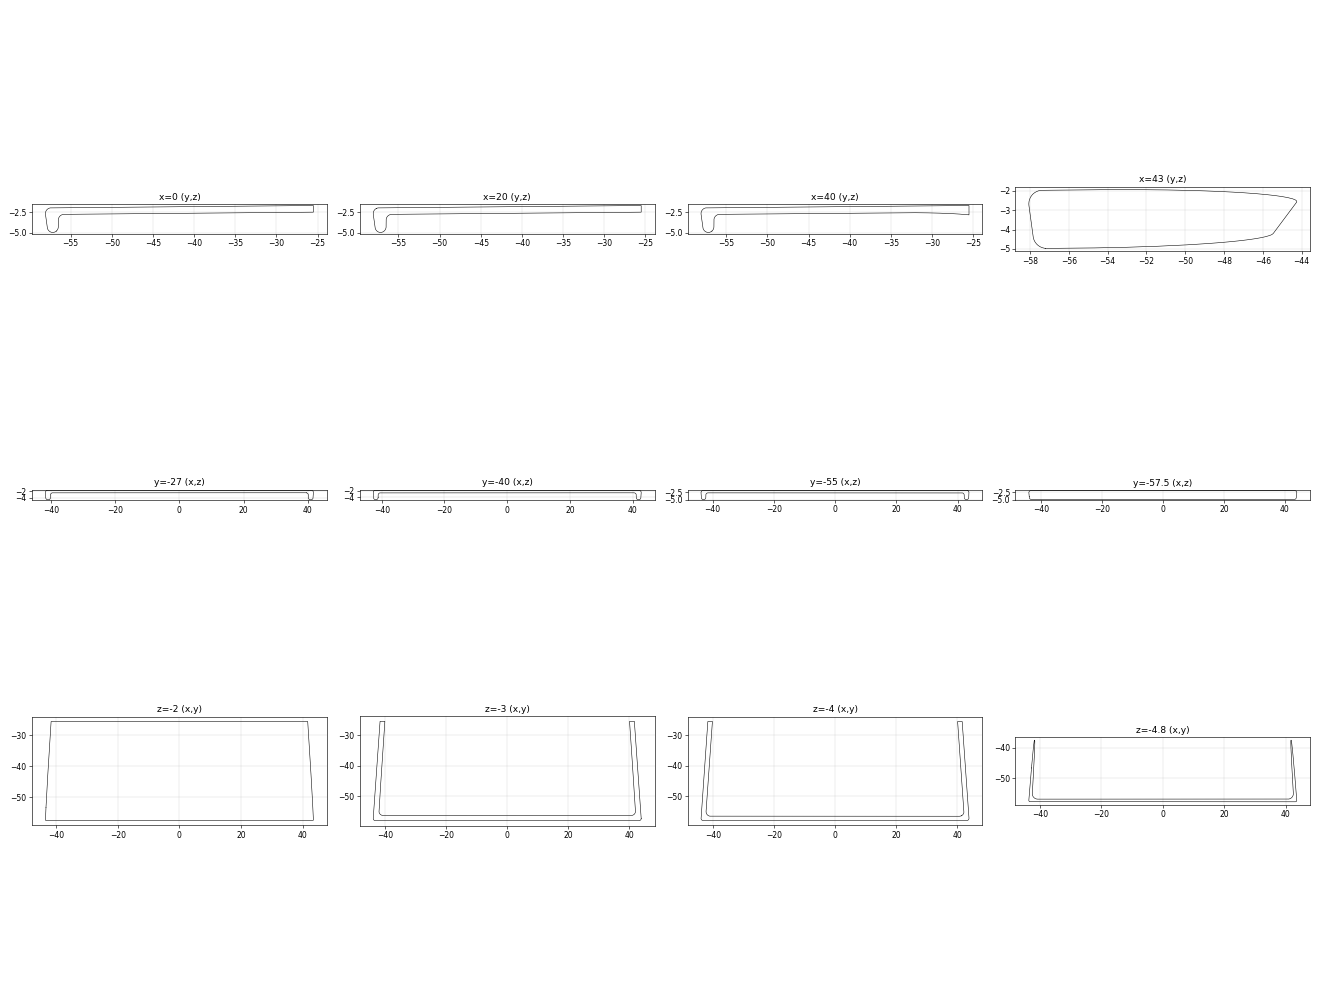
cad/redesign/tools/build/feat/smt.png
