lsk0522/microduck/cad/redesign/tools/build/feat/soft_mouth_top_sec.png

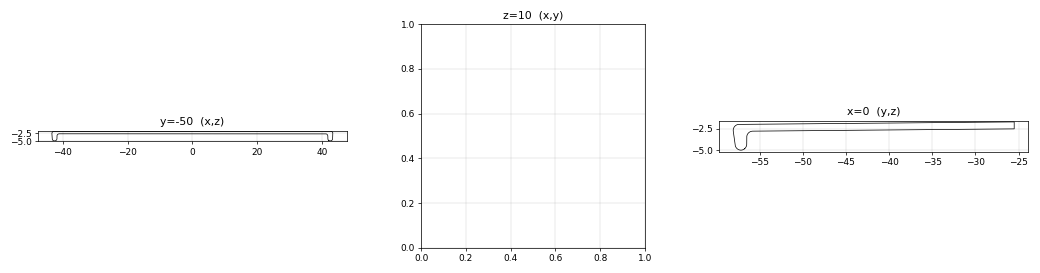
cad/redesign/tools/build/feat/soft_mouth_top_sec.png
