lsk0522/microduck/cad/redesign/tools/build/feat/sole_a.png

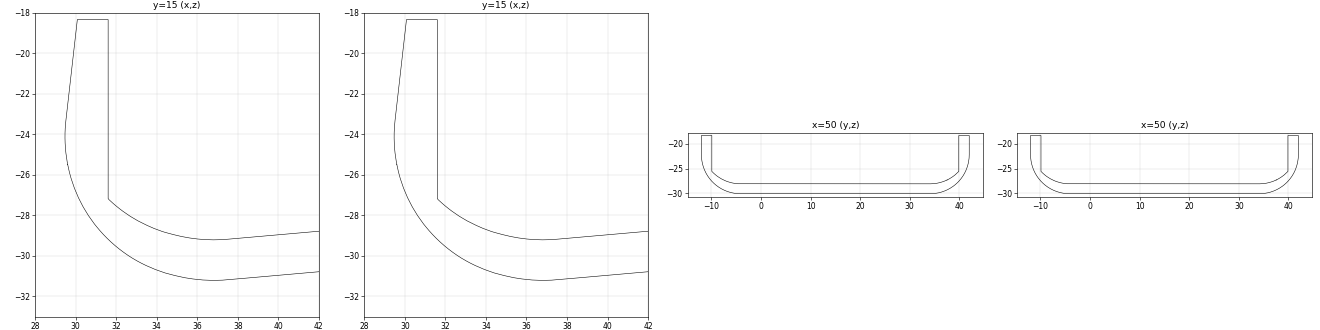
cad/redesign/tools/build/feat/sole_a.png
