lsk0522/microduck/cad/redesign/tools/build/feat/sole_b.png

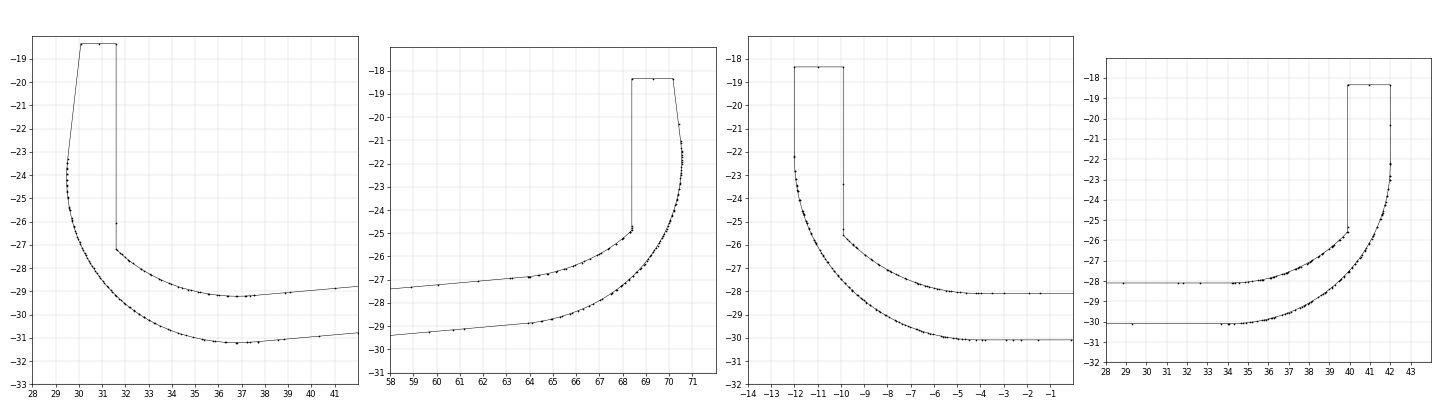
cad/redesign/tools/build/feat/sole_b.png
