lsk0522/microduck/cad/redesign/tools/build/feat/sole_c.png

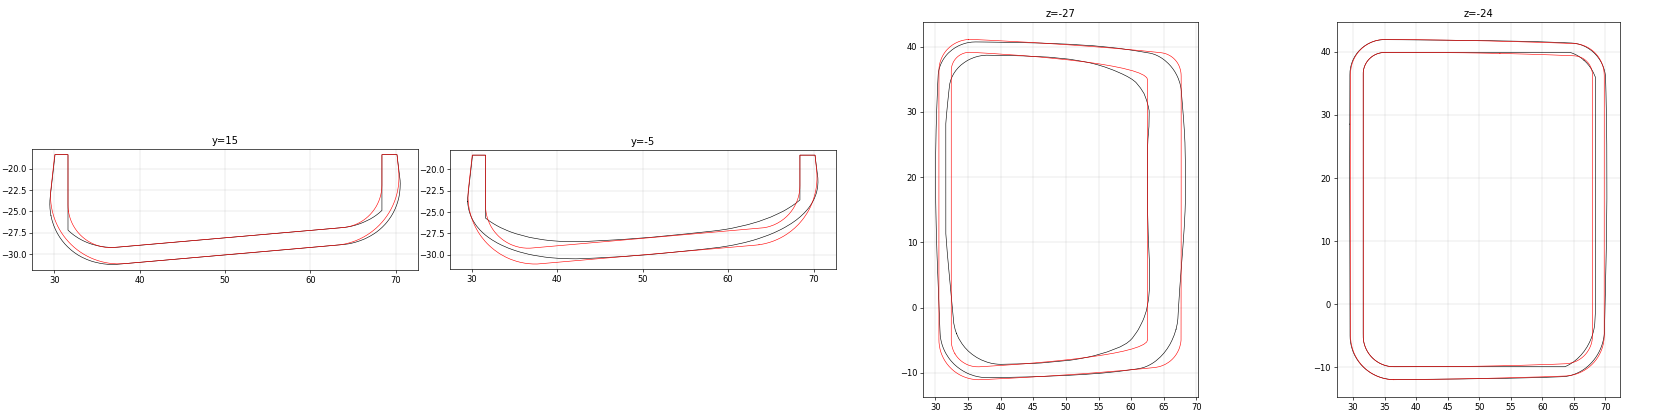
cad/redesign/tools/build/feat/sole_c.png
