lsk0522/microduck/cad/redesign/tools/build/feat/sole_left_sec.png

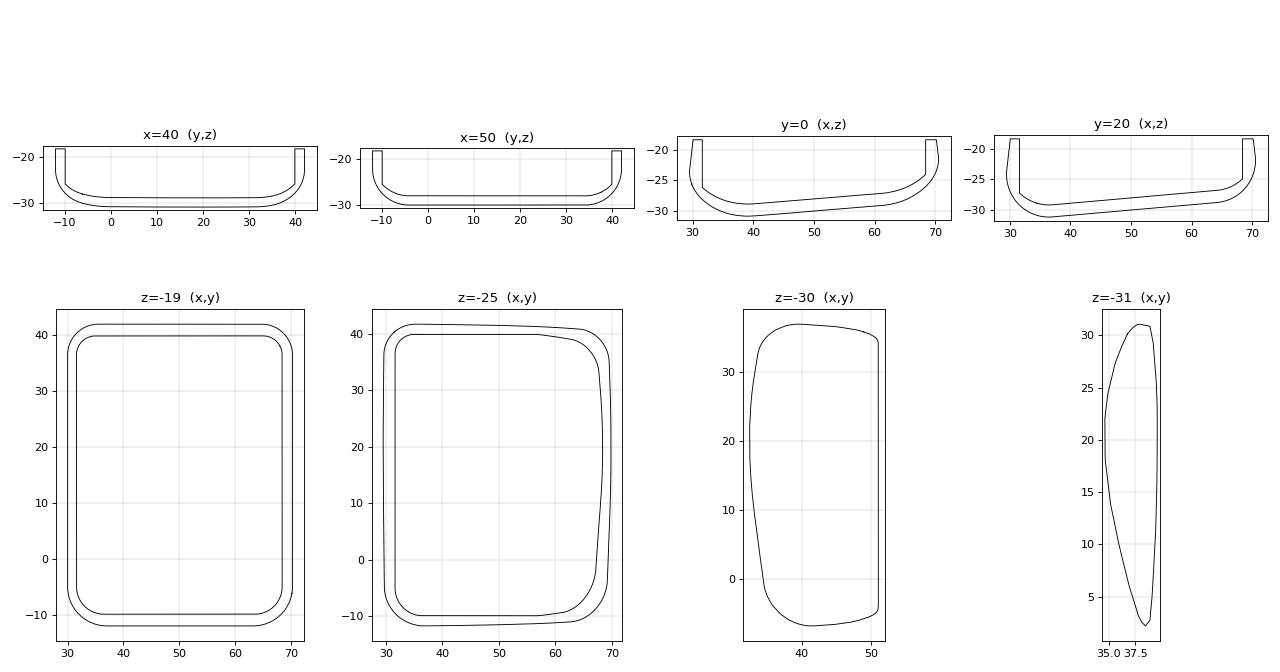
cad/redesign/tools/build/feat/sole_left_sec.png
