lsk0522/microduck/cad/redesign/tools/build/feat/ths_front_inner.png

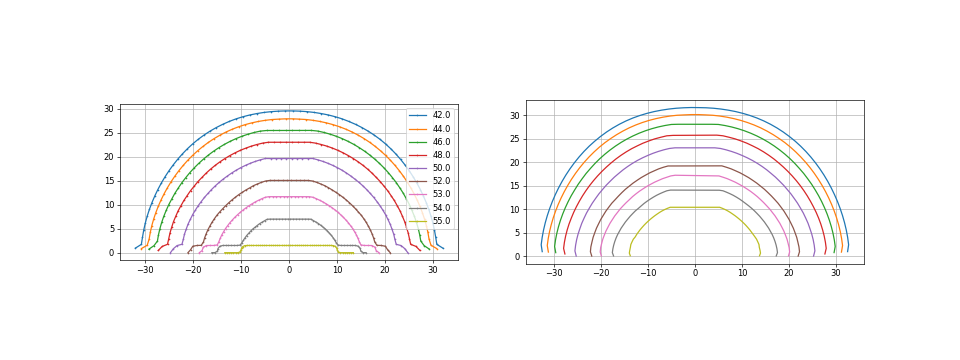
cad/redesign/tools/build/feat/ths_front_inner.png
