lsk0522/microduck/cad/redesign/tools/build/feat/top_head_shell_sec.png

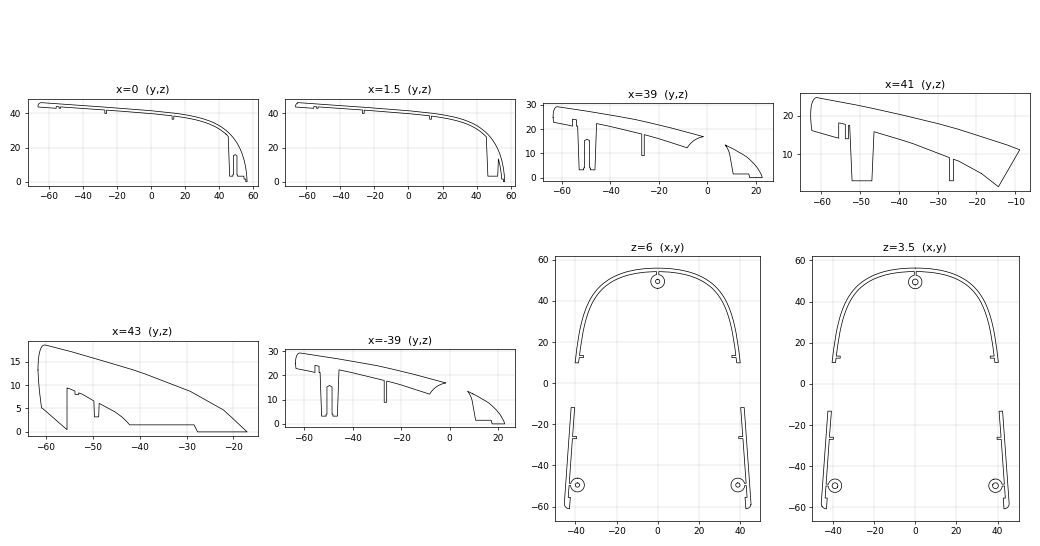
cad/redesign/tools/build/feat/top_head_shell_sec.png
