lsk0522/microduck/cad/redesign/tools/build/feat/ul_a.png

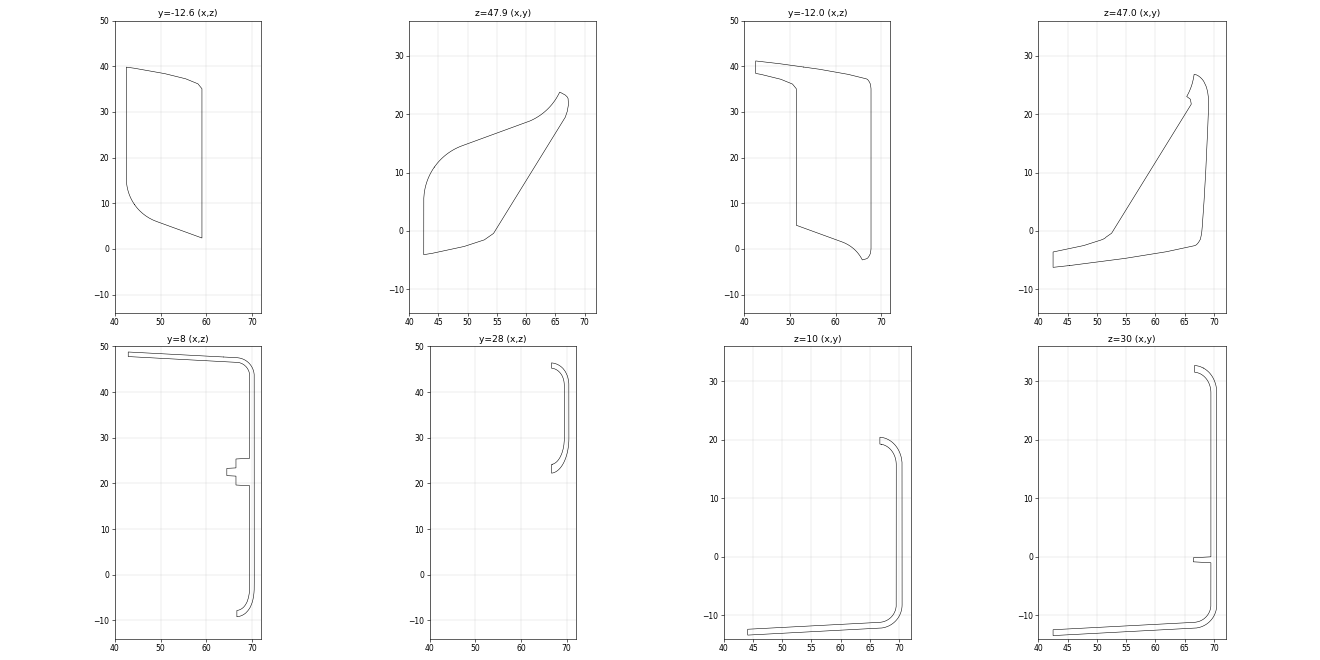
cad/redesign/tools/build/feat/ul_a.png
