lsk0522/microduck/cad/redesign/tools/build/feat/ul_b.png

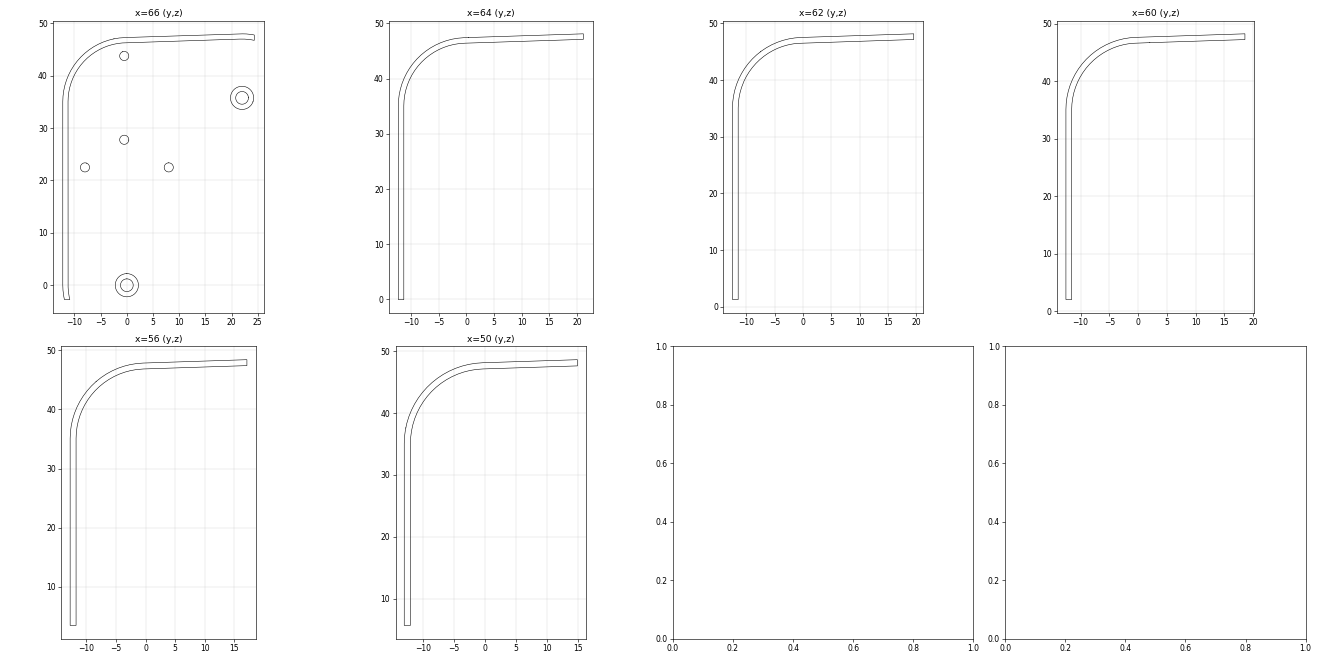
cad/redesign/tools/build/feat/ul_b.png
