lsk0522/microduck/cad/redesign/tools/build/feat/ul_c.png

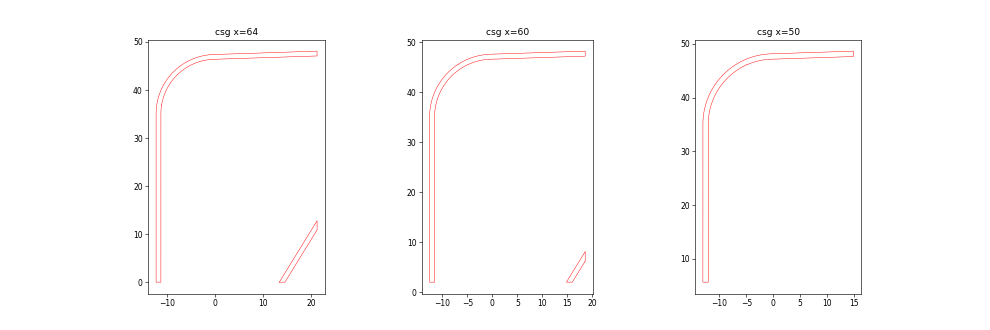
cad/redesign/tools/build/feat/ul_c.png
