lsk0522/microduck/cad/redesign/tools/build/feat/upper_leg_left_sec.png

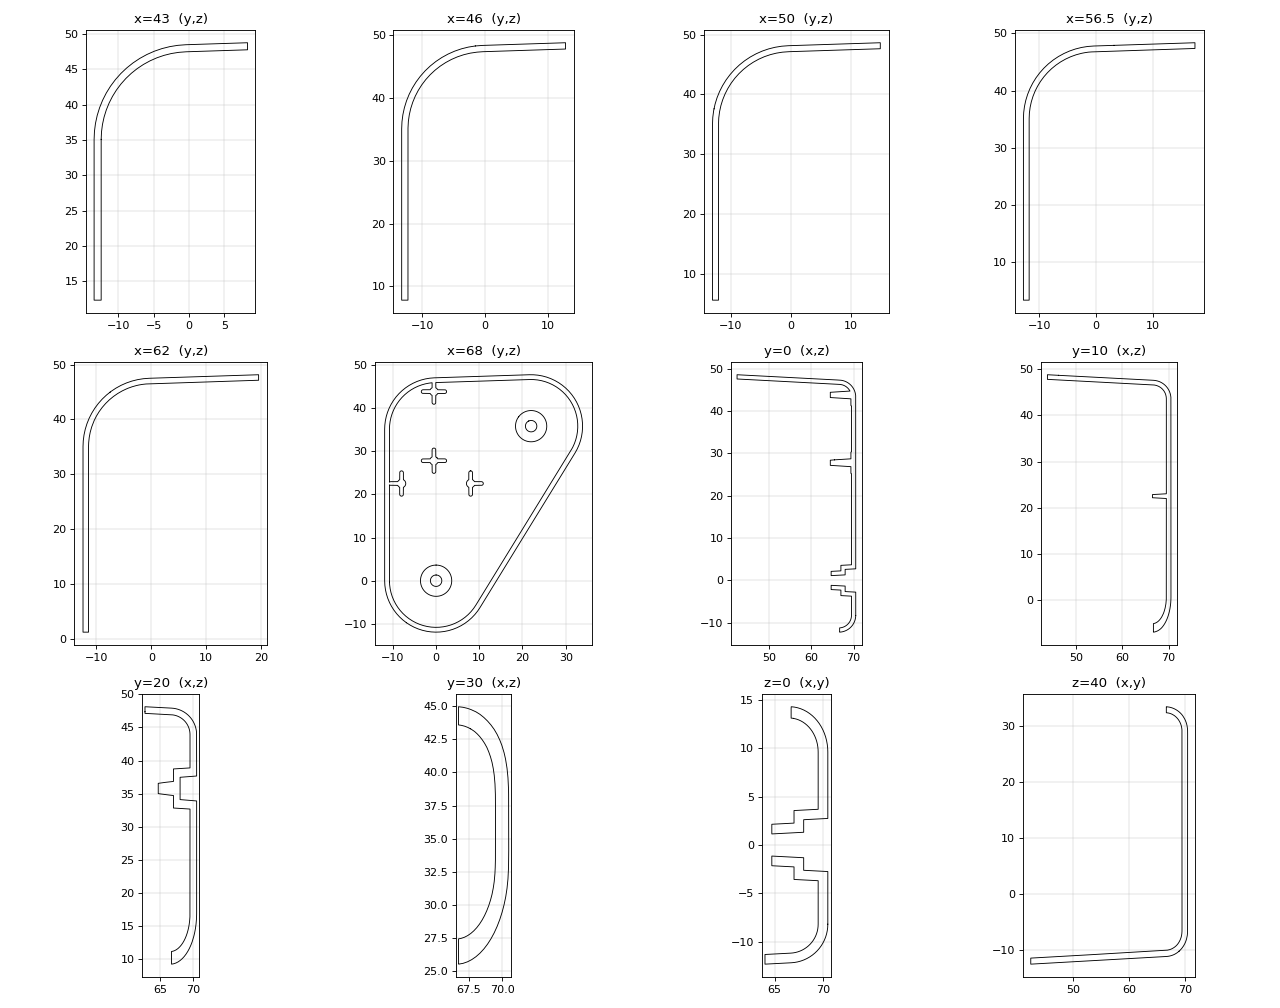
cad/redesign/tools/build/feat/upper_leg_left_sec.png
