lsk0522/microduck/cad/redesign/tools/build/feat/upper_leg_left_views.png

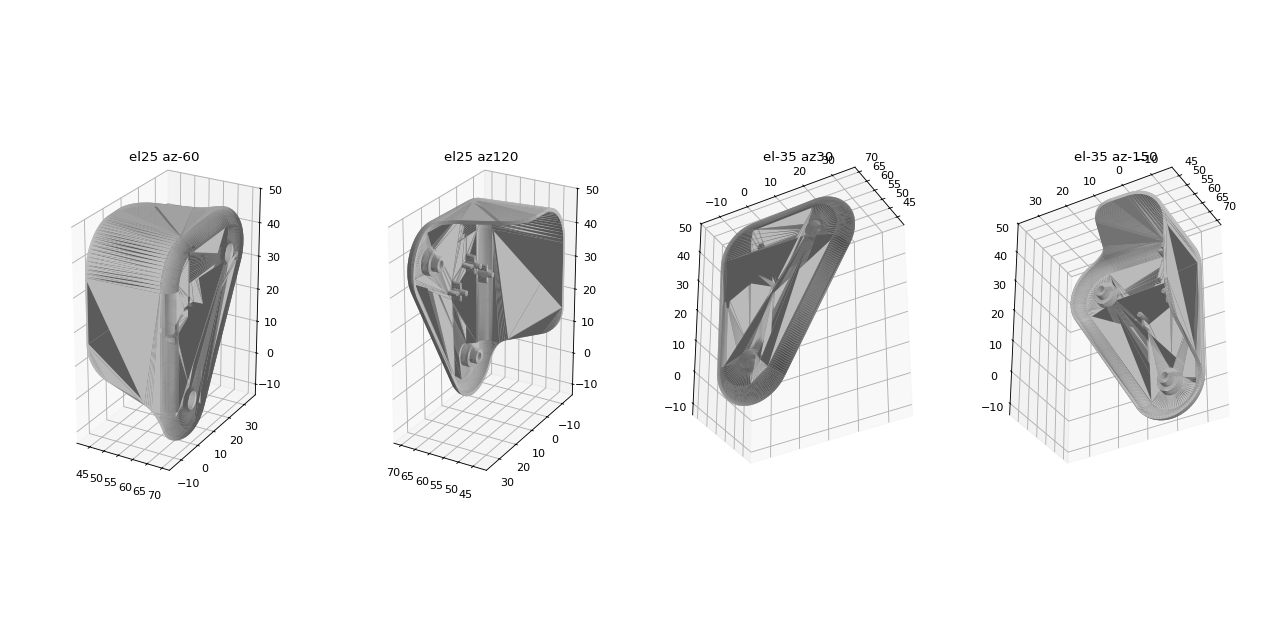
cad/redesign/tools/build/feat/upper_leg_left_views.png
