lsk0522/microduck/cad/redesign/tools/build/feat/upper_leg_right_sec.png

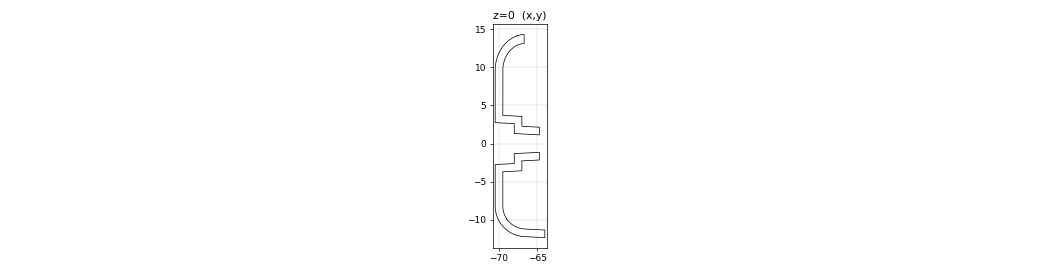
cad/redesign/tools/build/feat/upper_leg_right_sec.png
