lsk0522/microduck/cad/redesign/tools/build/feat/upper_leg_right_views.png

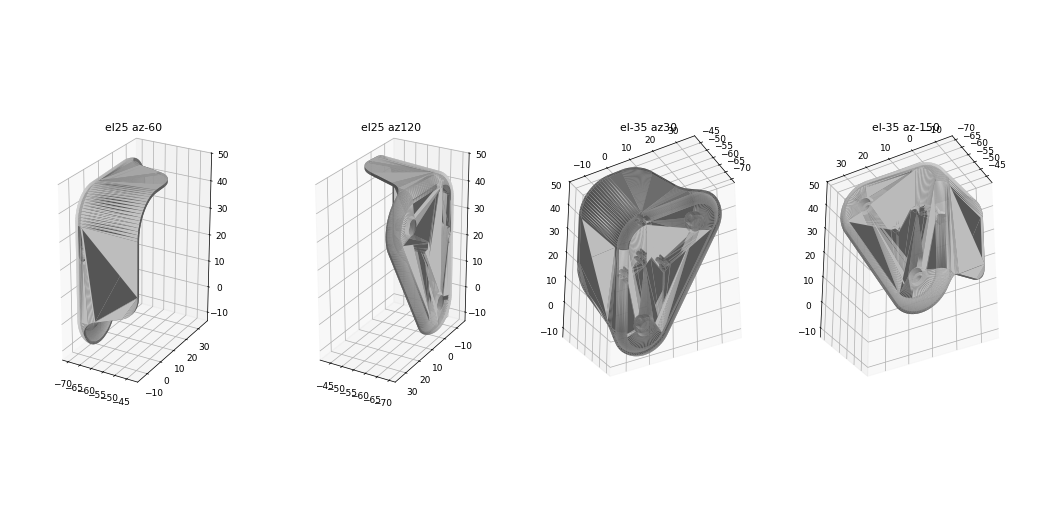
cad/redesign/tools/build/feat/upper_leg_right_views.png
