lsk0522/microduck/cad/redesign/tools/build/feat/y2r_a.png

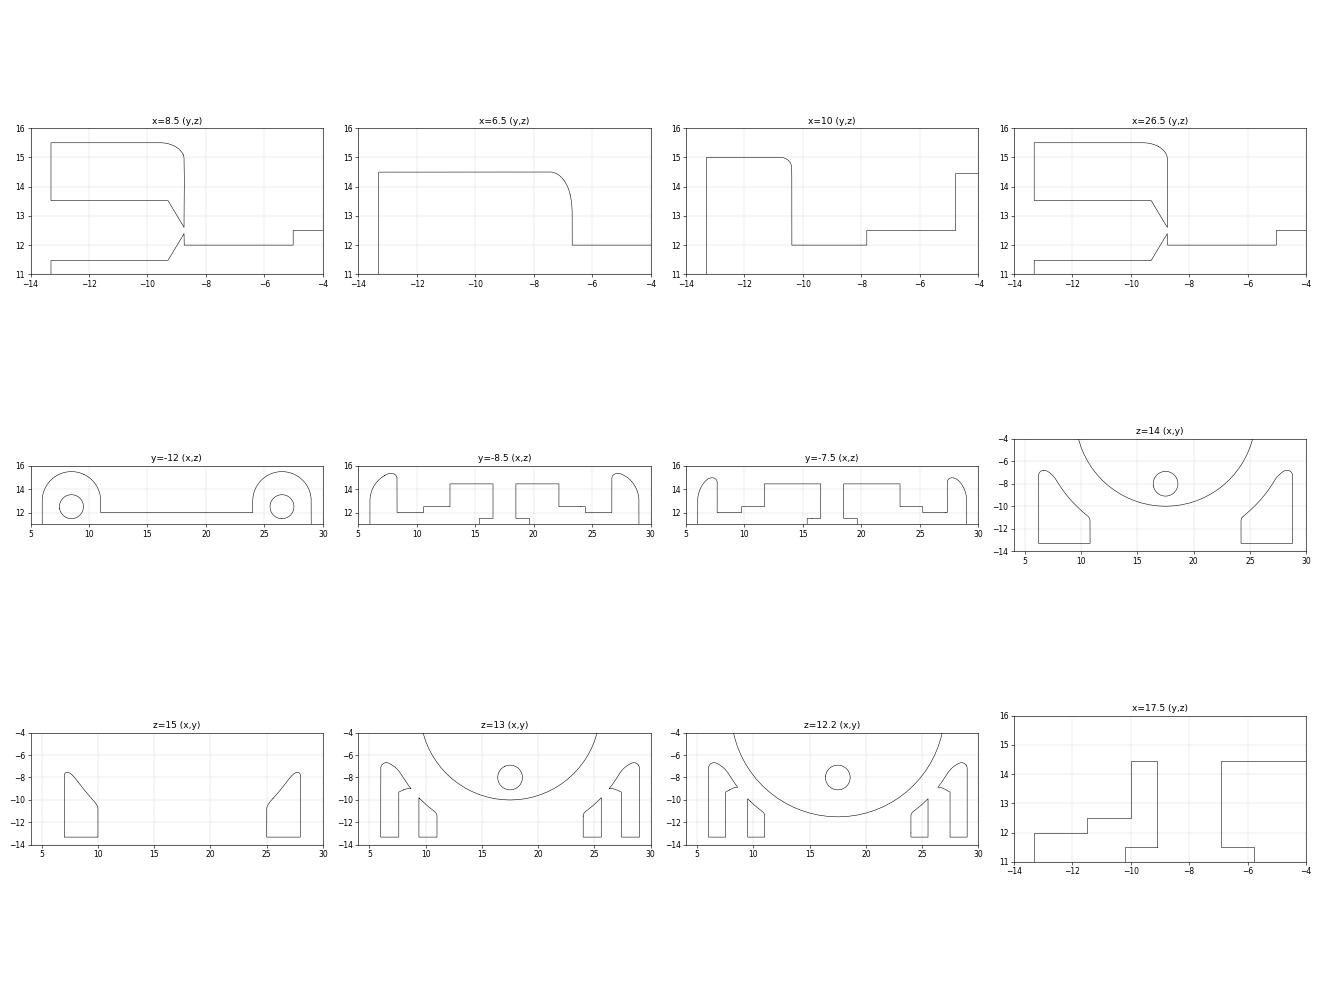
cad/redesign/tools/build/feat/y2r_a.png
