lsk0522/microduck/cad/redesign/tools/build/feat/yaw2roll_sec.png

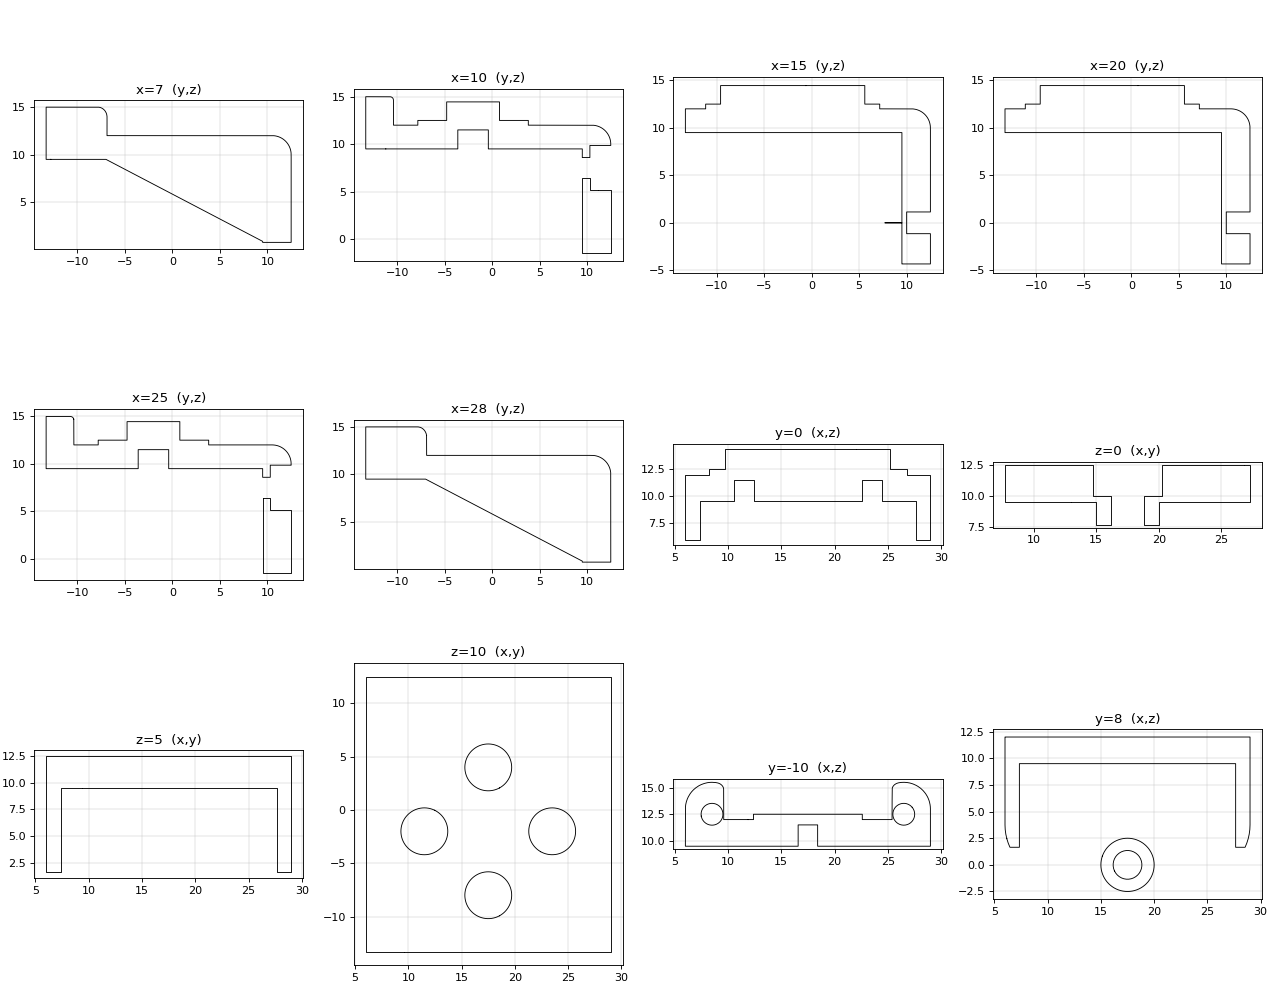
cad/redesign/tools/build/feat/yaw2roll_sec.png
