lsk0522/microduck/cad/redesign/tools/build/neck_preview.png

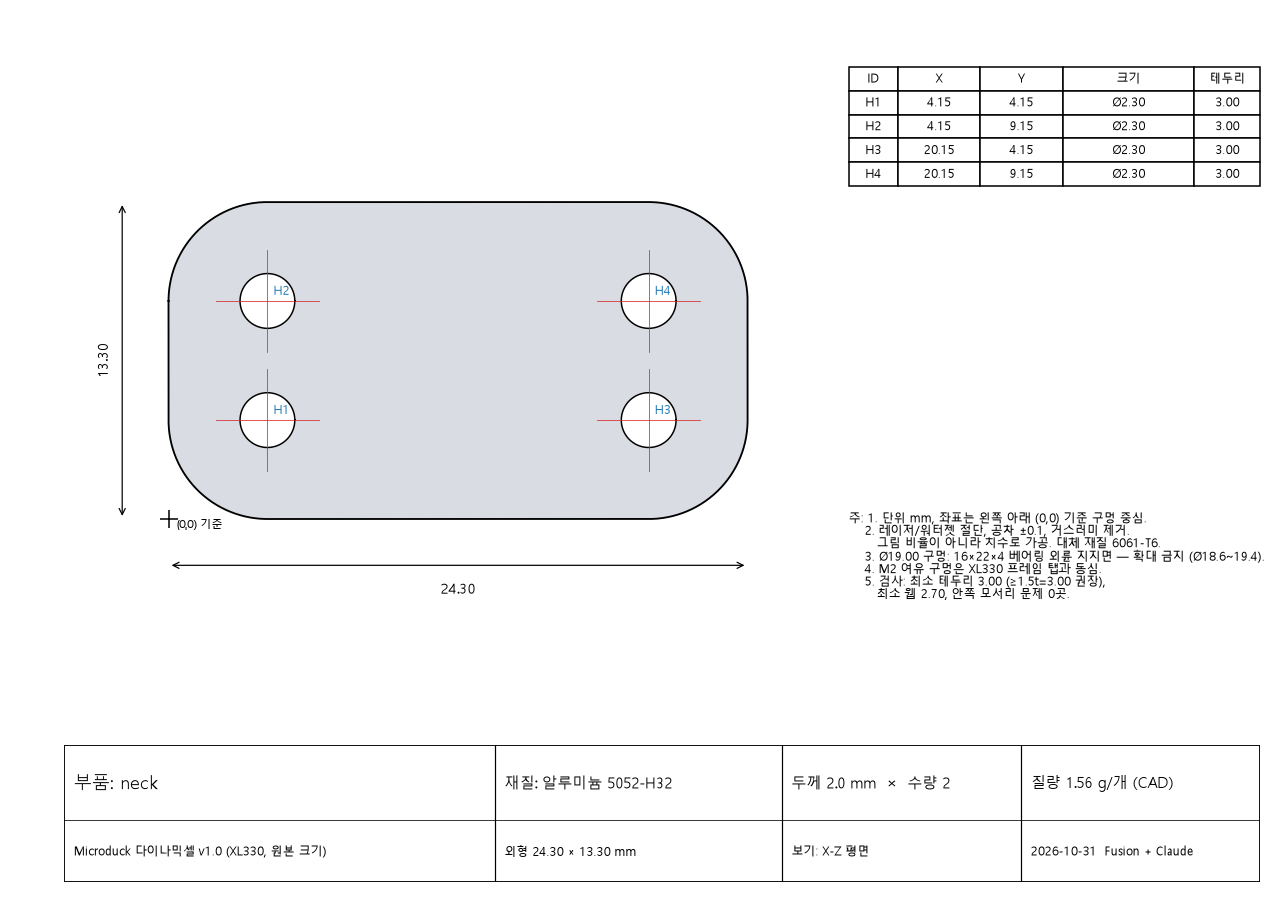
cad/redesign/tools/build/neck_preview.png
