lsk0522/microduck/cad/redesign/tools/build/trunk_base_preview.png

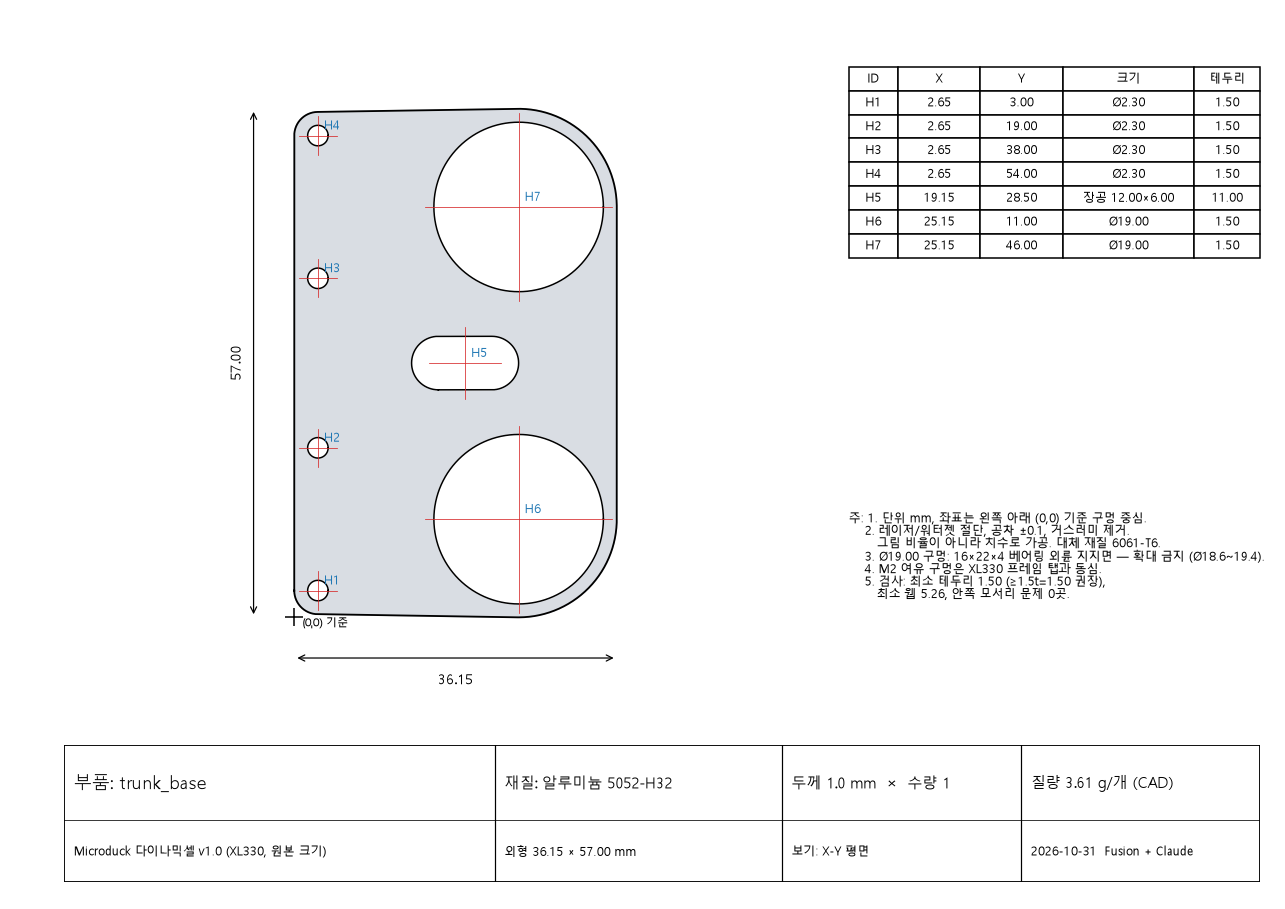
cad/redesign/tools/build/trunk_base_preview.png
