lsk0522/microduck/cad/redesign/tools/build/upper_leg_rigidity_plate_preview.png

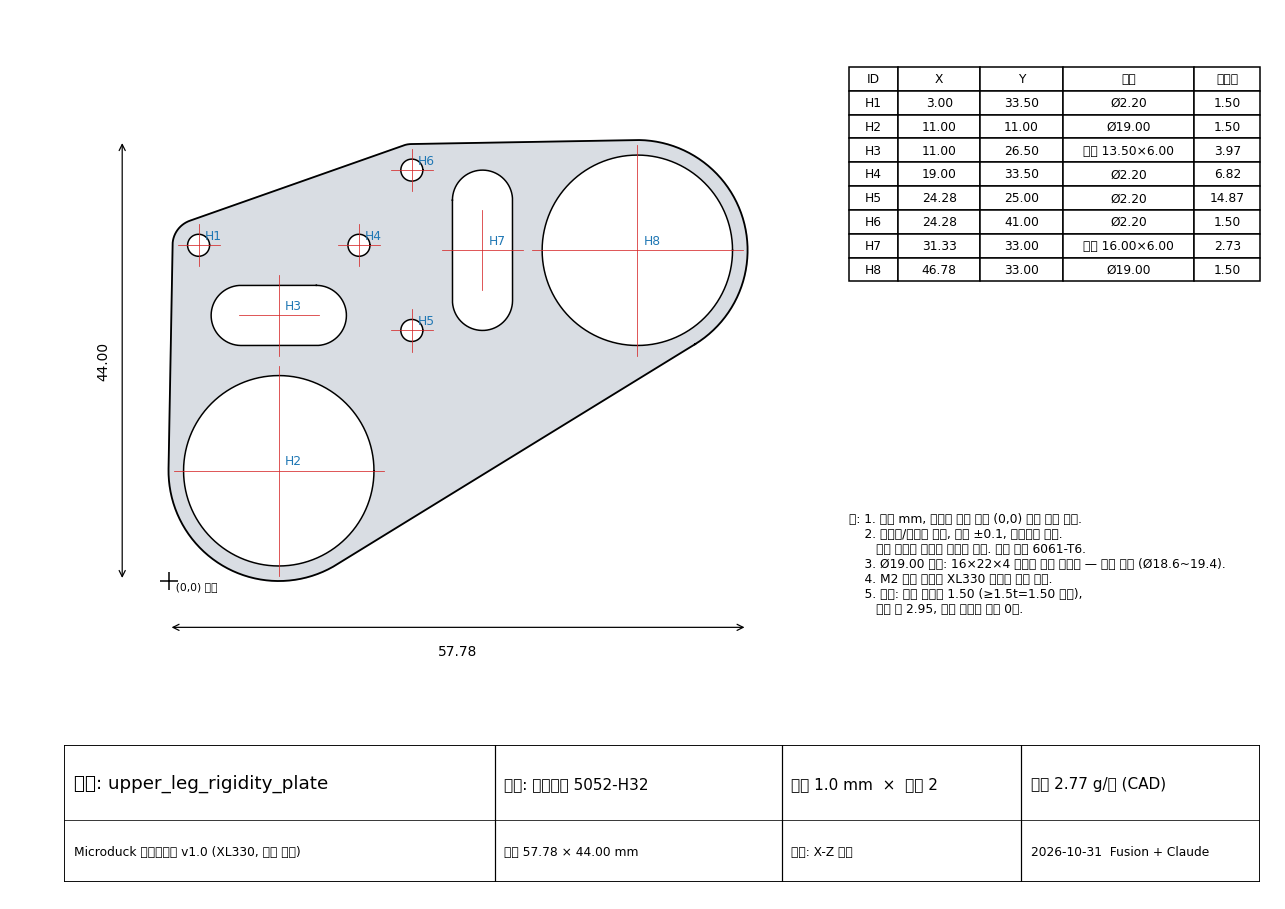
cad/redesign/tools/build/upper_leg_rigidity_plate_preview.png
