lsk0522/microduck/docs/assembly/img/cable_top.png

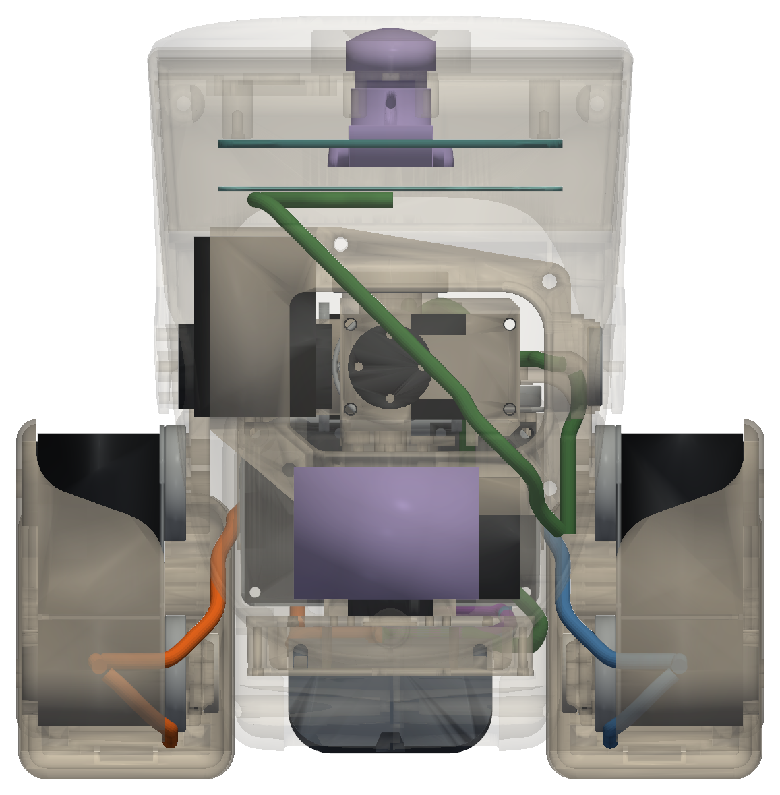
docs/assembly/img/cable_top.png
