lsk0522/microduck/docs/assembly/img/wiring_route.png

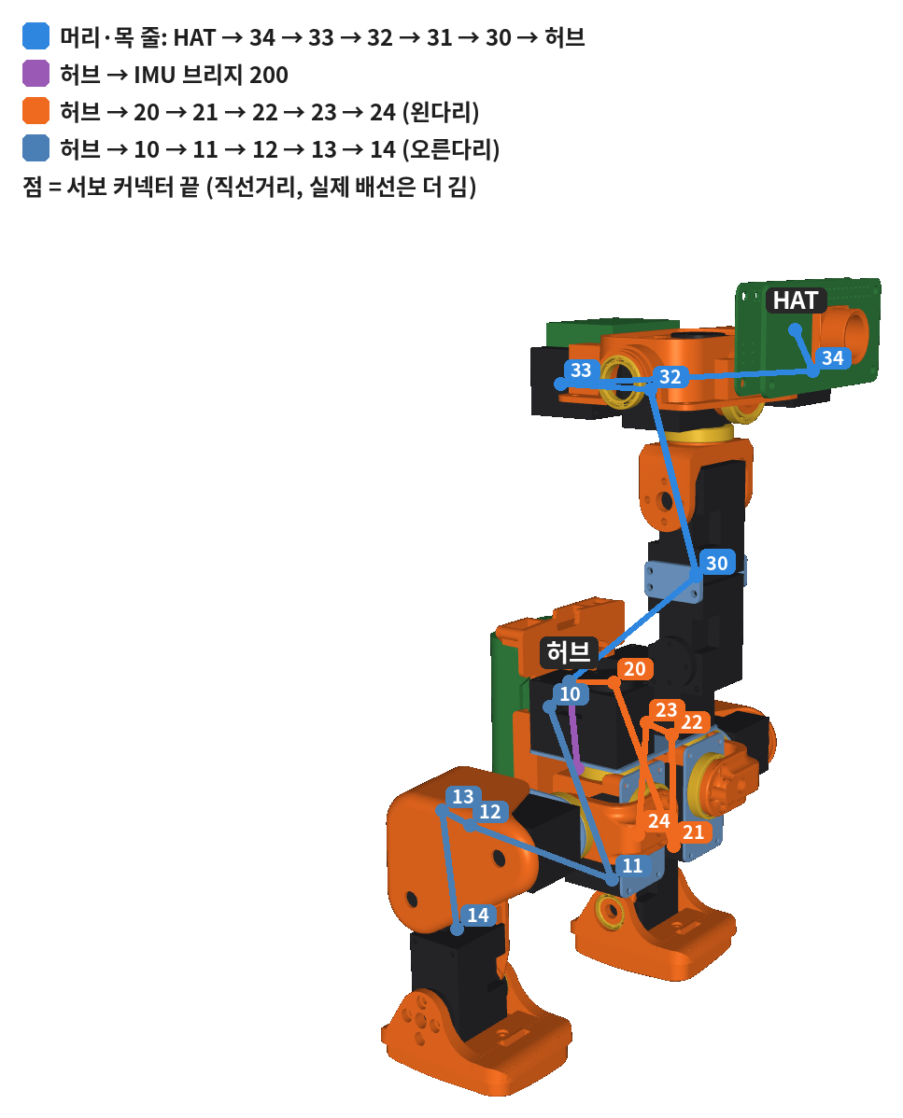
docs/assembly/img/wiring_route.png
