lsk0522/microduck/cad/redesign/dynamixel/v1.0/verify/drive_test_2026-11-09.md

# 다이나믹셀 v1.0 구동 테스트 (2026-11-09, 사용자 요청 "잘 버티는지, 잘 조립되는지")

메시: 출력 부품 26종을 지금 parts/*.stl 로 바꾼 MJCF (시험용 사본) — 원본(cad/reference) 메시와 같은 운동학·질량으로 비교.

## 1. 관절 연결 (Fusion 어셈블리 v25)
- 회전 관절 14개, 꺼진 관절 0. +20° 돌려 축 방향 cos 1.0, 회전 중심 이탈 ≤ 0.0016 mm, 범위·부모/자식 사양과 같음 → 14/14

## 2. 움직일 때 부딪힘 (정확 메시)
- `freerange.py`: 관절 14개 모두 무충돌 범위가 원본과 같음 (고관절 yaw −18…30, 무릎 71, 머리 pitch −66, 머리 roll −8…15 는 원본도 같음. 발목 0 은 혼 원판이 모터 메시에 붙어 있어 생기는 모델 접촉)
- `interf_mf.py`: 자세 187개(관절별 9단계 + 보행 범위 무작위 60개) — 원본에 없던 새 접촉 0건

## 3. 버티는지 (MuJoCo)
- 서 있기 유지 토크 (`sim/check_model.py`, XL330 7.4 V 정지 0.77 N·m): STAND 최대 무릎 0.055 N·m(7 %), SIT 머리 pitch 0.258 N·m(34 %, 원본 같음) — 원본과 차이 ≤ 0.006 N·m
- 출력 부품 부피 합 원본 대비 −0.14 % (≈ −0.3 g) → 무게중심·토크 변화 없음
- 균형 제어 없이 서보 위치 제어만: 모델 기본 강성으로는 0.87 s 에 앞으로 넘어짐 (원본 0.85 s, 같음). 강성 2배면 새 모델은 섬(기울기 11°), 원본은 3.3 s 에 넘어짐. 4배 이상은 둘 다 섬 → 걷기·서기는 원작처럼 정책(RL) 필요
- 앉았다 일어서기·전 범위 무작위 동작에서 로봇 몸끼리 접촉: 원본과 같음 (`selfcol_sim.py`, `dyn_stand.py`)

## 4. 조립 맞물림 — 관절각 0, 모든 부품 쌍 (`tools/verify_sim/asmfit.py`, 같은 바디 안 포함)
새로 찾아 고친 것:
- top_head_shell 부리 서보 모서리 자리 없음 → 서보가 셸 안쪽에 0.64 mm 파고듦 → 원작처럼 x 37.1 세로 홈 (servo_relief)
- top_head_shell 아래 셸 립 자리 없음 (뒤 끝은 안쪽 로프트가 y 54 에서 끝나 막힘) → 립과 최대 0.92 mm 겹침 → 립 모양 그대로 홈 + 뒤 안쪽 면 두 단 + z 0 아래 0.56 mm 처진 리브 끝 잘라냄. 위·아래 셸 겹침 67.9(원본) → 40.5 mm³, 최대 0.39 mm(원본 0.20)
- MJCF neck 판 메시가 25 mm 밀려 두 판이 한쪽에 겹쳐 있었음 (시뮬만, Fusion 어셈블리는 정상) → assets/neck.stl 고침, `build_mjcf.py` 기준 인스턴스 고르기 고침
남은 것 (실물 영향 없음):
- 같은 면끼리 닿는 곳 0.01 mm 꼴 (soft_mouth_top↔bottom_head_shell, foot↔ankle), 베어링 자리 0.3~0.6 mm³ (메시 다각형 차이)
- 구매 부품 그림 모델(lens, np_f970, PCB)이 단순화돼 있어 그 모델로 재면 겹침이 나오지만, 원본 구매 부품 모양으로 재면 원본과 같음 (lens 는 목 지름이 원본 Ø13.6 대신 Ø16.9 로 그려져 있음 — BOM 그림용)
