lsk0522/microduck/cad/redesign/dynamixel/v1.0/verify/feature_verify.md

# 다이나믹셀 v1.0 출력 부품 원작 대비 검증 (2026-11-02)

`cad/redesign/tools/feat/verify_all.py` — 부품 STEP 과 같이 내보낸 STL(`parts/<부품>/<부품>.stl`) vs 원작 STL.
표면 거리 = 양방향 표본점 거리(mm). 구멍 = x·y·z 단면에서 찾은 원형 구멍 고리(반지름 < 10)마다 새 모델 같은 단면에서 중심 0.1·반지름 0.05 안의 원이 있는지.

| 부품 | 부피 차 | p50 | p95 | 최대 | 구멍 단면 일치 | 구멍 최대 오차 (중심 / 반지름) |
|---|---|---|---|---|---|---|
| neck_pitch | -0.36 % | 0.000 | 0.046 | 0.16 | 55/55 | 0.007 / 0.001 |
| motor_support | +0.02 % | 0.000 | 0.005 | 0.01 | 8/8 | 0.000 / 0.001 |
| m12_lens_holder | +0.04 % | 0.000 | 0.006 | 0.02 | 13/13 | 0.001 / 0.002 |
| yaw2roll | -0.01 % | 0.000 | 0.005 | 0.32 | 32/32 | 0.000 / 0.000 |
| hip_l | +0.23 % | 0.000 | 0.007 | 0.20 | 45/45 | 0.005 / 0.003 |
| upper_leg_left | +0.00 % | 0.002 | 0.010 | 0.66 | 10/10 | 0.000 / 0.001 |
| upper_leg_right | -0.01 % | 0.002 | 0.010 | 0.65 | 10/10 | 0.000 / 0.001 |
| leg | +0.13 % | 0.000 | 0.028 | 0.39 | 31/31 | 0.001 / 0.001 |
| ankle_left | +0.09 % | 0.000 | 0.012 | 0.05 | 19/19 | 0.000 / 0.002 |
| ankle_right | +0.09 % | 0.000 | 0.012 | 0.05 | 22/22 | 0.000 / 0.002 |
| foot_left | -0.35 % | 0.002 | 0.161 | 1.69 | 5/5 | 0.002 / 0.001 |
| foot_right | -0.35 % | 0.002 | 0.169 | 1.71 | 5/5 | 0.002 / 0.001 |
| sole_left | -0.02 % | 0.027 | 0.522 | 1.45 | 0/0 | 0.000 / 0.000 |
| sole_right | -0.02 % | 0.024 | 0.536 | 1.51 | 0/0 | 0.000 / 0.000 |
| power_support | -0.00 % | 0.000 | 0.002 | 0.07 | 52/52 | 0.000 / 0.002 |
| left_shell | +0.08 % | 0.005 | 0.093 | 0.93 | 44/44 | 0.023 / 0.004 |
| right_shell | +0.31 % | 0.005 | 0.093 | 0.91 | 44/44 | 0.022 / 0.004 |
| top_head_shell | -1.43 % | 0.008 | 0.094 | 1.92 | 33/33 | 0.000 / 0.002 |
| face_part | +0.03 % | 0.000 | 0.004 | 0.07 | 49/49 | 0.000 / 0.001 |
| jaw | +0.36 % | 0.006 | 0.065 | 1.03 | 23/23 | 0.000 / 0.002 |
| jaw_soft | +0.10 % | 0.003 | 0.053 | 0.09 | 0/0 | 0.000 / 0.000 |
| soft_mouth_top | +0.41 % | 0.002 | 0.010 | 0.05 | 0/0 | 0.000 / 0.000 |
| banana_pcb_locker | -0.00 % | 0.000 | 0.001 | 0.01 | 2/2 | 0.000 / 0.001 |
| yaw_roll_motion | +0.03 % | 0.000 | 0.005 | 0.01 | 39/39 | 0.000 / 0.001 |
| noenoeil | +0.23 % | 0.000 | 0.068 | 0.18 | 5/7 | 0.000 / 0.004 |
| bottom_head_shell | -0.15 % | 0.001 | 0.032 | 0.61 | 54/54 | 0.002 / 0.008 |

메모
- bottom_head_shell: 2026-11-03 피처 재모델링 (예전 단면 쌓기 솔리드 p95 0.156 → 0.028). 최대 0.37 mm 는 앞 평판 옆 끝 윗면·클립 옆 턱 모서리
  - 11-03 겉면 재모델링 (컵 = 3° 프리즘 + R5, 731면 → 622면): 최대 0.62 mm 는 원작 메시의 두께 0 쐐기 조각(x −39.5 안쪽 벽 아래) — 실제 형상 오차 아님
- noenoeil: 재모델링 대상 아님(원래 깔끔). 렌즈 원뿔 입구 2 단면에서 반지름 0.15~0.18 mm 차이
- face_part: 검증에서 큰 기둥·작은 기둥 구멍 입구가 원뿔이 아니라 카운터보어(R1.35×1, R1.1×0.75)임을 찾아 고침 (v3)
- foot·sole 최대 1.5~1.8 mm: 바닥 가장자리 곡면 근사(R5), jaw 최대 1.0 mm: 팔 뒤 끝·바닥 이음 둥글림 생략, left/right/top 셸 최대 3.3 mm: 세 면 만나는 모서리 이음 (이전 기록)
- bearing_roll 등 판재 4종은 가공용으로 일부러 다름(위치결정 보스 생략) → 제외
- left_shell (11-03 겉면 재모델링, 1417면 → 118면): 최대 0.93 mm 는 보스·고리 구멍이 둥근 바깥면을 비스듬히 뚫고 나가는 테두리(원작 메시가 들쭉날쭉한 곳) — 나머지 겉면은 0.3 mm 안
- right_shell (11-03 겉면 재모델링, 1504면 → 122면, 끝의 기본 피처 없앰): 최대 0.91 mm 는 left 와 같은 보스 구멍 테두리
- yaw_roll_motion (11-08 재모델링, 272면 → 67면): 층 돌출 대신 피처. 팔 아래 호 접점을 계산값으로 (반올림 좌표면 조각면이 남음)
- banana_pcb_locker (11-08 재모델링, 98면 → 28면): 판 윤곽 1° 구배 + 걸쇠 2 + 구멍 2
- top_head_shell (11-09): 최대 3.29 의 원인은 나사 기둥 3개 끝이 바깥면 밖으로 나온 것이었음 → 바깥 덩어리와 교집합. 부피 −1.07 % 는 그 돌출이 가리던 벽 두께 차이(평균 0.01 mm 꼴)
- bottom_head_shell (11-09): 옆 턱 홈을 y 단면 로프트 → 피처(계단 곡선 + 올린 바닥 + R2.9/R1/R2.8). 622 → 481면. p95 가 0.026 → 0.032 로 조금 늘었지만 줄무늬 면이 없어짐. 홈 뒤 끝 안쪽 0.6~1.0 mm
- top_head_shell (11-09 구동 테스트): 부리 서보 자리·아래 셸 립 자리 추가 (원작에 있던 것), z 0 아래 처짐 잘라냄 → p95 0.094
