lsk0522/microduck/docs/design-log.md

# 설계 로그 (설계 대화)

형식: 날짜 / 한 일 / 결과 / 원본 대비 변경 / 확인 필요·가정 / 계획 대화에 요청

### 2026-10-29~30 판재 4종 + 다이나믹셀 v1.0 어셈블리 시작
- 한 일:
  - Fusion MCP 연결 확인 (도구 4개: read/execute(스크립트)/update(undo·redo)/electronics_read). 작업은 전부 Fusion API 스크립트로 (`cad/fusion/scripts/`)
  - 원본 MJCF 분석: 판재 M2 구멍 = XL330 프레임 관통 구멍(Ø2.0, 혼 축에서 길이 방향 22.5/−7.5, 폭 ±8)과 동심. Ø19 = XL330 혼(Ø16) 통과 + 16x22x4 베어링 외륜 지지
  - 매개변수 + 관절축 스켈레톤 14개, 판재 4종 파라메트릭 판금 (볼록 외곽 = 구멍 + 1.5t 원호의 접선 외곽)
  - 사용자 지시로 다이나믹셀 원본 버전 전체 어셈블리 v1.0 착수: 몸체 15, MJCF 관절 14, 원본 메시 참조, 구매품 8종, 출력 부품 변환 중
  - 진행 상황·재생성 순서: `cad/redesign/dynamixel/v1.0/PROGRESS.md`
- 결과: 진행 중
- 원본 대비 변경:
  - upper_leg_rigidity_plate 57.78×44.00 (원본 58.1×45.0), 경량화 홈 3→2 (위쪽 홈 삭제), 2.77 g
  - trunk_base 뒤쪽 테두리 0.15 mm 확장 (1.35→1.5), 앞 모서리 볼록 외곽, 위치결정 핀 생략
  - bearing_roll 아래 0.6 mm 확장 (테두리 0.89→1.5), 위치결정 핀 생략. 좌우 같은 부품 (미러 아님)
  - neck 20×11 → 24.3×13.3 (테두리 0.84→3.0 = 1.5t)
- 확인 필요 / 가정:
  - neck·bearing_roll 확장분의 가동 범위 간섭 (검증 단계에서 스윕)
  - 위치결정 핀 생략 (사용자 확인 대기)
  - XL330 공식 STEP과의 대조는 아직 (원본 메시의 XL330 모델로 확인)
- 계획 대화에 요청:
  - `bom/` 에 다이나믹셀 v1.0 부품 목록 반영 (v1.0 폴더의 BOM_dynamixel_v1.0.csv 기준, 완료 후)
  - 사용자 지시: CAD 결과물은 `cad/redesign/<dynamixel|hobby_servo>/v1.x/` 버전 폴더로 관리, 어셈블리 파일명 앞에 `1_`. README·FUSION_REDESIGN.md 폴더 규칙 갱신 필요

### 2026-10-30~31 다이나믹셀 v1.0 완료
- 한 일:
  - 출력 부품 26종: 메시→솔리드 변환(작업 규칙 위반 + Fusion 다운)을 버리고 **단면 추적 재모델링**으로 새로 그림 (`tools/trace_part.py` → `dyn_33_part_doc.py`, 측면 보스는 `dyn_34_boss_fix.py`)
  - 어셈블리 `1_microduck_dynamixel_v1.0` (Fusion 개인 프로젝트), 부품별 STEP·STL, 판재 DXF·PDF, BOM, MJCF, 검증
- 결과: 완료
  - 형상 26/26 (표면 거리 p95 ≤ 0.18 mm, 부피 차 ≤ 0.64 %), 관절 14/14 (+20° 실측), 판재 가공 4/4
  - 간섭 29자세·354쌍: 새 간섭 0 (원본에도 있는 관절 끝 각도 간섭 42건)
  - MuJoCo STAND 2 s 유지 통과, 관절 토크 원본과 ±0.5 %p
- 원본 대비 변경: `cad/redesign/dynamixel/v1.0/CHANGELOG.md` (허벅지 보강판에 무릎 접힘 여유 홈 추가 — 무릎 +62~90°에서 정강이 XL330과 5 mm 간섭)
- 확인 필요 / 가정: 위치결정 핀 생략 (사용자 확인 대기), XL330 공식 STEP 대조 아직
- 계획 대화에 요청:
  - `bom/`에 다이나믹셀 v1.0 부품 목록 반영 (`cad/redesign/dynamixel/v1.0/BOM_dynamixel_v1.0.csv`)
  - README·FUSION_REDESIGN.md 폴더 규칙 갱신: 결과물 = `cad/redesign/<dynamixel|hobby_servo>/v1.x/`, 어셈블리 파일명 앞 `1_`, 판재는 `parts/<부품>/`

### 2026-10-31 일반 서보 v1.0 (MG996R ×12 + MG90S ×2, 1.5배) 완료
- 한 일:
  - 기구 배치를 새로 설계 (`tools/hobby_layout.py`): 서보 포켓 + 혼 반대편 623ZZ U자 브래킷, yaw 관절은 혼 둘레 6706ZZ/6704ZZ
  - 셸 9종 = 다이나믹셀 v1.0 셸 ×1.5 − 내부 기구·가동 범위 스윕 영역, Fusion 어셈블리 `1_microduck_hobby_servo_v1.0`, BOM, MJCF, 검증
- 결과: 완료
  - 배치 간섭 0, 실제 메시 간섭 33자세 3547쌍 새 간섭 0 (무릎 +75° 넘김·head_pitch −90°는 원본에도 있음)
  - 관절 14/14 (+20° 실측), 구매품 위치 42/42, MuJoCo STAND 2 s 유지, 질량 1.69 kg
- 원본/계획 대비 변경: `cad/redesign/hobby_servo/v1.0/CHANGELOG.md`
  - head_pitch MG90S → MG996R (MG90S면 STAND 유지만으로 정지 토크의 34 %), 부리 서보 생략, 목 pitch 서보는 몸통에 고정, 발바닥 볼록 R150
- 확인 필요 / 가정: 무릎 유지 토크 24 % (연속 권장 20 % 약간 초과), 몸통 셸 고정 방법 v1.1, 서보 치수는 대표값(실측 필요)
- 계획 대화에 요청:
  - `plan-hobby-servo.md` 서보 수 갱신: MG996R ×11 + MG90S ×4 → **MG996R ×12 + MG90S ×2** (head_pitch MG996R, mouth 생략), 전원(UBEC) 계산도 MG996R 12개 기준으로
  - `bom/`에 `cad/redesign/hobby_servo/v1.0/BOM_hobby_servo_v1.0.csv` 반영
  - 사용자 지시: 세 번째 버전 `cad/redesign/mg996r/v1.0/` (14축 전부 MG996R) 추가 — README 폴더 규칙에 반영

### 2026-10-31 MG996R v1.0 (14축 전부 MG996R, 1.5배) 완료
- 한 일: 일반 서보 v1.0 설계에 변형(`MD_VARIANT=mg996r`) 추가 → 머리 yaw·roll MG996R, 머리 yaw 베어링 6706ZZ. Fusion `1_microduck_mg996r_v1.0`, BOM, MJCF, 검증
- 결과: 완료 — 배치 간섭 0, 메시 간섭 새 간섭 0 (33자세), 관절 14/14, STAND 유지, 질량 1.81 kg
- 일반 서보판 대비 변경: `cad/redesign/mg996r/v1.0/CHANGELOG.md` (머리 셸 나사 4 → 3곳)
- 확인 필요: 무릎 유지 토크 26 %
- 기타: 바탕화면 `마이크로덕_설계/` 에 세 버전 .f3d (사용자 요청, 저장소 밖)
- 계획 대화에 요청: README 폴더 규칙에 `cad/redesign/mg996r/` 추가, `bom/`에 BOM_mg996r_v1.0 반영

### 2026-10-31 다이나믹셀 v1.0 정리 (사용자 방침: 다이나믹셀만, 원작과 똑같이, 추가는 제안 후)
- 한 일: 오른쪽 leg·yaw2roll·hip_l 배치 오류 수정 (원작 대비 19–75 mm), 허벅지 보강판 무릎 여유 홈 제거 후 DXF·PDF·STEP 다시 냄
- 결과: 진행 중 — 출력 부품 26종 피처 재모델링 시작 예정 (순서: dynamixel/v1.0/PROGRESS.md)
- 계획 대화에 요청: 일반 서보·MG996R판은 v1.0에서 보류 (사용자 결정). 판재 주문은 피처 재모델링·사용자 확인 뒤

### 2026-11-02 다이나믹셀 v1.0 motor_support·m12_lens_holder 피처 재모델링 (사양 방식)
- 한 일: 사용자 결정("전부 피처로 다시 그리기")에 따라 각진 부품도 메시 변환 없이 피처로 그림. 새 방식 = 피처 사양 파일
  (`cad/fusion/scripts/specs/<부품>.py`: 스케치 영역, 2° 테이퍼 돌출, 회전, 모깎기, 결합) 하나를 VM(manifold3d, `tools/feat/csg_vm.py`)과
  Fusion(`feat_dsl.py`)이 같이 읽음 → VM 에서 원작과 맞춘 뒤 Fusion 에서 그대로 생성
- 치수 측정: 원작 STL 을 Fusion 프리즘 변환한 면 목록(`faces_report.py`, 결과는 측정용으로만 쓰고 버림) + 단면 꼭짓점(`tools/feat/secpts.py`)
- 결과: motor_support 106면, 원작 대비 p95 0.005 / 최대 0.01 mm, 부피 +0.02 % (클라우드 v2)
  / m12_lens_holder 45면, p95 0.006 / 최대 0.02 mm, 부피 +0.04 % (v2). 재질 ABS
- 발견: motor_support 는 원래 '구배 2° 뒤 모깎기' 로 만든 형상 (모서리 원통이 기울어져 있음) → 테이퍼 돌출 + 모깎기로 같게 재현
- 추가 (같은 날): power_support 337면 (p95 0.002 / 최대 0.2 mm, v2), yaw2roll 68면 (p95 0.005 / 최대 0.32 mm, v4).
  사양 도구 보강: 영역 테이퍼 돌출(합집합은 조각마다 따로 테이퍼), 거울 복사, 모서리 모깎기(끝점 조건), 단면→선·호 코드 변환(`tools/feat/secfit.py`)
- 추가: hip_l (T 단면 L 팔, v4), upper_leg_left/right (구배 3° 얇은 셸 + 벽 끝 자르기, 오른쪽은 왼쪽 거울, v3/v3), leg (틀·등뼈 회전 캡·보스, v2).
  원작에서 오른쪽 부품(upper_leg·ankle·foot·sole)은 왼쪽의 정확한 x 거울(차이 ≤ 0.007 mm)임을 확인 → 사양 `mirrored_ops` 로 같은 피처 + 거울
- 추가: ankle_left/right (판·받침·반원통·축/혼 구멍·발, 최대 0.05 mm). 어셈블리 참조 갱신 → v12 (바뀐 10개 부품 모두 최신)
- 추가: sole_left/right (고무, 기울어진 바닥 평면 + 기울어진 옆벽 + R7/R5.5/R8 모깎기 + 안쪽 홈, 부피 −0.02 % · p95 0.53 mm, 오른쪽 거울)
- 추가: foot_left/right (197면, 부피 −0.35 %, p95 0.13~0.18 mm, 오른쪽 거울). 어셈블리 v13 (sole·foot 4개 최신)
  위 테두리(ankle 과 같은 기울기 평면 + 앞뒤 R5) + 아래 몸통(sole 안쪽과 같은 상자·기울어진 바닥·R5) − 윗면 홈 − 반원통 자리 R16.29
  − 아래에서 자르는 갈비뼈 슬롯 11줄(간격 3.5, 폭 1.75, x 끝 0.5° 구배) − 앞 주머니 − 클립 틈 + 앞뒤 클립(경사 안쪽면, y 18.413 대칭) − 나사 구멍·카운터보어
- 남은 차이: 발 바닥 가장자리. 원작은 벽과 접하지 않는 큰 곡면(R 7~9, 위치마다 다름) + 벽 안쪽 작은 둥글림인데 R5 모깎기로 근사 (최대 1.7 mm, sole 안쪽과 같은 모양이라 서로 맞음)
- 사양 도구: 'new' 돌출이 떨어진 조각 여러 개면 같은 몸체로 합침 (Fusion 은 안 닿는 몸체를 합치지 못해 몸 밖 연결판 사용)
- 추가: soft_mouth_top (고무, 36면, p95 0.011 / 최대 0.06 mm), jaw_soft (고무, 35면, p95 0.05 / 최대 0.09 mm)
  입 부품은 x 축으로 0.5054° 기울어져 있음 → 기울어진 평면은 x 돌출 단면, 바닥 볼록 곡면은 국소 좌표에서 만든 뒤 회전.
  jaw_soft 앞면은 soft_mouth_top 앞면(구배 7.6°)과 같은 평면, 위 몸통은 soft_mouth_top 안쪽 홈보다 0.2 작음
- 사양 도구: op 'rot' (몸체 회전), Pth 'S' (맞춤 스플라인), 원작 국소 좌표 변환 `tools/feat/local_frame.py`
- 추가: face_part (97면, 부피 −0.04 %, p95 0.004 mm). 판 윤곽 = 스플라인, 큰 기둥 R3 ×4·작은 기둥 R2.25 ×4 (끝 모따기 0.5, 나사 구멍 입구 경사·드릴 끝은 회전 자르기),
  긴 구멍 둘레 턱, ㄷ자 브래킷(귀 구멍 R1.025). 어셈블리 v14 (soft_mouth_top·jaw_soft·face_part 참조 갱신)
- 분석: jaw = jaw_soft 아래 몸통 바깥으로 0.1~1.8 떨어진 얇은 쟁반(두께 1.7) + 옆 팔(y 0 까지) + 경첩 원판(R8, 가운데 R3, 작은 구멍 R1.1 ×4)
- 추가: jaw (48면, 부피 +0.36 %, p95 0.065 mm, 최대 1.0 mm = 팔 뒤 끝·바닥 이음 둥글림 생략). 어셈블리 v15
  왼쪽·오른쪽 경첩이 다름: 오른쪽 받침 R8 + 구멍 R3·R1.1×4, 왼쪽 받침 R8 + 축 R5(x −37 까지) + 구멍 R1
- 검증 (`tools/feat/verify_all.py` → `dynamixel/v1.0/verify/feature_verify.md`): 재모델링한 25개 부품 구멍 단면 모두 일치 (중심 ≤ 0.023, 반지름 ≤ 0.014 mm)
  검증에서 face_part 기둥 구멍 입구가 카운터보어(R1.35×1, R1.1×0.75)인 것을 찾아 고침 (v3)
- 어셈블리 참고 메시 69개 삭제 (ref_bottom_head_shell 만 남김), v17
- 남음: bottom_head_shell 피처 재모델링 (현재 예전 단면 쌓기 솔리드, 원작 대비 p95 0.16 mm)

### 2026-11-02 다이나믹셀 v1.0 몸통 커버 left/right_shell 피처 재모델링
- 한 일: 단면을 쌓은 솔리드(층 줄무늬) → 로프트·평면 자르기·모깎기·패치 로프트·피처 구멍으로 다시 만듦. right_shell은 left 거울 + 오른쪽만 다른 고리 구멍
- 결과: 완료 — left p50 0.013 / p95 0.34 mm (부피 −0.04 %), right p50 0.015 / p95 0.37 mm (+0.8 %), 재질 ABS
- 발견: 어셈블리로 열린 부품 문서는 읽기 전용이라 이전 neck_pitch·top_head_shell 재모델링이 클라우드에 저장 안 돼 있었음 → 다시 저장 (어셈블리 v11)
- 다음: bottom_head_shell, jaw, jaw_soft, face_part, soft_mouth_top, 그다음 브래킷·다리·발

### 2026-11-03 다이나믹셀 v1.0 bottom_head_shell 피처 재모델링 (머리 부품 마지막)
- 한 일: 잔여 차이 자동 돌출(1~3차 실패) 대신 형상별 직접 사양으로 다시 그림 — 바깥 컵·안쪽 면 z 단면 로프트, 옆 턱 y 단면 로프트, 앞 평판 기울어진 띠, 테두리 턱, 경첩·클립, 안쪽 벽·보스·구멍
  안쪽 면 단면은 바깥 윤곽에서 법선 방향으로 재료를 지나 찾음 (`tools/feat/bhs/inner.py`), 단면 자료는 `bhs/make_sec.py` 한 번에 생성
- 사양 도구: op 'loft' (y 축 단면 로프트), zloft chunk (단면 3개씩 나눠 로프트 → 합침, 여러 단면 한 번에 하면 자체 교차), comb keep (도구 몸체 남김)
- 결과: 완료 — 731면, 부피 −0.00 %, p50 0.001 / p95 0.028 / 최대 0.37 mm, 구멍 단면 54/54 (예전 솔리드 p95 0.156). 부품 v4, 어셈블리 v19, 마지막 참고 메시 삭제
- 배운 것: Fusion 은 맞닿는 스플라인 면끼리 결합하면 실패(ASM_ADDTANG/EDGECOIN) → 안쪽 피처는 cav 에서 빼고 main −= cav 한 번. 같은 단면 두 개를 연달아 로프트하면 결합 실패(BAD_CONTAINMENT)

### 2026-11-03 다이나믹셀 v1.0 right_shell 화면 표시 안 됨 수정
- 증상: 어셈블리에서 가슴(몸통 오른쪽 커버)이 안 보임. 원인: right_shell 몸체가 Fusion 화면 메시를 못 만듦 (형상·부피·내보낸 STL 은 정상, 잔여 자르기 뒤 마지막 결합에서 생긴 표시 문제).
  원작 대비 비교(부피·면 거리·구멍)로는 안 잡힘 → 확인 방법 추가: 어셈블리 모든 몸체의 displayMeshes 개수 검사
- 수정: right_shell 문서에서 몸체를 깨끗한 복사본(기본 피처)으로 교체, 형상 같음 (부피 11312.6, verify p95 0.40 mm, 구멍 44/44). 클라우드 v3, 어셈블리 v20, 표시 안 되는 몸체 0

### 2026-11-03 다이나믹셀 v1.0 BOM 재질 맞춤
- `dynamixel/v1.0/BOM_dynamixel_v1.0.csv·xlsx` (make_bom.py): 출력 부품 재질을 어셈블리 재질과 같게 — 경질 ABS 플라스틱(흰색) 1.06 g/cm³, 연질 고무 0.93 g/cm³ (이전 PETG/PLA+·TPU 95A).
  부피·질량은 현재 부품 STL 기준으로 다시 계산 (경질 합 205.5 g, 연질 31.5 g, 판재 15.4 g, XL330 270 g). 부품명은 parts/ 폴더·어셈블리 컴포넌트 이름과 같음
- 계획 대화에 요청: `bom/BOM.csv`·`bom/build_bom.py` 의 출력 소재 줄 (경질 필라멘트 PETG 1 kg → ABS 1 kg, 연질은 출력용 고무 = TPU 계열 유지 여부 결정) 갱신

### 2026-11-03 어셈블리 파란 빗살 표시 수정
- 머리 아래 파란 빗살 = bottom_head_shell 문서의 스케치 253개(예전 단면 추적용)가 켜져 있어 프로파일이 파랗게 보인 것. 형상 문제 아님
- bottom_head_shell(253)·left_shell(4)·right_shell(4) 스케치 숨김 후 저장, 어셈블리 v21: 켜진 스케치 0, 화면에 안 그려지는 몸체 0
- 앞·오른쪽 옆에서 확인: 몸통 좌우 셸 모두 보임 (앞 가운데 열린 곳은 원작과 같음)

## 2026-11-03 관절·시뮬·케이블 검증, 색, 고해상도 STL

- 관절 14/14 PASS. 정확 메시 충돌: 관절 14개 무충돌 범위가 원본과 완전히 같음 (새 간섭 0). 동역학: 정책 없는 STAND는 새·원본 모두 0.9 s에 넘어짐(정책 필요), 몸끼리 접촉 0. 케이블: 플러그·경로 원본 대비 차이 ≤ 4%p / +4 mm. hat→34만 250 mm 권장. 상세: `cad/redesign/dynamixel/v1.0/verify/sim_cable_report.md`.
- 색: 제품 사진 기준. 크림(윗머리·몸통 셸·허벅지), 주황(부리 jaw·jaw_soft·soft_mouth_top·아래 머리 셸·발목), 노랑(눈 링·발·발바닥), 회색(얼굴판·hip_l·정강이·전원 지지대·banana), 진회색(neck_pitch), 검정(yaw2roll·yaw_roll_motion·motor_support·렌즈 홀더·XL330). Fusion 외관 "MD 크림/주황/노랑/회색/진회색/검정", MJCF material rgba, BOM 재질 칸에 반영.
- parts/*/*.stl 재출력: 사용자 지정 메시(곡면 편차 0.02 mm, 법선 편차 4°) — 이전 High(0.05 mm, 10°)보다 매끄러움. MJCF assets는 시뮬 속도 때문에 이전 메시 유지.
- 남은 것: bottom_head_shell 뒤쪽 계단(층) 면 — 메시 해상도가 아니라 형상 자체라 재모델링 필요.

### 계획 대화에 요청
- bom/BOM.csv 출력 색: 크림·주황·노랑·회색·검정 ABS, 고무(주황·노랑) — dynamixel v1.0 BOM 참고.
- docs/assembly OPERATION.md 3절: hat→34 케이블 250 mm, 목 30·31·허벅지 12/22 케이블은 조립 전에 꽂기.

### 2026-11-03 다이나믹셀 v1.0 겉면 재모델링 — left_shell
- 요청: 셸·머리 아래 커버 등 겉면이 원작 메시 단면을 따라 그려 조각면이 많음 → 단면 스플라인 로프트 1번 + 셸 + 피처로 다시
- 한 일: left_shell 사양 `specs/left_shell.py` 새로 씀 (바깥 로프트 7단면 → 셸 2.2 → 원작 평면(2° 기울어짐)으로 자르기 → 팔 판·혼 원판·고리 관·보스·클립·혀 → 구멍)
  원작 메시의 평면 조각을 묶어 자르기 평면을 찾음 (위 날개 끝 y = 25 − 0.0349x, 앞 턱 위 z = 36 + 0.0349x, 뒤 말림 아래 z = 49.7 − 0.0349x, 앞 턱 끝 y = −12.98 + 0.0349x)
- 결과: 1417면 → 118면, 부피 +0.08 %, p95 0.093 mm (예전 0.374), 최대 0.93 mm (예전 3.33), 구멍 단면 44/44. 부품 v6 (스케치 숨김)
- 사양 도구: run_install 이 저장 전 스케치·작업 평면 숨김
- right_shell: left 사양 거울 + 오른쪽 차이(관 구배 1.5°, 고리 구멍 r0.8/r1.5 원뿔, 끝 바깥 껍질 1.0) → 1504면 → 122면, p95 0.093 / 최대 0.91 mm, 구멍 44/44. 기본 피처 없이 피처만 (부품 v5)
- bottom_head_shell: 컵 z 단면 로프트(3개씩 나눔, 층 무늬) → 위 단면 3° 구배 프리즘 ∩ 앞벽 곡선 ∩ 바닥 곡면 + R5 모깎기 (안쪽 3° + R3.3). 731면 → 622면, p95 0.026 / 최대 0.62 mm(원작 두께 0 조각), 구멍 54/54 (부품 v6). 옆 턱 홈 y 단면 로프트는 그대로
- yaw_roll_motion (11-08): 22층 돌출 → 판·띠·팔·통·혼 원판 피처 + 모따기·구멍. 272면 → 67면, p95 0.005 / 최대 0.01 mm, 구멍 39/39 (부품 v3). 팔 아래 호는 통 R9 접점을 계산해 넣음
- banana_pcb_locker (11-08): 판 윤곽 1° 구배 프리즘 + 걸쇠 2 + 구멍 2. 98면 → 28면, p95 0.001 / 최대 0.01 mm, 구멍 2/2 (부품 v2). power_support 는 이미 피처 모델이라 그대로
- top_head_shell (11-09, 사용자 지적 '맨 위 커버에 튀어나온 것'): 나사 기둥 3개 끝이 바깥면 밖으로 최대 3.3 mm → 바깥 로프트 덩어리와 교집합 후 붙임. p95 0.108 / 최대 2.07, 구멍 33/33 (부품 v3)
- bottom_head_shell 옆 턱 홈 (11-09, 사용자 지적 '주황 커버 면이 나뉘어 보임'): y 단면 26개 로프트(3개씩) → 계단 곡선 S 바깥에서 바닥 2.1 올림 + R2.9/R1, 안쪽 R1.25/R2.8. 622 → 481면, p95 0.032 / 최대 0.61, 구멍 54/54 (부품 v8). 홈 뒤 끝 안쪽은 0.6~1.0 mm 차이 남음

### 2026-11-09 구동 테스트 (사용자 요청 "잘 버티는지, 잘 조립되는지")
- 관절 14/14, 무충돌 범위·보행 자세 187개 충돌·서 있기 토크·서기/앉기 시뮬 모두 원본과 같음. 균형 제어 없이는 원본처럼 넘어짐 (정책 필요)
- 조립 맞물림(같은 바디 안 부품 쌍까지, `tools/verify_sim/asmfit.py`)에서 찾아 고침: top_head_shell 부리 서보 모서리 자리(0.64 mm 파고듦), 아래 셸 립 자리(0.92 mm), z 0 아래 처짐 → 부품 v11
- MJCF neck 판 메시 25 mm 밀림(두 판이 한쪽에 겹침, 시뮬만) → assets/neck.stl, build_mjcf.py 고침
- 보고서 `cad/redesign/dynamixel/v1.0/verify/drive_test_2026-11-09.md`
