lsk0522/microduck/cad/redesign/dynamixel/v1.0/CHANGELOG.md

# 변경 기록 — 다이나믹셀 v1.0 (원본 Pollen Microduck 대비)

| 부품 | 바뀐 점 | 이유 | 질량 |
|---|---|---|---|
| upper_leg_rigidity_plate | 외곽 58.1×45.0 → 57.78×44.00 (구멍 + 1.5t 접선 외곽), 경량 홈 3 → 2 (단순 장공). ~~무릎 접힘 여유 홈~~ 2026-10-31 원작대로 되돌림 (추가 제안 목록으로) | 가공 조건 | 2.0 → 2.77 g |
| trunk_base | 뒤 테두리 1.35 → 1.5 mm, 위치결정 핀(Ø1.7, XL330 앞 구멍) 생략 | 가공 조건, 판재에 핀 불가 (핀 자리 웹 0.37 mm라 구멍도 불가) | 3.7 → 3.61 g |
| bearing_roll | 아래 테두리 0.89 → 1.5 mm (0.6 mm 확장), 위치결정 핀 생략. 좌우 같은 부품 확인 | 가공 조건 | 1.6 → 1.58 g |
| neck | 20×11 → 24.3×13.3 (테두리 0.84 → 3.0 = 1.5t) | 2 mm 판 가공 조건 | 1.1 → 1.56 g (2 mm) |
| 출력 부품 26종 | 원본 형상을 단면 추적으로 새로 그림 (형상 오차 p95 ≤ 0.18 mm) | v1.0 = 원본 끼워 맞춤 보존 | 원본과 ±0.6 % |
| yaw2roll, hip_l, neck_pitch, upper_leg_left/right | 측면 원통 보스(Ø16 축, Ø18, Ø1.7 핀, 혼 보스)를 정확한 원통으로 | 단면 층 계단(최대 ±0.3 mm)이 베어링 끼움에 영향 | — |
| 구매품 | XL330·베어링(실드 홈 깊이 원본대로)·배터리(NP-F 윗면 R8)·보드·렌즈·스피커 단순 모델 | 체결·간섭 검사용 | — |

MJCF 질량·관성은 원본(Pollen 실측) 그대로 둠. 새 CAD 질량은 BOM 참고.

## 2026-10-31 수정
- 어셈블리 오른쪽 `leg`(정강이), `yaw2roll`, `hip_l` 위치가 원작과 달랐음 (19–75 mm 어긋남) → 원작 위치로. 검증은 MJCF 기준이라 Fusion 배치 오류를 못 잡았음 → 이제 부품마다 원작 참조 메시와 경계상자 비교 (61/61 일치, 판재는 가공용 외곽 차이만)
- 무릎 접힘 여유 홈 제거 (원작에 없는 추가). 무릎 +62~90°에서 정강이 XL330과 닿는 건 원작과 같음
