lsk0522/microduck/cad/redesign/mg996r/v1.0/CHANGELOG.md

# 변경 기록 — MG996R v1.0 (일반 서보 v1.0 대비)

원본 대비 변경은 `../../hobby_servo/v1.0/CHANGELOG.md` 와 같고, 아래만 다르다.

| 항목 | 일반 서보 v1.0 | MG996R v1.0 | 이유 |
|---|---|---|---|
| head_yaw, head_roll | MG90S | **MG996R** | 사용자 요청: 서보 한 종류 |
| 머리 yaw 혼 둘레 베어링 | 6704ZZ (20×27×4) | **6706ZZ** (30×37×4) | 25T 혼 Ø24가 6704 안지름 20을 못 지나감 |
| neck_pitch_frame 윗판 컵 | 6704 안고리, 혼 나사 PCD 9 (M2) | 6706 안고리, PCD 14 (M3) | 혼 변경 |
| yaw_roll_frame | MG90S 하우징, 롤 U 바탕 y 15–19 | MG996R 하우징, 롤 U 바탕 y 22.5–26.5 | 서보가 커짐 |
| head_frame 셸 고정 | M4 ×4 | **M4 ×3** — (9.9, 28.5) 자리 뺌, 왼쪽 보는 x 28·y 27.5부터 | 롤 U 바탕과 머리 요 하우징(R21.5, 롤 25°)이 그 자리를 지나감 |
| 질량 | 1.69 kg | 1.81 kg | MG996R 55 g vs MG90S 13.4 g, 큰 브래킷 |
| 무릎 STAND 유지 토크 | 24 % | 26 % | 머리가 무거워짐 |
