lsk0522/microduck/cad/redesign/hobby_servo/v1.0/CHANGELOG.md

# 변경 기록 — 일반 서보 v1.0 (원본 Pollen Microduck 대비)

원본 기구학(관절 이름·축·부호·가동 범위·바디 구조)을 **1.5배**로 키우고, 서보를 MG996R / MG90S로 바꿔 내부 기구를 새로 설계했다.
기준: `plan-hobby-servo.md` (계획 대화), `cad/hobby_servo/reference_1.5x/joint_frames.csv`.

| 항목 | 원본 / 계획 | v1.0 | 이유 |
|---|---|---|---|
| 크기 | 25 cm | ×1.5 (관절 위치·셸 모두) | MG996R(40.7×19.7×42.9)이 원본 다리에 안 들어감 |
| 다리 10축 + 목 pitch | XL330 | MG996R ×11 | 계획대로 |
| **머리 pitch** | 계획: MG90S | **MG996R** | 1.5배 머리(약 330 g) STAND 유지 토크 0.087 N·m = MG90S 정지 토크의 **34–39 %** (연속 권장 20 % 초과) → MG996R로 8 %. 서보는 목 안에 있어 머리 무게는 그대로 |
| 머리 yaw·roll | XL330 | MG90S ×2 | 토크 0–2.5 % |
| 부리(mouth) 서보 | 계획: MG90S, 생략 가능 | **생략** | 정책이 쓰지 않음 (계획 문서 "생략 가능") |
| 목 pitch 서보 위치 | 원본: 목 링크 쪽 | **몸통에 고정**, 목은 서보를 감싸는 U자 | 1.5배에서 목 서보가 고관절 yaw 서보 포켓과 겹침 |
| 관절 지지 | XL330 혼 + 반대편 축 | 혼 + 반대편 **623ZZ + M3 볼트** U자 브래킷 | MG996R은 반대편 축이 없음 |
| yaw 관절 지지 | 16×22×4 베어링 | 고관절 **6706ZZ** (30×37×4), 머리 **6704ZZ** (20×27×4)를 혼 둘레에 | 혼 Ø24 / Ø16을 감싸 기울어짐 하중을 받음 |
| 혼 | XL330 혼 | 25T 알루미늄 혼 Ø24 / 20T 금속 혼 Ø16 | 계획대로 (플라스틱 혼은 헐거워짐) |
| 내부 브래킷 18종 | 원본 출력물 | **새로 설계** (축 정렬 상자·원통 합집합 − 절삭, `tools/hobby_layout.py`) | 서보가 달라 원본 형상을 쓸 수 없음 |
| 외형 셸 9종 | 원본 셸 | 다이나믹셀 v1.0 셸(단면 추적본) ×1.5 − 새 내부 기구 + 가동 범위 스윕 영역 (+1 mm) | 외형 유지. 원본 STL 직접 변환 아님 |
| 몸통 셸 앞쪽 | — | x ≈ 38 mm 앞으로 잘림 | 목 U자·머리 pitch 서보가 neck_pitch −90..60° 도는 공간 |
| 발바닥 | 평평 | 볼록 R150 (가운데 3.2 mm 높음) | STAND의 hip roll ±5°에서 평발 모서리만 닿아 미끄러짐 (MuJoCo) |
| 전장 | XL330 버스 + Radxa/HAT | Pi Zero 2 W + PCA9685 + ADS1115 ×4 + UBEC 6 V 10 A + 5 V buck + BNO085, 2S 2200 mAh | 계획 문서 전원 구성 (외형·질량만) |
| 질량 | 원본 0.74 kg, 계획 추정 1.4–1.7 kg | **1.69 kg** (CAD, 채움률 반영) | 서보 12×55 g = 660 g |

## 원본과 같은 것 (확인됨)
- 관절 14개 이름·축·부호·범위·부모/자식 바디 = MJCF (`verify/joints.json`)
- 끝 각도 간섭 2곳은 원본에도 있음: 무릎 +75° 넘으면 발이 hip_l에 닿음, head_pitch −90°(목 0°)에서 머리 셸이 몸통에 닿음
