lsk0522/microduck/cad/redesign/mg996r/v1.0/mjcf/robot_allcollisions.xml

<?xml version='1.0' encoding='utf-8'?>
<mujoco model="microduck">
  <compiler angle="radian" meshdir="assets" autolimits="true" />
  <default>
    <default class="microduck">
      <joint frictionloss="0.1" armature="0.005" />
      <position kp="50" dampratio="1" />
      <default class="visual">
        <geom type="mesh" contype="0" conaffinity="0" group="2" />
      </default>
      <default class="collision">
        <geom group="3" />
      </default>
    </default>
  </default>
  
  <default>
    <default class="perfect_actuator">
      <geom contype="0" conaffinity="0" />
      <joint damping="0.15" frictionloss="0.1" armature="0.001" />
      <position kp="10.0" kv="0.1" forcerange="-20.0 20.0" />
    </default>
    <default class="chosen_actuator_old">
      <geom contype="0" conaffinity="0" />
      <joint damping="0.048" frictionloss="0.006" armature="0.002" />
      <position kp="0.52" kv="0.0" forcerange="-0.91 0.91" ctrlrange="-10.0 10.0" />
    </default>
    <default class="chosen_actuator_new">
      
      <geom contype="0" conaffinity="0" />
      <joint damping="0.041" frictionloss="0.032" armature="0.002" />
      <position kp="0.386" kv="0.0" forcerange="-0.67 0.67" ctrlrange="-10.0 10.0" />
    </default>
    <default class="chosen_actuator_antoine">
      <geom contype="0" conaffinity="0" />
      <joint damping="0.044" frictionloss="0.013" armature="0.0017" />
      <position kp="0.43" kv="0.0" forcerange="-0.75 0.75" ctrlrange="-10.0 10.0" />
    </default>
    <default class="chosen_actuator">
      
      <geom contype="0" conaffinity="0" />
      <joint damping="0.053" frictionloss="0.0048" armature="0.0018" />
      
      <position kp="0.55" kv="0.0" forcerange="-0.96 0.96" ctrlrange="-10.0 10.0" />
      
      
    </default>
    <default class="passive_wheel">
      <geom contype="0" conaffinity="0" />
      <joint damping="0.0" frictionloss="0.0" armature="0.0001" />
    </default>
    <default class="passive_joint">
      <geom contype="0" conaffinity="0" />
      <joint damping="0.0" frictionloss="0.0" armature="0.0001" />
    </default>
  </default>
  
  <sensor>
    <framequat name="orientation" objtype="site" noise="0.001" objname="imu" />
    <gyro name="angular-velocity" site="imu" noise="0.005" />
    <gyro name="imu_ang_vel" site="imu" />
    <velocimeter name="imu_lin_vel" site="imu" />
    <accelerometer name="imu_accel" site="imu" />
    <subtreeangmom name="root_angmom" body="trunk_base" />
  </sensor>
  
  <default>
    <default class="self_collision_only">
      <geom group="3" contype="2" conaffinity="2" />
    </default>
    <equality solref="0.002 1" solimp="0.99 0.999 0.0005 0.5 2" />
  </default>
  
  
  
  
  
  
  
  
  
  <contact>
    <exclude body1="neck_pitch" body2="jaw_soft" />
  </contact>
  <worldbody>
    
    <body name="trunk_base" pos="0 0 0.18" quat="1 0 0 0" childclass="microduck">
      <freejoint name="trunk_base_freejoint" />
      <inertial pos="-0.0107764 -0.000291841 0.0126955" mass="0.485338" fullinertia="0.000743434 0.000931876 0.000717437 5.58836e-06 -0.000158621 3.52434e-06" />
      
      <geom class="visual" mesh="mg996r_hip_yaw_left" /><geom class="visual" mesh="mg996r_neck_pitch" /><geom class="visual" mesh="trunk_frame" /><geom class="visual" mesh="battery_2s2200" /><geom class="visual" mesh="pi_zero_2w" /><geom class="visual" mesh="pca9685" /><geom class="visual" mesh="ads1115_1" /><geom class="visual" mesh="ads1115_2" /><geom class="visual" mesh="ads1115_3" /><geom class="visual" mesh="ads1115_4" /><geom class="visual" mesh="ubec_6v10a" /><geom class="visual" mesh="buck_5v3a" /><geom class="visual" mesh="bno085" /><geom class="visual" mesh="battery_tray" /><geom class="visual" mesh="mg996r_hip_yaw_right" /><geom class="visual" mesh="left_shell" /><geom class="visual" mesh="right_shell" /><site group="3" name="imu" pos="-0.0315 9.96147e-05 -0.0220476" quat="1 -0 -0 -0" />
      
      <body name="yaw2roll" pos="0.009 0.02625 -0.0075" quat="0 -0.707107 -0.707107 -0">
        
        <joint axis="0 0 1" name="left_hip_yaw" type="hinge" range="-0.4363323129985824 0.5235987755982988" class="chosen_actuator" />
        <inertial pos="1.22323e-10 0.00541657 0.0215146" mass="0.081785" fullinertia="3.66787e-05 3.07142e-05 1.43125e-05 5.09684e-14 -4.79955e-14 -3.10943e-06" />
        
        <geom class="visual" mesh="horn_mg996r_hip_yaw_left" /><geom class="visual" mesh="yaw2roll_left" /><geom class="visual" mesh="mg996r_hip_roll_left" /><geom class="visual" mesh="bearing_6706_left" /><body name="hip_l" pos="0 0.02475 0.01875" quat="0.707107 -0.707107 0 -0">
          
          <joint axis="0 0 1" name="left_hip_roll" type="hinge" range="-0.3839724354386992 0.38397243543880577" class="chosen_actuator" />
          <inertial pos="0.0292935 -3.56403e-12 -0.0140592" mass="0.0302676" fullinertia="1.32748e-05 3.68486e-05 2.62164e-05 -5.37272e-15 3.23409e-06 9.03555e-15" />
          
          <geom class="visual" mesh="horn_mg996r_hip_roll_left" /><geom class="visual" mesh="horn_mg996r_hip_pitch_left" /><geom class="visual" mesh="hip_l_left" /><geom class="visual" mesh="bearing_623_hip_roll_left" /><geom class="visual" mesh="bearing_623_hip_pitch_left" /><body name="upper_leg_left" pos="0.0375 0 -0.02775" quat="0.5 -0.5 0.5 -0.5">
            
            <joint axis="0 0 1" name="left_hip_pitch" type="hinge" range="-1.570796326794949 1.5707963267948442" class="chosen_actuator" />
            <inertial pos="0.0113977 0.0319298 0.0213105" mass="0.130226" fullinertia="9.0607e-05 4.63856e-05 0.000105128 -3.21738e-05 2.02053e-07 -1.92396e-07" />
            
            <geom class="visual" mesh="upper_leg_left" /><geom class="visual" mesh="mg996r_hip_pitch_left" /><geom class="visual" mesh="mg996r_knee_left" /><body name="leg" pos="0.033 0.0536656 -0.006" quat="0 0.707107 0.707107 0">
              
              <joint axis="0 0 1" name="left_knee" type="hinge" range="-1.5707963267948983 1.5707963267948948" class="chosen_actuator" />
              <inertial pos="4.34982e-06 0.0436948 -0.0147838" mass="0.0812148" fullinertia="5.73464e-05 2.09216e-05 4.32937e-05 -4.05592e-13 -1.9952e-13 -2.34972e-06" />
              
              <geom class="visual" mesh="horn_mg996r_knee_left" /><geom class="visual" mesh="leg_left" /><geom class="visual" mesh="bearing_623_knee_left" /><geom class="visual" mesh="mg996r_ankle_left" /><body name="ankle_left" pos="-0 0.063 -0.039" quat="0 -1 -0 0">
                
                <joint axis="0 0 1" name="left_ankle" type="hinge" range="-1.5707963267949063 1.5707963267948868" class="chosen_actuator" />
                <inertial pos="-0.00778976 -0.0220042 -0.021477" mass="0.0487563" fullinertia="2.69207e-05 4.05776e-05 2.92093e-05 -2.52443e-06 -8.10553e-07 -2.38115e-06" />
                
                <geom class="visual" mesh="horn_mg996r_ankle_left" /><geom class="visual" mesh="ankle_left" /><geom class="visual" mesh="bearing_623_ankle_left" /><geom class="visual" mesh="sole_left" /><geom class="collision" type="mesh" mesh="sole_left" name="left_foot_collision" /><site group="3" name="left_foot" pos="-0 -0.0357219 -0.0211278" quat="0 -0 -0.707107 -0.707107" />
              </body>
            </body>
          </body>
        </body>
      </body>
      
      <body name="neck" pos="0.039 0.02175 0.0486323" quat="0 0 0.707107 -0.707107">
        
        <joint axis="0 0 1" name="neck_pitch" type="hinge" range="-1.5707963267948974 1.0471975511965967" class="chosen_actuator" />
        <inertial pos="-1.71727e-10 -0.0525036 0.0224694" mass="0.0856784" fullinertia="7.32852e-05 2.13012e-05 5.90113e-05 -2.76759e-15 1.15559e-13 5.97647e-06" />
        
        <geom class="visual" mesh="neck_frame" /><geom class="visual" mesh="horn_mg996r_neck_pitch" /><geom class="visual" mesh="bearing_623_neck_pitch" /><geom class="visual" mesh="mg996r_head_pitch" /><body name="neck_pitch" pos="-0 -0.075 0" quat="0 1 -0 -0">
          
          <joint axis="0 0 1" name="head_pitch" type="hinge" range="-1.5707963267948966 1.5707963267948966" class="chosen_actuator" />
          <inertial pos="5.84826e-08 0.018149 -0.018178" mass="0.0299618" fullinertia="1.50503e-05 1.18865e-05 7.23782e-06 -1.86473e-11 6.25973e-12 2.02946e-06" />
          
          <geom class="visual" mesh="horn_mg996r_head_pitch" /><geom class="visual" mesh="neck_pitch_frame" /><geom class="visual" mesh="bearing_623_head_pitch" /><geom class="visual" mesh="horn_mg996r_head_yaw" /><geom class="visual" mesh="bearing_6706_head_yaw" /><body name="yaw_roll_motion" pos="-0 0.0280396 -0.02175" quat="0 -0 -0.707107 -0.707107">
            
            <joint axis="0 0 1" name="head_yaw" type="hinge" range="-2.9670597283903613 2.9670597283903595" class="chosen_actuator" />
            <inertial pos="-0.00718208 -0.00645965 0.0238891" mass="0.088825" fullinertia="3.03602e-05 4.18448e-05 5.09745e-05 9.95765e-06 -1.30149e-06 1.14122e-06" />
            
            <geom class="visual" mesh="yaw_roll_frame" /><geom class="visual" mesh="mg996r_head_yaw" /><geom class="visual" mesh="horn_mg996r_head_roll" /><geom class="visual" mesh="bearing_623_head_roll" /><body name="jaw_soft" pos="-0.02685 0 0.02175" quat="0.707107 0 -0.707107 -0">
              
              <joint axis="0 0 1" name="head_roll" type="hinge" range="-0.43633231299858327 0.4363323129985815" class="chosen_actuator" />
              <inertial pos="0.00635013 -0.00295002 -0.0426105" mass="0.372336" fullinertia="0.00170125 0.00140347 0.000756973 -9.93486e-06 7.13382e-05 5.21786e-05" />
              
              <geom class="visual" mesh="head_frame" /><geom class="visual" mesh="mg996r_head_roll" /><geom class="visual" mesh="top_head_shell" /><geom class="visual" mesh="bottom_head_shell" /><geom class="visual" mesh="face_part" /><geom class="visual" mesh="jaw" /><geom class="visual" mesh="jaw_soft" /><geom class="visual" mesh="soft_mouth_top" /><geom class="visual" mesh="noenoeil" /><site group="3" name="head_camera" pos="0.02325 -0.000137067 -0.10995" quat="0.707107 -0 0.707107 0" />
              <camera name="head_camera" pos="0.0155 -9.13778e-05 -0.0733" quat="0 0 -1 0" />
              
              <site group="3" name="tof" pos="0.02025 0.0336129 -0.10995" quat="0.707107 -0 0.707107 0" />
              
              <site group="3" name="head_imu" pos="0.0228484 0.000166604 -0.07659" quat="1 0 -0 0" />
              
              <site group="3" name="mouth_tip" pos="-0.01214 -0 -0.116607" quat="0.704015 -0 0.710185 0" />
            </body>
          </body>
        </body>
      </body>
      
      <body name="bearing_roll" pos="0.009 -0.02625 -0.0075" quat="0 -0.707107 -0.707107 0">
        
        <joint axis="0 0 1" name="right_hip_yaw" type="hinge" range="-0.523598775598297 0.43633231299858416" class="chosen_actuator" />
        <inertial pos="-1.26332e-10 0.00541657 0.0215146" mass="0.081785" fullinertia="3.66787e-05 3.07142e-05 1.43125e-05 -4.96545e-14 4.04721e-14 -3.10943e-06" />
        
        <geom class="visual" mesh="horn_mg996r_hip_yaw_right" /><geom class="visual" mesh="yaw2roll_right" /><geom class="visual" mesh="mg996r_hip_roll_right" /><geom class="visual" mesh="bearing_6706_right" /><body name="hip_l_2" pos="-0 0.02475 0.01875" quat="0 0 0.707107 0.707107">
          
          <joint axis="0 0 1" name="right_hip_roll" type="hinge" range="-0.3839724354387507 0.38397243543875426" class="chosen_actuator" />
          <inertial pos="0.0292935 3.56404e-12 -0.0140592" mass="0.0302676" fullinertia="1.32748e-05 3.68486e-05 2.62164e-05 5.37269e-15 3.23409e-06 -9.03554e-15" />
          
          <geom class="visual" mesh="horn_mg996r_hip_roll_right" /><geom class="visual" mesh="horn_mg996r_hip_pitch_right" /><geom class="visual" mesh="hip_l_right" /><geom class="visual" mesh="bearing_623_hip_roll_right" /><geom class="visual" mesh="bearing_623_hip_pitch_right" /><body name="upper_leg_right" pos="0.0375 0 -0.02775" quat="0.5 -0.5 0.5 -0.5">
            
            <joint axis="0 0 1" name="right_hip_pitch" type="hinge" range="-1.57079632679494 1.570796326794853" class="chosen_actuator" />
            <inertial pos="-0.0113977 0.0319298 0.0213105" mass="0.130226" fullinertia="9.0607e-05 4.63856e-05 0.000105128 3.21738e-05 -2.02053e-07 -1.92396e-07" />
            
            <geom class="visual" mesh="upper_leg_right" /><geom class="visual" mesh="mg996r_hip_pitch_right" /><geom class="visual" mesh="mg996r_knee_right" /><body name="leg_2" pos="-0.033 0.0536656 -0.006" quat="0 1 -0 -0">
              
              <joint axis="0 0 1" name="right_knee" type="hinge" range="-1.5707963267949339 1.5707963267948593" class="chosen_actuator" />
              <inertial pos="-0.0436948 -4.34982e-06 -0.0147838" mass="0.0812148" fullinertia="2.09216e-05 5.73464e-05 4.32937e-05 -4.05239e-13 2.34972e-06 1.99394e-13" />
              
              <geom class="visual" mesh="horn_mg996r_knee_right" /><geom class="visual" mesh="leg_right" /><geom class="visual" mesh="bearing_623_knee_right" /><geom class="visual" mesh="mg996r_ankle_right" /><body name="ankle_right" pos="-0.063 0 -0.039" quat="0 -0.707107 -0.707107 0">
                
                <joint axis="0 0 1" name="right_ankle" type="hinge" range="-1.5707963267949028 1.5707963267948903" class="chosen_actuator" />
                <inertial pos="0.00778976 -0.0220042 -0.021477" mass="0.0487563" fullinertia="2.69207e-05 4.05776e-05 2.92093e-05 2.52443e-06 8.10553e-07 -2.38115e-06" />
                
                <geom class="visual" mesh="horn_mg996r_ankle_right" /><geom class="visual" mesh="ankle_right" /><geom class="visual" mesh="bearing_623_ankle_right" /><geom class="visual" mesh="sole_right" /><geom class="collision" type="mesh" mesh="sole_right" name="right_foot_collision" /><site group="3" name="right_foot" pos="0 -0.0357219 -0.0211278" quat="0.707107 -0.707107 -0 0" />
              </body>
            </body>
          </body>
        </body>
      </body>
    </body>
  </worldbody>
  <asset>
    <material name="seeed_bearing__configuration__22x16x4_material" rgba="0.811765 0.858824 0.898039 1" />
    <material name="right_shell_material" rgba="0.85098 0.85098 0.839216 1" />
    <material name="banana_pcb_locker_material" rgba="0.647059 0.647059 0.647059 1" />
    <material name="trunk_base_material" rgba="0.129412 0.152941 0.129412 1" />
    <material name="xl330_material" rgba="0.286275 0.286275 0.286275 1" />
    <material name="power_support_material" rgba="0.67451 0.639216 0.603922 1" />
    <material name="np_f970_material" rgba="0.301961 0.301961 0.301961 1" />
    <material name="left_shell_material" rgba="0.8 0.8 0.8 1" />
    <material name="yaw2roll_material" rgba="0.129412 0.152941 0.129412 1" />
    <material name="bearing_roll_material" rgba="0.129412 0.152941 0.129412 1" />
    <material name="hip_l_material" rgba="0.67451 0.639216 0.603922 1" />
    <material name="upper_leg_left_material" rgba="0.85098 0.85098 0.839216 1" />
    <material name="upper_leg_rigidity_plate_material" rgba="0.67451 0.639216 0.603922 1" />
    <material name="leg_material" rgba="0.67451 0.639216 0.603922 1" />
    <material name="sole_left_material" rgba="0.956863 0.686275 0.137255 1" />
    <material name="foot_left_material" rgba="1 0.403922 0.121569 1" />
    <material name="seeed_bearing__configuration_default_material" rgba="0.811765 0.858824 0.898039 1" />
    <material name="ankle_left_material" rgba="1 0.403922 0.121569 1" />
    <material name="neck_material" rgba="0.67451 0.639216 0.603922 1" />
    <material name="neck_pitch_material" rgba="0.34902 0.376471 0.4 1" />
    <material name="yaw_roll_motion_material" rgba="0.129412 0.152941 0.129412 1" />
    <material name="lens_material" rgba="0.262745 0.282353 0.301961 1" />
    <material name="face_part_material" rgba="0.67451 0.639216 0.603922 1" />
    <material name="jaw_soft_material" rgba="0.85098 0.756863 0.866667 1" />
    <material name="motor_support_material" rgba="0.129412 0.152941 0.129412 1" />
    <material name="top_head_shell_material" rgba="0.85098 0.85098 0.839216 1" />
    <material name="elec_rpi_robot_hat_pcb_material" rgba="0.313725 0.486275 0.411765 1" />
    <material name="soft_mouth_top_material" rgba="0.85098 0.756863 0.866667 1" />
    <material name="noenoeil_material" rgba="0.956863 0.686275 0.137255 1" />
    <material name="jaw_material" rgba="1 0.403922 0.121569 1" />
    <material name="bottom_head_shell_material" rgba="1 0.403922 0.121569 1" />
    <material name="m12_lens_holder_material" rgba="0.262745 0.282353 0.301961 1" />
    <material name="pcb__raspberry_pi_zero_2_w_material" rgba="0.498039 0.498039 0.498039 1" />
    <material name="speaker_material" rgba="0.294118 0.290196 0.290196 1" />
    <material name="upper_leg_right_material" rgba="0.85098 0.85098 0.839216 1" />
    <material name="ankle_right_material" rgba="1 0.403922 0.121569 1" />
    <material name="sole_right_material" rgba="0.956863 0.686275 0.137255 1" />
    <material name="foot_right_material" rgba="1 0.403922 0.121569 1" />
  <mesh name="mg996r_hip_yaw_left" file="mg996r_hip_yaw_left.stl" /><mesh name="horn_mg996r_hip_yaw_left" file="horn_mg996r_hip_yaw_left.stl" /><mesh name="yaw2roll_left" file="yaw2roll_left.stl" /><mesh name="mg996r_hip_roll_left" file="mg996r_hip_roll_left.stl" /><mesh name="horn_mg996r_hip_roll_l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
  <actuator>
    <position class="chosen_actuator" name="left_hip_yaw" joint="left_hip_yaw" />
    <position class="chosen_actuator" name="left_hip_roll" joint="left_hip_roll" />
    <position class="chosen_actuator" name="left_hip_pitch" joint="left_hip_pitch" />
    <position class="chosen_actuator" name="left_knee" joint="left_knee" />
    <position class="chosen_actuator" name="left_ankle" joint="left_ankle" />
    <position class="chosen_actuator" name="neck_pitch" joint="neck_pitch" />
    <position class="chosen_actuator" name="head_pitch" joint="head_pitch" />
    <position class="chosen_actuator" name="head_yaw" joint="head_yaw" />
    <position class="chosen_actuator" name="head_roll" joint="head_roll" />
    <position class="chosen_actuator" name="right_hip_yaw" joint="right_hip_yaw" />
    <position class="chosen_actuator" name="right_hip_roll" joint="right_hip_roll" />
    <position class="chosen_actuator" name="right_hip_pitch" joint="right_hip_pitch" />
    <position class="chosen_actuator" name="right_knee" joint="right_knee" />
    <position class="chosen_actuator" name="right_ankle" joint="right_ankle" />
  </actuator>
  <equality />
</mujoco>
