lsk0522/microduck/cad/redesign/dynamixel/v1.0/parts/neck/neck.pdf

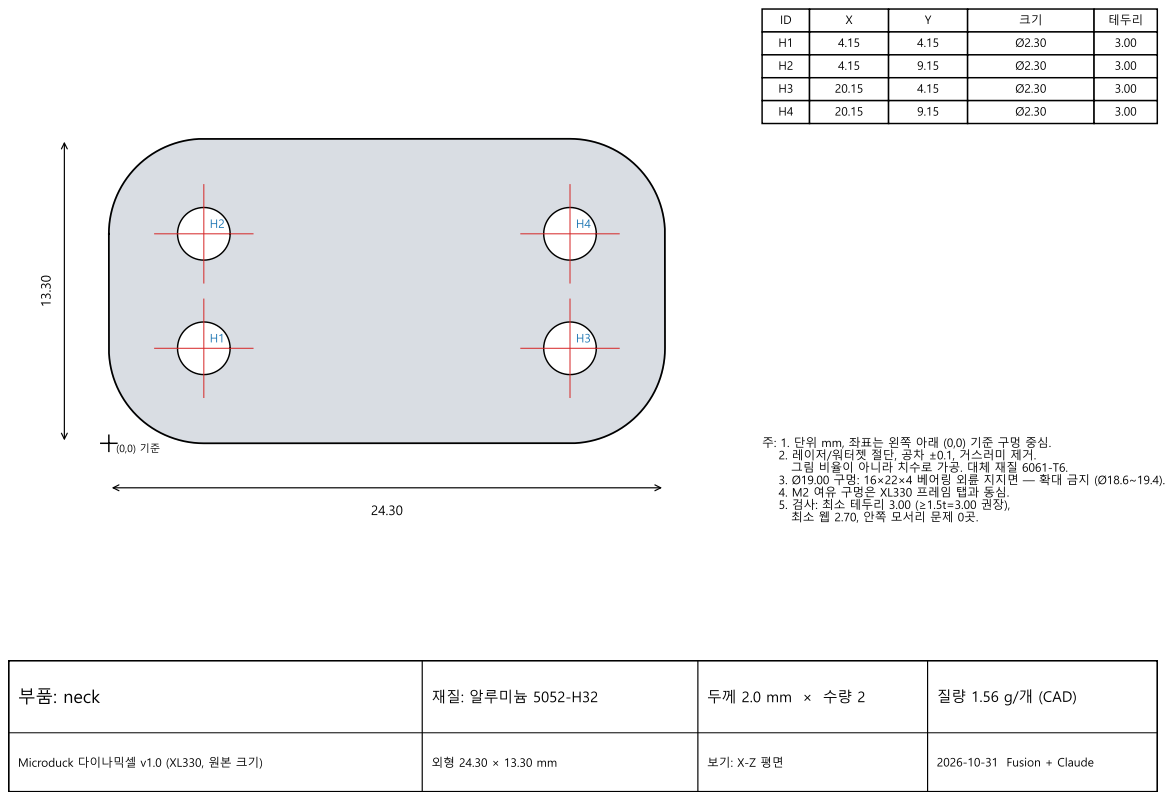
[picture p236: page 1]
테두리; 부품: neck; 재질: 알루미늄 5052-H32; 질량 1.56 g/개 (CAD); 2026-10-31 Fusion + Claude

주: 1. 단위 mm, 좌표는 왼쪽 아래 (0,0) 기준 구멍 중심.
2. 레이저/워터젯 절단, 공차 ±0.1, 거스러미 제거.
그림 비율이 아니라 치수로 가공. 대체 재질 6061-T6.
3. Ø19.00 구멍: 16×22×4 베어링 외륜 지지면 — 확대 금지 (Ø18.6~19.4).
4. M2 여유 구멍은 XL330 프레임 탭과 동심.
5. 검사: 최소 테두리 3.00 (≥1.5t=3.00 권장),
최소 웹 2.70, 안쪽 모서리 문제 0곳.

Microduck 다이나믹셀 v1.0 (XL330, 원본 크기)
