lsk0522/microduck/cad/redesign/dynamixel/v1.0/parts/upper_leg_rigidity_plate/upper_leg_rigidity_plate.pdf

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

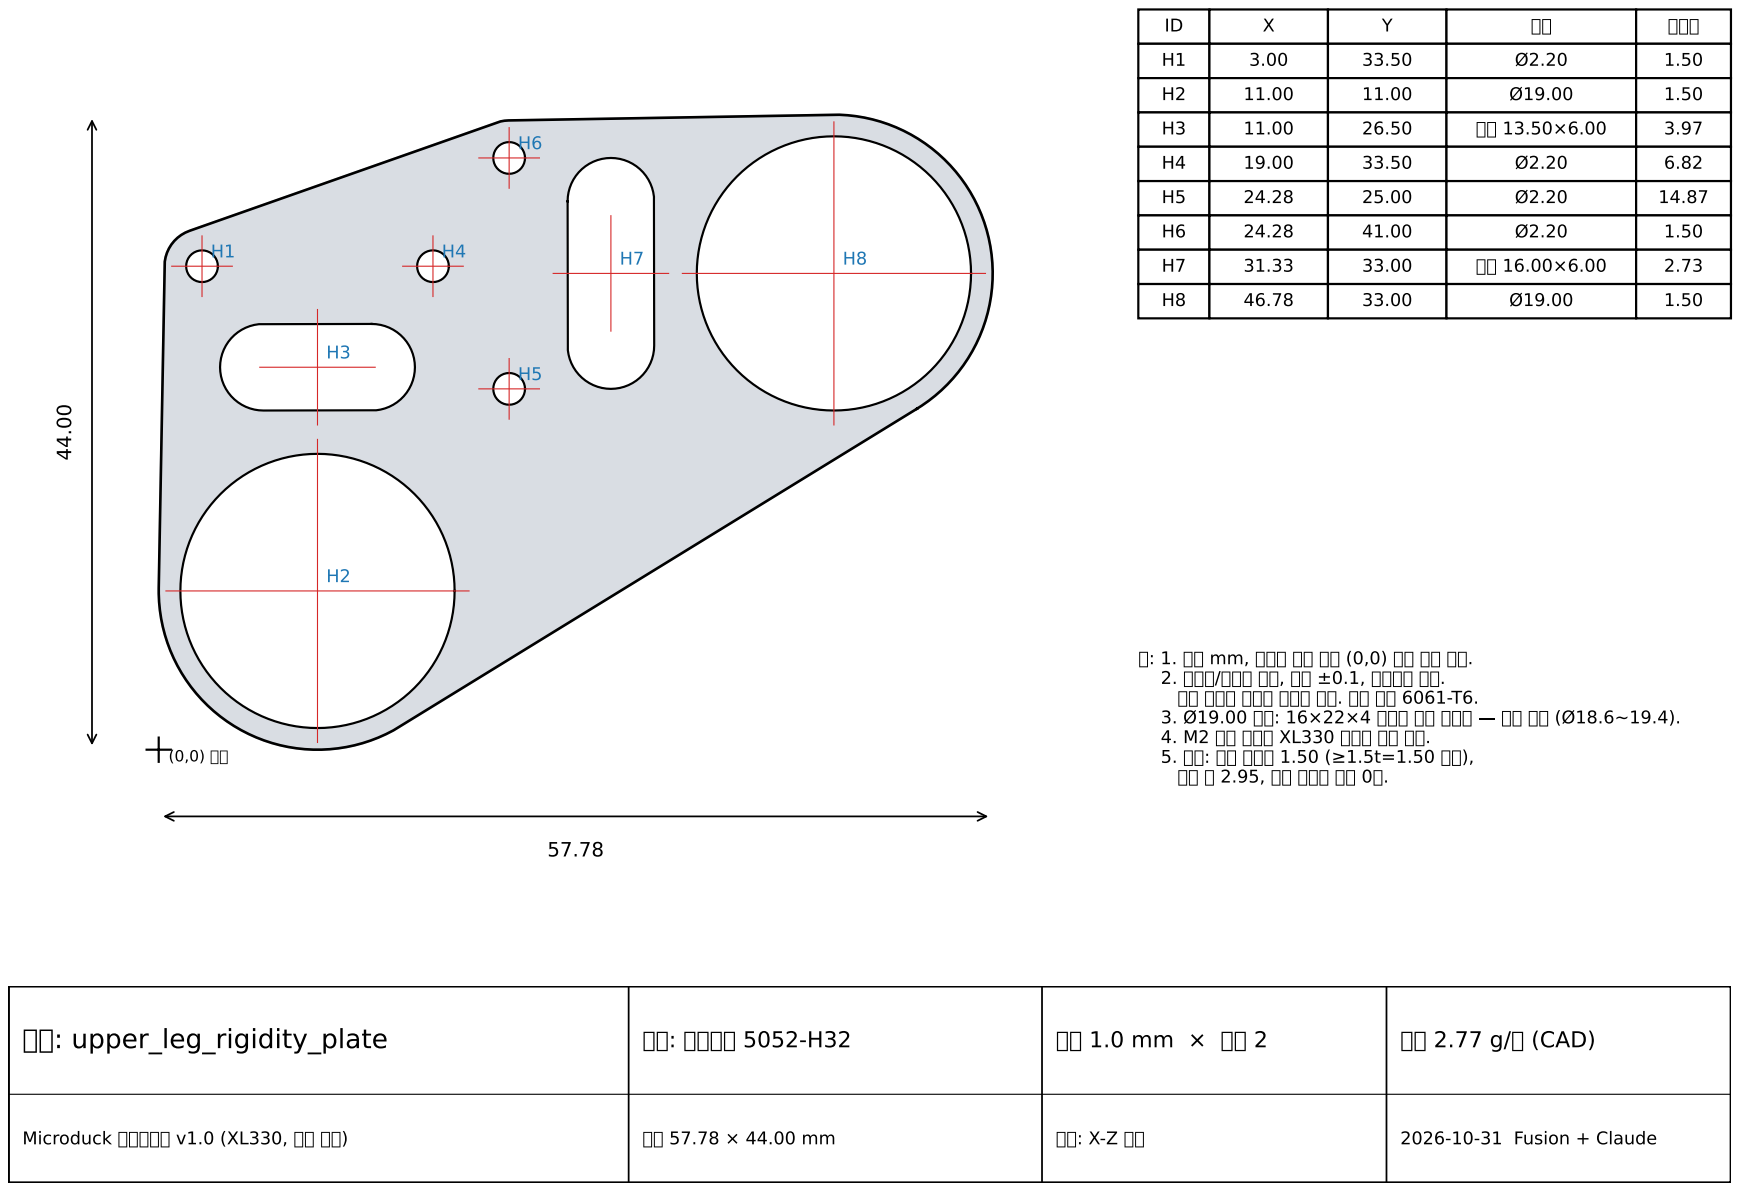
[picture p237: page 1]
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
