lsk0522/microduck/docs/assembly/tools/steps.py

"""조립 단계 정의 + 나사 → 단계 배정 (render_steps.py, build_guide.py 공용).

좌표계: 몸통 원점(trunk_base, 관절각 0), mm. 왼쪽 = +Y.
"""

from __future__ import annotations

# 화면 색 (렌더·PDF 공통)
COL = {
    "prev": (0.80, 0.80, 0.82, 1.0),       # 이전 단계에서 조립된 것
    "printed": (0.94, 0.42, 0.12, 1.0),    # 출력물(PETG) — 이번 단계 신규
    "tpu": (0.17, 0.70, 0.64, 1.0),        # TPU
    "servo": (0.16, 0.16, 0.17, 1.0),      # XL330
    "plate": (0.45, 0.62, 0.80, 1.0),      # 알루미늄 판재
    "bearing": (0.88, 0.70, 0.18, 1.0),    # 베어링
    "elec": (0.20, 0.50, 0.25, 1.0),       # PCB·배터리·스피커
    "glass": (0.55, 0.75, 0.95, 1.0),
}
KIND = {
    "xl330": "servo",
    "seeed_bearing__configuration__22x16x4": "bearing", "seeed_bearing__configuration_default": "bearing",
    "upper_leg_rigidity_plate": "plate", "trunk_base": "plate", "bearing_roll": "plate", "neck": "plate",
    "sole_left": "tpu", "sole_right": "tpu", "jaw_soft": "tpu", "soft_mouth_top": "tpu", "tire": "tpu",
    "np_f970": "elec", "pcb__raspberry_pi_zero_2_w": "elec", "elec_rpi_robot_hat_pcb": "elec", "speaker": "elec",
    "lens": "glass",
}

# 나사 종류별 색 (렌더 + PDF 칩)
SCREW_COL = {
    "M2x4": (0.10, 0.55, 0.95, 1.0),
    "M2x5": (0.00, 0.70, 0.75, 1.0),
    "M2x6": (0.95, 0.20, 0.45, 1.0),
    "M2x8": (0.55, 0.25, 0.85, 1.0),
    "M2.5x6": (0.20, 0.65, 0.20, 1.0),
}

LEFT = ["ankle_left", "leg", "upper_leg_left", "hip_l", "yaw2roll"]
RIGHT = ["ankle_right", "leg_2", "upper_leg_right", "hip_l_2", "bearing_roll"]
TRUNK = ["trunk_base"]
NECK = ["neck", "neck_pitch", "yaw_roll_motion"]
HEAD_BODY = "jaw_soft"

# 같은 (바디, 메시)에 여러 개가 있는 서보는 geom 번호로 구분 (cad/reference는 고정 — 바뀌면 다시 확인)
HEAD_ROLL_SERVO = (HEAD_BODY, "xl330", 86)   # 머리 롤 ID 33 (roll 축 옆)
MOUTH_SERVO = (HEAD_BODY, "xl330", 78)       # 부리 ID 34

# 각 단계: new = [(body, mesh|None=전부[, geom])], show = 화면에 보일 바디(이전 단계분 포함), cam = (azimuth, elevation)
# 나사 → 단계는 step_of(), 책상 위 서브조립에서 조이는 나사는 sub_of() (그때 있는 부품만 공구 경로 검사)
STEPS = [
    dict(id=1, key="foot", section="다리 ×2", title="발 (발목 브래킷 + 발판 + 밑창)",
         new=[("ankle_left", None)], show=["ankle_left"], cam=(140, -25), x2=True,
         parts=["ankle_left / ankle_right", "foot_left / foot_right", "sole_left / sole_right (TPU)", "베어링 10×15×3"],
         notes=["밑창(TPU)은 발판 아래에 붙인다 (원본 모델에 체결 구멍 없음 — 순간접착제 또는 양면테이프).",
                "베어링 10×15×3은 발목 브래킷의 베어링 자리에 압입한다. 헐거우면 순간접착제 한 방울."]),
    dict(id=2, key="shin", section="다리 ×2", title="정강이 + 발목 서보",
         new=[("leg", None)], show=["ankle_left", "leg"], cam=(150, -15), x2=True,
         parts=["leg ×1", "XL330 (발목 ID 24 / 14)"],
         cable="23→24 (13→14) 케이블을 발목 서보에 먼저 꽂는다. 무릎을 끝까지 굽히면 끝면 앞 굽힘 칸이 79 % 가려지니 무릎 축 쪽으로 고리를 남긴다.",
         notes=["발목 서보를 정강이(leg)에 끼우고 프레임 볼트로 고정한다.",
                "서보를 2048(0°)에 둔 상태에서 발이 정강이와 직각이 되게 혼에 발목 브래킷을 고정한다."]),
    dict(id=3, key="thigh", section="다리 ×2", title="허벅지 (고관절 피치 + 무릎 서보, 보강판)",
         new=[("upper_leg_left", None)], show=["ankle_left", "leg", "upper_leg_left"], cam=(120, -10), x2=True,
         parts=["upper_leg_left / upper_leg_right", "upper_leg_rigidity_plate (알루미늄 1 mm) ×1",
                "XL330 (고관절 피치 ID 22 / 12, 무릎 ID 23 / 13)", "베어링 16×22×4"],
         cable="서보를 넣기 전에 22·23(12·13)에 케이블을 꽂는다 — 넣은 뒤엔 무릎 서보가 22 커넥터 앞을 47 % 막는다.",
         notes=["⚠ 무릎 서보: homing_offset = −512 (−45°)를 먼저 써 둔다. 그 상태에서 2048로 보내면 혼이 45° 돌아간다 — "
                "정강이의 볼트 구멍은 이 각도에 맞춰져 있다 (검증: 정강이 구멍을 무릎 축으로 45° 돌리면 혼 구멍 4개와 정확히 겹침).",
                "무릎 혼 ↔ 정강이: M2×6 ×4, 정강이 안쪽 카운터보어(Ø4.4)에서 바깥쪽으로. 물림 3.2 mm.",
                "보강판은 허벅지 옆면(Y ≈ ±43 mm)에 대고 두 서보의 프레임에 고정한다. 큰 구멍 Ø19 두 개가 고관절 피치·무릎 축과 동심 (축간 42.0 mm)."]),
    dict(id=4, key="hip_roll_link", section="다리 ×2", title="고관절 링크 (hip_l)",
         new=[("hip_l", None)], show=["ankle_left", "leg", "upper_leg_left", "hip_l"], cam=(60, -15), x2=True,
         parts=["hip_l ×1", "베어링 16×22×4"],
         notes=["hip_l을 고관절 피치 서보 혼에 고정한다 (서보 2048, 다리가 일자로 아래를 향한 자세)."]),
    dict(id=5, key="trunk", section="몸통", title="몸통 바닥판 + 고관절 요 서보 ×2",
         new=[("trunk_base", m) for m in ["trunk_base", "xl330", "seeed_bearing__configuration__22x16x4"]],
         show=TRUNK, cam=(210, -30),
         parts=["trunk_base 바닥판 (알루미늄 1 mm)", "XL330 ×2 (고관절 요 ID 20 / 10)", "베어링 16×22×4 ×2"],
         cable="고관절 요 서보(20 / 10)에 허브→20·20→21을 지금 꽂아 둔다 — 8단계에 배터리가 들어오면 커넥터 앞 굽힘 칸이 61 % 가려진다.",
         notes=["바닥판 큰 구멍 2개(Ø19)가 좌·우 고관절 요 축이다. 서보 출력축이 구멍 아래로 오게 놓는다.",
                "이 단계에선 서보당 프레임 볼트 1개만 들어간다. 나머지는 8단계(전원부) 볼트가 함께 잡는다 — "
                "6·7단계에서 혼을 조일 때 서보를 손으로 받친다.",
                "⚠ 전원부(power_support·배터리)는 아직 달지 않는다 — 7단계 롤 서보 볼트의 공구 경로를 막는다 (검증 T5)."]),
    dict(id=6, key="yaw2roll_mount", section="몸통", title="요-롤 블록을 고관절 요 혼에 고정 (빈 상태로)",
         new=[("yaw2roll", "yaw2roll"), ("bearing_roll", "yaw2roll")], show=TRUNK + ["yaw2roll", "bearing_roll"],
         cam=(200, 50),
         parts=["yaw2roll ×2 (좌·우 같은 부품)"],
         notes=["⚠ 순서 주의: 이 나사는 yaw2roll 바닥에서 위로(+Z) 들어간다. 롤 서보를 먼저 넣으면 공구가 닿지 않으므로 "
                "yaw2roll은 빈 상태로 먼저 고정한다 (검증 T5로 확인).",
                "양쪽 고관절 요 서보를 2048에 두고, yaw2roll의 롤 축이 정면(+X)을 향하게 맞춘다.",
                "오른쪽 블록은 원본 모델에서 바디 이름이 bearing_roll — 부품은 yaw2roll과 같다."]),
    dict(id=7, key="hip_roll", section="몸통", title="고관절 롤 서보 + 롤 베어링판 → 다리 연결",
         new=[("yaw2roll", m) for m in ["xl330", "bearing_roll", "seeed_bearing__configuration__22x16x4"]]
             + [("bearing_roll", m) for m in ["xl330", "bearing_roll", "seeed_bearing__configuration__22x16x4"]],
         show=TRUNK + LEFT + RIGHT, cam=(150, -12),
         parts=["XL330 ×2 (고관절 롤 ID 21 / 11)", "bearing_roll 판 (알루미늄 1 mm) ×2", "베어링 16×22×4 ×2",
                "1–4단계에서 만든 다리 ×2"],
         cable="20→21·21→22를 롤 서보에 잇는다. 롤을 끝까지 돌리면 21→22 경로가 0°보다 38 mm 길어진다 — 그만큼 고리를 남긴다.",
         notes=["롤 서보를 yaw2roll에 넣고 프레임 볼트로 고정한다. 몸통 뒤쪽 볼트는 전원부가 없는 지금만 공구가 들어간다.",
                "롤 베어링판을 몸통 앞쪽 면(X+)에 대고 판당 M2×6 ×2(서보) + M2×4 ×2(yaw2roll)로 고정한다. "
                "M2×4 자리는 Ø2.05 출력 파일럿 구멍 — 바닥까지 여유가 적으니 길이를 지킨다.",
                "롤 서보를 2048에 두고, 다리가 수직으로 내려오게 서보 혼을 hip_l에 고정한다."]),
    dict(id=8, key="power", section="몸통", title="전원부 (power_support + 배터리 + 바나나 잭 홀더)",
         new=[("trunk_base", m) for m in ["power_support", "np_f970", "banana_pcb_locker"]],
         show=TRUNK + ["yaw2roll", "bearing_roll"], cam=(25, -25),
         parts=["power_support", "배터리 NP-F550 (+배터리 플레이트)", "banana_pcb_locker"],
         cable="허브를 전원부 위(X −24, Z +15 mm)에 두고 XT30·왼다리·오른다리·IMU 브리지를 꽂은 뒤 배터리를 넣는다. 목 줄(250 mm)은 9–10단계.",
         notes=["power_support의 볼트 일부는 바닥판과 고관절 요 서보를 함께 관통한다 (M2×8) — 5단계 서보 고정을 마무리한다.",
                "IMU 브리지(버스 ID 200)는 몸통에 단다: 모델의 imu 위치 = trunk_base 기준 X −21, Y 0, Z −15 mm, "
                "칩 축을 몸통 축과 맞춘다. 고정 구멍은 모델에 없음 — 실물 확인 (양면테이프로 흔들림 없게)."]),
    dict(id=9, key="neck", section="목·머리", title="목 (목 피치 + 머리 피치 서보, 목 옆판)",
         new=[("neck", None)], show=["neck"], cam=(120, 5),
         parts=["neck 옆판 (알루미늄 2 mm) ×2", "XL330 ×2 (목 피치 ID 30, 머리 피치 ID 31)"],
         cable="옆판을 닫기 전에 31→30과 30→허브(250 mm)를 꽂는다 — 두 서보 끝면이 1 mm로 마주봐, 닫은 뒤엔 플러그 칸이 82 % 막힌다.",
         notes=["두 서보를 옆판 2장 사이에 끼우고 양쪽에서 프레임 볼트로 고정한다 (판당 M2×6 ×4, 관통 볼트 아님)."]),
    dict(id=10, key="shells", section="목·머리", title="몸통 셸 + 목 장착",
         new=[("trunk_base", "left_shell"), ("trunk_base", "right_shell")], show=TRUNK + ["neck"], cam=(230, -10),
         parts=["left_shell", "right_shell"],
         cable="목을 달면서 30→허브(250 mm)를 셸 안쪽으로 내려 허브에 꽂는다. 목을 끝까지 숙여(경로 156 mm) 당기지 않는지 확인.",
         notes=["목 피치 서보의 혼과 뒤쪽 보스를 좌·우 셸에 고정한다 (목 피치 서보 2048).",
                "혼 쪽 M2×6은 물림이 2.55 mm로 기준(2.5 mm)에 겨우 맞는다 — 끝까지 조이고, 헐거우면 실물 혼 구멍 깊이를 재서 "
                "M2×8(모델 깊이 기준 바닥 여유 0.65 mm)을 검토.",
                "좌·우 셸끼리 맞물리는 자리는 모델에서 나사인지 핀인지 확인되지 않았다 — 실물 확인."]),
    dict(id=11, key="head_sub", section="목·머리", title="머리 요·롤 블록 서브조립 (책상 위에서)",
         new=[("yaw_roll_motion", None), HEAD_ROLL_SERVO, ("neck_pitch", None)],
         show=[], cam=(140, 10),
         parts=["yaw_roll_motion ×1", "XL330 (머리 요 ID 32, 머리 롤 ID 33)", "neck_pitch ×1", "베어링 16×22×4 ×3"],
         cable="서브조립 때 33→32를 꽂는다. 32→31은 12단계에서 머리 피치 서보(31)로 잇는다.",
         notes=["⚠ 순서 (검증 T5 — 바꾸면 공구가 막힘): ① 롤 서보(33) 혼 → yaw_roll_motion M2×8 ×4, 요 서보 넣기 전 "
                "(4개 중 3개는 맞은편 벽까지 24.5 mm — 짧은 비트·ㄱ자 드라이버) ② 요 서보(32)를 yaw_roll_motion에 넣고 프레임 볼트, 베어링 압입 "
                "③ 요 혼 → neck_pitch M2×6 ×4, 목에 달기 전 책상 위에서."]),
    dict(id=12, key="head_mount", section="목·머리", title="머리 블록을 머리 피치 혼에 장착",
         new=[], focus=[("neck_pitch", None), ("yaw_roll_motion", None), HEAD_ROLL_SERVO],
         show=["neck", "neck_pitch", "yaw_roll_motion", HEAD_BODY], cam=(140, 10),
         parts=["11단계 서브조립"],
         cable="32→31을 머리 피치 서보(31)에 잇는다. 머리 요(32)를 양쪽 끝까지 돌려 케이블이 당기거나 끼지 않는지 확인.",
         notes=["머리 피치 서보(ID 31)를 2048에 두고 neck_pitch를 혼에 고정한다."]),
    dict(id=13, key="head_frame", section="목·머리", title="머리 프레임 (부리 서보, 모터 지지대, 아래 셸)",
         new=[(HEAD_BODY, m) for m in ["motor_support", "bottom_head_shell"]] + [MOUTH_SERVO],
         show=NECK[1:] + [HEAD_BODY], cam=(125, -40),
         parts=["motor_support", "bottom_head_shell", "XL330 (부리 ID 34)"],
         cable="34→33을 부리 서보(34)에 꽂아 둔다.",
         notes=["motor_support를 아래 셸에 M2.5×6 ×4로 고정하고 부리 서보를 넣는다.",
                "motor_support ↔ 서보 체결은 모델에서 확인되지 않았다 — 실물 확인 (예상: 프레임 볼트 M2×6)."]),
    dict(id=14, key="face", section="목·머리", title="얼굴 + 전자부 (보드, 카메라, 눈, 스피커)",
         new=[(HEAD_BODY, m) for m in ["face_part", "pcb__raspberry_pi_zero_2_w", "elec_rpi_robot_hat_pcb",
                                         "lens", "m12_lens_holder", "noenoeil", "speaker",
                                         "seeed_bearing__configuration_default"]],
         show=[HEAD_BODY], cam=(200, -20),
         parts=["face_part", "Radxa Zero 3W (모델은 Pi Zero 2W 자리표시자)", "HAT PCB", "IMX219 + M12 렌즈·홀더",
                "noenoeil (눈 링)", "스피커 35×25", "베어링 10×15×3"],
         cable="HAT→34를 HAT에 먼저 꽂고, 얼굴 판을 단 뒤 부리 서보(34)에 잇는다.",
         notes=["⚠ 보드는 얼굴 판을 머리에 달기 전에, 책상 위에서 얼굴 판 뒤에 M2.5×6 ×4로 고정한다 "
                "(머리에 단 뒤엔 서보·지지대가 공구를 막음 — 검증 T5). 보드 구멍 Ø2.7 = M2.5 규격.",
                "HAT·카메라 홀더·스피커 체결은 모델에서 확인되지 않았다 — 실물 확인."]),
    dict(id=15, key="top_shell", section="목·머리", title="머리 윗셸",
         new=[(HEAD_BODY, "top_head_shell")], show=[HEAD_BODY], cam=(150, -25),
         parts=["top_head_shell"],
         notes=["⚠ 부리(16단계)보다 먼저: 윗셸 ↔ 아래 셸 M2.5×6 자리는 부리 부품이 달리면 공구가 3 mm 앞에서 막힌다 (검증 T5).",
                "남은 한 자리(3번째)는 바깥쪽에서 들어가 부리와 상관없다."]),
    dict(id=16, key="beak", section="목·머리", title="부리",
         new=[(HEAD_BODY, m) for m in ["jaw", "jaw_soft", "soft_mouth_top"]],
         show=[HEAD_BODY], cam=(205, 12),
         parts=["jaw", "jaw_soft (TPU)", "soft_mouth_top (TPU)"],
         notes=["부리 서보를 2048에 두고 부리가 닫힌 상태로 jaw를 혼에 고정한다.",
                "TPU 부리 덮개는 끼움/접착 (모델에 체결 구멍 없음)."]),
]


def resolve(entries, geoms) -> set:
    """단계 항목 [(body, mesh|None[, geom])] → geom 번호 집합. geoms = [(g, body, mesh)]."""
    out = set()
    for e in entries:
        b, ms, gid = e[0], e[1], (e[2] if len(e) > 2 else None)
        for g, gb, gm in geoms:
            if gb == b and (ms is None or gm == ms) and (gid is None or g == gid):
                out.add(g)
    return out


def step_of(s: dict) -> int | None:
    """나사 하나(find_screws 결과)를 조립 단계 번호로."""
    P = set(s["parts"]); sv = set(s["servo"])
    j = lambda *names: any(any(x.endswith(n) for x in sv) for n in names)
    if P & {"foot_left", "foot_right"}: return 1
    if j("ankle"): return 2
    if "upper_leg_rigidity_plate" in P or j("knee"): return 3
    if j("hip_pitch"): return 4
    if j("hip_roll") or P == {"bearing_roll", "yaw2roll"}: return 7
    if j("hip_yaw"):
        if "yaw2roll" in P: return 6
        if P & {"left_shell", "right_shell"}: return 10
        if "power_support" in P: return 8
        return 5
    if "banana_pcb_locker" in P: return 8
    if "neck" in P: return 9
    if P & {"left_shell", "right_shell"}: return 10
    if j("head_roll", "head_yaw"): return 11
    if j("head_pitch"): return 12
    if P == {"bottom_head_shell", "motor_support"}: return 13
    if "pcb__raspberry_pi_zero_2_w" in P: return 14
    if P == {"bottom_head_shell", "top_head_shell"}: return 15
    if j("mouth"): return 16
    return None


def sub_of(s: dict):
    """책상 위 서브조립에서 조이는 나사 → 그때 있는 부품 [(body, mesh[, geom])]. 로봇 위에서 조이면 None."""
    P = set(s["parts"]); sv = set(s["servo"])
    j = lambda *names: any(any(x.endswith(n) for x in sv) for n in names)
    if j("head_roll"):                                   # ① 롤 혼 → yaw_roll_motion (요 서보 넣기 전)
        return [("yaw_roll_motion", "yaw_roll_motion"), HEAD_ROLL_SERVO]
    if j("head_yaw") and "neck_pitch" not in P:          # ② 요 서보 → yaw_roll_motion 프레임
        return [("yaw_roll_motion", None), HEAD_ROLL_SERVO]
    if j("head_yaw"):                                    # ③ 요 혼 → neck_pitch (목에 달기 전)
        return [("yaw_roll_motion", None), HEAD_ROLL_SERVO, ("neck_pitch", None)]
    if "pcb__raspberry_pi_zero_2_w" in P:                # 보드 → 얼굴 판 (머리에 달기 전)
        return [(HEAD_BODY, "face_part"), (HEAD_BODY, "pcb__raspberry_pi_zero_2_w")]
    return None


def knee_screws() -> list[dict]:
    """무릎 혼 ↔ 정강이: 혼이 45° 돌아간 상태라 동축 판별로 안 잡혀서 수동 추가.

    leg 구멍 실측(holes.json → 월드): 머리 자리 Ø4.4 바닥 |y|=37.65, 통과 Ø2.2 |y|=37.65–40.45 (조임 2.8 mm),
    혼 탭 Ø1.6 |y|=40.45–46.45 (깊이 6 mm). 무릎 혼 구멍은 반지름 6 mm 십자, leg 구멍은 45° 돌아간 정사각.
    → 무릎 호밍 오프셋 −512(=−45°)과 같은 각도. 실제 조립에선 혼을 45° 돌려 맞춘다.
    M2×6 → 물림 3.2 mm, 바닥까지 2.8 mm 여유. verify_screws.py는 무릎을 45° 돌린 자세에서 검사한다.
    """
    out = []
    for side in (1, -1):
        for x in (-36.02, -27.53):
            for z in (-35.26, -43.74):
                out.append(dict(size="M2", len=6, Lmin=5.3, Lmax=8.4, need=6.8, clamp=2.8, head="SHCS",
                                term="XL330 horn", parts=["leg", "xl330"], servo=["left_knee" if side > 0 else "right_knee"],
                                head_pt=[x, side * 37.65, z], dir=[0, side, 0], manual=True))
    return out
