lsk0522/microduck/(commit log)

2026-10-29 Microduck 클론 프로젝트 초기 구성: 계획, BOM, CAD 레퍼런스, 시뮬레이션 도구
    - plan.md: 결정 사항(D1–D4), 단계별 구현, 재설계 가이드, 시뮬레이션·학습 계획
    - bom/: BOM 데이터 스크립트, BOM.csv, BOM.xlsx(환율·합계 수식, 부품 치수 시트)
    - cad/reference/: Pollen microduck_rl(bae39f5) MJCF·STL·Onshape 메타데이터 원본, 부품 치수표
    - sim/: 모델 점검(질량·관절·자세 유지 토크), 렌더 스크립트
    - docs/hardware-notes.md, firmware/imu_to_dxl 사양, training/, hardware/hat/
    Claude-Session: https://claude.ai/code/session_01QbojE3pmnUnzkmqMbxFAGz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
    [BOM.csv, BOM.xlsx, ankle_l_v1.stl, ankle_left.stl, ankle_r_v1.stl, ankle_right.stl, arm.stl, axis.stl]
2026-10-29 BOM: 부품별 최저가 구매처·링크·원화 단가 추가
    - 정가 기준(쿠폰 제외) 최저가 판매처로 갱신, 확인/추정 구분
    - XL330-M288-T 로보티즈 공식몰 26,400원(해외 대비 저렴), U2D2 → CP2102 대용
    - 원화 단가 열, USD 항목 환율 환산 수식, 예비 기본 제외
    - Radxa Zero 3W 전 판매처 품절 경고와 대안 표기
    - plan.md 예산 갱신
    Claude-Session: https://claude.ai/code/session_01QbojE3pmnUnzkmqMbxFAGz
    [BOM.csv, BOM.xlsx]
2026-10-29 BOM: 오리지널 / 저렴한 버전 두 구성으로 분리
    - BOM.xlsx: 비교 시트(분류별 합계·차이·구성 차이표) + 오리지널 + 저렴한 버전 시트
    - 오리지널(약 86만원): 15축+예비, ToF·카메라·오디오, U2D2, 게임패드
    - 저렴한 버전(약 55만원): 14축(부리 고정), 몸통 IMU만, CP2102, 예비 없음
    - BOM.csv에 버전별 수량 열, plan.md에 두 구성 비교와 저렴한 버전 추가 작업(3.6.1)
    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
    [BOM.csv, BOM.xlsx]
2026-10-29 일반 서보(MG996R+MG90S) 트랙 추가
    - plan-hobby-servo.md: MG90S 토크 부족 분석, 1.5배 확대 설계, 관절별 서보 배치,
    Pi Zero 2W + PCA9685 + ADS1115 위치 피드백 개조, 전원, 일반 서보 액추에이터 모델,
    시스템 식별, 학습·런타임 계획, 위험 요소
    - BOM: 일반 서보 버전 시트(약 26–28만원), 비교 시트 3열, BOM_hobby_servo.csv
    - sim/check_model.py: --servo 프리셋(xl330, mg90s, sg90, mg996r)
    - plan.md·README: 트랙 A(다이나믹셀)/B(일반 서보) 개요
    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
    [BOM.xlsx, BOM_hobby_servo.csv]
2026-10-29 일반 서보 트랙: 기존 공개 설계 조사 결과와 기구 설계 출발점 추가
    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
2026-10-29 Fusion+Claude 재설계 가이드, 판재 DXF, 관절 프레임 추가
    - cad/FUSION_REDESIGN.md: Fusion MCP 연결, 작업 규칙, 매개변수 스켈레톤,
    부품 설계 순서·공차, 조인트·간섭 검사, 판재(트랙 A/B), MJCF 내보내기, 프롬프트 예
    - cad/plates/dynamixel: 평판 4종(보강판·몸통판·롤 베어링판·목판) DXF·PNG·목록
    - cad/tools/plates_to_dxf.py, extract_joint_frames.py (축 사이 최단거리 링크 길이)
    - cad/reference/joint_frames.*, fusion_params.csv, cad/hobby_servo/reference_1.5x/
    - cad/fusion/params: 1배·1.5배 매개변수
    Claude-Session: https://claude.ai/code/session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
    [bearing_roll.dxf, fusion_params.csv, fusion_params_1.5x.csv, fusion_params_1x.csv, joint_frames.csv, neck.dxf, plates.csv, trunk_base.dxf]
2026-10-29 문서 총정리: README 허브화, 문서 간 불일치 수정
    - README: 3개 버전 비교, 문서 지도, 현재 상태·결정(D1–D4), 다음 할 일, 폴더 구조
    - plan.md: D4=Fusion+Claude 확정, Onshape 전제 절차를 FUSION_REDESIGN 요약으로 교체,
    판재 4종 반영, 저장소 구조는 README로 이동, 경로 통일
    - plan-hobby-servo.md: 설계 순서를 Fusion 기준·1.5배 치수로 정리
    - parts.csv: 판재 4종 두께(1 mm/2 mm) 정정
    - BOM: 카본 보강판 → 판재 4종 레이저 가공(오리지널) / FR4 대체(저렴), 합계 갱신
    - cad/hobby_servo, cad/redesign, cad/reference README 정리
    Cla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
    [BOM.csv, BOM.xlsx, parts.csv]
2026-10-29 Windows 실행 환경: 바탕화면 설치 .bat, START_HERE 메뉴, 기능별 .bat
    - install_microduck_to_desktop.bat: Desktop\Microduck에 git clone (Git 없으면 winget → ZIP),
    바로가기 생성, 환경 설치
    - START_HERE.bat: 메인 메뉴 (0 setup ~ 10 train, 문서·GitHub·폴더 열기)
    - bat/: 00 setup(uv+.venv), 01 뷰어, 02 토크 점검(서보·전압·자세 선택), 03 BOM, 04 판재 DXF,
    05 관절 프레임, 06 렌더, 07 업데이트, 08 참고 저장소, 09 정책 시뮬(실험적), 10 학습
    - pyproject.toml + uv.lock (Windows 휠 포함), .python-version 3.12, scipy 누락 수정
    - BOM.xlsx: Excel에서 열 때 전체 재계산
    - .gitattributes: .bat CRLF 유지,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
    [BOM.xlsx]
2026-10-29 [plan] 판재 4종 설계 브리프 추가
    - cad/plates/DESIGN_BRIEF.md: 판별 위치·방향, Ø19 구멍과 관절 축 동심 확인(허벅지 42.0, 몸통 35.0),
    구멍 좌표, 레이저 가공 조건, 테두리 부족(neck 0.84, bearing_roll 0.89 mm), 확인 항목, 산출물 규칙
    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
2026-10-30 [plan] 조립 가이드 PDF (트랙 A) 추가 — VORON 2.4 매뉴얼 형식
    - docs/assembly/Microduck_Assembly_Guide.pdf (A4 가로 21쪽): 표지, 읽는 법, 1:1 하드웨어 레퍼런스,
    BOM(나사 126개 계산값·조달), 출력물 썸네일, 서보 설정, 조립 13단계 렌더, 배선·첫 전원, 확인 필요 목록
    - 나사 규격·수량은 원본 메시 구멍(지름·깊이·동축)에서 계산 (find_holes.py, find_screws.py)
    - 너트·인서트 없음, M2는 M2×4 4개 외 전부 XL330 동봉 탭볼트로 가능, 별도 M2.5×6 11개
    - 무릎 혼 45° 오프셋 반영(수동 8개), 고관절 요 나사 접근성 때문에 yaw2roll 선고정 순서
    - render_steps.py /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
2026-10-30 [plan] 조립 가이드 기하 검증 + 조립 순서 수정 (13 → 16단계)
    - tools/verify_screws.py: 가상 나사를 메시에 넣어 통과·물림·바닥·머리·공구 경로 검사 (126개)
    - 무릎 나사 머리 위치 실측값으로 수정, 45° 자세에서 혼 구멍 일치 확인
    - 공구 경로 막힘 수정: 전원부 8단계로, 머리 요·롤 서브조립, 보드 먼저, 윗셸→부리 분리
    - 배선도 IMU 브리지(ID 200)를 몸통으로, 13단계 M2.5 문구 수정
    - 렌더·검증을 geom 단위로 (머리 롤/부리 서보 구분)
    - VERIFICATION.md, PDF 부록에 검증 요약, bat 11에 검증 선택
    Clau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
    [build_guide.py, find_screws.py, render_steps.py, steps.py, verify_screws.py]
2026-10-30 [plan] 서보 원점·장착 방향, 배선도, 부품 배치도, 제어·시뮬레이션 방법 추가
    - tools/servo_zero.py: 관절마다 혼 방향·+ 방향·가동 범위·기본 자세 (혼 방향 규칙이 형상 확인 가능한 12개 관절과 일치)
    - tools/layout.py: 원점·기본 자세·부품 배치·배선 경로 그림, 부품 위치·케이블 길이
    - tools/dxl_zero.py: 실물 서보 setup/zero/read/home/off (dynamixel-sdk, 미검증)
    - PDF 24 → 32쪽 (원점 3쪽, 배치·배선·경로·첫 전원 4쪽, 제어·시뮬레이션 2쪽), OPERATION.md
    - 배선 권장안: 몸통 버스 허브 + IMU 브리지, HAT는 목 버스에서 5 V 강압 (plan.md 3.9, hat README 정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
    [BOM.csv, BOM.xlsx, servo_zero.json]
2026-10-30 [plan] 혼 원점 마크 기준 추가 — 관절별 마크 방향 표
    - 혼을 마주 본 케이스 기준 A(축 쪽 끝)·B·C(커넥터 쪽)·D를 정의하고, 원점 자세에서 각 방향이 로봇의 어디인지 계산 (layout.py)
    - 2048 마크 방향은 서보 1개 실측으로 정함 (ROBOTIS 문서에 글로 된 근거 없음), 무릎은 반시계 45° 추가
    - PDF 33쪽(8쪽 혼 마크 기준), OPERATION.md 1절, 장착 절차에 마크 확인 단계
    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
2026-10-30 [plan] 조립 단계마다 다이나믹셀 원점·혼 방향 표시
    - render_steps.py: 단계 그림에 서보 ID·2048(무릎 −512)·혼 방향 화살표·'혼 고정' 표시 → data/step_servos.json
    - 각 단계 쪽에 '다이나믹셀 — 2048에 두고 체결' 상자: 서보 장착/혼 고정, 혼 방향, + 방향, 마크 방향(A–D, 좌우 따로)
    - 단계 쪽 레이아웃 정리(왼쪽 칸 100 mm), 11단계 주의사항 압축
    - OPERATION.md 단계별 다이나믹셀 표, 생성 순서(servo_zero → layout → render_steps) 정리
    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
    [step_servos.json]
2026-10-30 [plan] XL330 원점 홈(케이스 홈 + 혼 홈) 표시
    - 케이스 축 쪽 끝면 가운데 세로 홈과 혼 테두리 홈이 한 줄 = 기계적 원점 (2048로 가정, 실물 확인 필요)
    - PDF 8쪽 '원점 홈 맞추기': 일반/무릎(반시계 45°) 그림, 관절마다 케이스 홈·혼 홈이 로봇의 어느 쪽인지 표
    - 원점 그림·조립 단계 그림에 노랑 네모(케이스 홈)·노랑 점(혼 홈), 단계 상자에 원점 홈 줄
    - OPERATION.md 원점 홈 절·단계 표 갱신 (A–D 실측 방식 대체)
    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
2026-10-30 [plan] 원점 홈 그림 이름표 정리 — 일반/무릎 구분
    - 두 그림에 같던 '케이스 홈 (A)'·'커넥터 쪽 (C)' 이름표를 고침: 일반 = '케이스 홈 = 혼 홈', 무릎 = '케이스 홈 (그대로)' + 돌아간 '혼 홈' 따로 표시
    - A/C 글자(이전 실측 방식의 흔적) 제거, 공통 설명은 그림 아래 한 번만
    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
2026-10-30 [plan] 원점 맞추기를 A·B·C 그림으로 단순화
    - 8쪽: 큰 그림 3개 — A 홈 한 줄(13개), B 혼 홈만 왼쪽 45°(무릎 13·23), C 틀림(다시 zero)
    - 관절별 표는 '원점 글자 + 위 홈이 보는 쪽' 두 칸만
    - 조립 단계 그림 이름표 '22 · 원점 A', 단계 상자 '원점 A, 위 홈 → 앞'
    - OPERATION.md 같은 방식으로 정리
    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
2026-10-30 [design] íì¬ 4ì¢
    íë¼ë©í¸ë¦­ + ë¤ì´ëë¯¹ì
     v1.0 ì´ì
    ë¸ë¦¬ ì§í (ì¤í¬ë¦½í¸, ë¶ì, ì§í ê¸°ë¡)
    [upper_leg_rigidity_plate.dxf, upper_leg_rigidity_plate.step]
2026-10-30 [design] v1.0 다이나믹셀: 출력 부품 단면 추적 재모델링 15종 (부품 문서, STEP·STL, 원본 비교 통과)
    Claude-Session: https://claude.ai/code/session_01QbojE4FFgsiDig29qW2GQW
    [ankle_left.step, ankle_left.stl, ankle_right.step, ankle_right.stl, banana_pcb_locker.step, banana_pcb_locker.stl, face_part.step, face_part.stl]
2026-10-30 [design] v1.0 다이나믹셀: 출력 부품 26종 전부 단면 추적 재모델링 완료 (원본 비교 26/26 통과)
    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
    [bottom_head_shell.step, bottom_head_shell.stl, jaw.step, jaw.stl, left_shell.step, left_shell.stl, motor_support.step, motor_support.stl]
2026-10-30 [design] v1.0 다이나믹셀 완료: 판재 3종 DXF·PDF, 구매품, BOM, MJCF, 검증 (새 간섭 0)
    - 구매품 8종 STEP·STL, 판재 bearing_roll·neck·trunk_base 출력, 측면 보스 보강
    - BOM_dynamixel_v1.0.csv/.xlsx, mjcf/ (새 메시), verify/ (관절 14/14, 간섭 새 0, check_model)
    - README·PROGRESS·CHANGELOG·PLATES, design-log 갱신
    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
    [BOM_dynamixel_v1.0.csv, BOM_dynamixel_v1.0.xlsx, additional.xml, allcollisions_contacts.xml, ankle_l_v1.stl, ankle_left.stl, ankle_r_v1.stl, ankle_right.stl]
2026-10-31 [design] 일반 서보 v1.0 완료: MG996R x12 + MG90S x2, 1.5배 어셈블리·BOM·MJCF·검증
    - head_pitch MG90S -> MG996R (STAND 유지 토크 34% -> 8%)
    - Fusion 관절 14개 선 기하로 다시 만듦 (점+사용자 축은 Z축으로 돌던 버그), 검증 14/14
    - 실제 메시 간섭 검사(셸 포함) 새 간섭 0, check_model STAND 유지
    - 레이아웃·셸·MJCF·BOM 스크립트에 MD_VARIANT (mg996r 판 준비)
    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
    [623ZZ.step, 623ZZ.stl, 6704ZZ.step, 6704ZZ.stl, 6706ZZ.step, 6706ZZ.stl, BOM_hobby_servo_v1.0.csv, BOM_hobby_servo_v1.0.xlsx]
2026-10-31 [design] MG996R v1.0 완료: 14축 전부 MG996R, 1.5배 어셈블리·BOM·MJCF·검증
    - hobby_layout 등에 MD_VARIANT=mg996r: 머리 yaw/roll MG996R, 머리 yaw 6706ZZ, 머리 셸 나사 3곳
    - 배치 간섭 0, 메시 간섭 새 간섭 0, 관절 14/14, STAND 유지 (무릎 26%)
    - hobby_joints_check.py (Fusion +20도 실측 vs MJCF), BOM 스크립트 판별 출력
    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
    [623ZZ.step, 623ZZ.stl, 6706ZZ.step, 6706ZZ.stl, BOM_hobby_servo_v1.0.csv, BOM_hobby_servo_v1.0.xlsx, BOM_mg996r_v1.0.csv, BOM_mg996r_v1.0.xlsx]
2026-10-31 [design] 다이나믹셀 v1.0: 오른쪽 다리 부품 배치 수정, 무릎 여유 홈 제거(원작대로)
    - leg/yaw2roll/hip_l 오른쪽 배치가 원작과 19-75 mm 어긋나 있던 것 수정 (Fusion 어셈블리)
    - upper_leg_rigidity_plate 무릎 접힘 여유 홈 제거, DXF/PDF/STEP 다시 냄
    - 방침: 다이나믹셀만 작업, 원작과 똑같이, 추가는 제안 후 / 출력 부품 피처 재모델링 계획
    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
    [upper_leg_rigidity_plate.dxf, upper_leg_rigidity_plate.step]
2026-10-31 [design] 다이나믹셀 v1.0: neck_pitch 피처 재모델링 (2942면 -> 42면, 원작 대비 p95 0.046 mm)
    - feat_lib.py / feat_neck_pitch.py: 스케치-돌출-회전 자르기-챔퍼
    - tools/feat/check_csg.py, neck_pitch_csg.py: 같은 형상을 먼저 만들어 원작 STL과 비교
    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
    [neck_pitch.step, neck_pitch.stl, neck_pitch_new.stl]
2026-11-01 [design] 피처 재모델링 도구: 단면 선·호 맞춤, 단 분해, 원작 보기 (motor_support 진행 중)
    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
2026-11-01 [design] 다이나믹셀 v1.0: top_head_shell 피처 재모델링 (층 없음, 21248면 -> 104면, p95 0.12 mm)
    - shell_sections.py: 셸 단면 바깥/안쪽 곡선 (법선으로 가름, 리브 구간 제외)
    - feat_shell_loft.py run_loft_region, feat_top_head_shell.py: 바깥-안쪽 로프트, 뒤 평면/옆 구멍 자르기, 보스 3, 리브 3
    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
    [ths_loft_test.stl, top_head_shell.step, top_head_shell.stl]
2026-11-01 [design] 재질: 알루미늄은 판재(가공품)만, 새로 그린 출력 부품 ABS 지정 (set_plastic)
    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
2026-11-01 [design] left/right_shell 피처 재모델링 (층 없는 솔리드) + 부품 문서 저장 문제 수정
    - left_shell: x 단면 로프트 + 기울어진 옆면 자르기·R8.2/R6 모깎기 + 아래 R6.2 원호, 안쪽 로프트 자르개,
    보스·고리 구멍 피처, 팔·다리 끝 패치 로프트, 나머지 잔여 돌출 → 원작 대비 p50 0.013 / p95 0.34 mm
    - right_shell: left 거울 + 오른쪽 고리 구멍 치수 + 끝 탭 → p50 0.015 / p95 0.37 mm
    - 어셈블리로 열린 부품 문서는 읽기 전용이라 neck_pitch·top_head_shell 재모델링이 클라우드에 저장 안 돼 있던 것 발견,
    부품 문서를 따로 열어 다시 만들고 저장 (run_install.py, r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
    [left_shell.step, left_shell.stl, neck_pitch.step, neck_pitch.stl, right_shell.step, right_shell.stl, top_head_shell.step, top_head_shell.stl]
2026-11-02 [design] 다이나믹셀 v1.0: motor_support·m12_lens_holder 피처 재모델링 (사양 방식)
    - 피처 사양 specs/<부품>.py 를 VM(manifold3d)·Fusion 이 같이 읽는 방식 추가 (dsl_common.py, feat_dsl.py, tools/feat/csg_vm.py)
    - motor_support: 구배 2° 테이퍼 돌출 + 모깎기, 원작 대비 최대 0.01 mm
    - m12_lens_holder: 원작 대비 최대 0.02 mm
    - STEP/STL 갱신, PROGRESS·design-log 기록
    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
    [m12_lens_holder.step, m12_lens_holder.stl, motor_support.step, motor_support.stl]
2026-11-02 [design] 다이나믹셀 v1.0: power_support·yaw2roll 피처 재모델링
    - power_support: 판·갈비·벽·레일·고리·클립·걸쇠 탭을 구배 1° 테이퍼 피처로 (원작 대비 p95 0.002 mm)
    - yaw2roll: 윗판·앞벽·보강·보스·귀·구멍 피처 (p95 0.005 mm)
    - 사양 도구: 영역 테이퍼 돌출, 거울, 모깎기, secfit.py
    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
    [power_support.step, power_support.stl, yaw2roll.step, yaw2roll.stl]
2026-11-02 [design] 다이나믹셀 v1.0: hip_l·upper_leg_left/right·leg 피처 재모델링
    - hip_l: T 단면 팔 + 모깎기 (p95 0.008 mm)
    - upper_leg_left/right: 구배 3° 셸, 벽 끝 원호·직선 자르기, 십자 갈비·보스 (p95 0.010 mm), 오른쪽은 거울
    - leg: 틀·등뼈(회전 캡)·축/혼 보스·지느러미 (p95 0.027 mm)
    - 사양 도구: 거울 부품(mirrored_ops), 몸체 지우기, 축 아래쪽 회전 단면
    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
    [hip_l.step, hip_l.stl, leg.step, leg.stl, upper_leg_left.step, upper_leg_left.stl, upper_leg_right.step, upper_leg_right.stl]
2026-11-02 [design] 다이나믹셀 v1.0: ankle_left/right 피처 재모델링, 어셈블리 v12
    - ankle_left: 판·받침(기울어진 바깥면)·반원통·구멍 피처 (원작 대비 최대 0.05 mm), 오른쪽은 거울
    - 어셈블리 참조 갱신 (motor_support ~ ankle 10개 부품)
    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
    [ankle_left.step, ankle_left.stl, ankle_right.step, ankle_right.stl]
2026-11-02 [design] 다이나믹셀 v1.0: sole_left/right 피처 재모델링 (고무)
    - sole_left: 기울어진 바닥 평면·옆벽, 모깎기, 안쪽 홈 피처 (부피 -0.02 %, p95 0.53 mm), 오른쪽은 거울
    - 사양 도구: dsl_build soft 옵션 (고무 재질)
    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
    [sole_left.step, sole_left.stl, sole_right.step, sole_right.stl]
2026-11-02 [design] 다이나믹셀 v1.0: foot_left/right 피처 재모델링, 어셈블리 v13
    - foot_left: 테두리·아래 몸통·반원통 자리·갈비뼈 슬롯(0.5° 구배)·클립·나사 구멍 피처 (부피 -0.35 %, p95 0.13~0.18 mm), 오른쪽은 거울
    - 바닥 가장자리 곡면은 R5 모깎기로 근사 (sole 안쪽과 같은 모양)
    - feat_dsl: 'new' 돌출의 떨어진 조각을 한 몸체로 합침
    - 어셈블리 참조 갱신 (sole, foot)
    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
    [foot_left.step, foot_left.stl, foot_right.step, foot_right.stl]
2026-11-02 [design] 다이나믹셀 v1.0: soft_mouth_top, jaw_soft 피처 재모델링 (고무)
    - soft_mouth_top: 기울어진 판 + 립, 구배·모깎기 (p95 0.011 mm)
    - jaw_soft: 아래 몸통(볼록 바닥 스플라인, 0.5° 회전) + 위 몸통 + 스플라인 뒤 홈 (p95 0.05 mm)
    - 사양 도구: op 'rot', Pth 'S' 스플라인, local_frame.py
    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
    [jaw_soft.step, jaw_soft.stl, soft_mouth_top.step, soft_mouth_top.stl]
2026-11-02 [design] 다이나믹셀 v1.0: face_part 피처 재모델링, 어셈블리 v14
    - face_part: 스플라인 윤곽 판 + 기둥 8 + 브래킷 + 구멍 (p95 0.004 mm)
    - 어셈블리 참조 갱신 (soft_mouth_top, jaw_soft, face_part)
    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
    [face_part.step, face_part.stl]
2026-11-02 [design] 다이나믹셀 v1.0: jaw 피처 재모델링, 어셈블리 v15
    - jaw: jaw_soft 사양을 0.1/1.8 옮긴 두 몸체의 차(쟁반) ∩ 옆모습 윤곽 - 뒤 홈 스플라인 + 경첩 받침·구멍 (p95 0.065 mm)
    - 어셈블리 참조 갱신 (jaw)
    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
    [jaw.step, jaw.stl]
2026-11-02 [design] 다이나믹셀 v1.0: 전 부품 원작 대비 검증, face_part 카운터보어, 참고 메시 삭제
    - verify_all.py: 부피·표면 거리·구멍(단면 원 중심/반지름) 검증 → verify/feature_verify.md
    - face_part: 기둥 구멍 입구 카운터보어로 수정 (v3, 최대 0.07 mm)
    - 어셈블리 v17: 참고 메시 69개 삭제 (bottom_head_shell 1개 남김), 26개 참조 최신
    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
    [face_part.step, face_part.stl]
2026-11-02 [design] 다이나믹셀 v1.0: bottom_head_shell 재모델링 분석 기록
    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
2026-11-02 [design] 다이나믹셀 v1.0: bottom_head_shell 재모델링 시도 (미완), 사양 도구 보강
    - feat_dsl: op 'zloft' (z 단면 로프트), 스케치 지연 계산, 이웃 곡선만 끝점 잇기(속도), 잔여 영역 빠른 프로파일 선택, optional 돌출 실패 건너뜀
    - dsl_common: 세 점이 한 줄인 호는 선분으로
    - bhs_outline.py, resid_to_ops.py, specs/bottom_head_shell.py (아직 설치 안 함 — 몸체 갈라짐, 64분 빌드)
    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
2026-11-02 [design] 다이나믹셀 v1.0: bottom_head_shell 2차 시도 기록 (미설치), joinall op
    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
2026-11-02 [design] 다이나믹셀 v1.0: bottom_head_shell 3차 시도 되돌림 (원래 솔리드 유지), 어셈블리 v18
    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
2026-11-02 [design] 다이나믹셀 v1.0: bottom_head_shell 오차 분포 분석·직접 사양 순서 기록
    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
2026-11-02 [design] 다이나믹셀 v1.0: bottom_head_shell 피처 재모델링 (직접 사양), 어셈블리 v19
    - 사양 specs/bottom_head_shell.py 새로 씀: 바깥 컵·안쪽 면 z 단면 로프트, 옆 턱 y 단면 로프트, 앞 평판, 테두리 턱, 경첩·클립, 안쪽 벽·보스·구멍
    - 단면 자료 build/feat/bottom_head_shell_sec.json + 만드는 도구 tools/feat/bhs/ (make_sec.py, 안쪽 면은 법선 방향으로 찾음)
    - feat_dsl: op 'loft'(축 지정), zloft chunk, comb keep
    - 결과: 731면, 부피 -0.00 %, p95 0.028 / 최대 0.37 mm, 구멍 단면 54/54 (예전 솔리드 p95 0.156). 부품 v4
    - 어셈블리 v19: 참조 갱신, 마지막 참고 메시 ref_bottom_head_shell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
    [bottom_head_shell.step, bottom_head_shell.stl]
2026-11-03 [design] 다이나믹셀 v1.0: right_shell 화면 표시 안 되던 문제 수정 (v3), 어셈블리 v20
    - 몸체가 Fusion 화면 메시를 못 만들어 가슴 오른쪽 커버가 안 보였음 → 같은 형상의 깨끗한 복사본으로 교체
    - 검증: 부피 11312.6 그대로, 원작 대비 p95 0.40 mm, 구멍 44/44, 어셈블리 표시 안 되는 몸체 0
    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
    [right_shell.step]
2026-11-03 [design] 다이나믹셀 v1.0 BOM: 출력 부품 재질을 어셈블리와 같게 (ABS 흰색, 고무), 질량 다시 계산
    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
    [BOM_dynamixel_v1.0.csv, BOM_dynamixel_v1.0.xlsx]
2026-11-03 [design] 다이나믹셀 v1.0: 부품 문서 스케치 숨김 (머리 아래 파란 빗살), 어셈블리 v21
    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
2026-11-03 [design] 다이나믹셀 v1.0 MJCF 메시를 피처 재모델링 부품으로 갱신 (build_mjcf)
    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
    [ankle_left.stl, ankle_right.stl, bottom_head_shell.stl, face_part.stl, foot_left.stl, foot_right.stl, hip_l.stl, jaw.stl]
2026-11-03 [design] 관절·충돌·케이블 검증, 제품 사진 색 적용, 고해상도 STL
    - verify/sim_cable_report.md: 관절 14/14, 정확 메시 무충돌 범위 원본과 동일, 동역학·케이블 경로 비교
    - tools/verify_sim/: 검증 스크립트 (manifold 교집합, 복셀 최단 경로, MuJoCo)
    - 색: 크림/주황/노랑/회색/진회색/검정 (Fusion 외관, MJCF rgba, BOM 재질)
    - parts/*.stl: 곡면 편차 0.02 mm, 법선 4도로 재출력
    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
    [BOM_dynamixel_v1.0.csv, BOM_dynamixel_v1.0.xlsx, ankle_left.stl, ankle_right.stl, banana_pcb_locker.stl, bearing_10x15x3.stl, bearing_16x22x4.stl, bearing_roll.stl]
2026-11-03 [design] 다이나믹셀 v1.0 겉면 재모델링: left_shell (1417면 → 118면)
    - 사양 specs/left_shell.py: 바깥 단면 7개 로프트 1번 → 셸 2.2 → 원작 기울어진 평면으로 자르기 → 팔 판·혼 원판·고리 관·보스·클립·혀 → 구멍
    - 단면 자료 build/feat/left_shell_env4.json + 도구 tools/feat/ls/ (secgen, inner1, vm3)
    - feat_dsl: op loft3 (기울어진 평행 평면 위 닫힌 스플라인 단면 로프트), 닫힌 스플라인 지원
    - 결과: 부피 +0.08 %, p95 0.093 / 최대 0.93 mm, 구멍 단면 44/44. 부품 문서 v6
    - run_install: 저장 전 스케치·작업 평면 숨김
    Claude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
    [left_shell.step, left_shell.stl]
2026-11-03 [design] 다이나믹셀 v1.0 겉면 재모델링: right_shell (1504면 → 122면, 기본 피처 없앰)
    - specs/right_shell.py: left_shell 사양을 x 거울 + 관 구배 1.5°, 고리 구멍 r0.8 → 원뿔 r1.5, 끝 바깥 껍질 1.0, 관은 x −0.3 에서 끝
    - 결과: 부피 +0.31 %, p95 0.093 / 최대 0.91 mm, 구멍 단면 44/44. 부품 문서 v5 (피처만)
    Claude-Session: https://claude.ai/code/session_01QbojE4ixKVjcT6cmAz6h7n
    [right_shell.step, right_shell.stl]
2026-11-03 [design] bottom_head_shell 겉면 재모델링: 컵 3° 프리즘 + R5 모깎기 (731 → 622면)
    - 컵 바깥/안쪽: z 단면 로프트(3개씩 나눔) 대신 위 단면 3° 구배 프리즘 ∩ 앞벽 곡선 ∩ 바닥 곡면 → R5 / R3.3
    - 프리즘 앞면 1 mm 내밀어 앞벽 곡선으로 자름 (구배로 앞면 0.22 들어가던 것)
    - verify_all: 부피 -0.11 %, p50 0.001 / p95 0.026 / 최대 0.62 (원작 두께 0 조각), 구멍 54/54
    - 부품 v6
    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
    [bottom_head_shell.step, bottom_head_shell.stl]
2026-11-08 [design] yaw_roll_motion 재모델링: 층 돌출 → 피처 (272 → 67면)
    - 판·띠·팔(y 돌출)·통 R9/R8·혼 원판 + 모따기 + 구멍
    - 팔 아래 호 접점을 통 R9 에서 계산 (반올림 좌표면 y -13 조각면 → STL 가짜 면 4.2 mm)
    - verify_all: 부피 +0.03 %, p95 0.005 / 최대 0.01, 구멍 39/39
    - 부품 v3
    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
    [yaw_roll_motion.step, yaw_roll_motion.stl]
2026-11-08 [design] banana_pcb_locker 재모델링: 판 1° 구배 + 걸쇠 + 구멍 (98 → 28면)
    - verify_all: 부피 -0.00 %, p95 0.001 / 최대 0.01, 구멍 2/2
    - 부품 v2. power_support 는 이미 피처 모델이라 그대로 (문서에 기록)
    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
    [banana_pcb_locker.step, banana_pcb_locker.stl]
2026-11-09 [design] top_head_shell 나사 기둥이 바깥면 밖으로 나온 것 고침
    - 기둥 3개(앞 양 모서리, 뒤 가운데) 끝이 둥근 가장자리 바깥면 밖으로 최대 3.3 mm 나와 있었음
    - 기둥을 바깥 로프트 덩어리와 교집합한 뒤 붙임
    - verify_all: p95 0.108 / 최대 2.07 (예전 3.29), 구멍 33/33. 부품 v3
    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
    [top_head_shell.step, top_head_shell.stl]
2026-11-09 [design] bottom_head_shell 옆 턱 홈: 단면 로프트 줄무늬 → 피처 (622 → 481면)
    - 사용자 지적: 주황 커버(머리 아래 커버) 옆 홈 면이 줄무늬로 나뉘어 보임
    - y 단면 26개 로프트(3개씩) 대신: 계단 곡선(원작 바닥 높이 지도 -11.2 등고선) 바깥에서 컵 바닥 2.1 mm 올림,
    모서리 R2.9, 계단 위 R1 / 안쪽 R1.25, 계단 위 R2.8, 뒤 끝은 R18 로 감아 오름
    - verify_all: p95 0.032 / 최대 0.61 (원작 두께 0 조각), 구멍 54/54. 홈 뒤 끝 안쪽 0.6~1.0 mm 차이
    - 설치 15분 → 3분. 부품 v8. 도구 tools/feat/bhs/groove_*.py
    Claude-Session: https: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
    [bottom_head_shell.step, bottom_head_shell.stl]
2026-11-09 [design] 구동 테스트: top_head_shell 서보·립 자리, MJCF neck 판 위치 고침
    - 구동 테스트 (관절 14/14, 무충돌 범위·보행 자세 187개, 토크, 서기/앉기 시뮬) 모두 원본과 같음
    - 조립 맞물림 검사 추가 (tools/verify_sim/asmfit.py, 같은 바디 안 부품 쌍 + 실물 구매 부품 기준)
    - top_head_shell: 부리 서보 모서리 자리, 아래 셸 립 자리, 뒤 안쪽 면, z 0 아래 처짐 잘라냄 (부품 v11)
    - MJCF assets/neck.stl 25 mm 밀림 고침, build_mjcf.py 판 기준 인스턴스 고르기 고침
    - 보고서 verify/drive_test_2026-11-09.md
    Claude-Session: https://claude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
    [neck.stl, top_head_shell.step, top_head_shell.stl]
2026-11-09 [docs] 조립 가이드 전장 쪽: 배선도(로봇·U2D2 벤치), 부품 배치도, 케이블 길이·간섭, BOM 점검
    - 전장 쪽 3쪽 → 5쪽 (33 → 35쪽): 로봇 배선도, U2D2 벤치 배선도, 부품 배치도(라벨 그림),
    배선 경로·케이블 길이(1 mm 격자 최단 경로, 자세별 최대), 케이블 간섭·꽂는 순서
    - 조립 단계 11곳에 케이블 메모 (꽂는 때·고리 여유)
    - 30 → 허브는 목 숙임 끝에서 156 mm → 250 mm 케이블 1가닥, 나머지 16가닥은 동봉 180 mm
    - 플러그 칸 막힘 15개 모두 원본과 같음 (재설계로 생긴 막힘 없음)
    - BOM: PHB·X3P 링크를 상품 페이지로, 250 mm 케이블·전원 배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
    [BOM.csv, BOM.xlsx]
